ChristopherLuey/315-MechanicalDesign/315 Project/315 Final Report.docx

# ME 315

THEORY OF MACHINES - DESIGN OF ELEMENTS

Fall 2023

Design Project

Group Submission

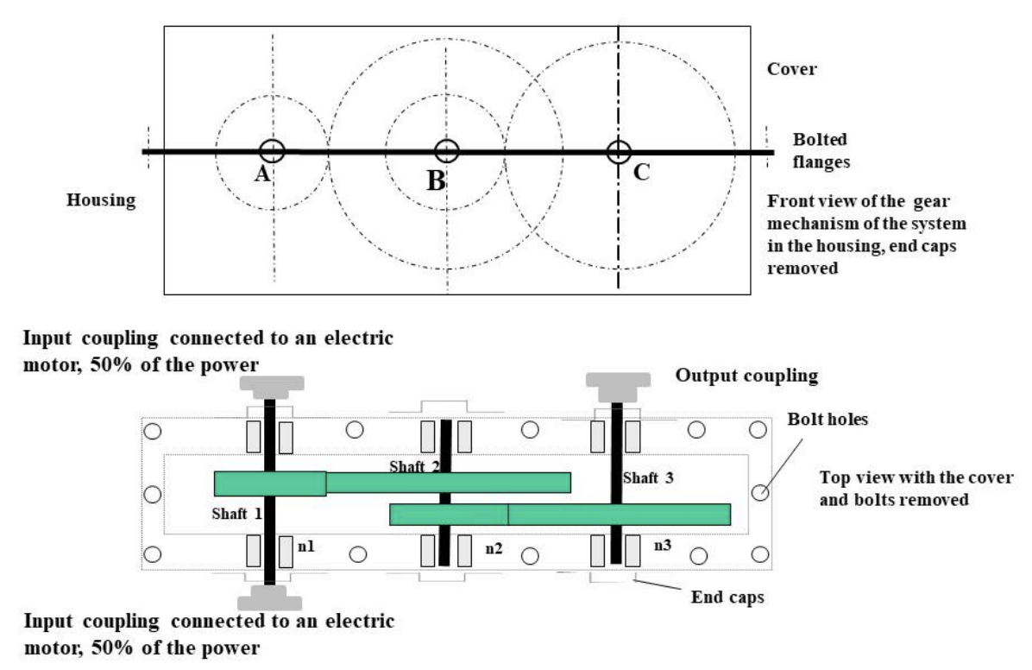
[picture p1: figure]

Group members

Chirag Bachani Shaft system 1

Winston Zhao Shaft system 2

Christopher Luey Shaft system 3

Grade

On-time step dues /5

Structural design, drawings /40

Design analysis /35

Report writing /20

Total __________

# Final Project

Christopher Luey, Winston Zhao, Chirag Bachani

Introduction 4

Gear Train 4

Gears 5

Shafts 6

Bearings 7

Assembly Drawings 8

Shaft 1 8

Shaft 2 9

Shaft 3 10

Shaft Drawings 11

Shaft 1 11

Shaft 2 12

Shaft 3 13

Gear Drawings 14

Gear 1 14

Gear 2 15

Gear 3 16

Gear 4 17

Shaft One Analysis 18

Gearing 18

Force Analysis 20

Maximum Shear, Bending 21

Shaft Stress Analysis 21

Minimum Shaft Diameter 21

Infinite Life at Critical Cross Section 22

Yielding 23

Gear Stress Analysis 23

Bending 23

Contact 24

Factors of Safety for Bending and Contact 25

Bearing Selection 26

Expected Lifetime of Bearing 26

Keyways and Tolerances 27

Shaft Two Analysis 30

Gearing 30

Free Body Diagram 32

Force Analysis 34

Shear and Bending 34

Shaft Fatigue Analysis 34

Gear Stress Analysis 37

Material 37

Allowable Contact Stress 37

Allowable Bending Stress 39

Design Bending Stress 39

Bearing Selection 41

Expected Lifetime of Bearing 41

Keyways and Tolerances 43

Shaft Three Analysis 44

Gearing 44

Geometry 45

Force Analysis 46

Maximum Shear, Bending 47

Shaft Stress Analysis 48

Minimum Shaft Diameter 48

Infinite Life at Critical Cross Section 48

Yielding 49

Gear Stress Analysis 50

Bending 50

Contact 51

Factors of Safety for Bending and Contact 52

Bearing Selection 53

Expected Lifetime of Bearing 53

Keyways and Tolerances 54

# Introduction

In our team's engineering project, we designed a robust two-stage gear transmission system depicted in the accompanying figure, aiming to efficiently transmit power from input shaft A to output shaft C with a speed reduction. The system, comprising input shaft A driven by two electric motors, center shaft B with corresponding gears, and output shaft C with a coupling set, was carefully arranged, considering the spatial relationship between A and C. Operating at 2600 rpm, the input motors delivered 70KW to shaft A, with the goal of achieving an output speed (n3) of around 400 ±3 rpm, assuming 100% overall efficiency. Our design incorporated fatigue stress concentration factors to address bending and torsional stresses, and determined geometry using a factor of safety of n=1.1. With a commitment to durability, the transmission system is expected to function continuously for at least 5 years, 7 days a week, 52 weeks a year, and 8 hours a day, with a reliability rate of 99%.

# Gear Train

Part | Gear 1 | Gear 2 | Gear 3 | Gear 4
N [teeth] | 19 | 47 | 27 | 71
RPM [rev/min] | 2600.000 | 1051.064 | 1051.064 | 399.700
Power [kW] | 70.0 | 70.0 | 70.0 | 70.0

Gear Train Result
Ratio | 6.5049
Output Speed (RPM) | 399.7003
% Error | -0.0749%

# Gears

Gear Properties
Material | AISI 1045 Steel
Module [mm] | 5.00
Pitch Angle [Deg] | 20.00
Addendum [mm] | 5.00
Dedendum [mm] | 6.25
Clearance [mm] | 1.25
Tooth Depth [mm] | 11.25

| Gear 1 | Gear 2 | Gear 3 | Gear 4
Material Grade | 2 | 1 | 2 | 1
Hardness [HB] | 500 | 400 | 500 | 400
Pitch Diameter [mm] | 95.0 | 235.0 | 135.0 | 355.0
Outer Circle [mm] | 105.0 | 245.0 | 145.0 | 365.0
Root Circle [mm] | 83.0 | 223.0 | 123.0 | 343.0
Face Width [mm] | 65.0 | 60.0 | 65.0 | 60.0
Centerline Distance [mm] | 165.0 | | 245.0
Bending Factor of Safety | 4.1069 | 3.0405 | 2.7465 | 2.0373
Contact Stress Factor of Safety | 1.4576 | 1.1201 | 1.4859 | 1.1462

# Shafts

| Shaft 1 | Shaft 2 | Shaft 3
Material | AISI 1045 Carbon Steel
RPM [rev/min] | 2600.0000 | 1051.0638 | 399.7003
Max Bending Magnitude [Nm] | 205.7115 | 451.2470 | 343.7668
Max Torque [Nm] | 257.096 | 635.975 | 1672.380
Minimum Shaft Diameter [mm] | 17.000 | No pure torque | 40.000
Critical Cross Section Location | Gear 1 Center | Gear 3 Center | Gear 4 Center
Shaft Diameter at Critical Cross Section [mm] | 45.000 | 60.000 | 55.000
Goodman Factor of Safety | 1.8467 | 1.8236 | 1.6866
Yielding Factor of Safety | 7.3976 | 7.3851 | 6.3999
Lifetime | Infinite (> 10^6 Cycles)

# Bearings

| Shaft 1 | | Shaft 2 | | Shaft 3
As shown in Assembly Drawing | Left | Right | Left | Right | Left | Right
Radial Load [N] | 1645.692 | 4114.230 | 8204.490 | 6835.208 | 6875.336 | 3151.196
Thrust Load [N] | 0 | | 0 | | 0
Equivalent Load Used in Calculation [N] | 4114.230 | | 8204.490 | | 6875.336
C [N] | 54081.734 | | 79744.149 | | 48414.597
Bearing (SKF) | 6309 | | 6312 | | 6311
Bore [mm] | 45 | | 65 | | 55
OD [mm] | 100 | | 140 | | 120
Width [mm] | 25 | | 33 | | 29
C, bearing [N] | 55300 | | 97500 | | 74100
C0, bearing [N] | 31500 | | 60000 | | 45000
Expected Life [Mil Cycles] | 2428.3404 | | 1678.2594 | | 1251.9091
Expected Life [Yrs] | 5.3455 | | 9.1288 | | 17.9265

# Assembly Drawings

## Shaft 1

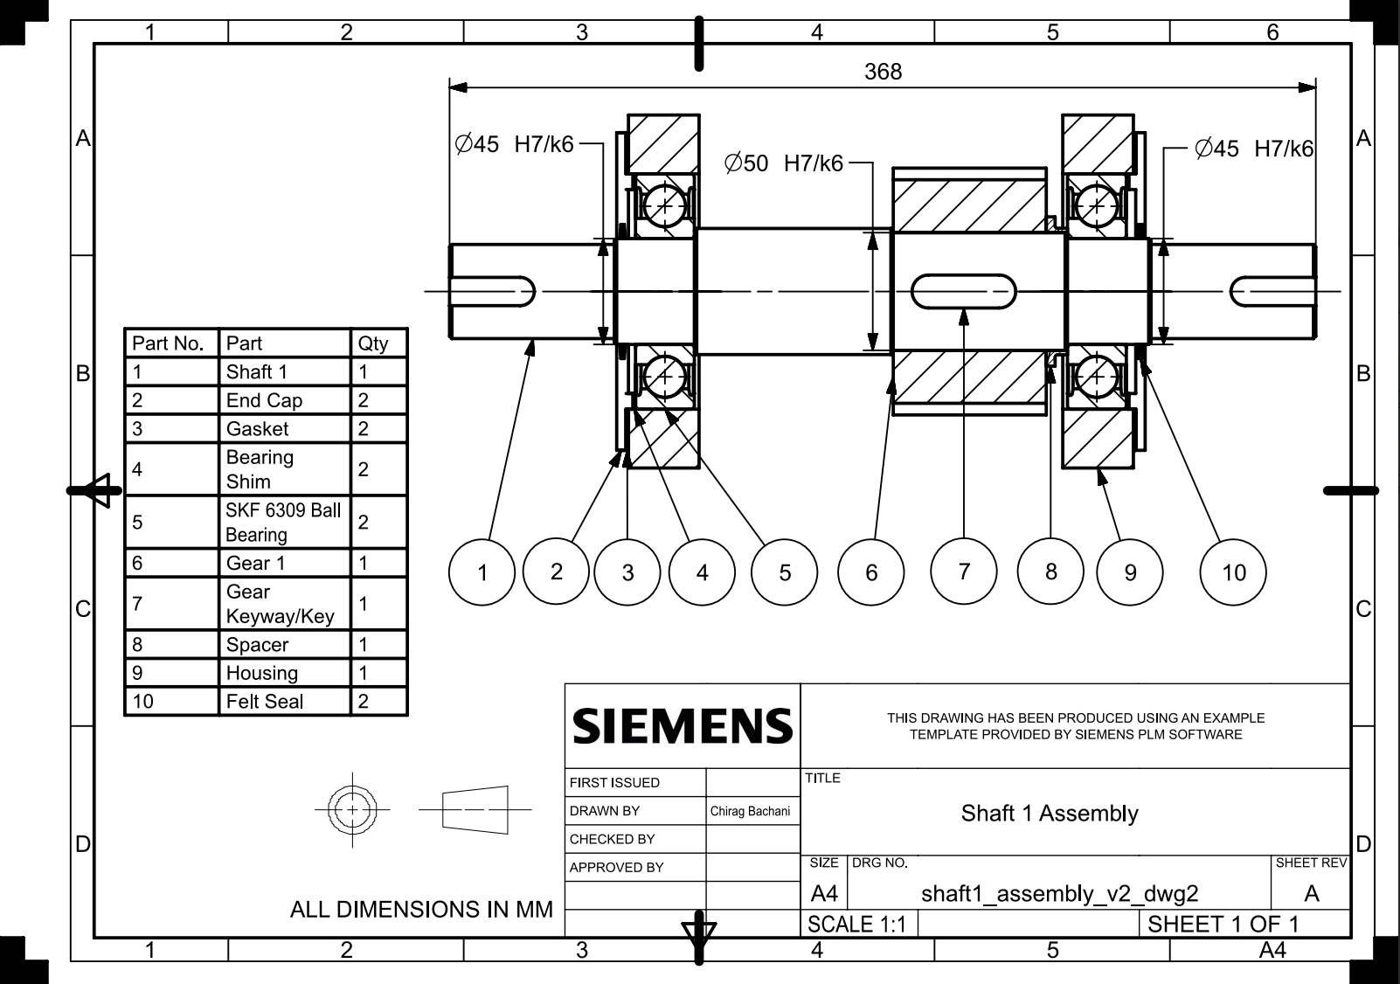
[picture p2: figure]

## Shaft 2

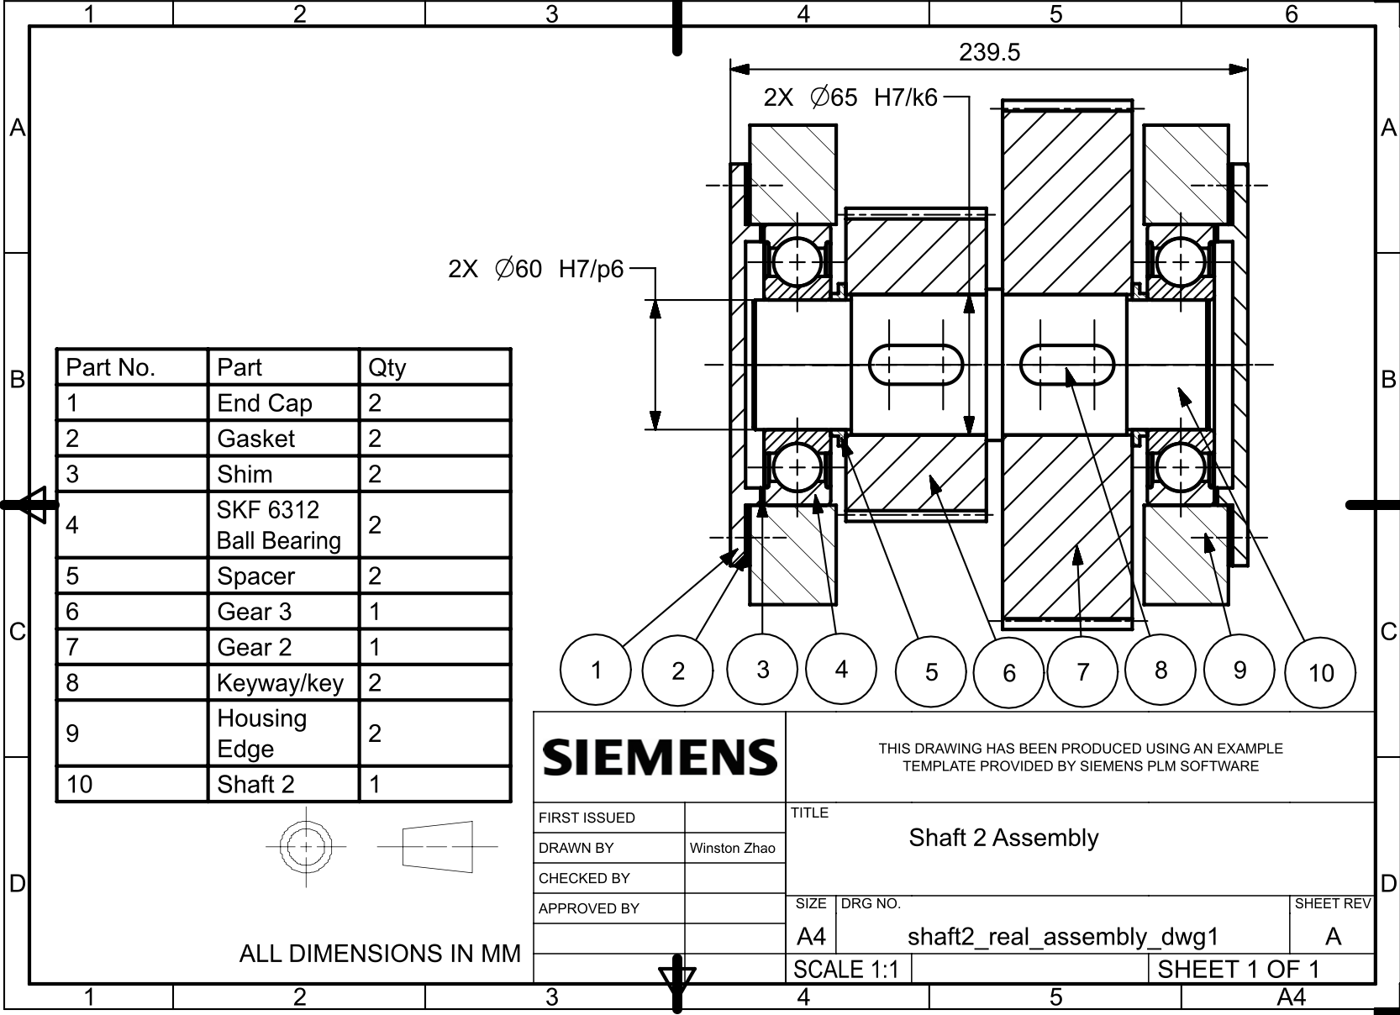
[picture p3: figure]

## Shaft 3

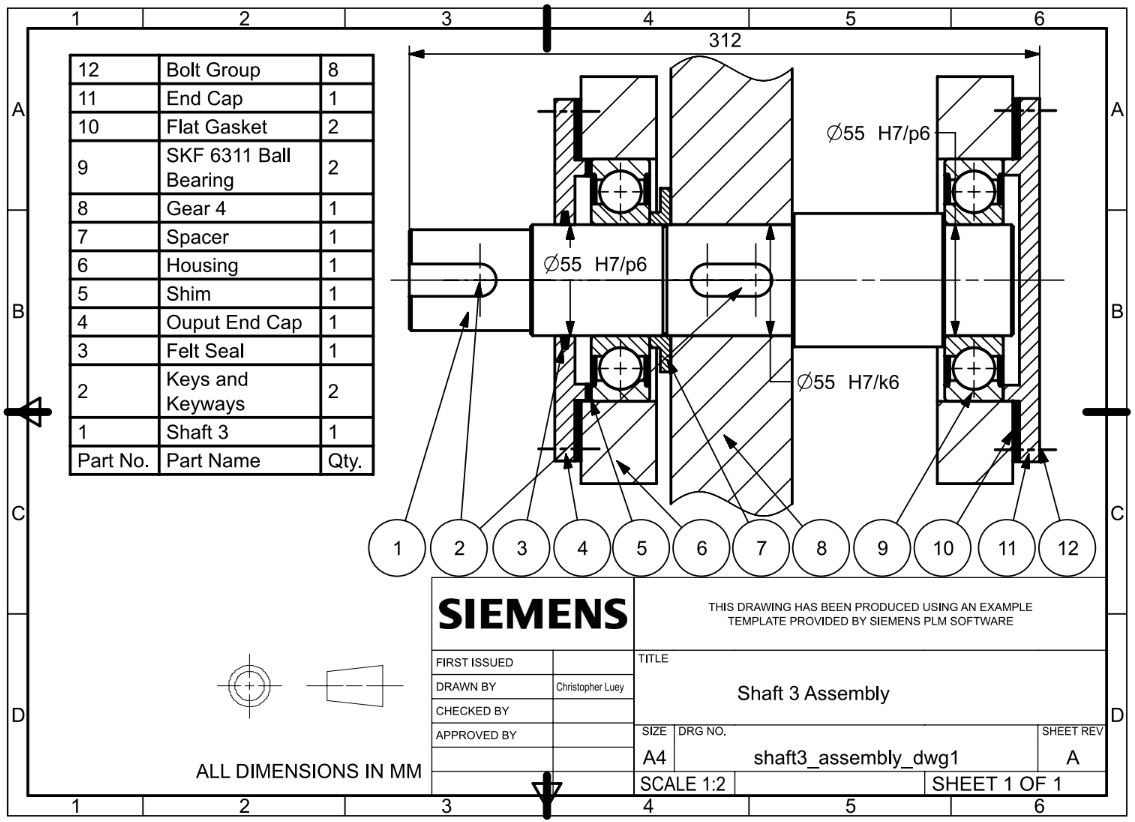
[picture p4: figure]

# Shaft Drawings

## Shaft 1

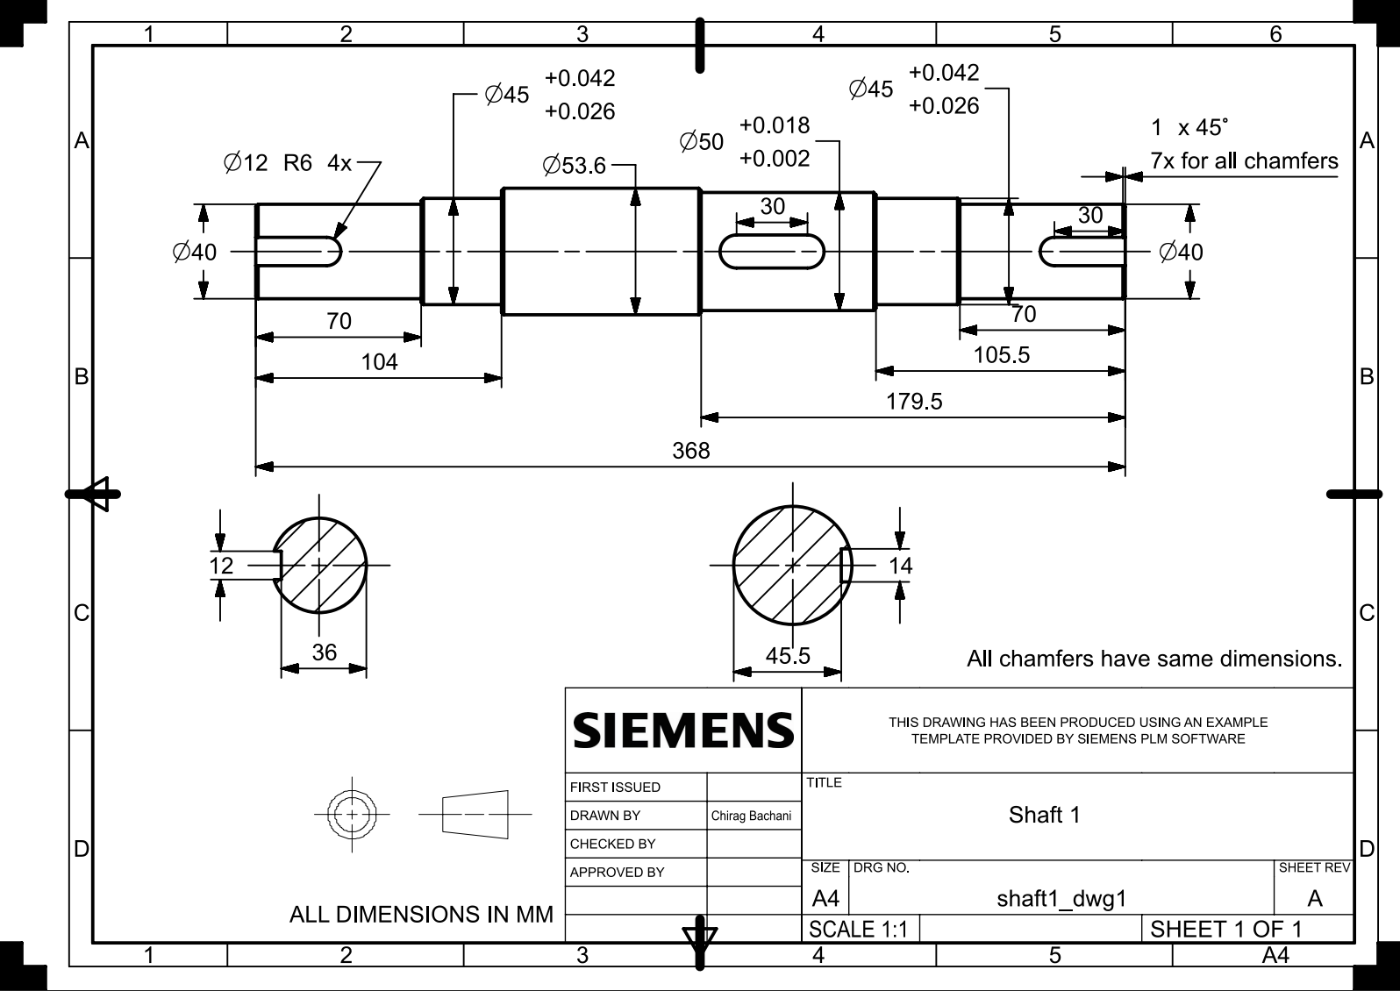
[picture p5: figure]

## Shaft 2

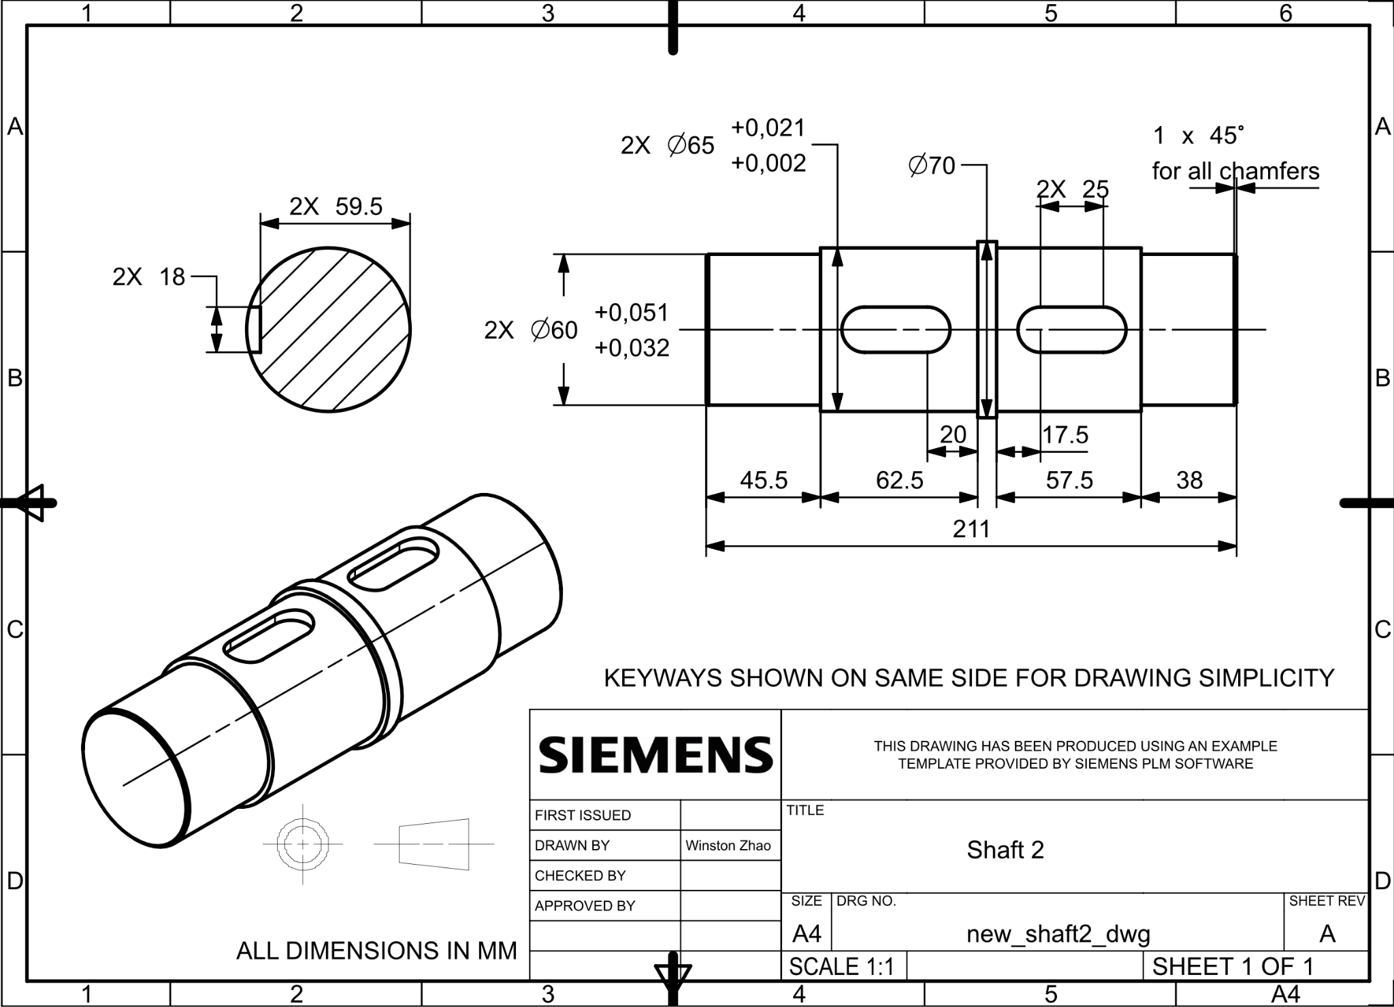
[picture p6: figure]

## Shaft 3

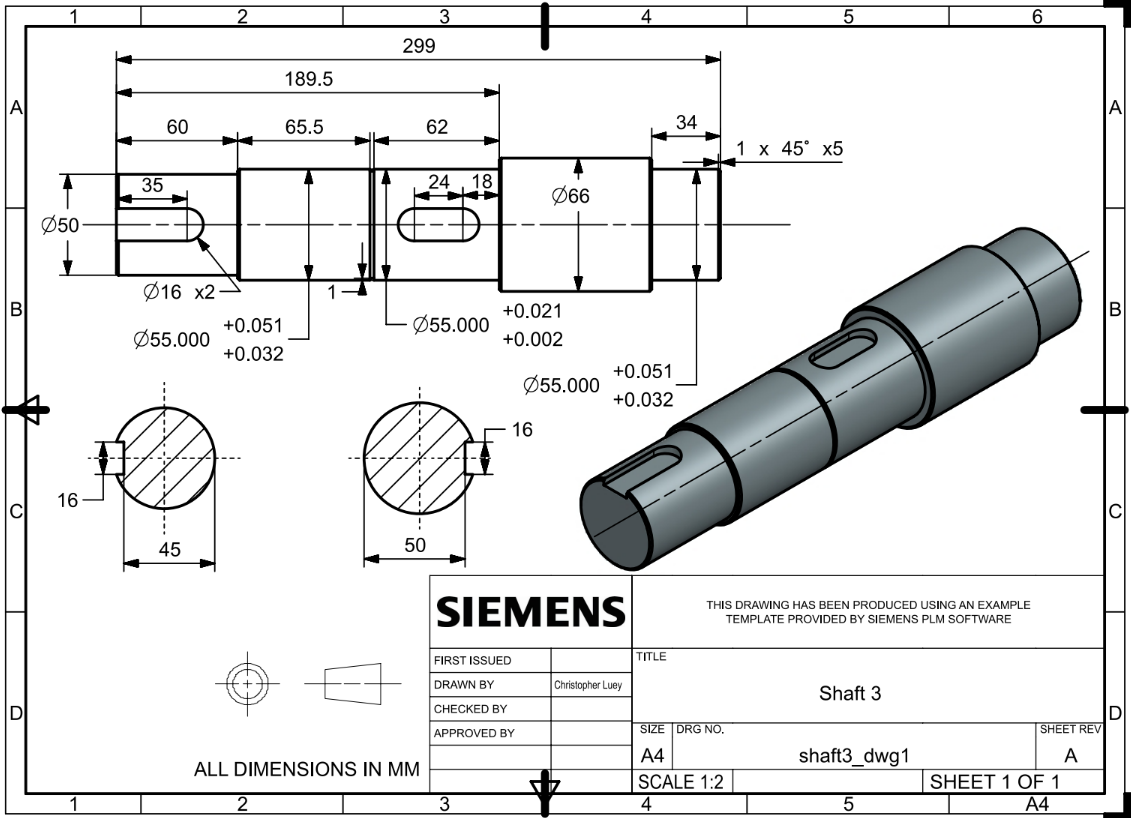
[picture p7: figure]

# Gear Drawings

## Gear 1

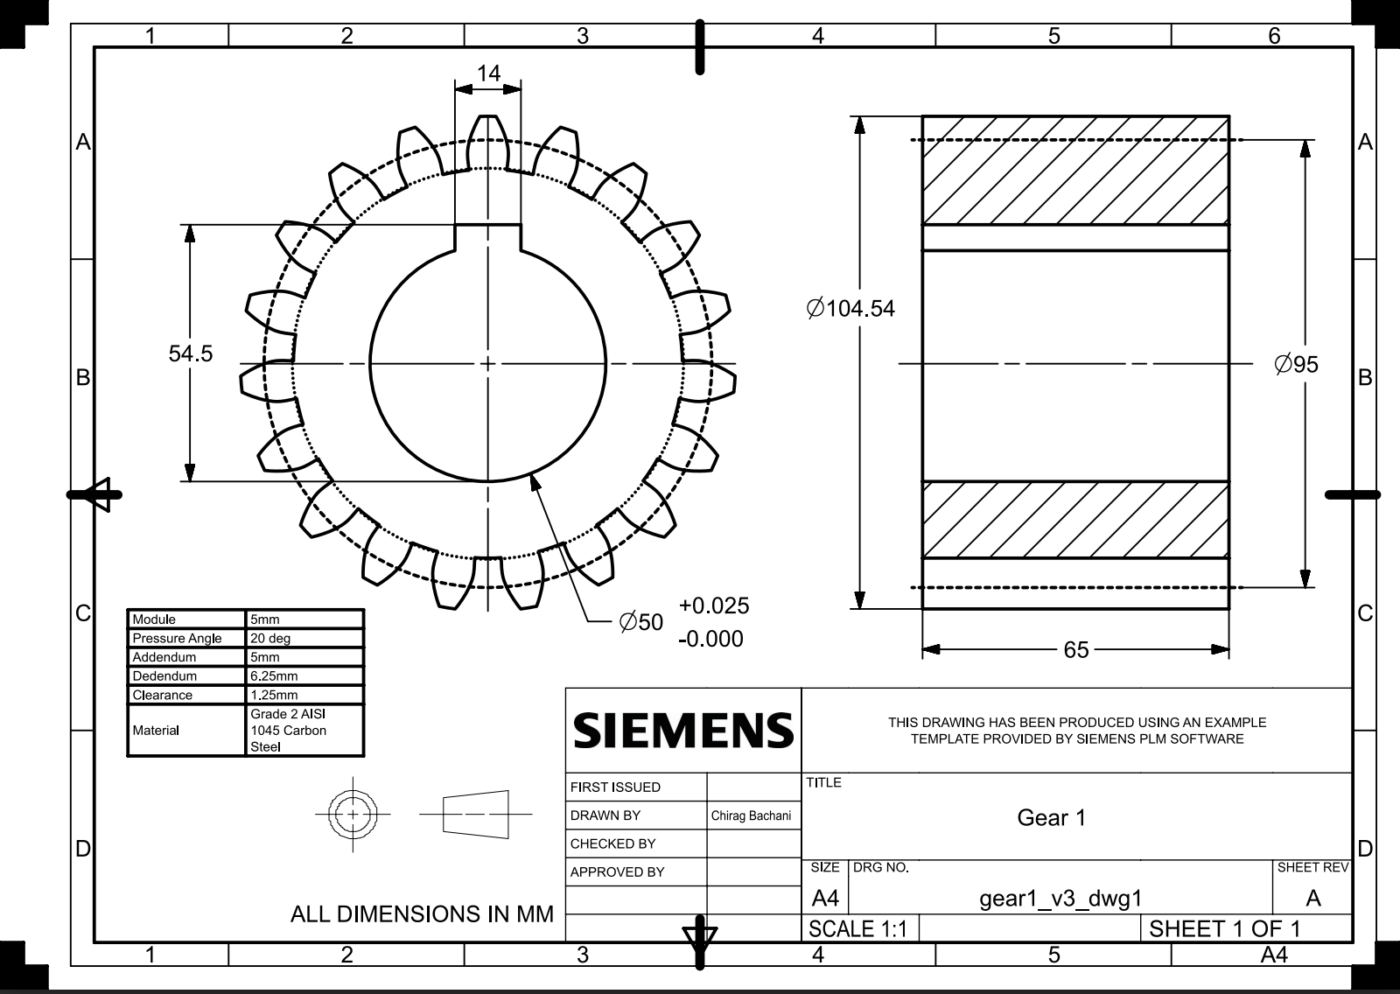
[picture p8: figure]

## Gear 2

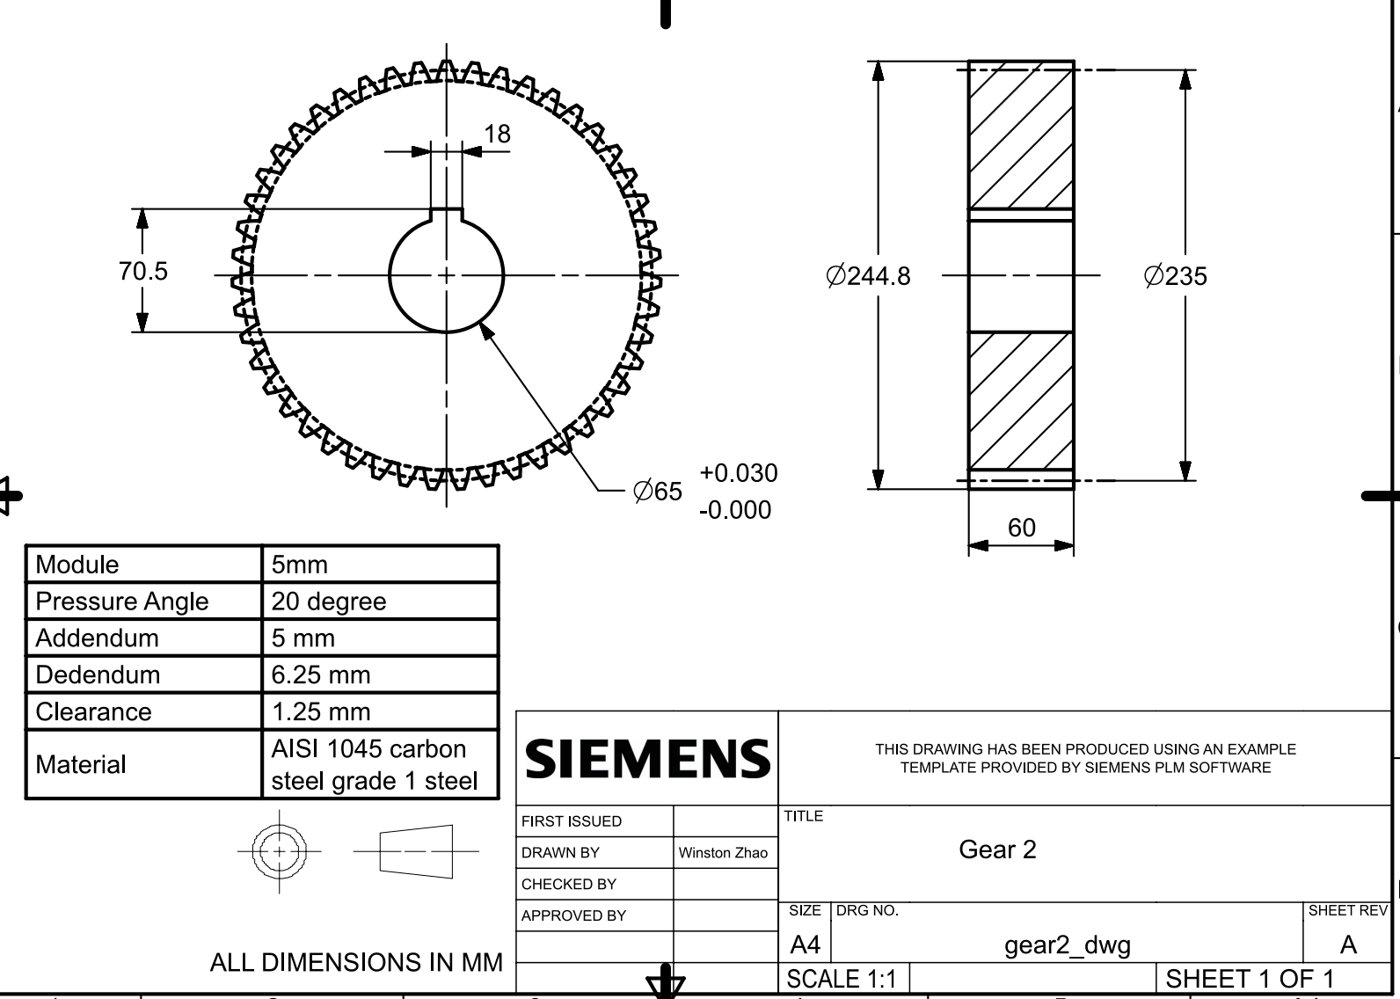
[picture p9: figure]

## Gear 3

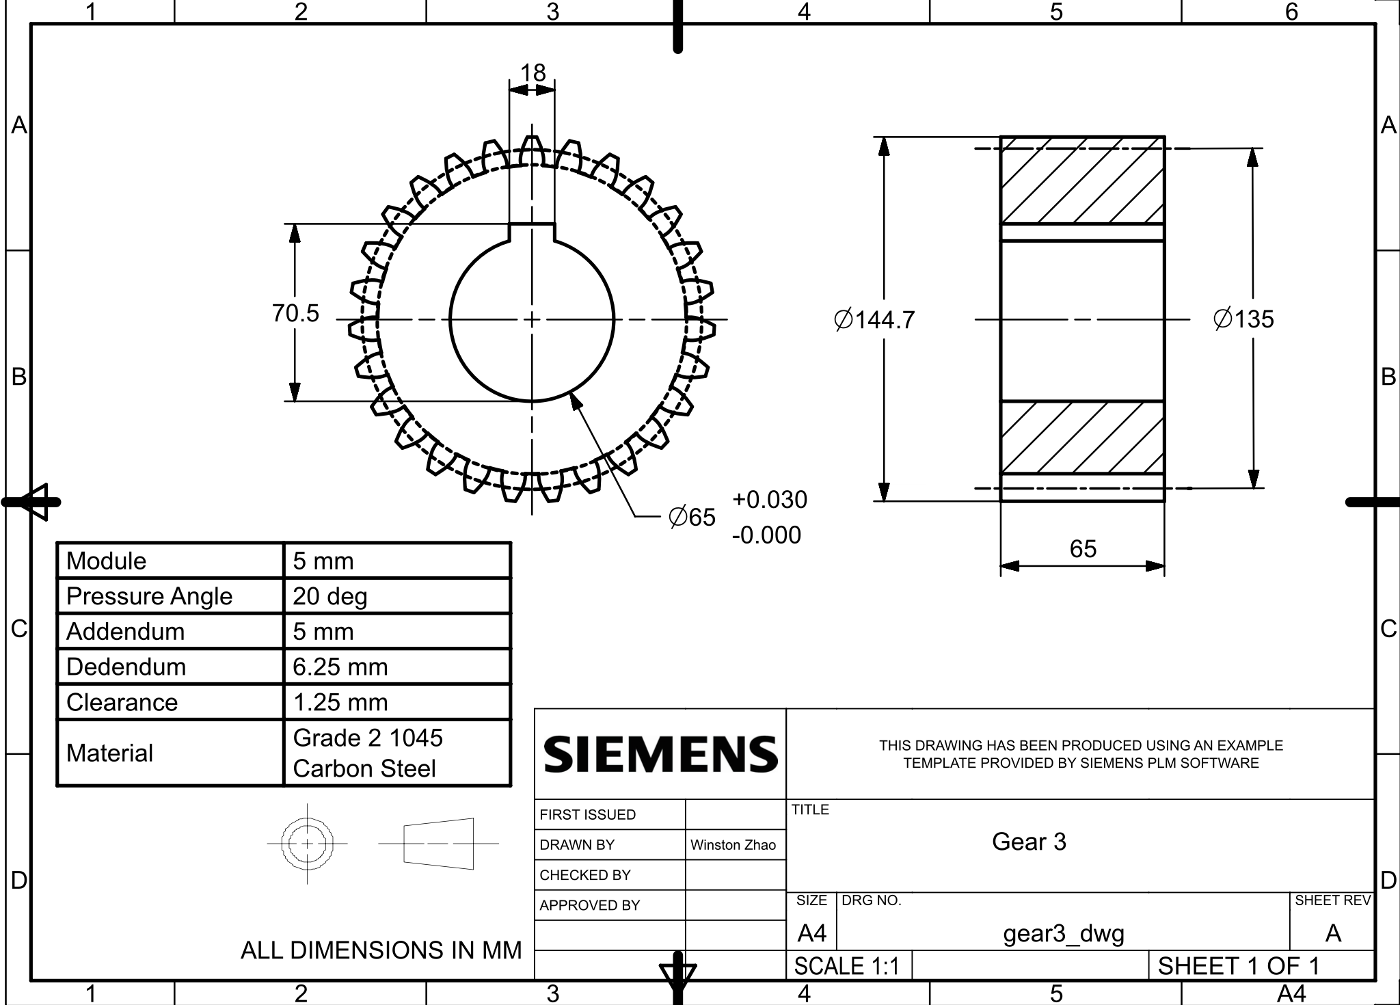
[picture p10: figure]

## Gear 4

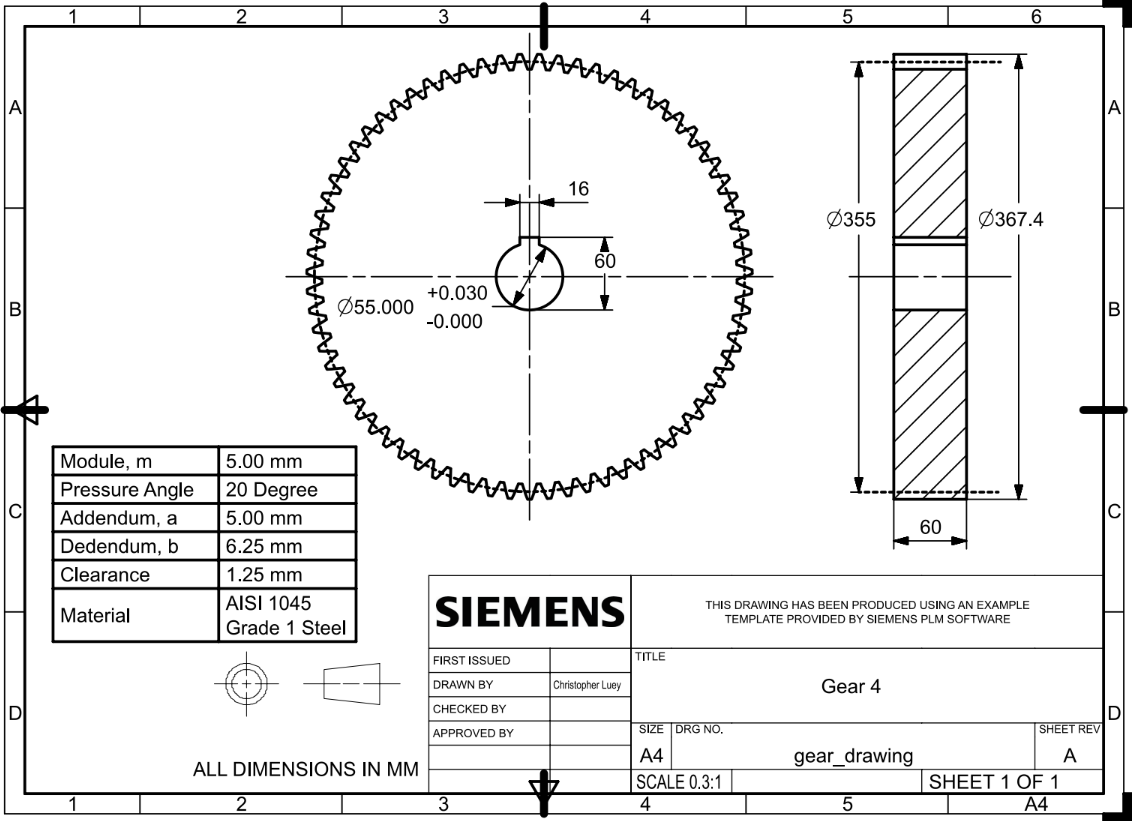
[picture p11: figure]

# Shaft One Analysis

## Gearing

Given: n1 = 2600 rpm, H = 70000 W, n3 (ideal) = 400, n1/n3 (ideal) = 6.5

Choose gear teeth (odd number, indivisible):

N1 = 19

N2 = 47

N3 = 27

N4 = 71

Choose standard module and pitch angle for off the shelf ordering:

m = a = 0.005 [m]

b = 1.25m = 0.00625 [m]

ϕ = 20 degree

Calculate transmission ratio:

n1/n3 = N4*N2/(N1*N3) = 6.5049

n3 = 2600/(n1/n3) = 399.7003 rpm

% error = |(n3-400)/400| = -0.0749%

Gear 1:

Geometry

N1 = 19

Pitch Diameter: d_p =N_1 m=0.0950 [m]

Pitch Radius: r_p =d_p /2=0.0480 [m]

Face Width: b_w =12m=0.0650 [m]

Forces

Note: Forces acting from Gear 1 to Gear 2 are the same as from Gear 2 to Gear 1

Torque: T=(60H)/(2πn_1)=257.096 Nm

Gear Forces:

W_(T12) =T/r_p =5412.557 N

W_12 =W_(T12) /cos(ϕ)=5759.923 N

W_(r12) =W_12 sin(ϕ)=1970.010 N

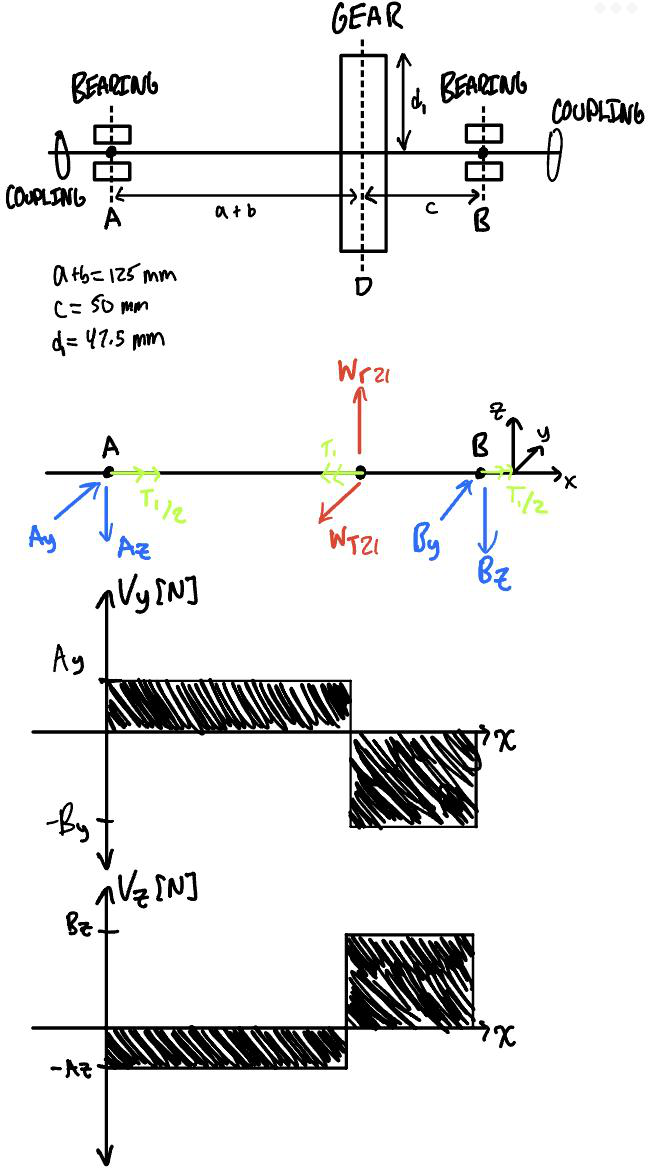
[picture p12: figure]
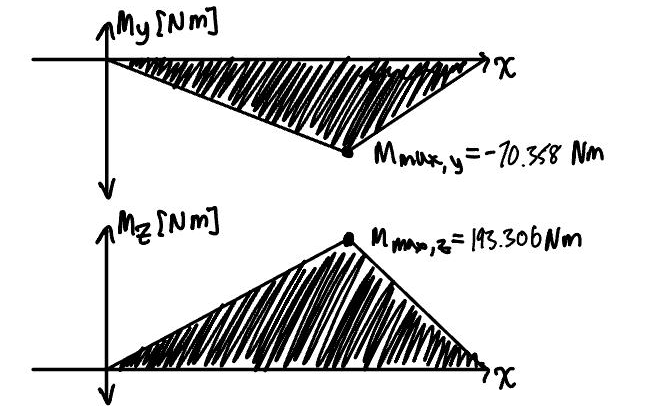
[picture p13: figure]

Note: Torque occurs in the same direction on both sides of the shaft, coming from the coupling.

## Force Analysis

From the gearing section the following are solved:

W_(T12) =5412.557 N

W_(r12) =1970.010 N

From geometry we know the following:

a=55 mm; b+c =120 mm

d/2=177.5 mm

Derived from static equilibrium, solve this system of equations:

0=A_y +B_y -W_(t12)

0=A_z +B_z -W_(r12)

0=W_(t12) (a)-B_y (a+b+c)

0=W_(r12) (a)-B_z (a+b+c)

System of equations yields the following reactions with force directions as drawn:

Ay = 1546.4448 N

Az = 562.8599 N

By = 3866.1120 N

Bz = 1407.1497 N

A=√(A_y ^2 +A_z ^2)=1645.6922 N

B=√(B_y ^2 +B_z ^2)=4114.2304 N

## Maximum Shear, Bending

Maximum bending occurs at cross section C:

M_y =A_y a=70.3575 Nm

M_z =A_z a=193.3056 Nm

M=√(M_y ^2 +M_z ^2)=205.7115 Nm

The shear magnitude at cross section C is:

Vy = Ay = 1546.4448 N

Vz = Az = 562.8599 N

V=√(V_y ^2 +V_z ^2)=1645.6922 N

## Shaft Stress Analysis

We first choose material:

Material | E (Pa) | UTS (MPa) | Poisson Ratio | Ys (MPa)
AISI 1045 Steel (https://www.azom.com/article.aspx?ArticleID=6114) | 200000.0000 | 394.7200 | 0.2900 | 294.7400

### Minimum Shaft Diameter

Our factor of safety is n=1.1

Calculate the torque magnitude at the coupling:

T=W_(t12) d/2=257.096 Nm

Calculate the minimum shaft diameter:

τ_(all) =0.557(Y_s )/n=156.9727 MPa

d_(min) =³√((16T/2)/(πτ_(all)))=16.0967 mm

Consider keyway effect, round 5% increase:

d_(min) '=Round[d_(min) (1.05)]=17 mm

### Infinite Life at Critical Cross Section

Choose a shaft diameter of d = 45 mm at cross section C.

Solve for max bending torsion, and shear stresses at cross-section C experienced by point on the surface:

σ_(bs) =(32M)/(πd^3)=22.9944 MPa

τ_T =(16T)/(πd^3)=14.3691 MPa

τ_V =(16V)/(3πd^2)=3.4492 MPa

Given these stresses, calculate the mean and amplitude stresses for cyclic loading:

σ_a =σ_(bs) =22.9944 MPa

σ_m =0 MPa

τ_m =(τ_T)/2=7.1845 MPa [The shaft turns on and off]

τ_a =(τ_T)/2+τ_V =10.6337 MPa

This is a conservative estimate, since we use the shear and bending stress maximum amplitudes in calculating stress states, although these maximums are out of phase. Furthermore, we do not ignore shear (which is 30% of the mean shear).

Calculate Von-Mises given Kf = 3.000 and Kfs = 2.800

σ_(vm-a) =√((K_f σ_a )^2 +3(K_(fs) τ_a )^2)=86.1289 MPa

σ_(vm-m) =√((σ_m )^2 +3(τ_a )^2)=12.4440 MPa

Calculate Infinite Criteria given chosen material:

k_f =1.58*S_(ut) ^(-0.085) =0.9220 [Grinding]

k_s =1.189*d^(-0.112) =0.7763 [Size Factor]

k_r =0.82 [99% Reliability]

k_t =k_m =1.000

S_e '=0.5(UTS)=282.500 MPa

n_s =[(σ_(vm-a))/(k_f k_s k_r k_t k_m S_e ')+(σ_(vm-m))/(S_(ut))]^(-1) =1.8467 >1.1 [Chosen shaft diameter at C is safe]

### Yielding

n_y =[(σ_(vm-a))/(S_y)+(σ_(vm-m))/(S_y)]^(-1) =7.3976> 1.1 [Chosen shaft diameter does not pass yield line]

## Gear Stress Analysis

Choose material for gear:

Gear Materia | hardness | E (MPa) | Poisson Ratio
AISI 1045 Carbon Steel | 400.0000 | 200000.0000 | 0.2850

### Bending

Calculate number of shaft cycles:

t=5 year*52 (week)/(year)*7 (day)/(week) * 8 (hr)/(day) * 60 (min)/(hr)=873600 min

Rotation speed n1= 2600 RPM.

N=t*n_1 =2271360000 Cycles

Calculate allowable bending stress:

Y_n =1.683(N)^(-0.0323) =0.8392

S_b =0.533(HB)+88.3=464.5000MPa

k_t =k_r =1.000

σ_(b, all) =(S_b Y_n)/(k_t k_r)=389.8179 MPa

Calculate actual bending stress:

Y_j =0.350 [From Class Plot]

k_a =1.000

k_s =1.000 [module = 5 mm]

k_m =1.100 [Gear]

k_i =1.000 [Non Idler]

k_b =1.000

Calculate Kv:

V=πnd/60=12.9329 [m/s]

Q_v =6 for commercial gears

B=((12-Q_v )^(2/3))/4=0.8255

A=50+56(1-B)=59.7730

K_v =((A+√(200V))/A)^B =1.6623

σ_(b, actual) =(W^t)/(mb_w Y_j)k_a k_s k_m k_v k_i k_b =94.9170 MPa

Comparing the allowable to the actual bending stress:

n_b =σ_(all) /σ_b =4.1069>1.1

The design is sufficient for bending stress since nb > n = 1.1

### Contact

Calculate allowable contact stress:

HB_(pinion) =500 (HB)

HB_(gear) =400 (HB)

Z_N =2.466N^(-0.056) = 0.7380

(HB_p)/(HB_g)=1.25

A' = (8.89*10^(-3) )((HB_p)/(HB_g))-8.29*10^(-3) since 1.2≤(HB_p)/(HB_g)=1.25≤1.7

(N_g)/(N_p)=2.6296

C_H =1.0+A'((N_g)/(N_p)-1.0)=1.0042

K_T =1

K_R =1

S_c =2.22*HB_g +200=1437 MPa

σ_(c, all) =(S_(c_) Z_N C_(Hg))/(K_T K_R)=1060.4686 MPa

Calculate actual contact stress:

K_a =1 [No shock]

K_s =1

K_E =√(2/((1-v_p^2)/(E_p)+(1-v_g^2)/(E_g)))=466563.1271 [√(Pa)]

K_(m, gear) =1.1

K_v =1.6623 [From bending calculation]

ϕ=20 deg; d_p =0.095 m; d_g =0.235 m

I=(πcos(ϕ)sin(ϕ))/(1+(d_p)/(d_g))=0.7190

σ_(c,actual) =K_E √((W^t)/(b_w d_p I)K_a K_s K_m K_v)=727.5603 MPa

### Factors of Safety for Bending and Contact

σ_(c,actual) =727.5603 MPa

σ_(c, all) =1060.4686 MPa

σ_(b, actual) =94.9170 MPa

σ_(b, all) =389.8179 MPa

n_c =(σ_(c, all))/(σ_(c,actual))=1.4576>1.1 [Safe for contact stress]

n_b =(σ_(b, all))/(σ_(b,actual))=4.1069>1.1 [Safe for bending stress]

## Bearing Selection

h=(5 year)(364 (day)/(year))(8(hr)/(day))=14560 hr [life hours]

n3 = 2600 RPM [rotation speed]

L_10 =60(h)(n_3 )(10^(-6) )=2271.3600 Million Revs

A_P =1.000 [No Shock]

m=3 [Ball Bearing]

P_r =Max(A,B)=4114.2304 N [A and B calculated in Force Analysis section]

X=1.000

P=P_r X=4114.2304 N [No Axial Force]

C=PL_10 ^(1/m) =54081.7335 N

Given the calculated C, I specify the following bearing from SKF:

Reference: https://www.skf.com/us/products/rolling-bearings/ball-bearings/deep-groove-ball-bearings/productid-6309

This bearing is safe because the bearing specification C is less than our calculated C. Recalculation is not necessary since there is no thrust force and radial factor X is constant, not a function of e or C0.

### Expected Lifetime of Bearing

L=(C/P)^m =2428.3404 mil rev [using C=55300 N from SKF]

Life=L(10^6 )(n_1 )^(-1) (60(min)/(hr))^(-1) (8(hr)/(day))^(-1) (7(day)/(week))^(-1) (52(week)/(yr))^(-1) =5.3455 yr

Bearing does not require maintenance for intended operation of 5 years.

## Keyways and Tolerances

Coupling Keyway (40 mm) and Gear Keyway (50 mm):

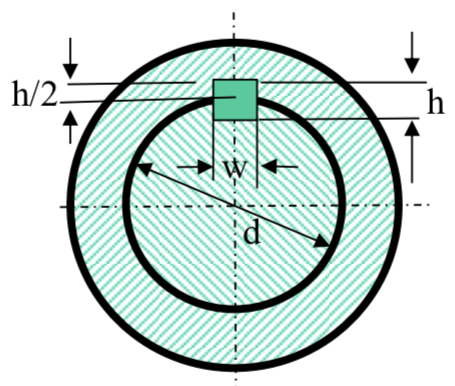
[picture p14: figure]

Shaft diameter d (mm) | Key width W x height H
38 < d <= 44 | 12 x 8
44 < d <= 50 | 14 x 9

Fits:

Bearing and Shaft: Interference fit (H7/p6), bearing should be tightly fit with shaft for fluid rotation.

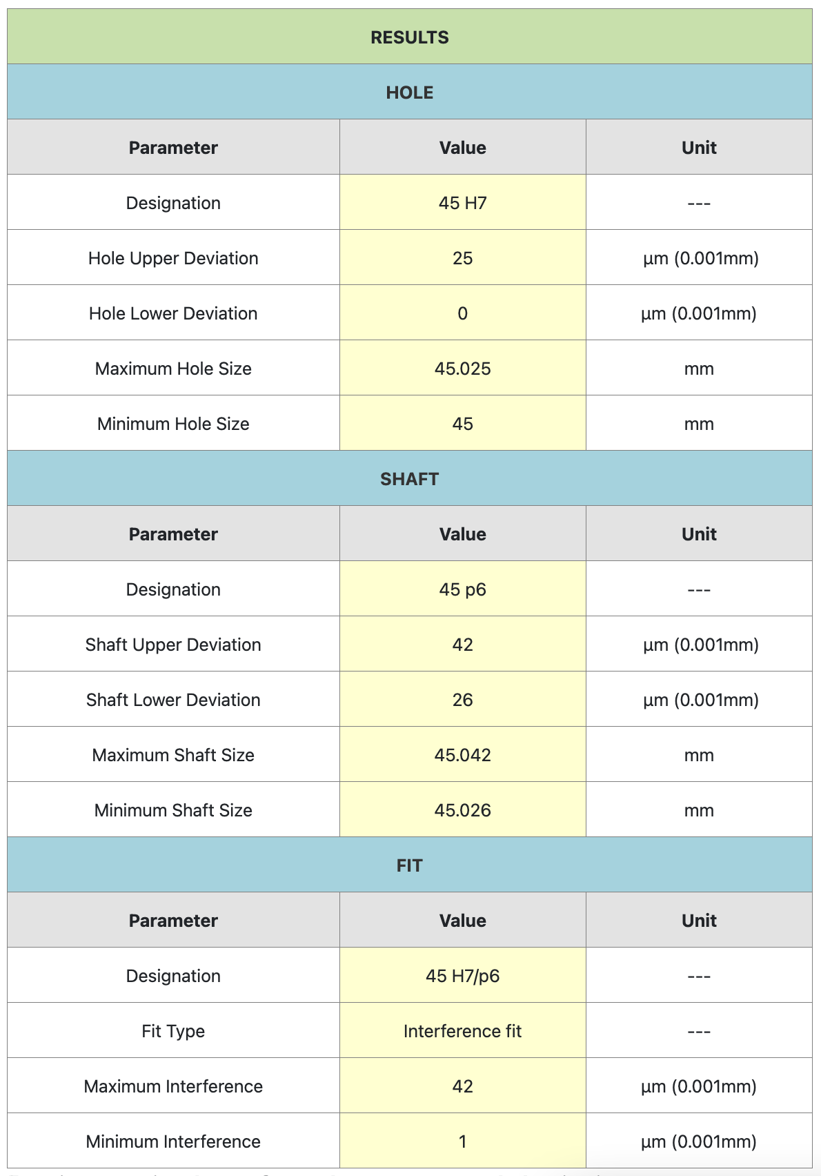
[picture p15: figure]

Gear and Shaft: Transition fit (H7/k6), shaft rotation will be transmitted from gear torque through interlocked key.

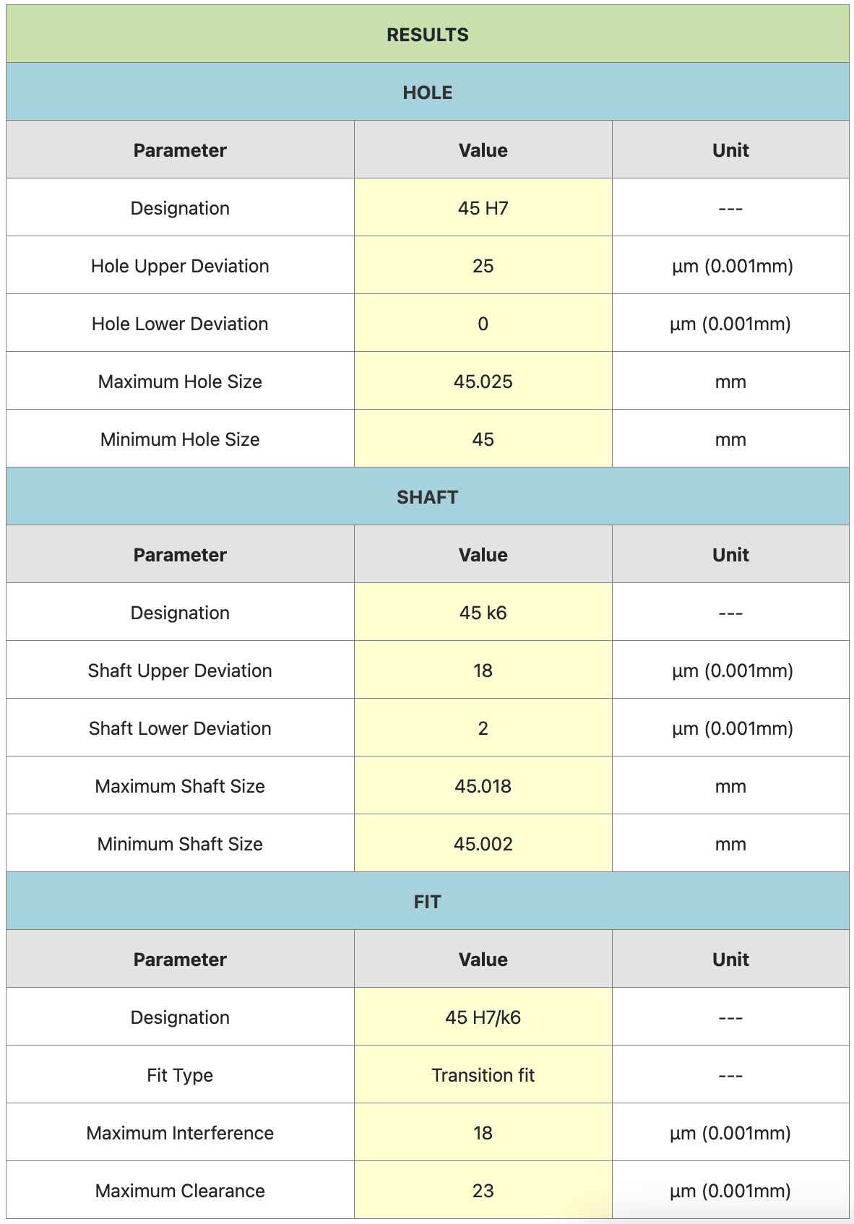
[picture p16: figure]

Source: https://amesweb.info/fits-tolerances/tolerance-calculator.aspx

# Shaft Two Analysis

## Gearing

Given: n1 = 2600 rpm, n3 = 400 rpm ideal, n1/n3 = 6.5 ideal

N1 = 19

N2 = 47

N3 = 27

N4 = 71

m = 0.005 m

Phi = 20 degree

Power H = 70000 W

n1/n3 = N4*N2/(N1*N3) = 6.5049

n3 = 2600/(n1/n3) = 399.7003 rpm

% error = (n3-400)/400 = -0.0749%

Gear 2:

Geometry

N2 = 47

Pitch Diameter: dp = N*m = 0.235 m

Pitch Radius: rp = dp/2 = 0.1175 m

Outer Diameter: do = dp + 2*m = 0.245 m

Root Diameter: dr = dp - 2*1.25*m = 0.223 m

Face Width: bw = 12*m = 0.06 m

Forces

Torque: T2 = 60*H/(2*pi*n2) = 635.975Nm

Wt23 = T2/rp = 5412.557 N

W23 = Wt23/cos(phi) = 1970.01 N

Wr23 = W23*sin(phi) = 5759.923 N

Gear 3:

Geometry

N3 = 27

Pitch Diameter: dp = N*m = 0.125 m

Pitch Radius: rp = dp/2 = 0.0675 m

Outer Diameter: do = dp + 2*m = 0.145 m

Root Diameter: dr = dp - 2*1.25*m = 0.123 m

Face Width: bw = 13*m = 0.065 m; Pinion has larger bw than gear

Forces

Torque: T3 = T2 = 60*H/(2*pi*n3) = 635.975 Nm

Wt34 = T3/rp = 9421.858 N

W34 = Wt34/cos(phi) = 10026.532 N

Wr34 = W34*sin(phi) = 3429.276 N

## Free Body Diagram

Rotation Speed: n2 = n1*N1/N2 = 1051.0638

Set shaft diameter: d2 = 0.06 m

a = 0.0550 m [bw3/2 + bearing thickness/2 + spacing]

b = 0.0700 m [bw3/2 +bw2/2 + spacing]

c = 0.0500 m [bw2/2 + bearing thickness/2 + spacing]

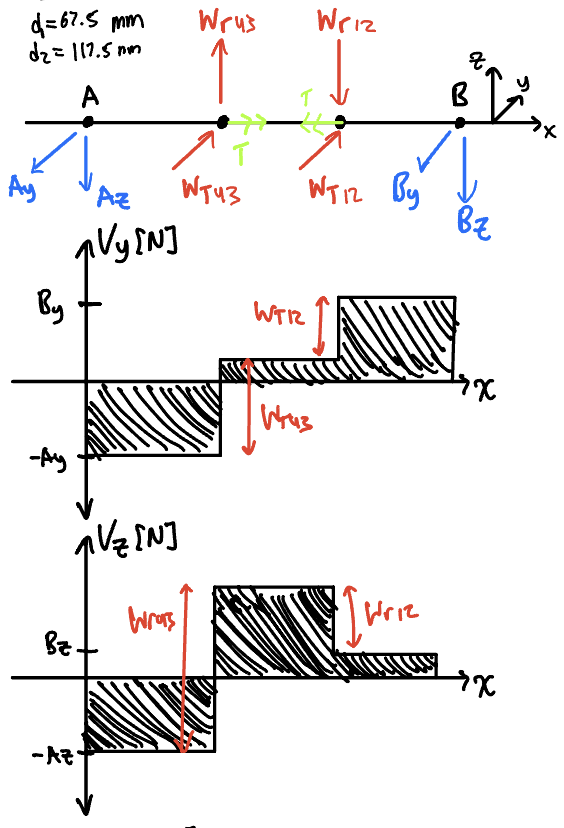
[picture p17: figure]
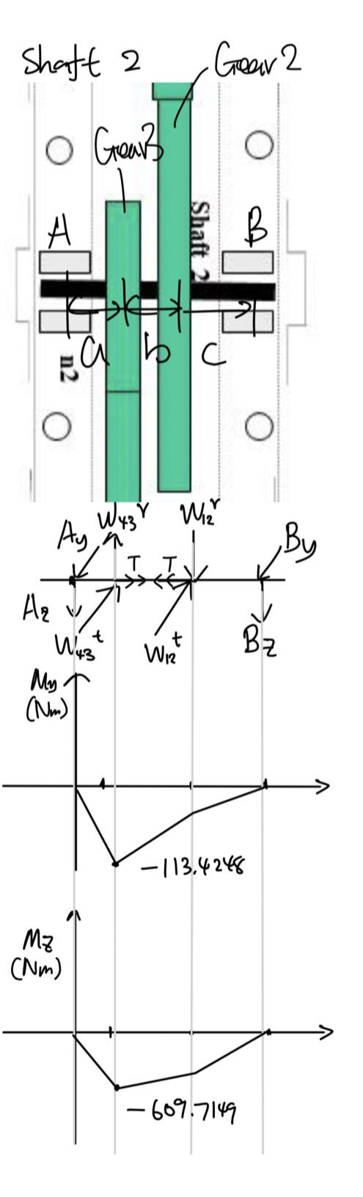
[picture p18: figure]

## Force Analysis

Shaft 2 Reaction Forces

B_y =(W_(t,43) *a+W_(t,12) *(a+b))/(a+b+c)=6827.2674 N

A_y =W_(t,43) +W_(t,12) -B_y = 8007.1475 N

B_z =(W_(r,43) *a+W_(r,12) *(a+b))/(a+b+c)= 1788.6436 N

A_z =W_(r,43) -W_(r,12) +B_z =329.3773 N

R_A =√(A_y^2 +A_y^2)=8204.4900 N

R_B =√(B_y^2 +B_y^2 =)6835.2081 N

## Shear and Bending

Maximum bending occurs at C:

Mz = Ay * a = 440.3931 Nm

My = Az * a = 98.3754 Nm

M=√(M_y^2 +M_z^2)=451.2470Nm

The shear at point C is:

Vy = Ay = 8007.1475 N

Vz = Az = 1788.6436 N

V = Sqrt(Vy^2 + Vz^2) = 6875.3362 N

### Shaft Fatigue Analysis

Solve for bending torsion, and shear stresses at Point 1 at cross-section C:

σ_(bs) =(32M)/(πd^3)=21.2795 MPa

τ_T =(16T)/(πd^3)=14.9954 MPa

τ_V =(16V)/(3πd^2)=3.8690 MPa

Given these stresses, calculate the mean and amplitude stresses for cyclic loading:

σ_a =σ_(bs) =21.2795 MPa

σ_m =0 MPa [ignore axial normal stress due to low magnitude]

τ_m =(τ_t)/2=7.4977 MPa [on/off]

τ_a =(τ_T)/2+τ_v =11.3667 MPa

Calculate Von-Mises given Kf = 3.000 and Kfs = 2.800.

Note: although max σ_(bs) and max τ_(ts) won’t coexist at the same point mechanically, we take both magnitudes into account for a conservative design on calculating the factor of safety for our shafts.

σ_(vm-a) =√((K_f σ_a )^2 +3(K_(fs) τ_a )^2)=91.2798 MPa

σ_(vm-m) =√((σ_m )^2 +3(τ_m )^2)=16.8598 MPa

Calculate Infinite Criteria given chosen shaft material:

Material | E | UTS | Poisson Ratio | Ys
AISI 1045 Steel (https://www.azom.com/article.aspx?ArticleID=6114) | 200000.0000 | 394.7200 | 0.2900 | 294.7400

k_f =1.58*S_(ut) ^(-0.085) =0.9220 [Grinding]

k_s =1.189*d^(-0.112) =0.7517 [Size Factor]

k_r =0.82 [99% Reliability]

k_t =k_m =1.000 [ignore temperature and miscellaneous factors]

S_e '=0.5(UTS)=282.500 MPa

Goodman

n_s =[(σ_(vm-a))/(k_f k_s k_r k_t k_m S_e ')+(σ_(vm-m))/(S_(ut))]^(-1) =1.8236 > 1.1 [The shaft design is safe]

Yield

n_y =(σ_(vm-max))/(Sy) =7.3851

## Gear Stress Analysis

### Material

Gear Material | | hardness | E (MPa) | Poisson Ratio | Type
Gear 3 | AISI 1045 Carbon Steel | 500.0000 | 200000.0000 | 0.2850 | pinion
Gear 2 | AISI 1045 Carbon Steel | 400.0000 | 200000.0000 | 0.2850 | gear

### Allowable Contact Stress

HB_(gear) =400 (HB)

HB_(pinion) =500 (HB)

Z_N =2.466N^(-0.056) = 0.7764

(HB_p)/(HB_g)=1.25

A' = (8.89*10^(-3) )((HB_p)/(HB_g))-8,29*10^(-3) since 1.2≤(HB_p)/(HB_g)=1.25≤1.7

C_H =1.0+A'((N_g)/(N_p)-1.0)=1.0042

K_T =1

K_R =1

Gear 2:

S_(c2) =2.22*HB_g +200=1088 MPa

σ_(all,2) =(S_(c_) Z_N C_(Hg))/(K_T K_R)=848.2032 MPa

Gear 3:

S_(c3) =2.4*HB_p +237=1437 MPa

σ_(all,3) =(S_(c_) Z_N)/(K_T K_R)=1115.6426 MPa

Design Contact Stress

Gear 2:

K_a =1 for no shock

K_s =1

K_E =√(2/((1-v_p^2)/(E_p)+(1-v_g^2)/(E_g)))=466563.1271 [√(Pa)]

K_(m, gear) =1.1

Calculate Kv:

Q_v =6 for commercial gears

B=((12-Q_v )^(2/3))/4=0.8255

A=50+56(1-B)=59.7730

V_2 =(π*n_2 *d_(p2))/60=12.9329 m/s

K_v =((A+√(200V))/A)^B =1.6623

Calculate Design Contact Stress

σ_(c,actual) =K_E (√((W^t)/(b_w d_p I)K_a K_s K_m K_v))=725.0297MPa

Gear 3:

K_a =1 for no shock

K_s =1

K_E =√(2/((1-v_p^2)/(E_p)+(1-v_g^2)/(E_g)))=466563.1271 [√(Pa)]

K_(m, pinion) =1.2

Calculate Kv:

Q_v =6 for commercial gears

B=((12-Q_v )^(2/3))/4=0.8255

A=50+56(1-B)=59.7730

V_3 =(π*n_2 *d_(p3))/60=7.4295 m/s

K_v =((A+√(200V))/A)^B =1.5081

Calculate Design Contact Stress

σ_(c,actual) =K_E (√((W^t)/(b_w d_p I)K_a K_s K_m K_v))=760.4055 MPa

### Allowable Bending Stress

Calculate number of shaft cycles:

hrs=5 year*52 weeks*7 days * 8 hrs * 60 minutes=873600 mins

N=hrs*shaft speed(rpm)=918209362 Cycles

Gear 2:

Calculate allowable bending stress

Y_n =1.683(N)^(-0.0323) =0.8915

S_b =0.533(HB_(gear) )+88.3=301.5000 MPa

k_t =k_r =1.000

σ_(all,b) =(S_b Y_n)/(k_t k_r)=260.5364 MPa

Gear 3:

Calculate allowable bending stress

Y_n =1.683(N)^(-0.0323) =0.8915

S_b =0.533(HB_(pinion) )+88.3=464.5000 MPa

k_t =k_r =1.000

σ_(all,b) =(S_b Y_n)/(k_t k_r)=401.3902 MPa

### Design Bending Stress

Gear 2:

Y_j =0.420

k_a =1.000

k_s =1.000 [module == 5mm]

k_m =1.100 [gear]

k_i =1.000 [not idler]

k_b =1.000

K_v =((A+√(200V))/A)^B =1.6623

σ_b =(W^t)/(mb_w Y_j)k_a k_s k_m k_v k_i k_b =78.5482 MPa

Gear 3:

Y_j =0.350

k_a =1.000

k_s =1.000 [module == 5mm]

k_m =1.200 [pinion]

k_i =1.000 [not idler]

k_b =1.000

K_v =((A+√(200V))/A)^B =1.5081

σ_b =(W^t)/(mb_w Y_j)k_a k_s k_m k_v k_i k_b =149.8943 MPa

Factors of Safety

n_(c,2) =(σ_(all,c2))/(σ_(c2))=1.1699

n_(c,3) =(σ_(all,c3))/(σ_(c3))=1.4672

n_(b,2) =(σ_(all,b2))/(σ_(b2))=3.3169

n_(b,3) =(σ_(all,b3))/(σ_(b3))=2.6778

The design is good

## Bearing Selection

h=(5 year)(364 (day)/(year))(8(hr)/(day))=14560 hr [life hours]

n2 = n1*N1/N2 = 1051.0638 rpm [rotation speed]

L_10 =60(h)(n_3 )(10^(-6) )=918.2094 million cycles

A_P =1.000 [no shock]

m=3 [Deep Groove Ball Bearing]

P_r =Max(A,B)=8204.4900 N [A and B calculated in Force Analysis section]

X=1.000

Initial Selection

P=P_r X=8204.4900 N [No Axial Force]

C=PL_10 ^(1/m) =79744.1494 N

Choose SKF 6312 with C = 97500 N , C_0 = 60000 N

No reselection necessary since no thrust load

e=0.22 because (P_a)/(C_o)=0

(P_a)/(P_r)=0 < e

- X=1
- Y=0

Pick SKF 6312 for Final Bearing Selection with following specifications

Bearing Spec | C (N) | C0 (N) | d (m) | D (m) | W (m)
SKF 6312 | 97500.0000 | 60000.0000 | 0.0650 | 0.1400 | 0.0330

Reference: https://www.skf.com/group/products/rolling-bearings/ball-bearings/deep-groove-ball-bearings/productid-6312

### Expected Lifetime of Bearing

L=(C/P)^m =1678.2594 mil rev [using C=97500 N from SKF]

Life=L(10^6 )(n_2 )^(-1) (60(min)/(hr))^(-1) (8(hr)/(day))^(-1) (7(day)/(week))^(-1) (52(week)/(yr))^(-1) =9.1288 yr

Bearing does not require maintenance for intended operation of 5 years.

## Keyways and Tolerances

Gear Keyway (65 mm):

Shaft diameter d (mm) | Key width W x height H
58 < d <= 65 | 18 x 11

Fits:

Bearing inner ring and Shaft:

Interference fit (H7/p6) for hole basis. Interference needed for inner ring to rotate with shaft

Gear and Shaft:

Transition fit (H7/k6) for hole basis. Locational transition since shaft rotation will be transmitted from gear torque through interlocked key.

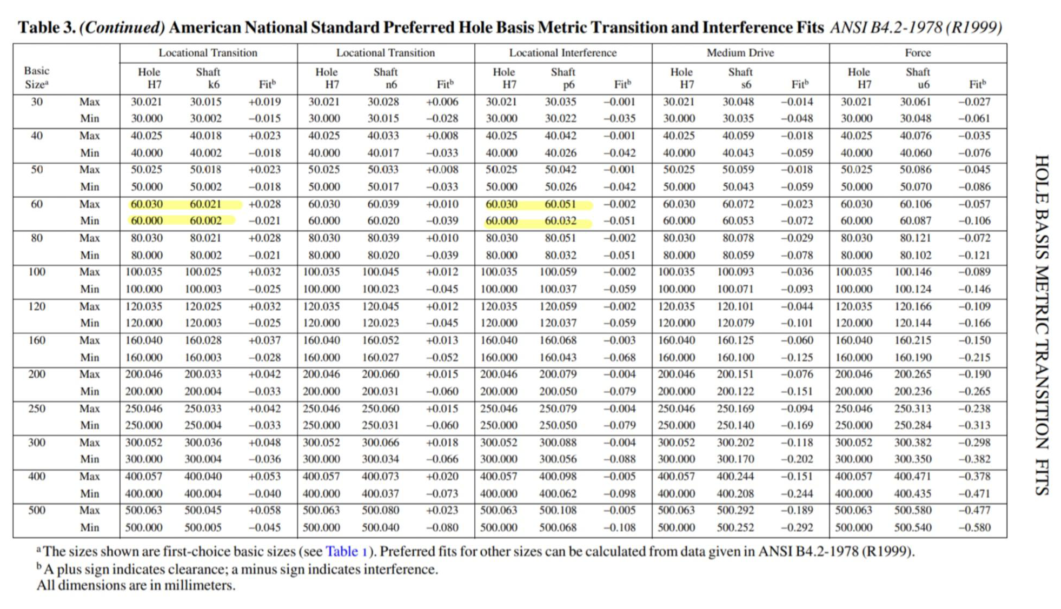
[picture p19: figure]

# Shaft Three Analysis

## Gearing

Given: n1 = 2600 rpm, H = 70000 W

Choose gear teeth (odd number, indivisible):

N1 = 19

N2 = 47

N3 = 27

N4 = 71

Choose standard module m=5mm and pitch angle phi = 20 deg for off the shelf ordering:

m = a = 0.005 [m]

b = 1.25m = 0.00625 [m]

ϕ = 20 degree

Calculate transmission ratio:

n_1 /n_3 =(N4)(N2)(N1)^(-1) (N3)^(-1) =6.5049

n3 = 2600/(n1/n3) = 399.7003 rpm

% error = |(n3-400)/400| = 0.0749%

Gear 4:

Geometry

N4 = 71 [Teeth]

Pitch Diameter: d_p =N_4 m=0.3550 [m]

Pitch Radius: r_p =d_p /2=0.1775 [m]

Face Width: b_w =12m=0.0600 [m]

Forces

Torque: T=(60H)/(2πn_3)=1672.380 Nm

Gear Forces: W_(T34) =T/r_p =9421.8581 N

W_34 =W_(T34) /cos(ϕ)=10026.532

W_(r34) =W_34 sin(ϕ)=3429.276 N

## Geometry

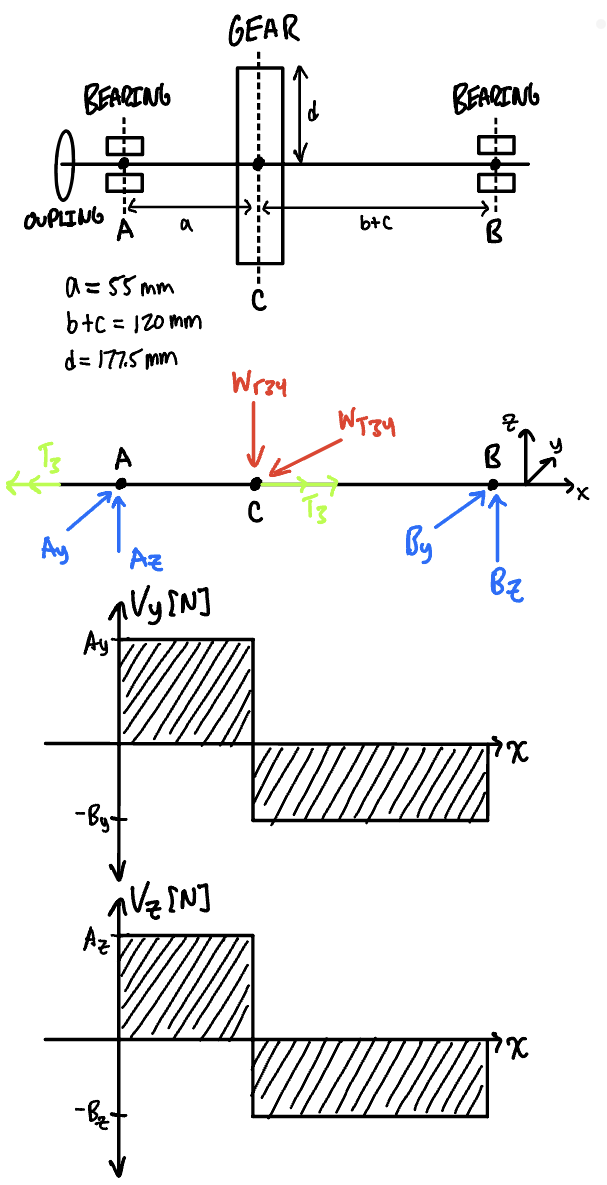
[picture p20: figure]
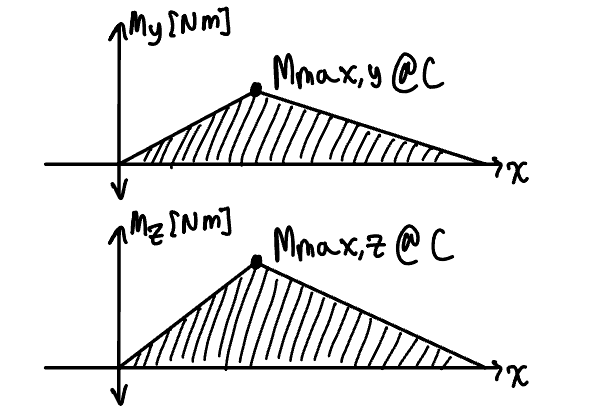
[picture p21: figure]

## Force Analysis

From the gearing section the following are solved:

W_(r34) =3429.2759 N

W_(t34) =9421.8581 N

From geometry we know the following:

a=55 mm; b+c =120 mm

d/2=177.5 mm

Derived from static equilibrium, solve this system of equations:

0=A_y +B_y -W_(t34)

0=A_z +B_z -W_(r34)

0=W_(t34) (a)-B_y (a+b+c)

0=W_(r34) (a)-B_z (a+b+c)

System of equations yields the following reactions with force directions as drawn:

Ay = 6460.7027 N

Az = 2351.5035 N

By = 2961.1554 N

Bz = 1077.7724 N

A=√(A_y ^2 +A_z ^2)=6875.3362 N

B=√(B_y ^2 +B_z ^2)=3151.1958 N

## Maximum Shear, Bending

Maximum bending occurs at cross section C:

M_(max,y) =A_y a=117.5752 Nm

M_(max,z) =A_z a=323.0351 Nm

M=√(M_y ^2 +M_z ^2)=343.7668 Nm

The shear magnitude at cross section C is:

Vy = Ay = 6460.7027 N

Vz = Az = 2351.5035 N

V=√(V_y ^2 +V_z ^2)=6875.3362 N

## Shaft Stress Analysis

We first choose material:

Material | E [Pa] | UTS [MPa] | Poisson Ratio | Ys [MPa]
AISI 1045 Medium Carbon Steel | 200000.0000 | 565.0000 | 0.2850 | 310.0000

### Minimum Shaft Diameter

Our factor of safety is n=1.1

Calculate the torque magnitude at the coupling:

T=W_(t34) d/2=1672.380 Nm

Calculate the minimum shaft diameter:

τ_(all) =0.557(Y_s )/n=156.9727 MPa

After unit conversion:

d_(min) =³√((16T)/(πτ_(all)))=37.858 mm

Consider keyway effect, round 5% increase [conservative]:

d_(min) '=Round[d_(min) (1.05)]≈40 mm

### Infinite Life at Critical Cross Section

Choose a shaft diameter of d = 55 mm at cross section C.

Solve for max bending torsion, and shear stresses at cross-section C experienced by point on the shaft surface:

σ_(bs) =(32M)/(πd^3)=21.0463 MPa

τ_T =(16T)/(πd^3)=19.4680 MPa

τ_V =(16V)/(3πd^2)=3.8585 MPa

Given these stresses, calculate the mean and amplitude stresses for cyclic loading:

σ_a =σ_(bs) =21.0463 MPa

σ_m =0 MPa

τ_m =(τ_T)/2=9.7340MPa [The shaft turns on and off]

τ_a =(τ_T)/2+τ_V =13.5925 MPa

This is a conservative estimate, since we use the shear and bending stress maximum amplitudes in calculating stress states, although these maximums are out of phase. Furthermore, we do not ignore shear (which is 30% of the mean shear).

Calculate Von-Mises given Kf = 3.000 and Kfs = 2.800 [conservative estimate]:

σ_(vm-a) =√((K_f σ_a )^2 +3(K_(fs) τ_a )^2)=91.2798 MPa

σ_(vm-m) =√((σ_m )^2 +3(τ_a )^2)=16.8598 MPa

Calculate Infinite Criteria given chosen material:

k_f =1.58*UTS^(-0.085) =0.9220 [Grinding]

k_s =1.189*d^(-0.112) =0.7590 [Size Factor]

k_r =0.82 [99% Reliability]

k_t =k_m =1.000

S_e '=0.5(UTS)=282.500 MPa

n_s =[(σ_(vm-a))/(k_f k_s k_r k_t k_m S_e ')+(σ_(vm-m))/(UTS)]^(-1) =1.6866 >1.1 [Chosen shaft diameter at C is safe]

### Yielding

n_y =[(σ_(vm-a))/(S_y)+(σ_(vm-m))/(S_y)]^(-1) =6.3999 > 1.1 [55mm shaft diameter does not pass yield line]

## Gear Stress Analysis

Choose material for gear:

Gear Material | Hardness [HB] | E (MPa) | Poisson Ratio | Material Grade
AISI 1045 Carbon Steel | 400.0000 | 200000.0000 | 0.2850 | 1

### Bending

Calculate number of shaft cycles:

t=5 year*52 (week)/(year)*7 (day)/(week) * 8 (hr)/(day) * 60 (min)/(hr)=873600 min

Rotation speed n3= 399.7003 RPM.

N=t*n_3 =349178207.9712 Cycles

Calculate allowable bending stress:

Y_n =1.683(N)^(-0.0323) =0.8915 [Stress cycle factor]

S_b =0.533(HB)+88.3=301.5000 MPa [Material strength for gear grade 1]

k_t =k_r =1.000 [Temperature not higher than 125 C, 99% reliability]

σ_(b, all) =(S_b Y_n)/(k_t k_r)=268.8011 MPa

Calculate actual bending stress:

Y_j =0.420 [Hamrock et al., 2005, N3=27, N4=71]

k_a =1.000 [No shock, Electric motor]

k_s =1.000 [Module = 5 mm]

k_m =1.17 [From Hamrock et al, 1999 table] [ b_w /d_p =0.4444, b_w =60 mm ]

k_i =1.000 [Non Idler]

k_b =1.000 [Rim thickness for solid disk]

Calculate Kv dynamic factor:

V=πn_3 d/60=7.4295 [m/s]

Q_v =6 [Commercial gear]

B=((12-Q_v )^(2/3))/4=0.8255

A=50+56(1-B)=59.7730

K_v =((A+√(200V))/A)^B =1.5081

σ_(b, actual) =(W^t)/(mb_w Y_j)k_a k_s k_m k_v k_i k_b =131.9382 MPa

Comparing the allowable to the actual bending stress:

n_b =σ_(all) /σ_b =2.0373>1.1

The design is sufficient for bending stress since nb > n = 1.1

### Contact

Calculate allowable contact stress:

HB_(pinion) =500 [HB]

HB_(gear) =400 [HB]

Z_N =2.466N^(-0.056) = 0.8196 [Cycle factor]

(HB_p)/(HB_g)=1.25 [Hardness ratio]

A' = (8.89*10^(-3) )((HB_p)/(HB_g))-8.29*10^(-3) [ 1.2≤(HB_p)/(HB_g)=1.25≤1.7 ]

(N_g)/(N_p)=2.6296

C_H =1.0+A'((N_g)/(N_p)-1.0)=1.0046 [Hardness Factor, for gear only]

K_T =1 [Temperature less than 125 C]

K_R =1 [99% reliability]

S_c =2.22*HB_g +200=1088 MPa [Material strength for contact]

σ_(c, all) =(S_(c_) Z_N C_(Hg))/(K_T K_R)=895.7861 MPa

Calculate actual contact stress:

K_a =1 [No shock, electric motor]

K_s =1 [m = 5 mm]

K_E =√(2/((1-v_p^2)/(E_p)+(1-v_g^2)/(E_g)))=466563.1271 [√(Pa)]

K_(m, gear) =1.17 [Same from bending]

K_v =1.5081 [From bending calculation]

ϕ=20 deg; d_p =0.135 m; d_g =0.355 m

I=(πcos(ϕ)sin(ϕ))/(1+(d_p)/(d_g))=0.7315 [Geometry factor]

σ_(c,actual) =K_E √((W^t)/(b_w d_p I)K_a K_s K_m K_v)=781.4993 MPa

### Factors of Safety for Bending and Contact

σ_(c,actual) =781.4993 MPa

σ_(c, all) =895.7861 MPa

σ_(b, actual) =131.9382 MPa

σ_(b, all) =268.8011 MPa

n_c =(σ_(c, all))/(σ_(c,actual))=1.1462>1.1 [Safe for contact stress]

n_b =(σ_(b, all))/(σ_(b,actual))=2.0373>1.1 [Safe for bending stress]

## Bearing Selection

h=(5 year)(364 (day)/(year))(8(hr)/(day))=14560 hr [lifetime hours]

n3 = 399.7003 RPM

L_10 =60(h)(n_3 )(10^(-6) )=349.1782 Million Revs

A_P =1.000 [No Shock, electric motor]

m=3 [Ball Bearing]

P_r =Max(A,B)=6875.3362 N [A and B calculated in Force Analysis section]

X=1.000

P=P_r X=6875.3362 N [No Axial Force]

C=PL_10 ^(1/m) =48414.5965 N

Given the calculated C, I specify the following bearing from SKF:

Bearing Spec | C (N) | C0 (N) | d (m) | D (m) | W (m)
6311 | 74100.0000 | 45000.0000 | 0.0550 | 0.1200 | 0.0290

Reference: https://www.skf.com/us/products/rolling-bearings/ball-bearings/deep-groove-ball-bearings/productid-6311

This bearing is safe because the bearing specification C is less than our calculated C. Recalculation is not necessary since there is no thrust force and radial factor X is constant, not a function of e or C0.

### Expected Lifetime of Bearing

L=(C/P)^m =1251.9091 mil rev [using C=74100 N from SKF]

Life=L(10^6 )(n_3 )^(-1) (60(min)/(hr))^(-1) (8(hr)/(day))^(-1) (7(day)/(week))^(-1) (52(week)/(yr))^(-1) =17.9265 yr

Bearing does not require maintenance for intended operation of 5 years.

## Keyways and Tolerances

Coupling Keyway (50 mm) and Gear Keyway (55 mm):

Shaft diameter d (mm) | Key width W x height H
50 < d <= 58 | 16 x 10

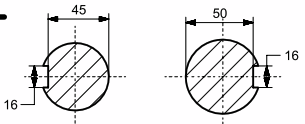
[picture p22: figure]

Fits:

Bearing and Shaft: Interference fit (H7/p6), bearing should be tightly fit with shaft for fluid rotation.

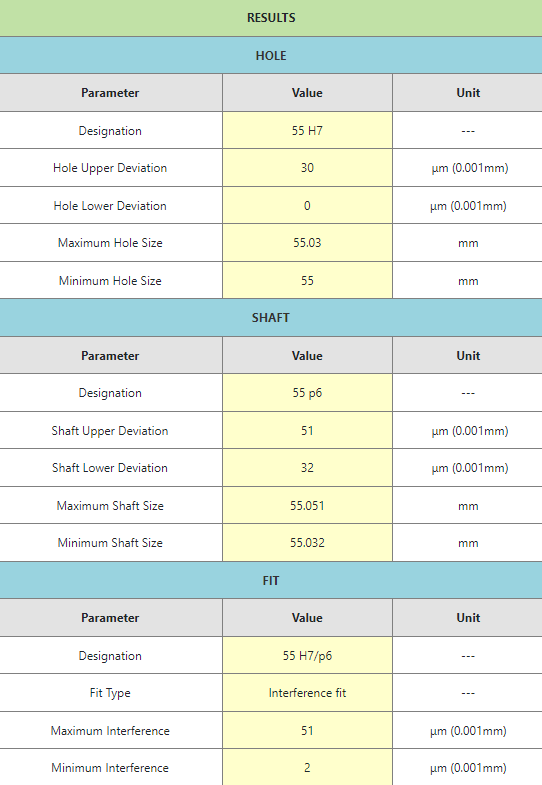
[picture p23: figure]

Gear and Shaft: Transition fit (H7/k6), shaft rotation will be transmitted from gear torque through interlocked key.

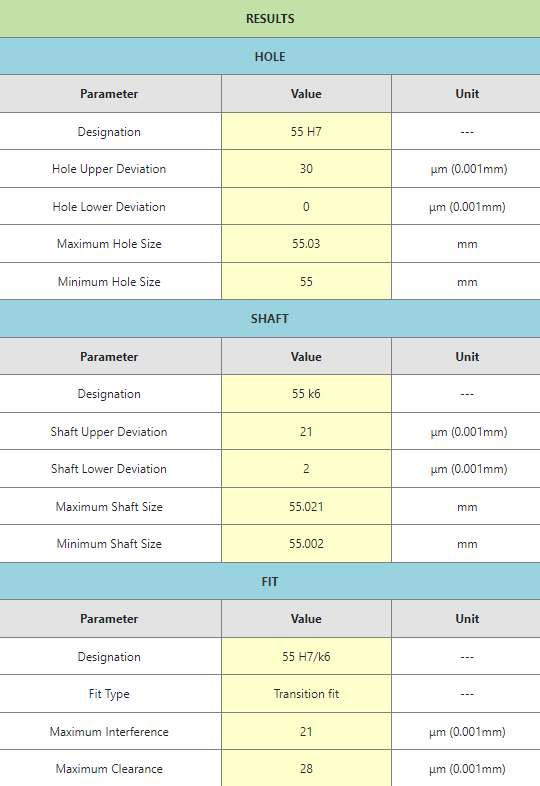
[picture p24: figure]

Source: https://amesweb.info/fits-tolerances/tolerance-calculator.aspx
