ChristopherLuey/315-MechanicalDesign/315 Project/Questions_Uncertainties.docx

CAD

Shaft 1

- Height of shoulder?
- Length of shoulder?
- Keyway for gear?
- Width of shaft section for keyway? Overhang?
- Chamfer for all of it?
- Number of teeth ok?

Compatibility?

Check diameters
