ChristopherLuey/315-MechanicalDesign/315 Project/315 Project - Copy of Copy of Playground.pdf

| Transmission Speed | Created By: Winston Zhao, Christopher Luey, Chirag Bachani
n1 | 2600.000 | rpm | given
n3 | 400.000 | rpm | given, ideal
n1/n3 | 6.500 | given
| Gear Property
m | 0.0050 | m
a | 0.0050 | m
b | 0.006250 | m
phi | 20.0000 | deg

Factor of Safety
1.1000
Gearing | N | Pitch Diameter (d0) Pitch Radius (r0) Outer Circle (do) Root Circle (dr) Face Width (bw) | Torque | Wt | Wr | W | Power | AddendumDedendum
N1 N2 N3 N4 | 19.0000 47.0000 27.0000 71.0000 | teeth 0.095 0.048 0.105 0.083 0.065 m 257.096 5412.557 1970.010 5759.923 N 70000.000 W teeth 0.235 0.118 0.245 0.223 0.060 m 635.975 5412.557 1970.010 5759.923 N 70000.000 W teeth 0.135 0.068 0.145 0.123 0.065 m 635.975 9421.858 3429.276 10026.532 N 70000.000 W teeth 0.355 0.178 0.365 0.343 0.060 m 1672.380 9421.858 3429.276 10026.532 N 70000.000 W
n1/n3 n3 % Error | 6.5049
| 399.7003 -0.07% | rpm
N1/N2 N3/N4 | 0.4043 0.3803 Left Right Shaft Diameter Ay Az By Bz My Mz M V_A V_B sigma,bs tau,T tau,S
Shaft 1 | 2600.0000 | rpm | 0.0450 | 1546.4448 | 562.8599 | 3866.1120 | 1407.1497 | N | -70.3575 | 193.3056 | 205.7115 | 1645.6922 | 4114.2304 | 22.9944 | 14.3691 | 3.4492 | MPa
Shaft 2 | 1051.0638 | rpm | 0.0600 | 8007.1475 | 1788.6436 | 6827.2674 | 329.3773 | N | -98.3754 | -440.3931 | 451.2470 8204.4900 | 6835.2081 | 21.2795 | 14.9954 | 3.8690 | MPa
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
Shaft 3 | 14560.0000 | 399.7003 | 349.1782 | 1.0000 | 3.0000 | 6875.3362 | 1.0000 | 6875.3362 48414.5965 | 6311 | 74100.0000 | 45000.0000 | 0.0550 | 0.1200 | 0.0290
