ChristopherLuey/315-MechanicalDesign/Ebook/eBook/Chapter3VariableLoading.pdf

Chapter 3 | Variable Loading and Fatigue Failure
3-1 | Variable loading

Strictly speaking, there is no static loading whose magnitude, direction, and location of application do not change at all with time. What we see in the real world are loads that more or less vary. The reason why we have to study static loading is due to its simplicity for the analysis. Whether or not a load is variable has to be decided by how stresses behave as a function of time.

Example 3-1. The diagram shown in Figure 3-1 is a piece of a long shaft that is loaded by a pair of constant tensile loads, F, and a pair of constant bending moment, M (in the x-y plane). The shaft rotates at a constant angular speed, ω. The balance of the torque is not shown here in this piece of the shaft, and the effect of torque is not included. It seems that we would have a constant loading case in terms of the loads. Here, are we talking about static or variable loading? Think about the problem carefully and write down the normal stress equation for point P marked by the red dot.

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
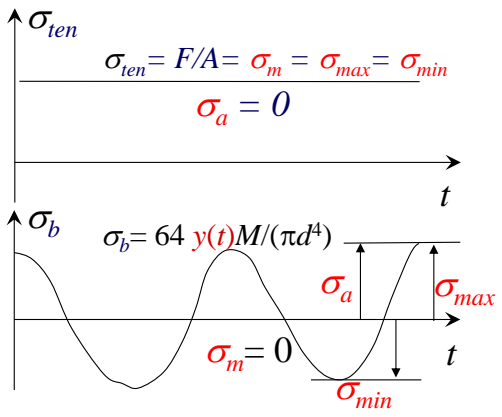
[picture p60: figure]
smax sa; smin; sten; sten= F/A= sm = smax= smin

Figure 3-1. A simple shaft loaded with a pair of constant tensile loads, F, and a pair of constant bending moments, M. Note the stress notations are different for describing different load-stress relations; sten is for the normal stress due to tension by F, sb for the normal stress due to bending by M.

Let’s take a look at point P at the shaft surface. There should be two components of the normal stresses, one (sten) due to the tensile force, F, and the other (sb) due to the bending moment M. For this case, the one due to tension should not change with time; however, the one due to bending does change with time. When point P is at the lowest position, the bending stress is tensile and in its maximum value. When point P is at the highest position, the bending stress is compressive and in its minimum value (but still maximum in magnitude). The bending stress is zero when point P passes through the neutral plane. Both stresses are plotted in Figure 3-1, and the maximum stress, smax, the minimum, smin, the stress variation amplitude, sa, and the midrange stress (or average stress, or the mean stress, the same for this case), sm, are shown for each stress. Clearly, the case shown in Figure 3-1 is a variable loading case.

The total stress at point P is plotted in Figure 3-2 as a function of time and expressed by Equation (3-1).

sp = 4F/(pd

2
) + 64y(t)M/(pd

4
) | (3-1)

Figure 3-2 also plots the maximum stress, smax, the minimum, smin, the stress amplitude, sa, and the midrange stress, sm, for this example, which is also a general case of stress variation. Note that here maximum stress smax and minimum stress smin are for the range of stress variations, different from those we used for analyzing principal stresses.

If the stress sequence repeats itself as a function of time, we say that the stress is cyclic. Cyclic stresses may have different behaviors: completely reversed if sm=0, released tension if smin=0, or released compression if smax=0.

smax sa
sm

smin

t

sm = (smax + smin)/2

sa = (smax - smin)/2

smax = sm + sa

= F/A

= 32M/(pd

3)

= F/A + 32M/(pd

3)

s= F/A + 64 y(t)M/(pd

4)

(3-2)

smin = sm

- sa = F/A - 32M/(pd
3)

Figure 3-2. A variable stress, and definitions of the maximum stress, smax, the minimum stress, smin, the stress amplitude, sa, and the midrange stress (or the average stress), sm.

Stress variation accelerates failure of the material of a component. The amplitude of the stress variation and the number of cycles of stress variation matter a great deal.

3-2 Rotating beam tests and S-N diagrams

For a mechanical component operated under a variable load, the mode of failure is likely fatigue, which is a damage accumulation phenomenon. Materials and parts may have many flaws at the micro scale, some of which may grow into large cracks and cause the materials to fail. The number of cycles of stress variation means the life of a part subjected to a certain load. Generally, the load that a part can support decreases with the increase in stress cycles. Predicting the life of an actual engineering part is a difficult issue because of complicated part geometry, stress concentration, and operating conditions, etc. Let’s first see the fatigue behavior of a material and take a look at its fatigue strength by “conducting” rotating-beam tests with a group of standard specimens shown in Figure 3-3. The specimen surfaces should be well polished.

A rotating beam fatigue tester, e.g. the R. R. Moore rotating-beam machine, is virtually used for the “experiments” here. The beam is subjected to pure bending without a transverse shear force. The fatigue strength of the material is measured by the stress at which the specimen fractures into two equal pieces. With the rotating beam tests, we can plot a diagram for the fatigue strength as a function of fatigue life, or the S-N diagram (the Wohler diagram) for a material. Here, N is the number of cycles of rotation (or stress variation) right before failure.

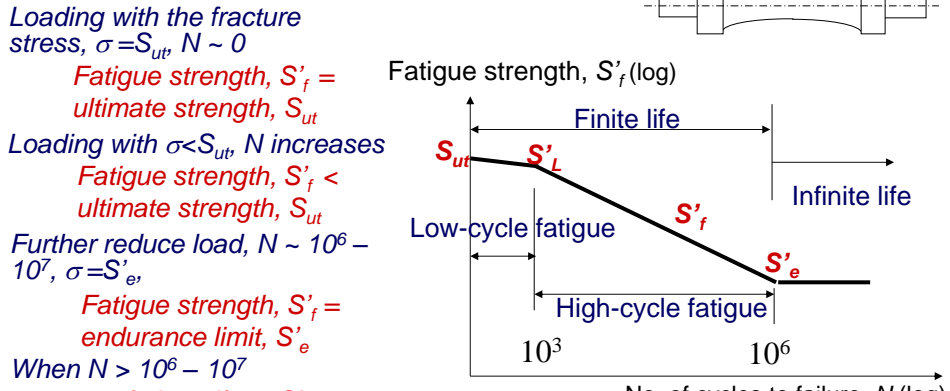
[picture p61: figure]
Fatigue strength, S’f (log); Finite life; Infinite life; High-cycle fatigue; Low-cycle fatigue; Loading with the fracture stress, s =Sut, N ~ 0; Loading with s<Sut, N increases; Further reduce load, N ~ 10⁶ – 10⁷ , s =S’e ,; When N > 10⁶ – 10⁷; Sut; Fatigue strength, S’f = ultimate strength, Sut; Fatigue strength, S’f < ultimate strength, Sut; Fatigue strength, S’f = endurance limit, S’e

No. of cycles to failure, N (log) No fatigue if s < S’e

M | Rotation | M
Figure 3-3. | Rotating-beam tests, an S-N (log-log) diagram, and a standard specimen.

Let’s “do” one S-N diagram for a ferrous alloy. When a static load is applied, the fatigue (fracture) strength has to be the ultimate limit, Sut, or simply, Su. The fatigue strength reduces as the number of cycles increases. There are two turning points observed. The first one defines the intersection between low-cycle fatigue and high-cycle fatigue, while the second defines a very important property of the material, the endurance limit. For a specimen whose working stress is lower than the endurance limit, its fatigue life may be infinite, i.e., no fatigue would occur.

Let’s summarize our observations in important regimes.

When N ~ 0 | The fatigue strength, S’f = ultimate strength, Sut=Su
When N increases | The fatigue strength, S’f < the ultimate strength, Sut=Su

When N ~ 10⁶

- 10⁷ | The fatigue strength, S’f = endurance limit, S’e

When N > 10⁶

- 10⁷
: | No fatigue, or the life is considered to be infinite.
Here, we use S’f | for the fatigue strength of a material, not for a mechanical component, and
likely for others, superscript “ ’ ” indicates the property of a material, not of a component. For the low-cycle fatigue (N < 103), we can simply reduce the level of the ultimate strength to obtain the low-cycle fatigue strength, S’L
for a material:
Bending: | S’L = 0.9 Sut | (3-3-1)
Axial loading: | S’L = 0.75Sut | (3-3-2)
Torsional loading: | S’L = 0.72Sut | (3-3-3)

For the high-cycle fatigue (10⁶

| ≥ N ≥10³ ), if we know S’L and S’e | (the endurance limit of the

material), we can find the fatigue strength, S’f
| | , on the log-scale straight line (note the units):

log Sf

’ = b log N + c | (3-4-1)

Slope,

( ( ) | ( ))
' | '
'

'
log log
3

1
log
3

1

L | e
e

L
S | S
S

S
b | = − | −
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
= − | (3-4-2)

Intercept,

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
= | '

2 '
log
| e

L
S

S
c
(3-4-3)

Thus, the fatigue strength can be found as

( ) ( )
c | b
S f | 10 N

'
=
in MPa | (3-2-4)

The unit for b is logMPa/logN and that for c is logMPa.

Endurance limit. The endurance limit, S’e
, may be identified for ferrous materials, as that clearly shown by the knee when N is about 10⁶

~10⁷
in Figure 3-3. This is the case for most ferrous materials. However, most non-ferrous materials, such as aluminum alloys, copper alloys, and polymer materials, do not have an apparent endurance limit. The knee does not appear in their S-N diagrams. These materials will fatigue regardless of the stress amplitude. Instead, the fatigue strength at 50(10)⁷
cycles is given in many handbooks as the so-called endurance limit.

The endurance limits of steels for different types of loading may be approximated as follows.

Bending: | S’e = 0.5 Sut | (3-5-1)
Axial loading: | S’e = 0.45Sut | (3-5-2)
Torsional loading: | S’e = 0.29Sut | (3-5-3)

The endurance limits for other materials may be found from reference books listed at the end of this chapter, or from materials handbooks (such as Metals Handbook). Note that these reductions are for pure loading modes. For a combined loading mode, we need to use either the distortion energy theory or the maximum shear stress theory to combine the stresses, and then use Eq. (3-5-
1) or (3-5-3). Think, why more reduction is given to torsional loading? Is there any relationship between Eqs (3-5-1) and (3-5-3)?

Example 3-2. A steel (Su = 1080MPa) is used for a shaft whose life should be 10,000 cycles. What is the maximum possible stress that this component can sustain?

Solution

This is a high-cycle fatigue problem, as marked in Figure 3-4. We need to use the power-law straight-line equation (3-4) to solve it.

Step 1: Find S’e and S’L

From Equations (3-5-1) and (3-3-1)

S’e = 0.5 Sut = 0.5 Su S’L = 0.9 Sut

Step 2: Solve the power-law straight-line equation

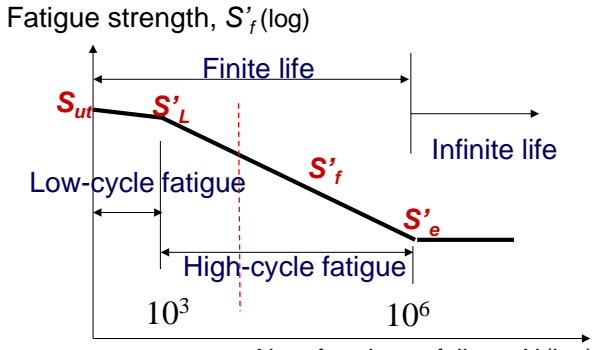
[picture p62: figure]
Fatigue strength, S’f (log); Finite life; Infinite life; High-cycle fatigue; Low-cycle fatigue; Sut

No. of cycles to failure, N (log) Figure 3-4 Cycle number and fatigue strength for the steel in Example 3-2.

The slope,
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
= − | ' '
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
=(1/3)log(0.9 Sut /0.5 Sut)= -0.0851 (logMPa/logN)

The intercept, c =

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
= | '

2 '
log
| e

L
S

S
c

= log([0.9*1080 ]²
/[0.5*1080])= 3.2439 (logMPa)

Thus, the fatigue strength is Sf

’ = (10)c
(N)

b

= (10)³.2439(10000)

-0.0851 = 800 MPa, and this is the maximum possible stress that the shaft can sustain.

3-3 Endurance limit of a component, modified endurance limit

The endurance limit of a mechanical component, Se, is related to, but different from the endurance limit of a material. A mechanical component is different from the rotating beam in many aspects. The following equation defines the endurance limit of a mechanical component, which is the modified endurance limit based on the endurance limit obtained from the rotating-beam test (or that listed in a handbook):

Se = k0kfkskrktkm S’e | (3-6)
Endurance limit from the rotating-beam tests, S’e Miscellaneous factor

Temperature factor
Reliability factor
Size factor
Surface finish effect
Stress-concentration
reduction factor
Endurance limit of a machine element

3-3-1 Stress-concentration reduction factor, k0. Stress concentration happens when a geometric discontinuity appears, Section 3.5 at the end of this chapter explains the analysis of stress concentration through notch sensitivity. The stress-concentration reduction factor is defined as

k0 = 1/Kf | (3-7-1)

Here, Kf is named the fatigue-stress-concentration factor for normal stresses. For a shear stress, the fatigue stress concentration factor is Kfs

Maximum stress in a notched element Stress in a notch-free element
= 1 + (Kc
-1) q | (3-7-2)

The stress concentration effect can be taken into account either by reducing the endurance limit by k0, or by increasing the work stress by Kf
. The latter may be more practical because different stress components (shear and normal, under different loads, corresponding to different notches) may have different fatigue stress concentration factors. See Section 3-5 at the end of this chapter for details.

3-3-2 Surface finish factor, kf
. Surface finish of a mechanical component is different from that of the rotating-beam specimens. A factor has to be determined to take into account the effect of surface finish.

The surface finish factor, kf
, is empirically fit into the following equation:

kf = e(Sut)

f
(3-8)

Coefficients e and f are defined in Table 3-1.

Table 3-1 | Coefficients e and f in Equation (3-8) (Shigley and Mischke 1989)
Manufacturing process | Factor e (MPa) | Factor e (Ksi) | Exponent f
Grinding | 1.58 | 1.34 | -0.085
Machining or cold drawing | 4.51 | 2.70 | -0.265
Hot rolling | 57.7 | 14.4 | -0.718
As forged | 272.0 | 39.9 | -0.995

Kf =

Notch sensitivity
Theoretical stress
concentration factor

3-3-3 Size factor, ks. The geometry of a mechanical component is definitely not the same as that of the rotating-beam specimens. A factor has to be defined to take into account the effect of size.

The size factor for a round bar is defined based on the type of loading. For bending and torsion, the following equations are useful:

ks = 0.869 (d)

-0.112 | 0.3” < d <10” | (d in inch) | (3-9-1)
ks = 1 | 0.3” > d, or d ≤ 8 mm | (3-9-2)
ks = 1.189 (d)
-0.112 | 8 mm < d ≤250 mm (d in mm) | (3-9-3)

For axial loading,

ks = 1 | (3-9-4)

3-3-4 Reliability factor, kr
. Because fatigue is closely related to pre-existing material defects, uncertainty is always a concern. Table 3-2 lists some of the commonly used reliability factors based on the requirement of probability of survival.

Table 3-2 Reliability factor, kr (Hamrock et al 1999)

Percentage probability of survival | Reliability factor, kr
90 | 0.90
95 | 0.87
99 | 0.82
99.9 | 0.75

3-3-5 Temperature factor, kt
. Temperature affects material properties and stresses, and therefore affects fatigue of a part. A temperature factor may be defined by the following ratio.
kt = Sut/Sut, ref | (3-10)

Here, Sut is the ultimate tensile strength at a desired temperature, Sut,ref is the ultimate tensile strength at a reference temperature, which is usually the room temperature.

3-3-6 Miscellaneous factor, km. Many other processes and conditions may also affect fatigue of a component. These influences can be taken into account by this miscellaneous factor.

3-4 Fatigue failure criteria

The specimen in the rotating beam tests is subjected to the bending stress amplitude only, or its normal stress is completely reversed. In reality, loading conditions of mechanical components are much more complicated than that of the rotating beam. Both normal and shear stresses may exist. Both stress midrange and amplitude may be not zero. There are quite a few theories and criteria that consider both non-zero midrange and amplitude of stresses. The Goodman line is one of the widely accepted criteria for designing parts against fatigue failure. Figure 3-5 shows the Goodman line for the design for an infinite fatigue life (because Se is used) together with the yield line. The Goodman line is so constructed that the midrange and the amplitude of a stress state, in terms of the von Mises stress or other type of stresses obtained from a failure theory, are used as the horizontal and vertical coordinates. The horizontal axis corresponds to static loading (sa =0), while the vertical axis is for completely reversed loading (sm =0). When a stress state has a large midrange component, checking yield is of the primary importance. The safe-design region is under both the Goodman line and the yield line.

The Goodman line is created using the fully modified endurance limit and the ultimate tensile strength of the material under consideration. Can we construct a Goodman line for the fatigue strength with respect to a finite life?

Goodman’s line for failure:
+ | = 1
| ut m

e

a
S | S
s | s
(3-11-1)

Goodman’s line for design:

ut | s

m

e

a
S | S | n
| | 1
+ | =
s | s
(3-11-2)

Yield line for failure:

+ = 1 y

m

y

a
S | S
s | s
(3-12-1)

Yield line for design:

y | s

m

y

a
S | S | n
| | 1
+ | =
s | s
(3-12-1)

sa

sm

Se

Sy

Sy | Sut

### (sm,sa)

Safe design region

Goodman line

Yield line

Figure 3-5. Goodman line for the design for infinite life, together with the yield line. The von Mises stress may be used. The green dot indicates the working stress state of a part inside the safe-design region.

In Figure 3-5, the failure lines are described by Equations (3-11-1) and (3-12-1). Equations 3-11-2) and (3-12-2) are for the safe design use because a factor of safety, ns, is involved. The design calculation process may be summarized as follows:

A. Draw a mechanical model from the designed structure, FBD
B. Conduct force analyses.
C. Conduct stress analyses for bending, torsion, tension, compression, and transverse shear; analyze the principal stresses, both amplitude and midrange.
D. Apply a design theory. For ductile materials (shafts are usually made of ductile materials), use the maximum shear stress theory or the distortion energy theory, to determine the amplitude and midrange of stresses.
E. Determine the endurance limit, or the fatigue strength, of the material used, and the modification factors.
F. Consider stress concentration factor Kf or Kfs for the stress amplitude (then, do not use k0).
H. Apply the Goodman line.
I. Check yield.
J. Modify the design and repeat A-H if necessary until ns is satisfactory.

Example 3-3 The mechanics analysis of the most critical point of a shaft results in the following stress components: sxm = 30 MPa (midrange), sxa = 70 MPa (amplitude), and τxym = 50MPa (midrange only, or static). The material is an AISI 1040 medium-carbon steel (yield strength: Sy = 350 MPa, ultimate strength, Sut = 520 MPa). The result of the correction factors is kfkskrktkm = 0.9. The fatigue stress-concentration factors for the normal and shear stresses are respectively Kf=1.5, Kfs=1.3. Let’s calculate the factors of safety by using the distortion-energy theory for the failure stress and the Goodman line for fatigue.

Solution

This problem is for the rotating shaft shown below, Figure 3-6. Steps A~C have been done.

Figure 3-6. Example 3-3, loading and the stresses in the Goodman diagram with both the Goodman line and the yield line.

Step D: | von Mises stress,
2 | 2
( | ) | 3( | )
vm | x | xy s = | s | + τ

How can we handle the midrange and amplitude of the von Mises stress? Assuming the shear stress and normal stress vary at the same frequency, Figure 3-7 shows the ranges of the variations of the normal stress (along the vertical axis) and

3τ
, as well as
2 | 2 ( ) | 3( ) s | s | τ VM = | +
, | which | is | like | a | vector | of

s
and

3τ
. Therefore,

s’a

234MPa

350MPa

(91.7,105)MPa

350MPa | 520MPa

Yield line

Goodman line

s’m

sxm = 30 MPa,

M sxa = 70 MPa

M

F
F P

ω

T T M

M

F
F P

ω

T T

τxym = 50MPa

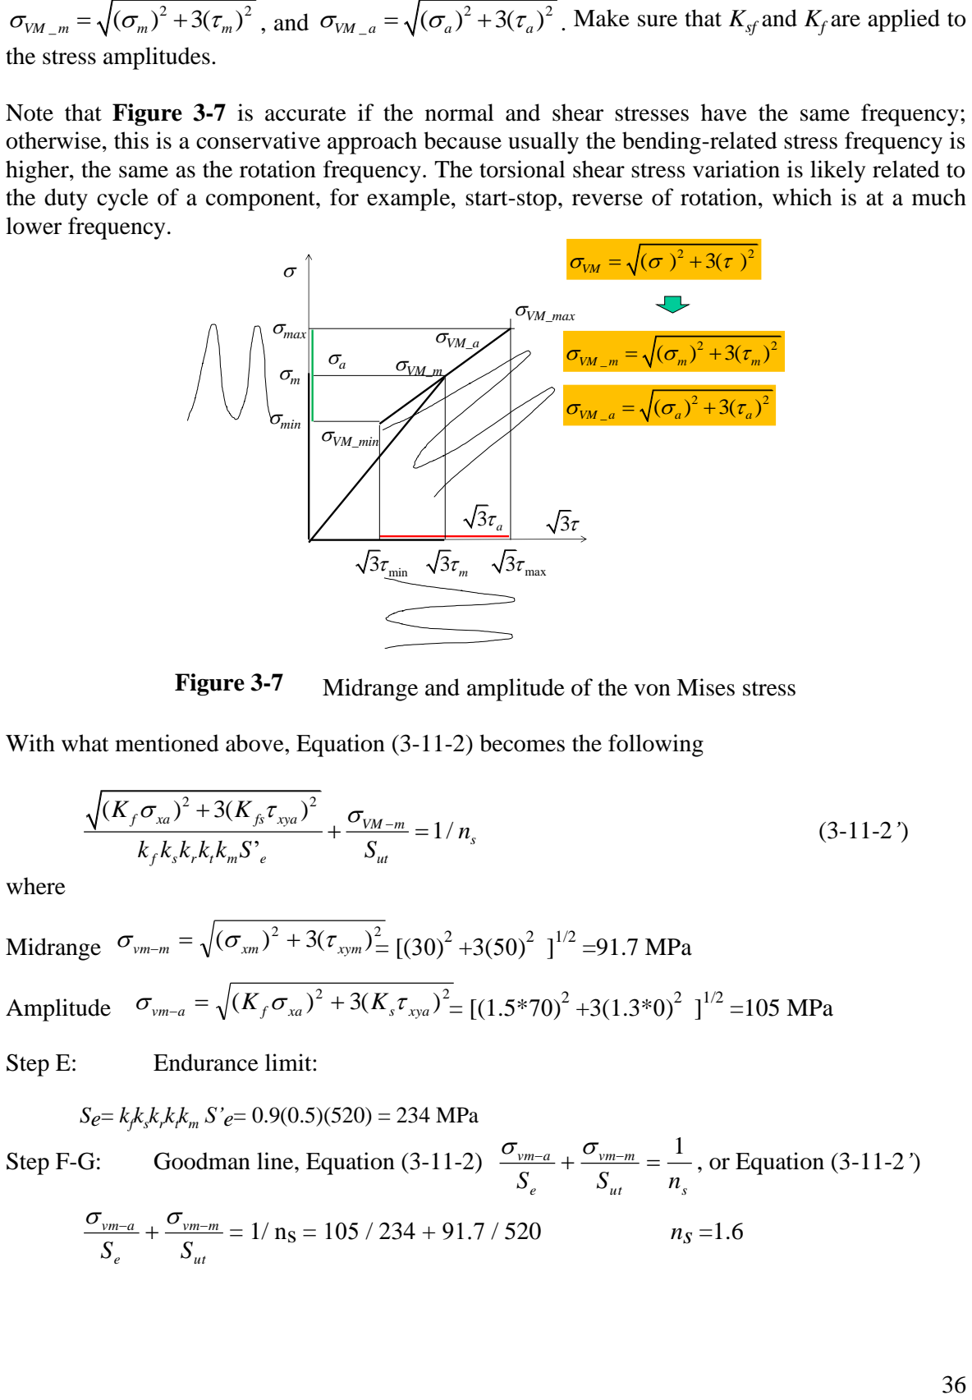
[picture p63: figure]
, and; the stress amplitudes.; lower frequency.; smax; smin; max 3τ min 3τ; sVM_min; sVM_max; sVM_m; sVM_a; fs xya; where; Midrange; 1/2 =91.7 MPa; Amplitude; 1/2 =105 MPa; Step E:; Endurance limit:; km S’e= 0.9(0.5)(520) = 234 MPa; , or Equation (3-11-2’); xym s; Ks xya s

( ) | 3( ) s | s | τ VM a | a | a = | + | . Make sure that Ksf and Kf are applied to

Note that Figure 3-7 is accurate if the normal and shear stresses have the same frequency; otherwise, this is a conservative approach because usually the bending-related stress frequency is higher, the same as the rotation frequency. The torsional shear stress variation is likely related to the duty cycle of a component, for example, start-stop, reverse of rotation, which is at a much

Figure 3-7 Midrange and amplitude of the von Mises stress

With what mentioned above, Equation (3-11-2) becomes the following

Step F-G: | Goodman line, Equation (3-11-2)
= 1/ ns = 105 / 234 + 91.7 / 520 | ns =1.6

Step H: Yield line

y | s

m

y

vm a
S | S | n
| | 1

0
+ | =
s − | s
. Note that the peak stress has no modification by the stress

concentration factors.

The peak von Mises stress:

vm | (
xa | xm ) | 3(
xya | xym ) | (70 30) | 3(50) | 132.3Mpa ² | 2 | 2 | 2 s = | s +s | + τ | +τ | = | + | + | =
y | s

vm

y

m

y

vm a
S | S | S | n
| | | 1

0
+ | = | =
s − | s | s
, ns = Sy/ svm = 350 /132.3 | ns =2.65

We only need to check the peak stress for static loading. Most shafts are made of ductile materials, and there is no need to consider stress concentration for static loading.

Step I is not needed for this case.

Other lines for design

There are other criteria. However, for this class, we will only focus on the Goodman line.

Gerber’s line for failure:
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
S | S
s | s
(3-13-1)

Gerber’s line for design:
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
n s s
(3-13-2)

Soderberg’s line for failure:

+ = 1

y

m

e

a
S | S
s | s
(3-14-1)

Soderberg’s line for design:

y | s

m

e

a
S | S | n
| | 1
+ | =
s | s
(3-14-2)

3-5. Determination of stress concentration factors

1 Theoretical stress-concentration factors for normal and shear stresses: Kc, Kcs. Capital K, not the lower case, is used for the stress concentration factor. The lower case of k is used for the factors that modify the endurance limit.

Kc = Maximum stress in notched specimen Stress in notch-free specimen (or nominal stress) = smax/so

Kcs = τmax/τo

A geometric discontinuity is called a “notch.” Figure 3-8 compares the normal stresses in plates with and without a notch, which is a hole there.

2 | 2
( | ) | 3( | )
vm | xa | xm | xya | xym s = | s + s | + τ | +τ

Notched | Notch free
Figure 3-8 | Notch effect.

2 Fatigue stress-concentration factor for normal and shear stresses Kf, Kfs. Kc and Kcs may over estimate the effect of stress concentration and should be reduced by considering the sensitivity of a material to stress concentration. Kf and Kfs are defined as:

Kf = 1 + q (Kc – 1)
Kfs = 1 + q(Kcs – 1)

3 Notch sensitivity q. Notch sensitivity q is experimentally determined to reflect the sensitivity of a material to the stress concentration.

If q = 0 then Kf = 1, the material is not sensitive to notches. If q = 1then Kf = Kc, the material is very sensitive to notches.

Figure 3-9 plot the values of theoretical stress concentration factor, Kc, at a shoulder due to different loading modes.

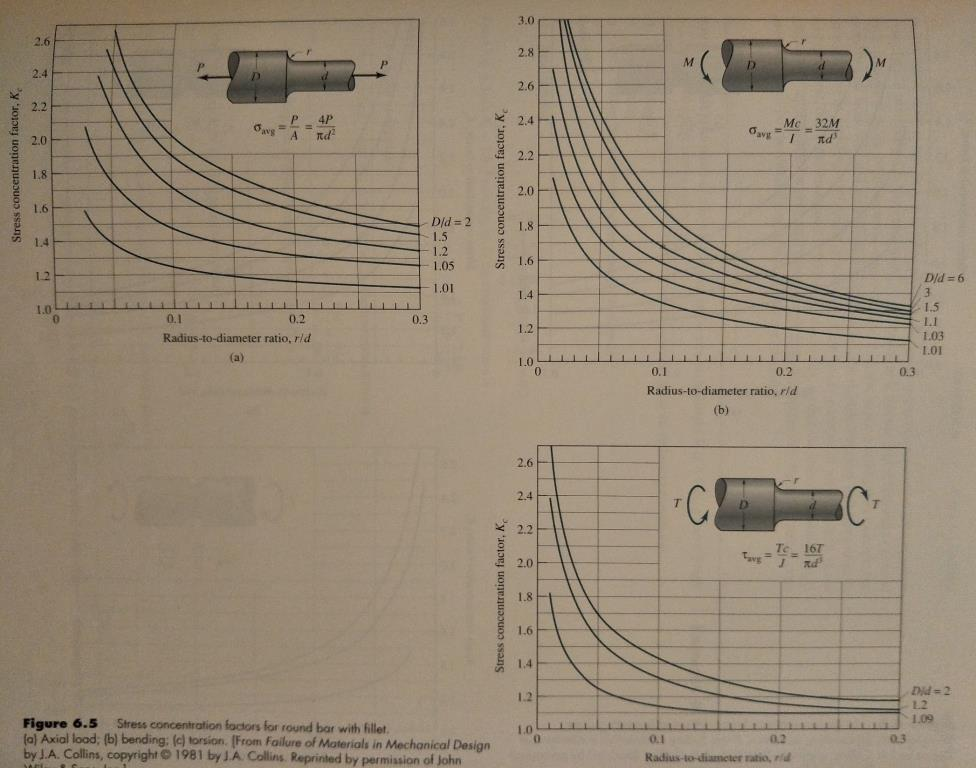
[picture p64: figure]

Figure 3-9 Theoretical stress concentration factor, Kc, for different loading modes. From Hamrock, et al., 2005, “Fundamentals of Machine Elements,” McGraw Hills.

s

so max

F

F

F F

Figure 3-10 plot the values of q for different materials and loading forms. For cast iron: q = 0.2, which means not very sensitive because too many defects are already in materials, and the effects of these defects are reflected by their strengths. Several curves cited from the references are pasted at the end of this chapter.

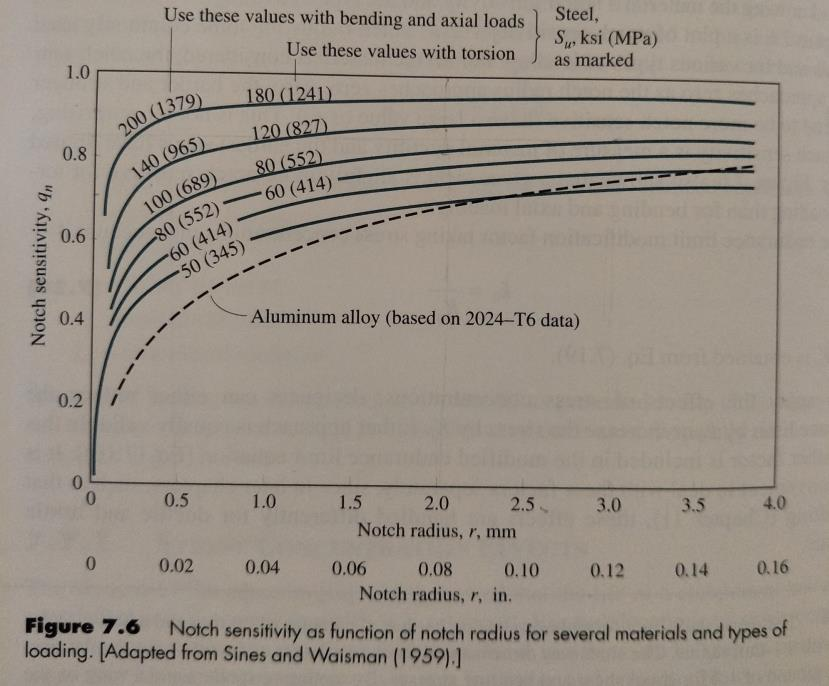
[picture p65: figure]

Figure 3-10. Data for notch sensitivity. From Hamrock, et al, 2005.

Applications. Brittle materials require the consideration of stress concentration if a notch exists. For ductile materials, stress concentration is only considered for the amplitude of a variable stress.

Example 3-4. Determine the fatigue stress-concentration factors, Kf and Kfs, at the shaft shoulders, shown in Figure 3-11, for (a) cast iron and (b) drawn steel, Sut = 700 MPa.

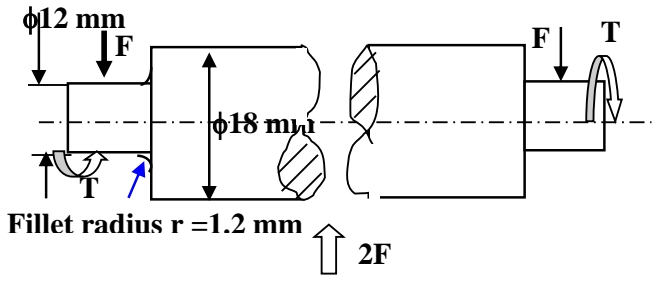
[picture p66: figure]
T Fillet radius r =1.2 mm

Figure 3-11. Example 3-4.

Solution:

(a) | Kf = 1 + q(Kc – 1) | - for normal stress (bending)
| Kfs = 1 + q(Kcs – 1) | - for shear stress (torsion)

Find Kc (for bending) and Kcs (for torsional shear) from Figure 3-9

Kc and Kcs are related to geometry and the types of loading

D/d = 18/12 = 1.5 r/d = 1.2/12 = 1/10 = 0.1
Figure 3-9 (b) Kc ≈ 1.67

Figure 3-9 (c)
Kcs ≈ 1.42 (Data are highly nonlinear, and the curve for D/d=1.5 should be very close to that for D/d = 2)
(b) Notch sensitivity q is related to materials and types of loading
(1) For the cast iron, q = 0.2
Therefore, | Kf = 1 + 0.2(1.68 – 1) = 1.14
and | Kfs = 1 + 0.2(1.42 – 1) = 1.08
(2) For the drawn steel whose Sut = 700 MPa,

For bending, in Figure 3-10, r = 1.2 mm, use the curve for Su = 689 MPa q ≈ 0.77
Kf = 1 + 0.77*(1.68 – 1) = 1.524

For torsion, in Figure 3-10, r = 1.2 mm, do interpolation between the curves for Su = 552 and 827 MPa
q ≈ 0.82
Kfs = 1 + 0.82(1.42 – 1) = 1.34

Chapter summary. This chapter introduces the concepts of variable loading and fatigue failure as a result of variable loading. Stress amplitude and midrange are defined. Fatigue strength vs. fatigue life, or the S-N curve, is introduced. The low-cycle fatigue life, high-cycle fatigue life, and infinite life are explained. Several fatigue related items are also defined, which are the fatigue strength and endurance limit of a material, the fatigue strength and endurance limit of an engineering component, between them are modification factors involved in the latter. Goodman’s line is defined and used as a portion of the safe design border guarding against fatigue failure, while the yield line is implemented for the other part of the safe design border against yield under a heavy static load peek. The application of the Goodman line for shaft design will be introduced in the next chapter.

References
Hamrock, B., Jacobson, B., and Schmid, S., 2005, “Fundamentals of Machine Elements,” McGraw Hills. Shigley, J. and Mischke, C., 1989, 2001, “Mechanical Engineering Design,” McGraw Hills.
Reley, W., Sturges, L., and Morris, D., 1999, “Mechanics of Materials,” Willey.

Media: VariableLoading, A-MPlot are on U-Tube. 315 students should watch these short movies before the class.
