ChristopherLuey/315-MechanicalDesign/Ebook/eBook/Chapter4Shafts.pdf

Chapter 4 | Shafts and Shaft Design
4-1 | Introduction to shafts

A shaft is a machine element that supports power-transmission elements, such as gears, couplings, and pulleys. It usually has several cylindrical segments of different circular cross sections. The shaft is a general term for this kind of parts. Shafts can be classified in detail based on their shapes and functions, Figure 4-1. In Mechanics of Materials we often see beams. A beam there may be a shaft here.

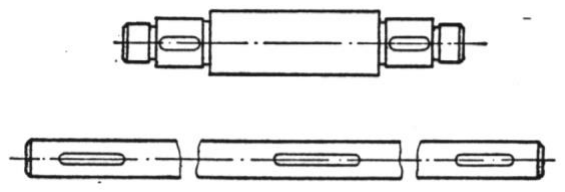
[picture p67: figure]

(a)

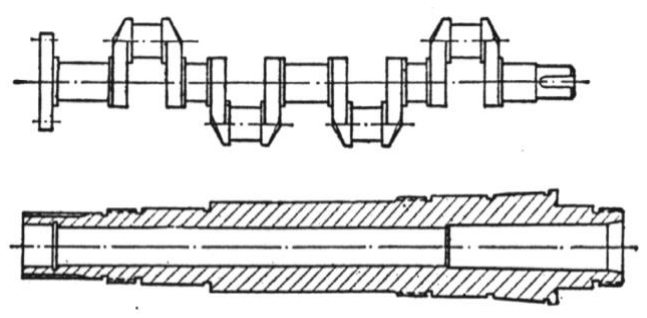
[picture p68: figure]

(b)

(c)

(d)

Figure 4-1. Classification of shafts based on geometry. (a) Straight and solid shafts, (b) a crank shaft, and (c) a hollow shaft. Note that the keys in (a) are shown in the same view for clarity and simplicity. Actually they should be in different circumferential positions, as shown in (d), which is our worm gear shaft in Chapter 1.

Figure 4-1 shows three types of shafts. Their differences are in their shapes, which also mean their functions. The shafts shown in Figure 4-1 (a) are solid straight shafts. These types of shafts are very commonly used. We see them nearly everywhere and in every machine. The one shown in (b) is a crankshaft, not a straight shaft. We have this type of shafts in our cars, in the internal combustion engines. Such a crankshaft is used to convert the reciprocating motion of pistons into a rotating motion to run wheels. The shaft in (c) is a hollow shaft. This kind of shafts is often seen in machine tools. Why do we want to make a shaft hollow? Can we explain, based on mechanics and applications, the advantages of making a shaft hollow if the same material and the same volume of the material are used?

Think about the bending and torsional shear stress distributions. Where do we see the maximum stresses? Where do we see zero stresses? How about transverse shear? Is the transverse shear stress important to a shaft? See Figure 4-2 for the plots of stress distributions, and try to answer these questions.

sbs = (32Mmax)/(pd

3)

tts = (16T)/(pd

3)

x

F
T

T

x

Figure 4-2. Bending and torsional shear stress distributions.

Based on functions we can tell a shaft from an axle. Figure 4-3 shows a shaft and an axle, both are used to support the rotating gears, and the characteristics of their bending and torsional stresses marked by the red dots at the shaft surfaces. The shafts look similar except one thing, one rotates but the other does not. The rotating one is a shaft while the non-rotating one is an axle. Can you see their differences in mechanics?

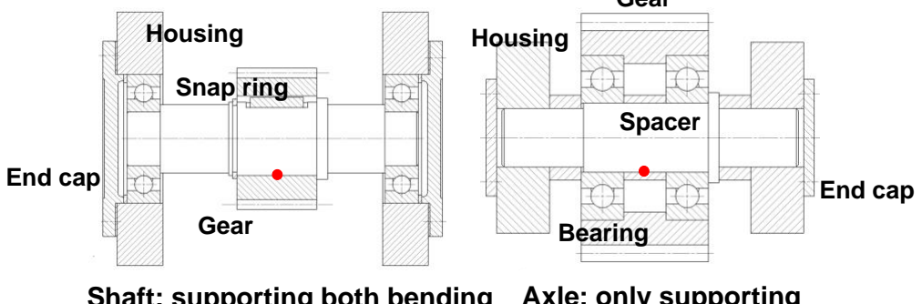
[picture p69: figure]
Housing; Gear; Bearing; Spacer; End cap End cap; Snap ring

x

t

tmax

smax

x

t

smax

t = 0

Axle: only supporting
bending moments

Shaft: supporting both bending moments and torques

F

R2 | R1

T/2

T

F

R2 | R1

Gear

Figure 4-3 Shaft and axle. Note that end-cap bolts are not shown here in the structure drawings.

Whether a shaft is rotating or not makes a great difference. Simply look at the red dot at the surface of the shaft, or the axle. In Figure 4-3, the shear stress due to torsion along the shaft is not a function of time if the torque is constant, but the normal stress due to bending is a function of time. The shaft, in general, is under a combined action of torque and bending moment, and the bending stress is cyclic due to rotation, while the axle is only under bending, and the bending stress is largely static.

The structural design makes one a shaft and the other an axle although they do the same thing. The rolling element bearings are the interface between the rotating parts, such as the gear, and the stationary parts, such as the housing. In Figure 4-3, the axle is fixed into the housing (or a frame), while the shaft is connected to the housing though bearings.

The objective of this chapter is to learn how to design shafts – design the structure of a shaft, and conduct analyses of the stresses, strength, and life. The structure of a shaft looks very simple. It seems that we only need to consider the lengths and diameters (shoulders) of shaft segments. Yes, but it is not very easy to do all properly.

4-2 Shaft design procedure

Let’s recall the shaft we saw before, which is now in Figure 4-4. Shaft design should be conducted hand-in-hand with the design and selection of the elements in the shaft system; otherwise we cannot decide the shape of the shaft.

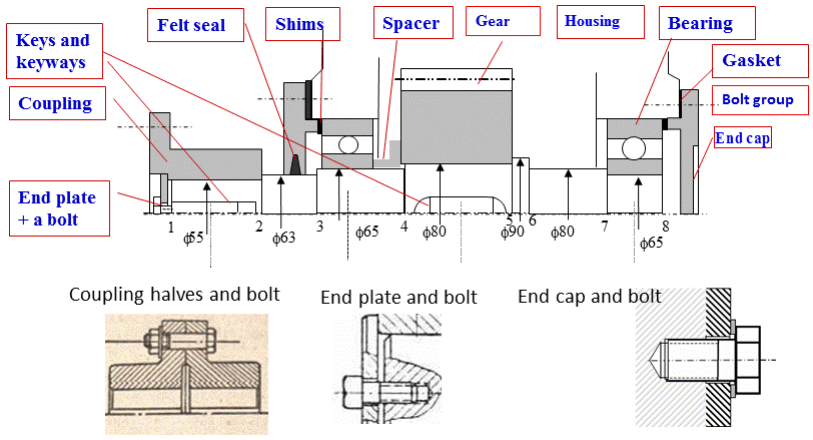
[picture p70: figure]

Figure 4-4 Shaft and the elements on the shaft. Dark areas mean cross-sectional cuts. The coupling, end-plate and end cap assemblies are enlarged separately for clarity. Note again, the two keyways are shown in the same view for clarity and simplicity.

The design analysis should be in the following major steps; and generally, iteration is needed.
1 Determine the minimum diameter of the shaft, which is the diameter of the thinnest shaft segment, usually at the ends of the shaft;
2 | Design the structure of the shaft system: the assembly, and then the shaft;
3 | Make the mechanics model for the shaft, and analyze the strength and stiffness of
the shaft;
4 Conduct design modifications.

We may be given several conditions or parameters, but these are far from sufficient for the entire shaft design. We have to make decisions on the shaft shape design and do some selections. The minimum diameter is where we start. Even though design is an open-ended problem, we have to start from somewhere and stop somewhere. These four steps are discussed in the following.

1. Minimum diameter, dmin, of a shaft.

1-A. We need to select a material that is suitable for making a shaft. Let’s try to use a ductile material because shafts are usually under cyclic stresses, and ductile materials have high fatigue strength and high endurance limit. Steels are commonly used for making industrial shafts, and we will focus our work on steel shafts.

1-B. Let’s determine a possible minimum diameter of the shaft first. Can we directly calculate the shaft diameter for each segment using Equation (3-11-2’)? No. Why not? Think about the stress-concentration factors and strength modification parameters; some of them are related to the shaft diameter. We have to know the diameter to get to this equation. However, at the beginning, we know nothing.

Let’s try to find a diameter only by considering the torsional shear stress due to the torque on the shaft. This may be at the coupling place where the shaft segment is only subjected to torsional loading, see the left end of Figure 4-4. Here, the allowable stress is the shear yield strength modified by a factor of safety (known from the design requirement or a selected value larger than 1.1). In Equation (4-1), the distortion energy theory is used for the shear yield strength, See Chapter 2.

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
16T | 0.577

3

= | ≤ t = | =
p

t
(4-1)

From Equation (4-1), we can find a possible minimum shaft diameter

3 min

16

all

T
d
pt

≥
(4-2)

1-C We have to consider other things. If there is a keyway, we should increase dmin by 3-5%. Use integers, or preferred numbers. Something like 12.71 mm is not a good choice; we can conveniently choose 14 mm, or even 15 mm. The minimum diameter to be used for the shaft is the larger one of the following two: 1) the value from Equation (4-2) after considering the keyway effect and rounding up to a preferred number, and 2) the value determined by a given structural requirement, for example, the match of the other half of the coupling. Note again, dmin may be the diameter of the shaft segment where only a torque applies, or wherever the thinnest.

### 2 Structure of a shaft system: shaft assembly

The only way to know the shape of a shaft is to have all elements on the shaft ready. However, that is impossible at the beginning of a design process. We must start from the minimum diameter and create the first draft of the assembly design. The word “draft” only means that the design has not been finalized yet. It does not mean a rough work. In the structural design we should design or select all elements on the shaft, and make sure that all elements have secured positions on the shaft, and that all forces are transmitted to the housing. Like grounding in an electrical circuit, we need to “ground” forces.

Figure 4-5 shows such a shaft assembly. Note, only the portion necessary for the shaft design is shown. From the basic knowledge of a shaft system and the minimum diameter, we have some idea about what to do: some transmission elements, a couple of bearings, etc. First, we locate these elements on the shaft. Then we decide the major dimensions: lengths and shoulders. With these dimensions we can do force and stress analyses for the strength (stiffness) of the shaft. We can then go ahead and complete the structural design if we are happy with the strength (all factors of safety are larger than 1, preferred at least 1.1). Two completed designs are shown in Figure 4-5.

Here, the bearings are tapered roller bearings that can support both normal (radial) and axial (thrust) loads. A coupling is used as the output element, which only transmits torque. The gear here is a helical gear that transmits forces of all three directions (of course a torque, which is from the tangential force on the gear teeth).

On the shaft we have an end plate with a bolt to mount the coupling and of course the coupling, two end caps, two tapered roller bearings, a spacer, two keys, and a helical gear. Five different shaft shoulders are designed as follows: shoulder No. 1 for positioning the coupling, shoulder No. 2 for quality difference and structural needs, shoulder No. 3 for strength and structural considerations, shoulder No. 4 for positioning the helical gear, and shoulder No. 5 for positioning the bearing. Check if the forces are transmitted to the housing. Also check if all elements are securely located on the shaft and can rotate with the shaft.

The alternative design, which is the lower one in Figure 4-5, looks similar, and only the location of the shoulder to place the gear is different. As a result, this design uses two spacers, a short one and a long one. Can you compare the two and see the advantages and disadvantages of each design? They are both usable, but which one is more reasonable in terms of machining, assembly, operation, and maintenance?

In the assembly drawing, we need to label all parts, as shown, is a neat and ordered sequence, also list them in the part table bottom up. No need to label shoulders, which are shown here for the purpose of understanding. No part dimensions are needed here, but the overall size and assembly dimensions should be given, such as that total length from the end cover to the end of the coupling, fits of between a shaft segment and a hole (a bearing or a gear). Dimensions are not included in Figure 4-5 for clarity of the structure design discussion, but we will practice these in our CAD work.

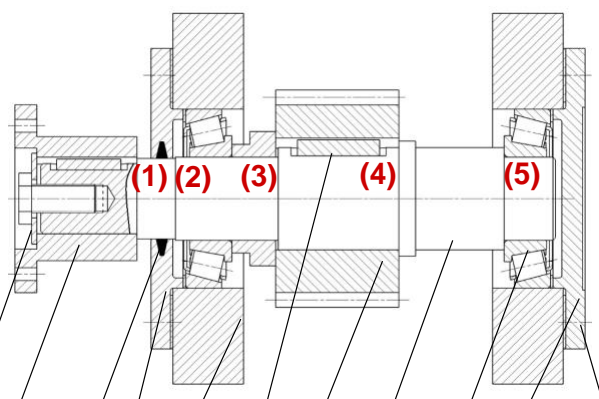
[picture p71: figure]

### Shaft shoulders

1 | 2 | 3 4 5 | 6 7 | 8 | 9 10 | 11

1 Plate + a bolt

3 Seal

4 End cap 1

2 Coupling

5 Housing

6 Key

7 Gear

8 Shaft

9 Rolling bearing (2)

10 End cap 2

11 Bolts (6)

(1) Coupling positioning
(2) Quality difference
(3) Strength and structural needs
(4) Gear positioning
(5) Bearing positioning

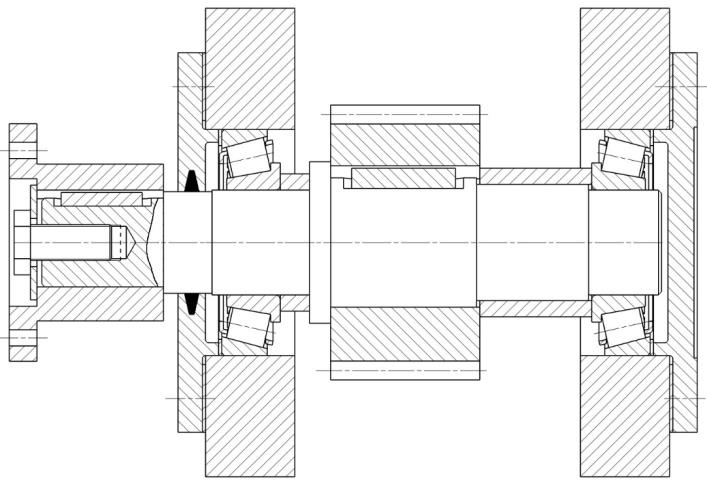
[picture p72: figure]

An alternative design

Figure 4-5 Shaft structural design.

3 Strength (stiffness) analyses: Factors of safety against fatigue and yield failure.

If the structure design is sketched, there is no problem for us to develop a mechanical model for force and stress analyses. Be sure the mechanics analysis is done right and forces are correctly located on the shaft. Here is a list of things for the strength analysis, a shortened list from that in Chapter 3.

A. Free-body diagram
B. Force analyses, bearing reactions
C. Stress analysis (bending, torsional, axial, shear, etc) to obtain the stress medium and amplitude.
D. Principal stresses (maybe not necessary)
E. Von Mises stress
F. The Goodman line, yield, and factors of safety.

### 4 Design modifications: Iteration

No one can guarantee that a design is made right in one trial. Some iteration is needed to make the design more reasonable, and sometimes, optimal. If the factors of safety are too small (≤1), the design is not acceptable. Improvement should be made by reducing critical stresses and/or increasing material strengths through re-selection. Think about the means to reduce stresses. If the factors of safety are too large (>>1), on the other hand, the design should be acceptable, but the structure is over designed. Improvement should be made for compact design with cost-effective considerations.

We also need to pay attention to stiffness and other structural requirements.

4-3 A design example

Figure 4-6 is a diagram of a gearbox (gear reducer) that has two pair of helical gears. Let’s design the output shaft of the gear reducer with a F. S. ns ≥ 1.3 for infinite life. The torque is T= 960 Nm. The radial and axial loads are Fr = 1840 N and Fa= 715 N. Fatigue stress-concentration factors are Kf = 3 (bending) and Ksf 2.8 (torsion) for the most critical point. AISI 1020 steel is used for the shaft, Sy = 295 MPa, and Sut = 395 MPa. Due to the assembly of a coupling, the diameter of the output end of the shaft cannot be smaller than 55 mm.

Solution and design

Step 1.Minimum shaft diameter based on the torque.

The possible minimum shaft diameter is at the coupling end. From Equations (4-1) and (4-2)

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
all | 131
1.3
16 | 0.577 | 0.577(295)

3

= | ≤ t = | = | = | =
p

t

mm

T
d

all

33.4
(131)(10 )
16 | 16(960)
3
6
3 min ≥ | = | =
pt | p

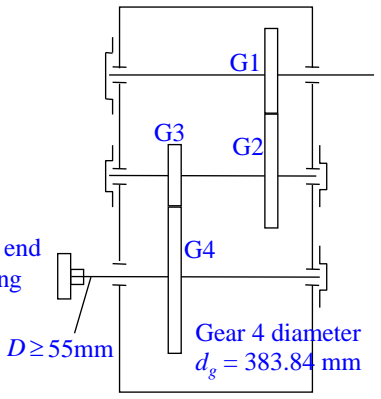
[picture p73: figure]
Gear 4 diameter dg = 383.84 mm

Output end
Coupling

Figure 4-6 A gearbox.

There is a keyway for the coupling connection in this segment of the shaft. Therefore, we should enlarge dmin by about 3~5 %.

However, the structural requirement for dmin is 55 mm. We have to choose the larger one of them as the minimum diameter, dmin, of the shaft. There fore dmin is 55 mm.

Step 2 Structure design

The gear has to be assembled on the shaft. This time we simply use ball bearings. We have already gotten some experience now. A draft of the design is shown in Figure 4-7. Here, the axial positions of the elements should be secured. Shoulders, lengths and diameters with fits should be determined.

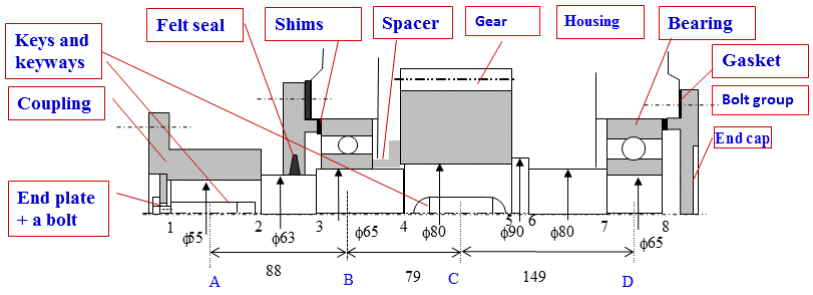
[picture p74: figure]

Figure 4-7 Shaft assembly for the example problem. A, B, C, and D mark the load-application locations, which are at the centers of the coupling, the bearings, and the gear, distances AB, BC, and CD are needed for the corresponding mechanics model, which is like a free-body diagram (FBD).

Step 3 Design analysis

In order to ensure that the designed shaft is sufficiently strong (and stiff), we need to conduct strength (and stiffness) analyses. We can construct a mechanical model for the shaft, or the FBD with the shaft dimensions. In this model, we need to have several critical dimensions: the distances between forces (for force positions), lengths of shaft segments and diameters (for the most critical cross section and its location).

Steps A and B of the analyses: free-body diagram and force analyses

Figure 4-8 plots the forces on the helical gear, from which we get the forces on the shaft, 3D. It also plots the bending moment diagrams in the x-y and x-z planes.

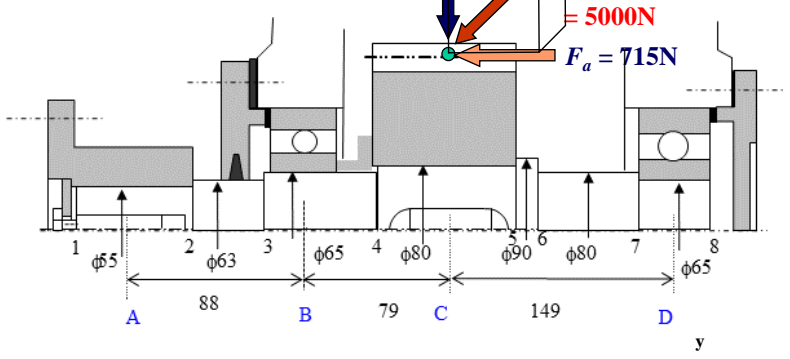
[picture p75: figure]

Bx =715N

By=1804N

T

Fa

Bz =3268N | Dz =1732N | Dy =36N x
T=960N Nm
| B D
| Fa = 715N | z
| Ft = 5000N

M Fr = 1840N zc =Fa
(dg
/2)

B

B

C

C D

C D

x-y plane

x-z plane

Mz

-My

Mzmax= By

(0.079) = 1804(0.079) =143 Nm

-Mymax= Bz

(0.079) = 3268(0.079) =258 Nm

Ft =T/(dg
/2)
Fr = 1840N

### Force at the middle of the width of each element

=960/(0.38384/2)

=715(0.38384/2) = 137.2N

Figure 4-8 Mechanical model (FBD) for the shaft of the example problem, as well as moment diagrams. Note that for this system, the forces are assigned at the middle of each loading element.

Step C of the analyses | Stress analyses
Stresses to be considered are the following
Plane | Force/moment | Stress
x-y | Fr | Bending stress, transverse shear stress
| Mzc | Bending stress
| Fa | Compression stress
x-z | Ft | Bending stress, transverse shear stress
y-z | T | Torsional shear stress

Here, Fr and Ft can be combined to one force, which is the normal force to gear teeth, to be studied in Chapter 5.

Let's look at the cross section at C, which is likely a critical cross section. If it is, then any surface point of this cross section is the most critical point because the shaft rotates although the loads are stationary.

Combined maximum bending moment at C is:

max | max
2 | 2 | 2 | 2 M | M | M
c | z | y
= | + | = | + − | = 143 | ( 258) | 295Nm

Bending stress on the surface is

3 | 3
32 | 32(295) | 5.87MPa
| (0.08)

c
b

M
d

s
p | p
= | = | =

0
=s ba

0
s ba
is the amplitude of the bending stress before considering stress concentration, shown in Figure 4-9.

s b

0
s ba

t

Figure 4-9 Cyclic bending stress.

The axial force, F
a

, results in a constant compression stress

2 | 2
4 | 4(715) | 0.14MPa
| (0.08)
=

a
axial

m

F
d

s
p p
s
= | = − | = −

The shear stress due to the torque is the following, which is constant if the torque does not vary.

3 | 3
16 | 16(960) | 9.55MPa
| (0.08)

T
d

t
p | p
= | = | =

= tm
The shear force in this cross section is
2 | 2 | 2 | 2 V | B | B c | z | y
= | + | = | + | = 3268 | (1804) | 3733N

The surface shear stress of the neutral plane is

2 | 2

0

4 | 16(3733) 16 | 1.0MPa
3 | 3 | 3 (0.08)

=

c
v

a

V | V
A | d

t
p p

t

= | = | = | = 0

a

t is the amplitude of the shear stress variation before considering stress concentration, similar to that shown in Figure 4-9 but with a 90⁰
phase difference. Try to plot its variation with rotation.

No stress-concentration factor is applied to the midrange stresses.

Steps D - F of the analyses. We can directly use Equation (3-11-2’)

The endurance limit is determined through the use of modification factors as follows.

Se = kfkskrktkmSe’ (Note: lower case of letter k)

Se’ = 0.5 Sut = 0.5 x 395 =197.5 MPa

kf: surface factor
Assuming ground surface:
kf = eSut

f = 1.58 x 395⁻⁰.085 = 0.95

ks: size factor
ks = 1.189d

-0.112 = 1.189 x 80⁻⁰.112 = 0.728

kr: reliability factor
For 99% survival, kr = 0.82

kt: temperature factor
kt = 1 | no special requirement

km: miscellaneous effect
km = 1 | no other special problems
Therefore, | Se = (0.95)(0.728)(0.82)(1)(1) x 197.5 = 112 MPa

The design against fatigue failure is done by means of the Goodman’s line together with the consideration of yield.

Goodman’s line, Equation (3-11-2’)

2 | 2 | 2 | 2 ( | ( | ) | 3( | )

’

) | 3( | )
1/ f | xa | fs xya | xm | xym
s
f s r t m | e | ut

k k k k k S

K | K
n
S
s | t + | s | t +
+ | =
2 | 2 | 2 | 2 ( | (0.14) | 3(9.55)

8

3*5.87) | 3(2.8*1.01
2)(1)(1)1 7. 9(0.95)(0.728)(0. | 5

1/
5

)
39 | s n
+ | +
+ | =
18.27 16.54 | 1
112 | 395 | s n
+ | =

Therefore, ns = 4.88 > 1.3, which is the safety factor for infinite life without fatigue. If ignoring 0.14MPa s axial =−
and

1.0MPa v

t =
, we gat ns = 5.02. Therefore, these two stress components can be ignored in the analysis, just simply allowing a slightly larger factor of safety.

We need to check if yield would happen at the peak stress. To do so, we should calculate the peak von Mises stress without considering stress concentration factors.

0 | 2 | 0 2 ( | ) | 3( | ) s | s | s | t t VM | ba | bm | m | a = | + | + | + 2 | 2 ≈ | + × 5.87 | 3 9.55

= 17.55 MPa
295 16.8
17.55

y
s
VM

S
n
s
= | = | =
>> 1.3,

It is safe, and the design is accepatble. However, the factors of safety are very large. The shaft is over designed; and for this case, it was due to choice of dmin much larger than needed by the strength consideration.

The result is plotted in Figure 4-10.

Figure 4-10 Strength lines and the working stress.

Step 4 Design modification

This is an example of an over-designed shaft due to a geometric constraint. Modifications should be conducted, such as choosing a less expensive material to lower the cost, or increasing the intensity of the loads to achieve higher power density.

Chapter summary
This is the first chapter for machine elements; it introduces the concept of shafts, shaft classification, and the shaft design process. Minimum diameter determination, structural design, design analyses, and design modifications are discussed.

References
Hamrock, B., Jacobson, B., and Schmid, S., 2005, “Fundamentals of Machine Elements,” McGraw Hills.
Shigley, J. and Mischke, C., 1989, “Mechanical Engineering Design,” McGraw Hills.
Pu, L., Chen, D., and Wu, L., 2013, Machine Design, China Higher Education Press.
Media: | 315 students should watch the short movies before the class.

s’a

112MPa

295MPa

(16.54, 17.61)MPa | 295MPa | 395MPa

Yield line

Goodman line

s’m
