ChristopherLuey/315-MechanicalDesign/Ebook/eBook/Chapter5-Transmission Gears New.pdf

Chapter 5 | Transmission Elements
5-1 | What are transmission elements

Transmission elements transmit force and motion from one shaft to another through contact and relative motion. Gears, belts, chains, and pulleys, etc., are all transmission elements. Gears are rigid elements for short-distance, high power density transmissions, while belts and chains are flexible elements for long-distance power transmissions. We have seen one of the simplest transmissions, a gear reducer, in Chapter 1. The pre-class short video showed another one; here it is again, but in the form of a mechanism diagram, in Figure 5-1, with a belt-pulley set that delivers power from an electric motor to the reducer. The arrows point to the transmission elements, which are four gears and a belt-pulley set. In this chapter, we will learn most of these elements. However, our focus will be on gears due to the time constraint.

Figure 5-1. Two-stage gear reducer with an input belt-pulley set connected to an electrical motor.

5-2 Concepts of flexible transmission elements

Two types of commonly seen flexible transmission elements are belts and chains. They are excellent for long-distance power transmission and permit flexible and convenient shaft position adjustment. They are also simple in structure and convenient for maintenance.

Belts and belt drives

There are several types of belt drives, classified based on the shapes of belts, such as the flat belt, V-belt, and timing belt. Figure 5-2 shows a typical flat-belt drive, which consists of a belt and two pulleys. One of the pulleys is the input pulley, or the driver, rotated by an input shaft, such as that of a motor. The other is the output pulley, or the driven, powered by the belt. Guess what the driving force is? Friction! Therefore, belt drives are also called traction drives.

Friction is related to the friction coefficient at the interface formed by the surfaces of the belt-pulley pair and to the stretching tension that produces the normal force between the surfaces of the pulley and the belt in contact. It is also related to the angle that the belt wraps over the pulley, or the wrap angle, because the wrap area corresponding to the wrap angle is the nominal contact area. When a belt drive works, its belt is stretched more at one side than at the other. That is why we usually see a slack side (or the loose side, with a lower tension). The other side is the tight side (with a higher tension). Where should we place the slack side in a belt drive design? Should it be at the upper side or the lower side? The upper side should be a good choice for the slack side because it can help increase the wrap angle, which is good for friction enhancement.

The velocity ratio, i12, is defined as the ratio of the angular speed of pulleys 1 and 2, as shown by Equation (5-1). Note that the pulley surface speeds and the belt speed are nominally the same although the belt creeps on the pulley surfaces.

1

2

2

1

2

1
12 | D

D
n

n
i = | = | =
ω

ω
(5-1)

The length of a belt is purely a geometry issue. Equation (5-2) takes care of the length calculation.

÷
ø

ö
ç
è
æ | +
= | + | − | + | + | + | −

−
c
D | D
L | c | D | D | D | D | D | D
2
( | )
( | )sin
180
( | )
2
(2 ) | ( | )
1 | 2 | 1
2 | 1 | 2 | 1

2
2 | 1
2 | π | π
(5-2)

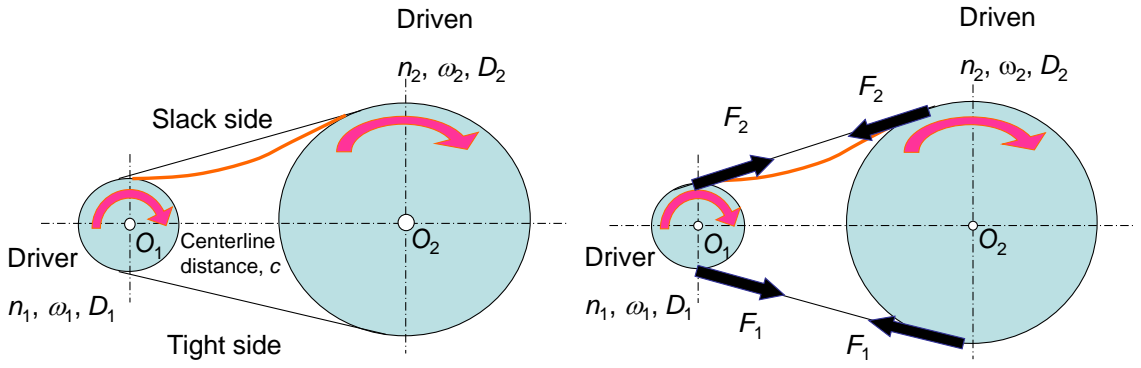
[picture p76: figure]
Tight side; Slack side; Driver; Centerline distance, c; Driven

Figure 5-2. A typical flat belt drive. | Figure 5-3. Tensions in a belt.

Figure 5-3 shows the tensions in a belt, F1 and F2, where F1 = F2 + friction. Clearly, we have F1 > F2. The torque transmitted, T, is

T = (F1 − F2

)D/ 2

(5-3)

The power transmitted, h, is

h = (F1 − F2

)u
(5-4)

Here, u is the speed of the belt, which is again normally the same as the speed of the pulley surfaces.

The relationship between the two tensions when they reach the maximum without belt slip, if the centrifugal force is neglected, can be expressed as follows using the static friction coefficient, µs, and the wrap angle, θ. The static friction is the largest friction that the belt-pulley interface can take without belt slip.

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
If the centrifugal force is considered as mv² , with m as the belt mass per unit length and u the belt speed, the above becomes,

µs

θ
e
F mu

F mu
=
−

−

2
2

2
1

For the belt segment getting into and leaving the contact region (the wrap angle), the tensions

can be related to initial tension

Fi
as

F1 = Fi + ΔF
and

F2 = Fi − ΔF
, leading to
2

F1 F2 Fi
+
= | .

The lower limit of F2 is zero, and then the limit for the tight side tension is,

F1 = 2Fi
. The only
way to increase the load capacity is to increase the initial tension.

Belt drives have many advantages. The very elastic belt element makes the transmission noise level low. We mentioned the long-distance power transmission and the flexibility in shaft position adjustment. The belt arrangement is also very flexible. Figure 5-4 shows two possible belt arrangements. In one arrangement the shafts rotate in the same direction (Figure 5-4, left), but in the other, they rotate oppositely (Figure 5-4, right).

Figure 5-4 Two belt arrangements, left, the pulley speeds are the same, right, the pulley speeds are opposite.

However, there are some disadvantages here too. 1) Elastic creep is inevitable due to the tension difference, which is intrinsic in belt drives. 2) An initial tension is needed, and the tension should be maintained. 3) The belt may slip over the pulley surfaces. 4) Creep and slip make the transmission ratio slightly vary. 5) The belt may completely slip over its pulleys when it is overloaded. Actually, the last point is not a bad thing. Belt slip is a natural over-load protection to the machine powered by the belt drive; it prevents failure in one stage of the machine to propagate to the next one.

The V-belt drive is an improved version of the flat-belt drive. It is also a traction drive; however, the belt has a V (trapezoidal) cross-section, and the V-belt drive uses a grooved pulley, or a sheave. This V shape makes the belt-pulley contact occur on inclined surfaces, or the wedged surfaces, as shown in Figure 5-5, which greatly increases the friction at the belt-pulley interface due to much higher normal forces there. The wedge increases traction; however, belt bending in a V-belt drive is more severe than that in a flat-belt drive due to the increased belt thickness. A larger sheave is preferred for a smaller belt-bending effect on strength.

Figure 5-5 Comparison of the normal force per unit length of the belt, ΔN, on a V-belt with that on a flat belt.

The V-belt drive also needs an initial tension, but it does not require frequent tension adjustment because its belt usually has fiberglass-reinforced neoprene cores that can well maintain the tension.

The timing belt is actually a toothed drive, as shown in Figure 5-6, left. It is also called the synchronous belt drive. It uses toothed wheels, or sprockets. No slippage occurs, and a constant velocity ratio is guaranteed. In addition, no initial tension is needed.

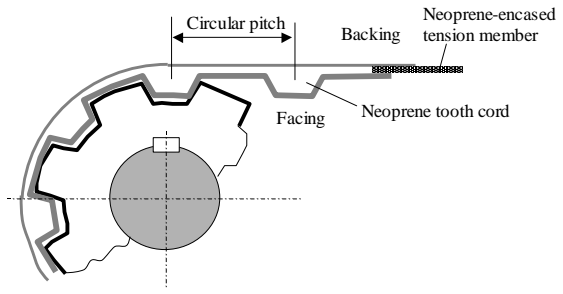
[picture p77: figure]
Circular pitch; Facing; Backing; Neoprene-encased tension member; Neoprene tooth cord

Figure 5-6 A timing belt drive (left) and a chain drive (right).

Chain drives

We see chain drives very often; they are on our bicycles! A chain drive uses toothed wheels, or sprockets, Figure 5-6, right. There is no slippage of the chain on the sprocket, and a constant velocity ratio is guaranteed. Likewise, no initial tension is needed. Because chains are usually constructed with metal pieces, a long service life is expected. However, the noise level in a chain drive may be higher than that in a belt drive. Why?

2β=36⁰

ΔN

ΔN/sinβ

ΔN

Flat belt

Pitch

5-3 Gears
Gears are named for a family of toothed elements, usually made of metallic materials of great strengths, but nylon, polymer gears are increasingly used in many applications. Transmission is accomplished through contact of one or more teeth of one gear directly with those of another. They are used for secured power transmissions with accurate transmission ratios. Based on the meshing types, gears can be classified into external gears, internal gears, and gear-rack systems, as shown in Figure 5-7. Gears can also be classified as spur gears, helical gears, worm gears, and bevel gears based on tooth shapes, as shown in Figure 5-8. These figures also show the corresponding mechanical symbols for each of the gear pairs and the feature of gear meshes.

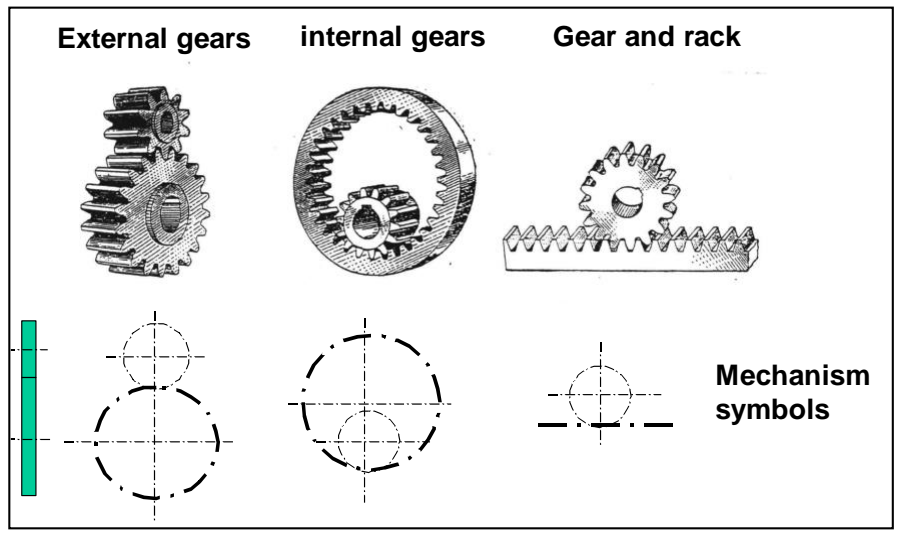
[picture p78: figure]
External gears; internal gears; Gear and rack; Mechanism symbols

Figure 5-7 | Classification of gears based on the mesh type.

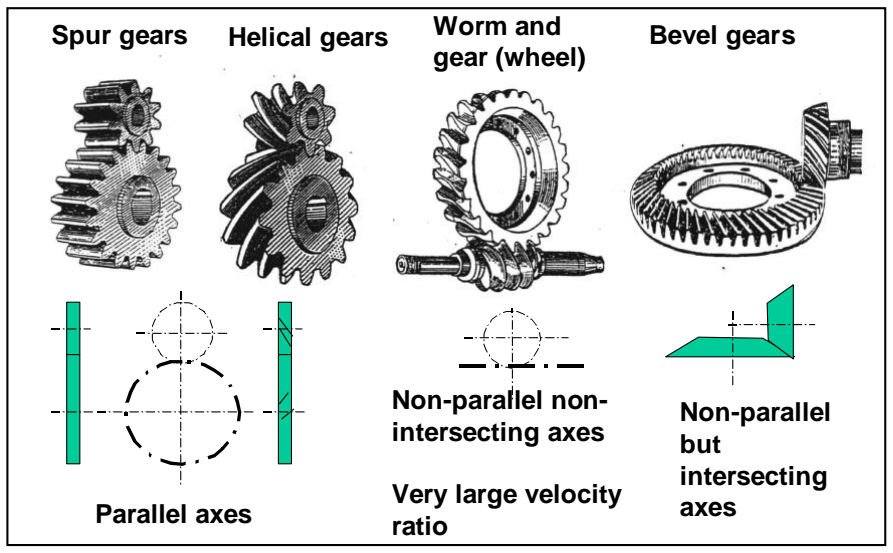
[picture p79: figure]
Spur gears; Helical gears; Worm and; gear (wheel); Bevel gears; Non-parallel but intersecting axes; Non-parallel non- intersecting axes; Very large velocity ratio Parallel axes

Figure 5-8 | Classification of gears based on tooth shape.

The axes of a spur-gear pair and a helical-gear pair are parallel, while those of a worm-gear pair and a bevel-gear pair are generally perpendicular. The axes of a worm-gear pair do not intersect, but those of a bevel-gear pair intersect.

Let’s first look at the overall geometry of gear teeth and that of a pair of gears. Figure 5-9 shows a couple of gear teeth and terminologies that define the teeth. We will come back to this later when we know why the teeth are created this way. One item that is very important to know now is the gear pitch circle, the red dash-dot line in the figure below. The gear ratio, or speed ratio, is defined based on the speeds of the pitch circles of two meshing gears.

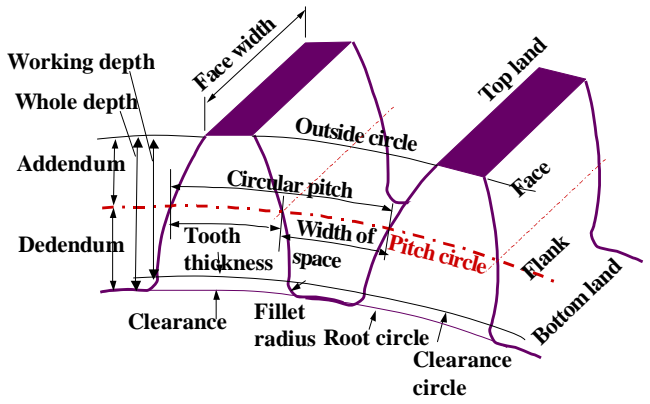
[picture p80: figure]
Face width; Addendum; Dedendum; Outside circle; Circular pitch; Pitch circle; Face; Flank Bottom land; Clearance; Clearance circle; Root circle; Fillet radius; Tooth thickness; Width of space; Whole depth; Working depth; Top land

Figure 5-9 Gear tooth geometry.

Figure 5-10 shows two gears in a meshing process. The driver is usually the smaller one, called the pinion. Subscript p means the pinion, and subscript g means the gear. Locations of the gear and the pinion are determined by the centerline distance, cd, which is the sum of the pitch radii of the two gears. The pitch-circle radius is defined by the number of teeth, N, times module m for a metric gear or by the number of teeth, N, divided by diametrical pitch P for a US custom gear, as

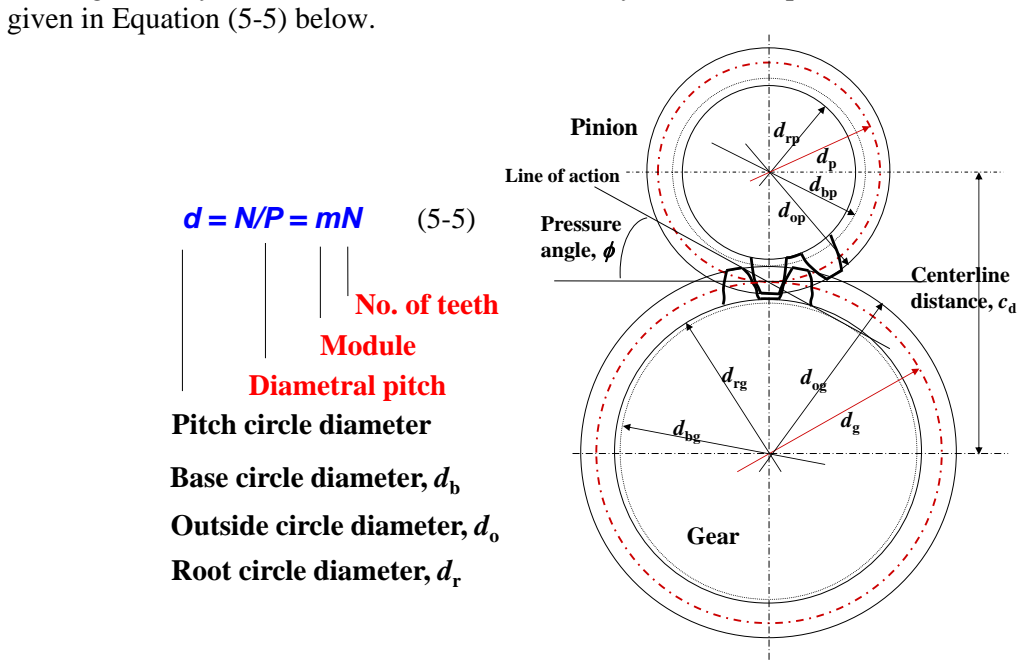
[picture p81: figure]
given in Equation (5-5) below.; No. of teeth Module; Diametral pitch; Pressure; angle, f; Centerline; distance, cd; dbp; drp; dop; dog drg; dbg; Pinion; Gear; Line of action; Pitch circle diameter; Base circle diameter, db; Outside circle diameter, do; Root circle diameter, dr

Figure 5-10 A pair of gears in meshing and diameters of circles.

5-4 Simple gear trains

Gear trains with fixed axes. A gear train contains multiple gears in a certain arrangement and is used to achieve a desired angular velocity change between the input and output shaft. We have already had some knowledge of gear trains, like the one shown below in Figure 5-11. This time we opened the cover and exposed the components inside.

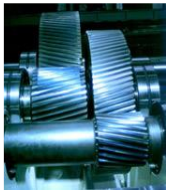
[picture p82: figure]

Figure 5-11 Gear train in a gear reducer (Courtesy of Chicago Gears).

Gears in a gear train may be a set of external gears, as shown in Figure 5-12 (a), or may be an external and an internal gear, namely an internal gear pair, as shown in Figure 5-12 (b). A gear train may have more than one gear pair, as shown by the three gears in Figure 5-12 (c) plotted with gear symbols and their center lines.

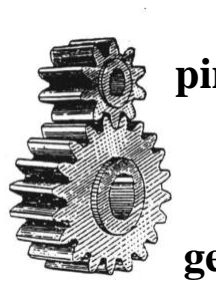
[picture p83: figure]

(a) (b)

(c)

Figure 5-12. External (a), internal (b), and multiple gear pairs (c) in gear trains.

### pinion

### gear

Gear 1

Gear 2

The gear ratio, or the train value, is the ratio of the rotation speeds of the gears in a set, which are actually determined by the diameters of the gears involved. By means of Equation (5-5), the train value becomes the ratio of the numbers of teeth.

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
pg | N

N
mN

mN
d

d
n

n
i = ± | = ± | = | = | =
ω

ω
(5-6)

We have to specify the direction of rotation of each gear. Two external gears rotate oppositely, therefore,

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
(5-7)

Here, we use 1 and 2 for two gears, sometimes, we also use “i” and “o” for input and output, or “p” and “g” for the pinion and gear. For an internal gear set, the two gears rotate in the same direction, and the gear ratio is given below.

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
= | = | =
ω

ω
(5-8)

In general, the ratio of the speed of an input (or driver) gear (subscript i) to that of an output (or driven) gear (subscript o) is given by Equation (5-9), assuming that all the gears have the same module (The same module? we will look into this issue later in this chapter).

(5-9)

Let’s determine the train values of each pair of the gears in the trains of the gear reducer in Figure 5-1, replotted in Figure 5-13, knowing that the numbers of teeth are, N1, N2, N3, and N4, and assuming that all gears have the same module. Note that all gears are mounted on their own shafts and rotate together with the shafts.

Equation (5-9) is used and the solution to this problem is shown below in Figure 5-13. We have two external gear sets, so that the direction of the rotation is changed twice. Here, n2 = n3, because these two gears are mounted on the same shaft.

em

o

i = (−1)
ω

ω

Product of No. teeth of driver gears
em: No. of external mesh

ωi or ni: speed of gear i, the driver, the input gear.

ωo or no : speed of gear o, the driven, or the output gear

Product of No. teeth of driven gears

1

2

2

1
12 | N

N
n

n
i = | = − | N1

N2

N3

N4

Gears 1 and 2

Gears 3 and 2 n2
= n3

Gears 3 and 4

3

4

4

3

34 | N N
n

n
i = = −

Gears 1 and 4

1 | 3
2 | 2 | 4
( 1)
N N

N N
−

Product of No. teeth of driven gears Product of No. teeth of driver gears

Bearings | Gears = | = | = | =

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
= (−1)

Figure 5-13. Solutions to the train value of each gear pair and the overall train value of the gear reducer mentioned at the beginning of this chapter.

Example 5-1. More practice. There are four gears in each gear train below, Figure 5-14, and N1 =50, N4 = 40, N2 = 35, and N3 = 25. Gear 1 is the input and gear 4 the output. Determine the output velocity of each gear trains if the input speed is n1 = 1000 rpm (clockwise).

(b) (c)

Bearings

N1 | N2 | N3 | N4

(a)

N1

N2

N3

N4

N4

N1 | N3 N2

Figure 5-14 Example 5-1.

(a) This is a simple train.
1 | 4 1 2 3 | 2 | 3 | 4 3
4 | 2 3 4 | 1 | 2 | 3 | 1

40 ( 1)
50
n | N n n n | N N N
n | n n n | N N N | N
= − | = − | = − | = − | , therefore
4

5
(1000) 1250
4
n | rpm = − | = −

Here, the direction of n4 is opposite to the rotation direction of gear 1. Note that gears 2 and 3 are idlers; they do not change the train value but alter the direction of the output speed.

(b) This is a compound train.
1 | 2 | 4 2
4 | 1 | 3

(35)40 ( 1)
50(25)
n | N N
n | N N
= − | =
, therefore,
4

50(25) (1000) 892.9
35(40)
n | rpm = | =

Here, the rotation direction of n4 is the same as that of gear 1.

(c) Can you try this one? Is there any major difference between b) and c)?

Planetary (Epicyclic) gear trains. Special train values can be obtained if one (or more) of the gear axes can rotate about others. That means a planetary gear train, which may include a sum gear, one or several planet gears, and a planet carriage (or the arm, a, the handle, h) functioning like a carrier, as shown in the figure below. Figure 5-15 shows a simple planetary gear system, which has a sun gear, a planetary gear on a carrier (arm), and a ring gear (an internal gear). The numbers of teeth (Ni) and rotation speeds (ni, or ωi) are all shown in the figure, with index i for the ring gear, planet gear, or the planet gear. If we could have “Jumped” onto the carrier of the system, we should virtually see a gear train of fixed axes. Then we can use the train value formula, Equation (5-9), mentioned before to solve this type of problem, by plugging in relative motions, such as ni- na
, in the analysis, as shown below. Once the speed ratio is written in terms of relative motions, an unknown speed can be solved.

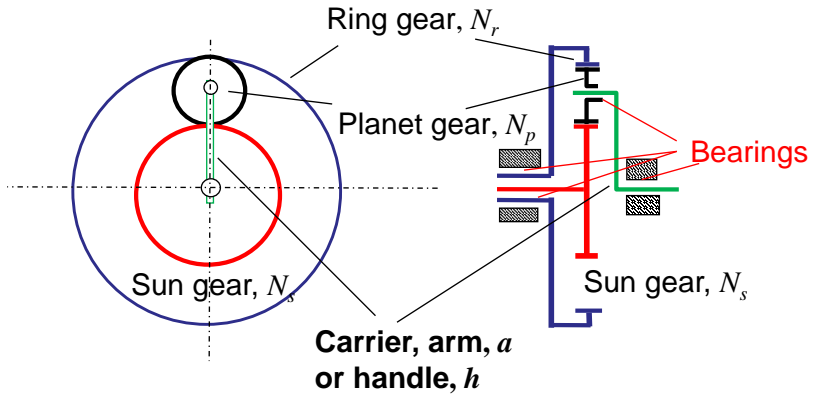
[picture p84: figure]
Ring gear, Nr; Planet gear, Np; Sun gear, Ns; Carrier, arm, a or handle, h; Bearings

Figure 5-15. Simple planetary gear system.

A slight modification of Equation (5-9) leads to Equation (5-10) below. Again, the only extra thing for us to do is to use the relative motions, ni - na, or ωi - ωa and no - na, or ωo - ωa to replace
ωi and ωo. | em
o | a
i | a
io i | = (−1) −

−
=
ω ω
ω ω | Product of No. teeth of driven gears

Product of No. teeth of driver gears
em: No. of external mesh

ωi-ωaor ni-na : relative speed of gear i, the driver, the input gear.

ωo-ωaor no-na: relative speed of gear o, the driven, or the output gear

(5-10)

r

s

p

s

r

em | p
s | a
p | a
p | a
r | a
s | a
r | a
N

N
N

N
N

N
n | n
n | n
n | n
n | n
n | n
n | n
= − | = −
−

−
−

−
=
−

−
( 1)

Example 5-2. In the reducer below, the input shaft, in, is aligned with the output shaft, b. The input gear speed is n2. Given, N2 = 24, N3 = 18, N6 =64. Find the ratio of the output speed to the input speed.

Figure 5-16 Planetary gear system of Example 5-2. Note here in this problem, N6, N3 and N5 are related through the geometry of the sets of N2 - N3 and N6 - N5, by m1 (N3+N2)/2 = m2(N6/2-N5/2), with m1 and m2 the module for the two sets, respectively. For m1 = m2 the result for N5 is 22.

Solution

From

| 5

6

2

1 3

6

2
( 1)
N

N
N

N
n | n
n | n

a

a = −
−

−
, and the fixed ring gear, we have

5

6

2

2 | 3
( 1)
0 | N N
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
Thus,

5

6

2

2 | 3
1 | ( 1)
N

N
N

N
n

n

a

− | = − | 3.18
22

64
24
18 1 | 1

5

6

2

2 | 3
= + | = + | =
N

N
N

N
n

n

a

0.314
3.18

1

2

= =
n

na

Gear train systems in the engineering world. Gear train systems are in every corner of the modern engineering world for high efficiency, high reliability, and high stiffness power transmissions. Typical examples are robot drives, vehicle transmissions, machine tool transmissions, and windmill power delivery (Figure below) systems. Gear transmission systems can also be found in toys, yard tools, dental tools, robots, etc. Again, they are indeed everywhere.

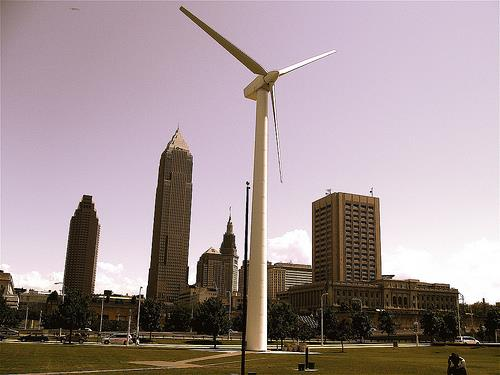
[picture p85: figure]

Figure 5-17. A windmill in Cleveland.

Sun gear Planet gears

Arm

3

2

5

6

a | b
in

5-5 Introduction to the theory of gearing

What is the shape of a gear tooth profile? Usually, it is not a piece of an arc even though it looks like an arc. In most cases, it is a segment of an involute curve. Why is that profile chosen? We need to answer this question from the basic meshing kinematics, or specifically, the theory of gearing.

Conjugate action. Let’s first learn something called the conjugate action, which is the meshing action with a constant angular velocity. Our gear meshing motion should be a conjugate action because the gears should run at constant angular velocities.

Assume that we have two gears, shown in Figure 5-18 below, each with an unknown profile. The two gears are rotating about their own instantaneous centers of rotation, o1 and o2, respectively, with ω1 and ω2. Let’s assume that gear 1 is the driver. The two profiles are in contact at point k at this moment. The velocity of gear 1 at k is v1, and its magnitude is v o k 1 =ω1 1

. The velocity of gear 2 at k is v2, and its magnitude is
v | o k 2 =ω2 | 2

(Equation (5-11)).
Let’s use nn for the common normal of the two profiles at the location when they are in contact. We can draw two line-segments that are each perpendicular to common normal nn, one from o1 and the other from o2. Now we have o1A and o2B.

The velocities projected onto line nn must be the same because the two teeth should not run into each other, nor should they separate.

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
ω1 Gear 1: o1 ω1 | Gear 2: o2 ω2
No separation, no interference ² | 2 | 2 v | k =ω o 1 | 1 1 v | k =ω o

Driver

Figure 5-18. Two gear profiles are in contact at k, and o1 and o2 are their rotation centers.

Again, the definition of contact means that no separation or interference of the surfaces is allowed. Therefore, projections of the velocities along the normal direction should be the same (Equation (5-12)), although some relative sliding along the tangential direction is permitted.

v1 cos (ÐAo1k) = v2 cos (Ð Bo2k) | (5-12)

Substituting Equation (5-11) into (5-12), we have

1 1 | 1 | 2 | 2 | 2 ω | ω o cos( Ao | ) | o cos( Bo | ) k | k | k | k Ð | = | Ð
, or

1 1 | 2 | 2 ω | ω o A | o B =
(5-13)

Here,

1 | 1 | 1 o cos( Ao | ) o A k | k Ð | =
and
2 | 2 | 2 o k | k cos( Bo | ) o B Ð | =
. Now we can take a look at the vertical triangles o1AP and o2BP. Naturally we can derive Equation (5-14) from (5-13).
1 1 | 2 | 2 ω | ω o P | o P =
(5-14)

The ratio of the angular velocities becomes

1 | 2
2 | 1

oP
oP

ω
ω

=
(5-15)

Conjugate profiles. In order to make the ratio, ω1/ω2, a constant, the necessary and sufficient conditions are that P is a fixed point of the centerline, o1o2. Profiles whose common normal at any contact passes through a fixed point of o1o2 (or intersect with o1o2 at a fixed point) should result in constant angular velocities of both. These profiles are the conjugate profiles.

Once P is a fixed point at centerline o1o2, we can define two fundamental sets of circles for gears, see Figure 5-19 below, namely the pitch circles by means of P and the base circles by means of A and B, respectively. Point P is a very important point for gears; it is the pitch point, based on which the following can be defined.

Shown in Figure 5-20 are the pitch-circle radii:
r1 = o1P

(5-16-1)
r2 = o2P

(5-16-2)

And the base-circle radii: rb1 = o1A = r1

cosf
(5-16-3)

rb2 = o2B = r2

cosf
(5-16-4)

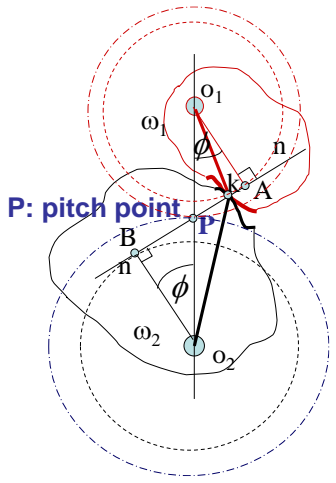
[picture p86: figure]
P: pitch point

Figure 5-19 Pitch point, P, pitch and base circles, and gear centers o1 and o2.

Law of gearing. The derivation above states the law of gearing, which is that the ratio of the angular velocities of the gears should be constant if P is a fixed point on the centerline, i.e.

vp1 = vp2 and vb1 = vb2
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
= | = | =
ω

ω
(5-17)

With the law of gearing and conjugate action in mind, we can picture the mesh of two conjugate profiles through the action of the circles we have defined: the pitch and base circles. Keep in mind that these circles are invisible after gears are made. However, these conceptual circles are the key to the understanding of gear contact and motion, and to gear tooth design as well. The two pitch circles are in “contact” and in a pure-rolling motion. Note that the pure-rolling motion means vp1 = vp2

. The two base circles are not in “contact”, but they are in a pure-rolling motion, too, vb1 = vb2

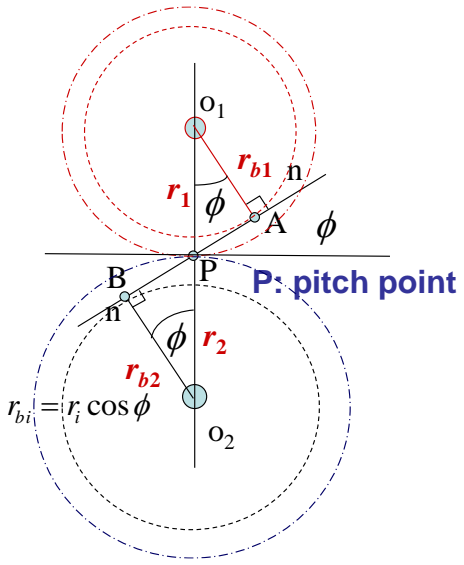
[picture p87: figure]
P: pitch point; rbi = ri; cosf

Figure 5-20 “Contact” and motion of pitch circles and base circles; gear triangles.

Figure 5-20 contains all basic quantities for gearing, which are all in two triangles, Po1A and Po2B, called the gear triangles. These quantities are:
Radii for the base and pitch circles
Key points, P, A, B, o1 and o2.
A very important angle: the pressure angle, f.
A very important line: nn, or AB, which is the common normal of contacting profiles, the base-circle tangent, the line of gear mesh, the line of action, and the line of profile generation. Its use as the common normal has been shown, its other functions will be demonstrated one by one later.

Involute profiles. Now we need to find the profile that satisfies the law of gearing. The involute is one of the curves that meet such a need. It belongs to a family of curves called the roulette curves. Let’s take a disk as the base circle, and a piece of rope as the line of generation, to create an involute curve. We wrap the rope on the surface of the disk, attach a pen at the end of the rope, and then gradually release the rope while keeping it tangent to the disk. The pen draws an involute curve, k0k, shown in Figure 5-21. Here, ki is the pen point, Bi the point of contact, or the point of tangency, between the rope and the base circle. The rope is tangent to the base circle but normal to the involute curve at all the time of the plotting.

0

ki

k0

### Bi B

Rope

Disk

Pen

Figure 5-21 Involute curve generation.

Now we have two such curves generated from two base circles, and let them be in contact at P, or any other point, k’, as shown in Figure 5-22 below. The generation line, BP, or Bk’, belongs to one gear, while the generation line AP, or Ak’, belongs to the other gear. However, they share P or k’ in common, and for P, meaning that AP and BP belong to the same line, or the line of the common normal, AB. Likewise the same is true for k’. On the other hand, these two lines are tangent to their own base circles. Therefore, AB is also the common tangent to both base circles. If the distance of the two base circles is kept fixed, AB as the common tangent is unique to these base circles. It intersects the centerline at a fixed point. Therefore, the common normal of the two involute curves intersects with the centerline at a fixed point. We can now conclude that involute curves are conjugate profiles, and that they satisfy the law of gearing.

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
Figure 5-22 Two involutes in contact. Line AB, the common normal of the involute curves, are also the common tangent of base circles.

Properties of the involute profile. The generation process brings about several very important properties of involute profiles.

(1) Segment Biki on the normal (or the base-circle tangent) equals the arc length Bik0 on the base circle. Biki is the unwrapped length of the rope (Figure 5-21).

0

arc( | ) B k | B k i i | i
=
(5-18)
(2) The normal to an involute is the tangent line to the base circle (Figure 5-21).
(3) Bi and Ai (the latter not shown) are the centers of curvature of the involutes (Figure 5-22). When two involutes are in contact at k’, Bk’ is the radius of curvature of one involute, and likewise, Ak’ is the radius of curvature of the other involute.
(4) No involute is inside the base circle (Figure 5-21).
(5) The lengths of common normal lines between two opposite involutes are equal, or A1B1 = A2B2
(Figure 5-23, left). Can you prove this from what we have learned?
(6) The shape of an involute profile depends on the radius of its base circle, rb

. When rb
approaches infinite, the involute approaches a straight line (Figure 5-23, right). Therefore, racks of straight-line profiles are also gears.

a1

A1

A2

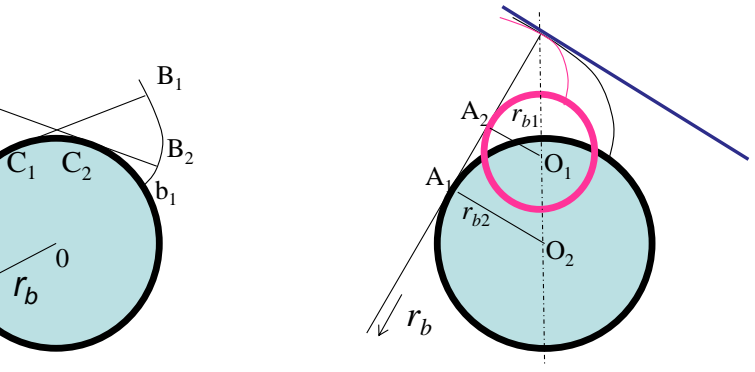
[picture p88: figure]

Equal lengths of lines normal to opposite involutes. Effect of base-circle radius.

Figure 5-23 | Normal lines and influence of base-circle radius on involute curvature.
5-6 | Gear geometry

Although the base circle and the pitch circle of a gear have provided a lot of important geometric information, we still need more parameters to define the shape of a gear and a gear tooth. Let’s first look at the circles. We need to define the outside and root circles. Now we are talking about four circles in total, as shown in Figure 5-24. The tooth geometry is defined in Figure 2-25.

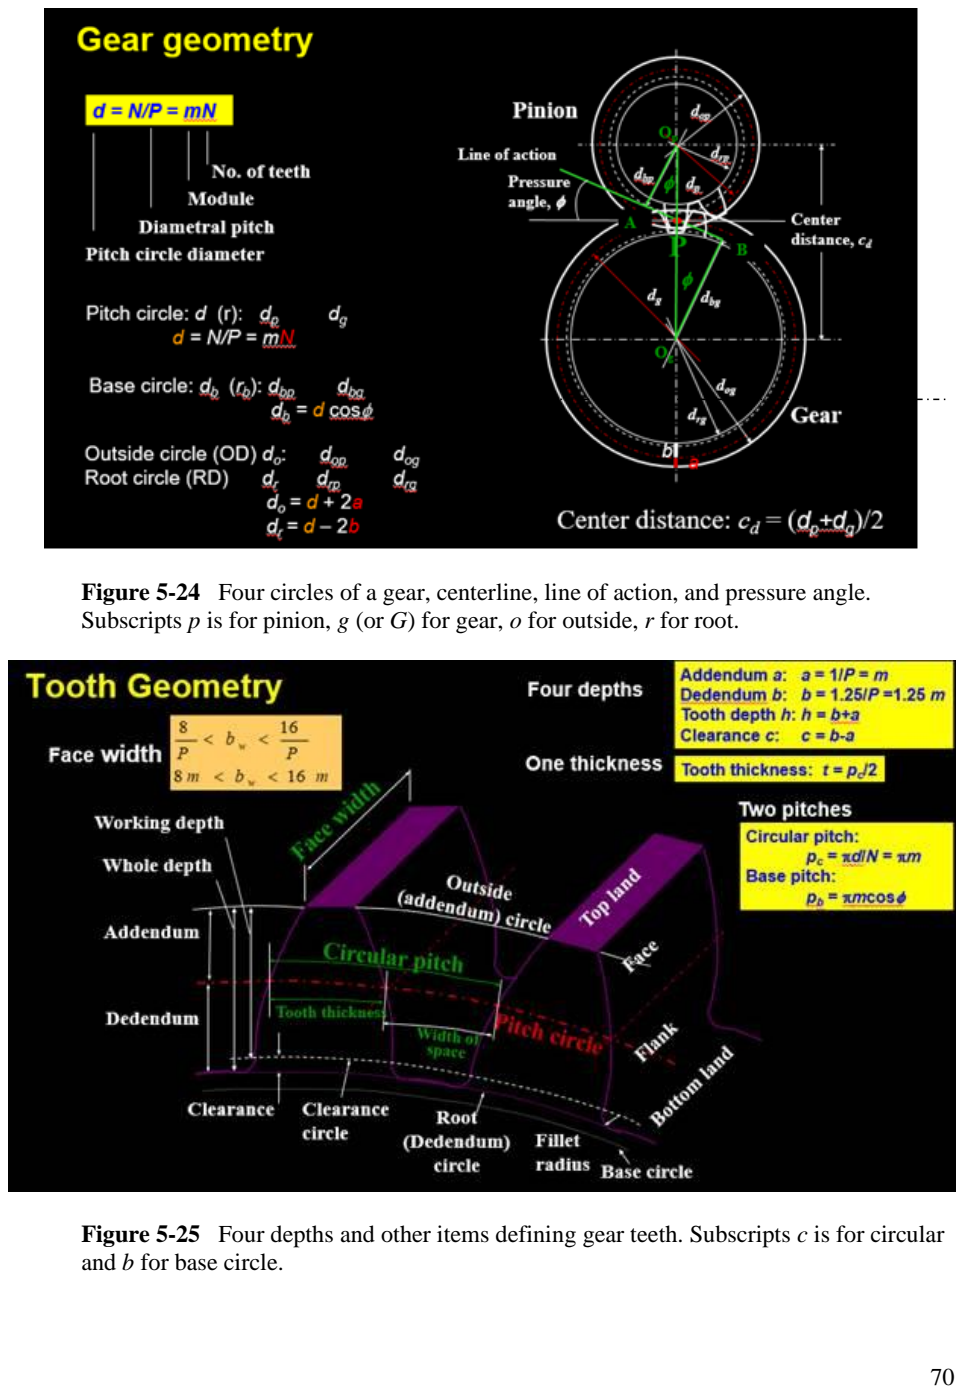
[picture p89: page 17]

Figure 5-24 Four circles of a gear, centerline, line of action, and pressure angle. Subscripts p is for pinion, g (or G) for gear, o for outside, r for root.

Figure 5-25 Four depths and other items defining gear teeth. Subscripts c is for circular and b for base circle.

Spur-gear tooth system. Tables 5-1 and 5-2 list the commonly used diametral pitches and modules. Table 5-3 lists the standard and commonly used values for a, b, and f. Generally, a=m, b=1.25m, and f = 20⁰
for regular ISO gears, which corresponds to a=1/P, b=1.25/P, and f = 20⁰
for regular US custom gears.
Table 5-1 | Commonly used diametral pitches
Coarse | 2 | 2 ¼ | 2 ½ 3 4 | 6 | 8 | 10 | 12 | 16
Fine | 20 | 24 | 32 | 40 | 48 | 64 | 80 | 96 | 120 | 150
Table 5-2 | Commonly used modules
Preferred | 1, 1.25, 1.5, 2, 2.5, 3, 4, 5, 6, 8, 10, 12, 16, 20, 25, 32, 40, 50
Next choice | 1.125, 1.375, 1.75, 2.25, 2.75, 3.5, 4.5, 5.5, 7, 9, 11, 14, 18, 22, 28, 36

Table 5-3 Standard and commonly used values for a, b, and f

Pressure angle f (degree) | Addendum, a | Dedendum, b
Full depth | 20 | 1/P or1m | 1.25/P or 1.25m 1.35/P or 1.35m
| 22.5 | 1/P or 1m | 1.25/P or 1.25m 1.35/P or 1.35m
| 25 | 1/P or 1m | 1.25/P or 1.25m 1.35/P or 1.35m
Stub | 20 | 0.8/P or 0.8m | 1 /P or 1 m

How should we choose the number of teeth? Usually, for hobbed spur gears, the minimum number of teeth should be 17. For a pair of gears, it is preferred that the tooth ratio, N2/N1 is an irrational number in order to avoid repeated tooth wear pattern. One of N2 and N1 may be a prime number, at least 17.

Example 5-3 Let’s work on a pair of metric gears with a module of 4 mm. The pinion has 17 teeth, and the gear has 40 teeth. The pressure angle is 20 degrees. Calculate: 1) Gear ratio of speed reduction, 2) pitch diameters of the pinion and the gear, 3) addendum and dedendum, 4) tooth depth and clearance, 5) centerline distance, and 6) circular and base pitches, and then do the 7) plot of the gear triangles.

Solution

1) The ratio of speed reduction | i = NG/Np = 40/17 = 2.353
2) The pitch diameters of the pinion and the gear | dp= m Np = 4 (17) = 68 mm
dG= m NG = 4 (40) = 160 mm
3) The addendum and dedendum | a = m = 4 mm
b = 1.25m = 1.25 (4) = 5 mm
4) The tooth depth and clearance | h = b + a = 5 + 4 = 9 mm
c = b – a = 5 – 4 = 1 mm
5) The centerline distance | cd = 0.5 (dp+ dG) = 0.5 (68 + 160) = 114 mm
6) The circular and base pitch | pc =πm = π(4) = 12.566mm
pb = pc cosϕ = 12.566 cos(20) = 11.808mm
7) Gear triangles are plotted in Figure 5-26. Circles are shown for clarity; actually, they are not needed.
o1

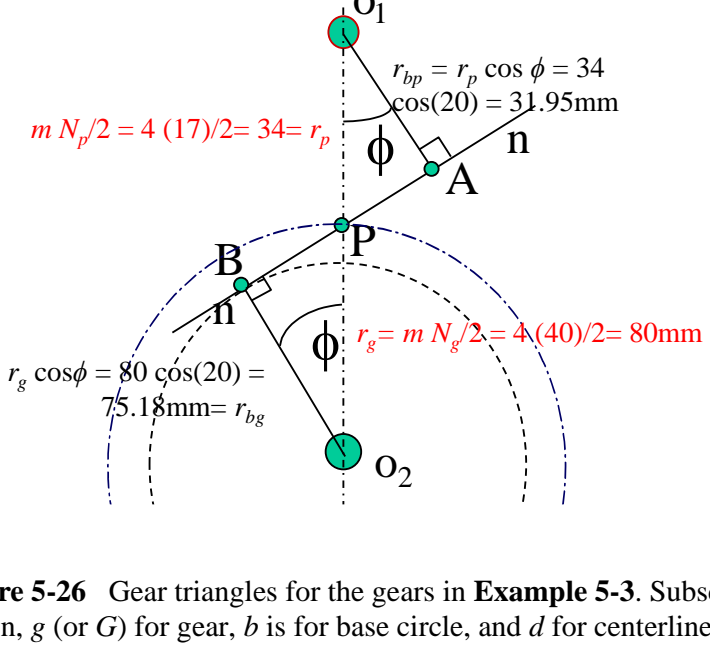
[picture p90: figure]
rbp = rp cos ϕ = 34 cos(20) = 31.95mm; rg cosϕ = 80 cos(20) = 75.18mm= rbg

Figure 5-26 Gear triangles for the gears in Example 5-3. Subscripts p is for pinion, g (or G) for gear, b is for base circle, and d for centerline distance.

5-7 Meshing process and conditions, contact ratio, and interference.
With the understanding of the properties of involute profiles, we are ready to look at the meshing process of a pair of gear teeth, drawn below in Figure 5-27, where the gear triangles are also shown. A and B are the points of tangency of the common tangent and the base circles. The rotation directions are given as well in the same figure. The meshing process is along line AB, why? It is the line of the common normal to the involutes and the common tangent to the base circle. When the gear surface profiles are in contact, they have one normal, but the normal to the involute tooth profiles is the tangent of the base circles.

Meshing process. A pair of teeth starts to mesh at C, where the outside circle of the gear contacts the flank of the mating pinion tooth, or where the outside circle of the gear intersects line AB. The mesh ends at D, where the outside circle of the pinion contacts the flank of a gear tooth, or where the outside circle of the pinion intersects line AB. CD is a segment of line AB, and in the meshing process, the contacting teeth move together from C to D and then separate at
D. Clearly, the length of CD should be shorter than that of AB.

Gear meshing conditions. One question immediately comes to our minds: what are the basic conditions that the meshing teeth should satisfy? From C to D, this pair of teeth should not run into each other, and they should not be separated from each other either. This means that their pitch in line AB should be the same. What is the name of that pitch? The base pitch! Remember the straight-line length along line AB (or the line of generation) equals the arc length on the base circle (Figures 5-28, 5-21); therefore,

pb1 = pb2

We know that
pb= pccosϕ= (πd/N) cosϕ = π/Pcosϕ = πm cosϕ

Note that module (or diametral pitch) and pressure angle are two independent parameters. Therefore, gear mesh conditions are

English:
Pp = Pg
= P | (5-19-1)
ϕp = ϕg = ϕ | (5-19-2)

Metric:
mp = mg = m | (5-20-1)
ϕp = ϕg = ϕ | (5-20-2)

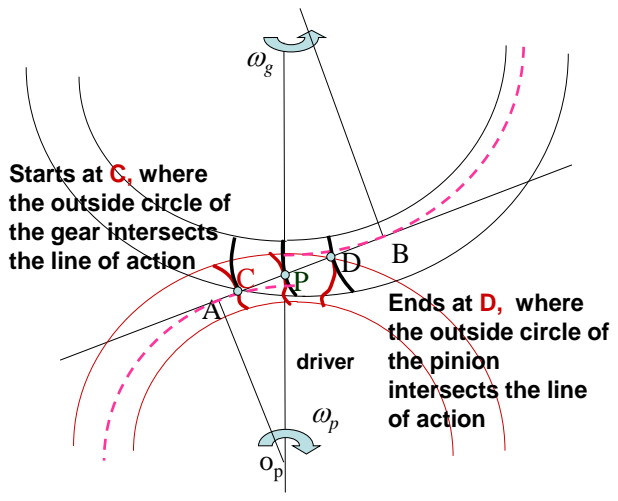
[picture p91: figure]
Starts at C, where the outside circle of the gear intersects the line of action; Ends at D, where the outside circle of the pinion intersects the line of action; driver

Figure 5-27 Meshing process of a pair of teeth. Subscripts p is for pinion, g for gear.

Contact ratio. Is there another pair of teeth in contact while the current pair of teeth is about to separate at D? In Figure 5-28, we should have a continuous gearing motion if another pair of teeth has already started the contact at C. Otherwise, the gear would stop for a while until the next pinion tooth finds its mating gear tooth. This argument means that within the length of CD, there should be at least one pair of teeth, or CD should at least have the length of the base pitch measured along line AB. How many pairs of teeth are in CD? That is simple a division: CD/pb

The contact ratio, Cr,is defined as

Cr = CD/pb
(5-21)

In many cases, we can use the following equation to calculate the contact ratio. Actually, contact ratio is a complicated issue. An accurate analysis should be referred to details in the theory of gearing, not included in this class. The meaning of the contact ratio will be further explained in Example 5-4.
[ | ]

c

d
op | bp | og | bg
c

r
p

c
r | r | r | r
p

C

f
f

tan
cos
1 | 2 | 2 | 2 | 2
= | − | + | − | − | (5-22)

op

C

D
P
rbp | rop

rog

rbg

k’

k

Figure 5-28 Base pitch and CD, subscripts 1 and 2, p and g are for the pinion and the gear. The straight-line length of Ck equals the arc length of Ck’, the base pitch.

Figure 5-29 illustrates three cases of mesh contact with Cr = 1, Cr > 1 and Cr < 1. For the case of Cr = 1, there is exactly one pair of teeth in contact in CD. For the case of Cr > 1, there may be more than one pair of teeth in contact in CD, depending on the tooth meshing location. When one pair separates at D, another pair has already come in from C. For the case of Cr < 1, there is no more than one pair of teeth in contact along CD. When the separation occurs at D, there is no other pair in CD. In practice, Cr should be larger than 1.1 because we need to consider the

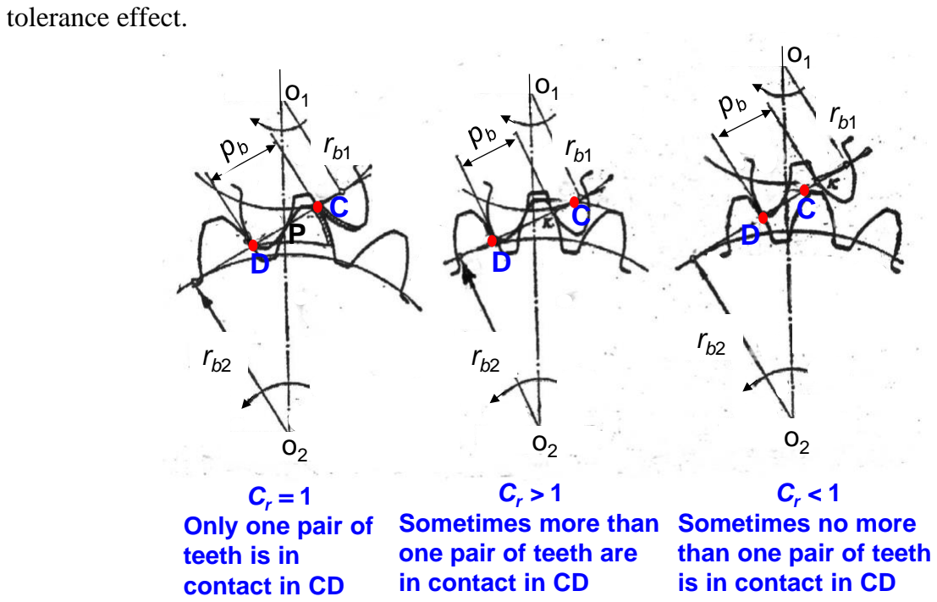
[picture p92: figure]
tolerance effect.; Cr = 1 Only one pair of teeth is in contact in CD; Cr > 1 Sometimes more than one pair of teeth are in contact in CD; Cr < 1 Sometimes no more than one pair of teeth is in contact in CD

Figure 5-29 Effect of the contact ratio on gear tooth contact. Cr is the contact ratio. Modified from Pu et al. (2013).

A larger contact ratio results in smoother transmission. However, the contact ratio for a pair of spur gears is always smaller than two. Helical gears may have larger contact ratios. That is why helical gears are commonly seen in power transmission equipment.

Interference. Segment CD defines the mesh range, but segment AB determines the mesh limits. CD cannot be outside of AB. What will happen if C or D is outside of AB? Tooth contact will not be in the involute portion of the tooth profile, and this is called the mesh interference. This is because no involute is inside the base circle! Gear meshing with a non-involute curve occurs if C or D is outside of AB, and if this does occur, the conjugate action cannot be maintained. If this such interference appears in manufacturing, it becomes undercutting, meaning that the roots of the teeth will be cut inward. As mentioned before, for hobbed gears, the minimum number of teeth to avoid this interference is 17 for spur gears with regular teeth and 20-degree pressure angle. We can prove this in a homework assignment.

Example 5-4 A pair of US custom gears has a diametral pitch of 3 teeth/in. The pinion has 18 teeth, and the gear has 21 teeth. The pressure angle is 25 degrees. Calculate:
Pitch and base diameters of the pinion and the gear
Addendum and dedendum
Tooth depth and clearance

Centerline distance
Base pitch
OD and RD of the pinion and the gear
Contact ratio
Draw the gear triangles and outside circles. Will interference occur or not?

Solution Note that we have used capital P for diamentral pitch (P, Italic) and for the label of the pitch point (P, not Italic), and lower-case p for pitches and the label of a pinion. Do not confuse them.

The pitch diameters of the pinion and the gear
| dp= Np/P = 18/3 = 6” dg= Ng/P = 21/3 = 7”

The base diameters of the pinion and the gear
| dbp= (Np/P)cos 25 = 18/3 cos25 = 5.437” dbg= (Ng/P)cos 25 = 21/3 cos25 = 6.344”

The addendum and dedendum
| a = 1/P = 1/3 =0.3333” b = 1.25/P = 1.25/3 = 0.4167”

The tooth depth and clearance
| h = b + a = 0.4167 + 0.3333 = 0.75” c = b - a = 0.4167 - 0.3333 = 0.083”

The center distance
| cd = 0.5 (dp+ dg) = 0.5 (6+7) = 6.5”
The circular and base pitches
| pc = π/P = π/3 = 1.047” pb = pc cosf = (π/P) cosf25) = π/3 cosf25) =0.949”

The outer diameters of the pinion and the gear
| dop =dp+2a = 6 +2(0.3333) = 6.667” dog =dg+2a = 7 +2(0.3333) = 7.667”

The root diameters of the pinion and the gear
| drp =dp-2b = 6 -2(0.4167) = 5.166” drg =dg-2b = 7 -2(0.4167) = 6.166”

The contact ratio

The meaning of Cr =1.41 is that 41% of the duration has double-tooth contacts, occurring when a pair travels after C and before D, and that 59% of the duration has single-tooth contact, in the middle, before and after the pitch point. So, at the pitch point, we have on pair to take the load.

[ | ]

1.41
1.047

6.5tan 25
2

6.344
2

7.667
2

5.437
2

6.667
1.047cos 25

1

tan
cos

1

2 | 2 | 2 | 2
2 | 2 | 2 | 2
− | =
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
= | − | + | − | −

c

d
op | bp | og | bg
c

r
p

c
r | r | r | r
p

C

f
f

The gear triangles are plotted in Figure 5-30, where CD and AB are measurable. AB>CD.

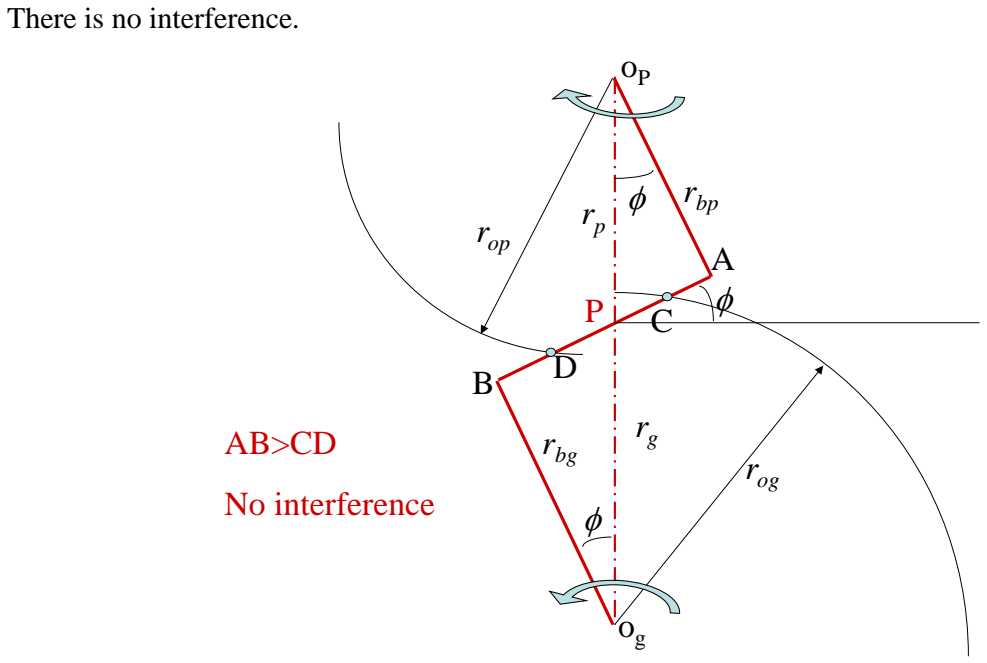
[picture p93: figure]
There is no interference.; rbg; rbp; rog; rop; No interference

Figure 5-30. Gear triangles for Example 5-4. Subscripts r p is for pinion, g for gear, o for outside, b for base.

5-8 Gear manufacturing and gear structures

Gear manufacturing. Conjugate motion is utilized for gear manufacturing. Two methods are commonly used, cutting by a shaper or by a hob. The gear shaper is a gear that is made of a tool steel and machined with cutting edges. In gear shaping, the gear blank and the cutter (gear shaper) are arranged in such a way that their pitch circles are in a pure rolling motion (Figure 5-31). The shaper should also have a feed motion (radial) and a cutting motion (moving upward and downward). The shaper may also be a rack cutter. However, there is a disadvantage of using a rack shaper: it has a finite length, and the machine operator has to move the cutter back and forth.

The tooth shape of a rack resembles that of a worm gear in the axial cross section. A worm gear is a continuous “rack.” A worm gear cutter is called a hob. Figure 5-31 also shows gear cutting by a hob.

Gear structures. Figures 5-32 and 5-33 show some commonly used structures of gears. When gears are small, the gear shaft (a gear is integrated with a shaft) and the solid-disk gear structures are good choices. If the gears are large, the structure shown in Figure 5-33 is preferred. The holes in the web are very important. They reduce weight, and they also facilitate processing and assembly.

Gear materials. Steel, cast iron, and malleable and nodular irons are the most common choices for gears. Bronzes are often used if there is a need for low friction and/or high corrosion resistance. Gray cast irons have the advantages of low cost, ease machining, and high wear resistance. However, they have low tensile strength. Steels have superior tensile strength and are cost-competitive in their low-alloy forms. Non-metallic materials, such as nylon and acetal, may also be used for gear materials. Gears bodies may be made of composite materials to reduce weight, which is then assembled with the gear tooth ring. The top material of gear teeth may be different from that of the body, and coating technologies are used to make this type of layered tooth surfaces.

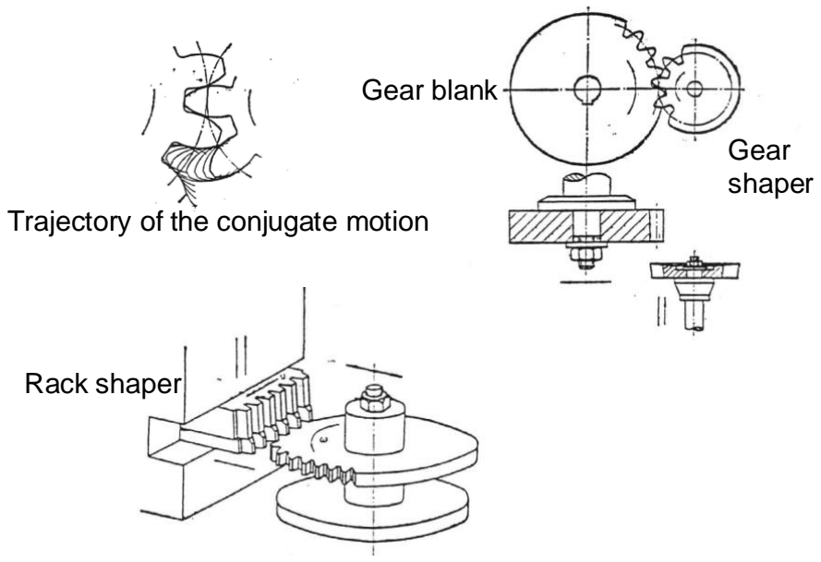
[picture p94: figure]
Gear blank; Gear shaper; Trajectory of the conjugate motion; Rack shaper

Gear cutting by gear shapers.

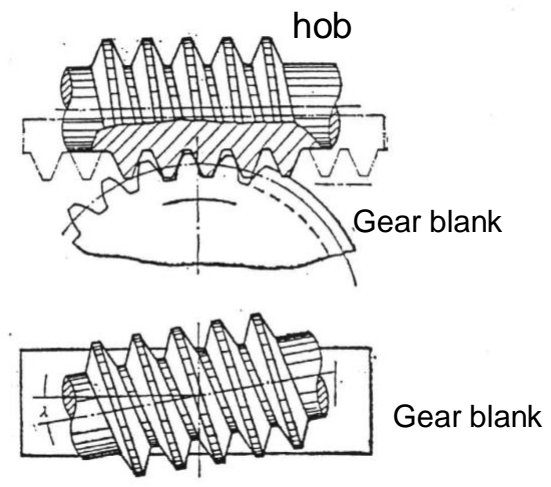
[picture p95: figure]
hob; Gear blank

Gear cutting by a hob.

Figure 5-31 Gear cutting illustration. Plots are from Pu et al.

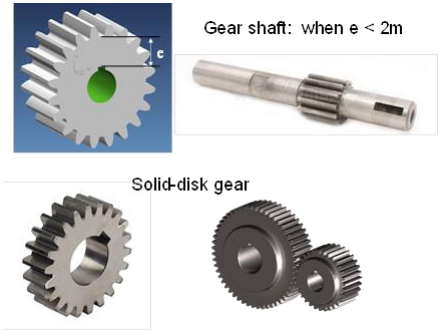
[picture p96: figure]

Figure 5-32 Structures of small gears (photos from internet).

Rim-web gear

Data from Pu et al.

do<500mm
Do=do-10mn
D3=1.6D4
D2=(0.25~0.35)(Do-D3)
D1=(Do+D3)/2
C= (0.2~0.3)B
n~0.5mn
r~5mm

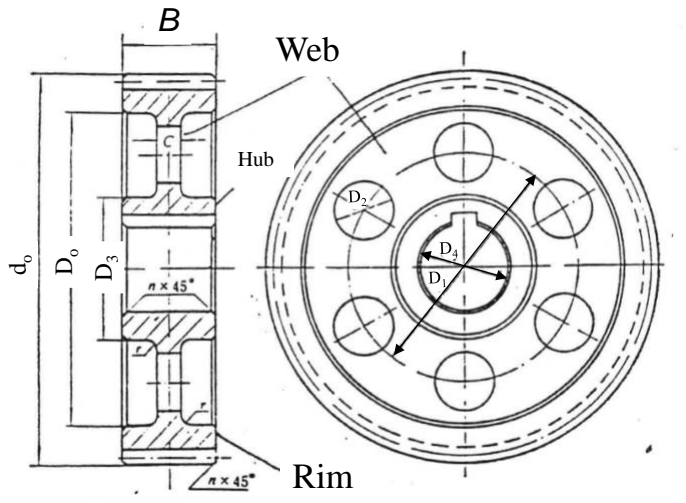
[picture p97: figure]
Rim; Web; Hub

Figure 5-33 Structure of medium-size and large gears with suggested dimensions.

5-9 Spur-gear force analysis

The force on a spur gear tooth is applied through the surface of its mating tooth. It is normal to the tooth surface. The force acts along line AB, now, the line of action, because it physically has to be perpendicular to the surface, and the line of action is the line of the common normal. The uniqueness of the line of action (normal of the contacting surfaces) ensures that the force is always along the same direction no matter where the contact occurs on the surface during the gear mesh. As a result of the force, the root of the gear tooth is subjected to a cyclic bending stress, while the tooth surface is under a cyclic contact stress, which we will talk about later. Figure 5-34 shows the force on a gear tooth and the stress contours, where the tooth looks like a cantilever beam of a non-uniform cross section.

W Normal load

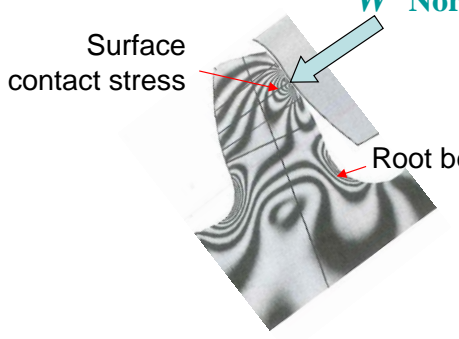
[picture p98: figure]
Surface contact stress

Root bending stress

Figure 5-34 Normal force on a tooth surface. Photo from Hamrock et al.

Example 5-4 told us that, at the pitch point, we have only one pair of tooth teeth to take the load. That is the place for our force analysis. The normal force, W, on a spur-gear tooth can be easily resolved into orthogonal components, which are the tangential and radial components. Remember, the tangential force times the radius of the pitch circle results in the transmitted torque. The normal force and its orthogonal components are given in Figure 5-35. Equation (5-23-1) is the vector form of the force relationship, while the other equations in equation set (5-23) are for the magnitudes of forces. Here, superscripts t and r are used for tangential and radial.

W Normal load

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
t | r W | W | W
= | +

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
cosf

t W
W =
sinf | tanf
r | t W =W | =W

Force relationship

Tangential force

Normal force

Radial force

(5-23-1)

(5-23-2)

(5-23-3)

(5-23-4)

Figure 5-35. Normal force on a spur-gear tooth surface and its orthogonal components. Superscripts t and r means the transverse plane and the radial plane.

Gear force analyses are necessary preparations for gear design. Moreover, they will provide the force information for shaft design and supporting bearing selection. We will see how gear forces are considered in shaft force analyses through example 5-5.

Example 5-5 A gearbox is shown below in Figure 5-36. Four gears are mounted on three shafts to form a compound gear train. A is the input end and G the output end. The shaft outlets at A and G are connected to couplings.

Known: The power transmitted, H (unit: W, or kW), n1, d1, d2, d3, and d4
Find: Torques and forces on the gears and the shafts.

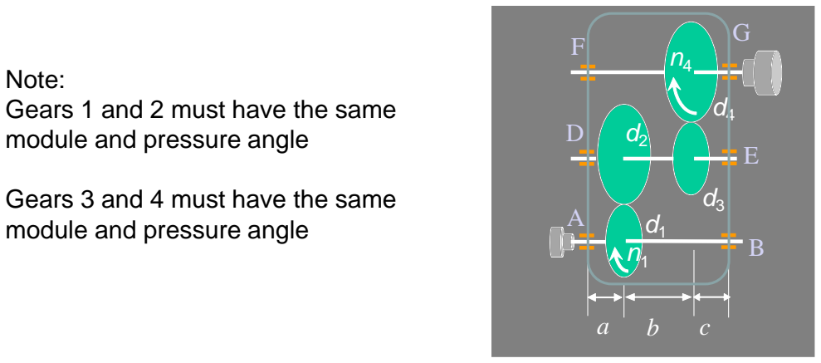
[picture p99: figure]
Note: Gears 1 and 2 must have the same module and pressure angle; Gears 3 and 4 must have the same; module and pressure angle

Figure 5-36 Gears and shafts in the gear box, O1 through O4 are the centers of the gears.

Solution
We need to analyze the shafts one by one. Let’s start from shaft AB. Why? We know the input power and n1, so that we can easily get the torque there. This shaft has a gear and a coupling. The coupling only transmits torque. Gear 1 on this shaft is the driver of the system. Its teeth push the teeth of the driven gear, which is gear 2 in this case. Therefore, the force on the teeth of gear 1 should produce a torque that is against the rotating direction of shaft AB. In other words, gear 1 “feels” the resistance from gear 2.

The forces on gear 1 and shaft AB are shown in Figure 5-37. The normal force on the gear tooth, which can be resolved to the tangential and radial components, must be “shifted” to the center of the shaft for the shaft force analysis. The radial force can be directly moved along its line of application, but torque should be added when moving the tangential force. This torque is balanced by the torque at the coupling. Bearing reactions should be calculated carefully based on the forces on the shaft. From the gear radial load, we can obtain the bearing reactions in the y direction, and from the gear tangential load, we can obtain the bearing reactions in the z direction. Thus, we obtained the free-body diagram, FBD, for shaft AB.

The force from gear 2 to gear 1 is marked as 21 in the subscript, its two components are marked as t and r in the superscripts. Reactions at bearings A and B are labeled by A and B with components in y and z. Spur gears do not bear axial force along the shaft direction.

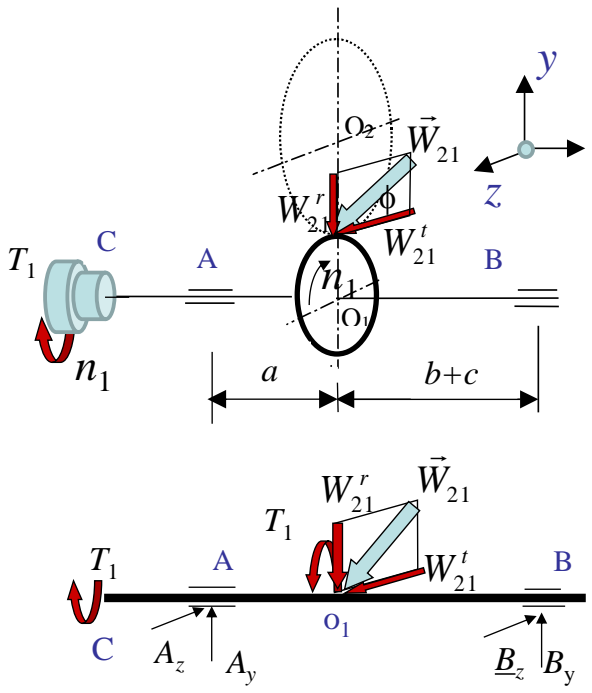
[picture p100: figure]

Figure 5-37 Force analysis for gear 1 and the FBD for shaft AB.

The gear torque, the normal force, and the force components are

The bearing reactions can be found accordingly. Note that HP=550ft lbf S = 745.7 Watt and

(HP,lbf.ftmin,US), | (Watt,ISO), | (Watt,ISO)
33000
t WV | t H | W V | T = | ω

Shaft DE (Figure 5-38) has two gears, and the mechanics is slightly more complicated than that for shaft AB. We will do the same thing, analyzing the force components on a gear tooth and then the force equilibrium of the shaft, or its free-body diagram, FBD. We need to pay attention

1 | 1
1 | 2

60
n
| H | H
T | ω | π
= | =
t | r W | W21 | W21 21
= | +
1 | 1 1
1 | 60
/ 2
21 | d n

H
d

T W
t
π
= | =

cosf

21

21

t W
W =
sin f | tanf
21 | 21 | 21
r | t W = W | = W

Torque

Force relation

Tangential force

Normal force

Radial force to the action and reaction. The force on gear 2 is opposite to that on gear 1. The torque on gear 2 is balanced by the torque on gear 3. Therefore, the direction of the normal force on gear 3 is determined.

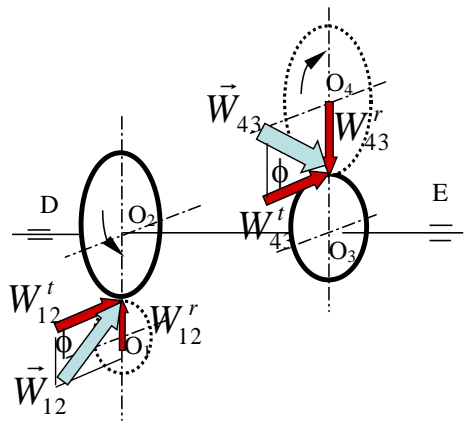
[picture p101: figure]

Figure 5-38 Force analysis for gears 2 and 3.

The normal force, or the components of the normal force, and the torque on gear 2 are

The normal force (or components of the normal force) and the torque on gear 3 are

With these forces analyzed, the bearing reactions can be easily calculated. Detailed force diagrams for the gears and the free-body diagram for shaft DE are shown in Figure 5-39.

( | / 2) T2 | W12 d2

t =

W12 W21

= −
t | t W12 | W21 = −
r | r W12 | W21 = −

Torque

Force relationship

Tangential force

Radial force

T2 = −T3

/ 2 3

43

3
d

T
W

t =

### Force relationship

### Tangential force

### Radial force

W34 | W43
= −

cosf

43
43

t W
Normal force | W =
43 | 43 sin f | 43 tanf
r | t W = W | = W

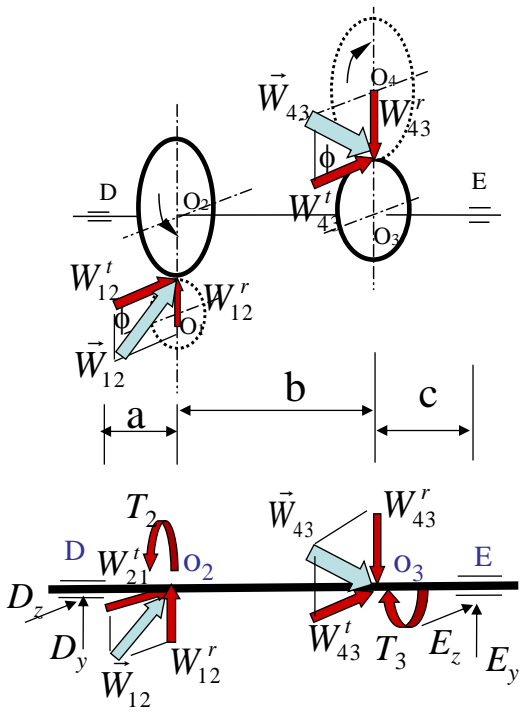
[picture p102: figure]

84 O2

Figure 5-39 Force analysis for gears 2 and 3 and for shaft DE.

Note that on a driver gear, the directions of the torque and speed are different, but on a driven gear, the directions of the torque and speed are the same. Can you do the force components for gear 4 and the force analysis for shaft FG, together with its FBD?

Example 5-6. In the spur-gear train in Figure 5-40, gear 0 is the input gear. The power is H = 100KW (assuming no power loss), and the rotation speed of shaft AB is n = 1500 rpm. Gear parameters are, m1 = 5, N1 = 20, m2 = 6, N2 = 80, and pressure angles are all 20 degree. Gear centers are marked by O0, O1, O2, and O3. If a = 50 mm, b = 40 mm, c = 40 mm, please

(1) Calculate the torque transmitted to shaft AB, the forces on gears 1 and 2, and the forces on shaft AB.
(2) Determine the magnitude and location of the maximum bending moment for the shaft.
Solution. | d1 = m1N1 = 5(20) =100 mm d2 = m2N2 = 6(80) = 480 mm

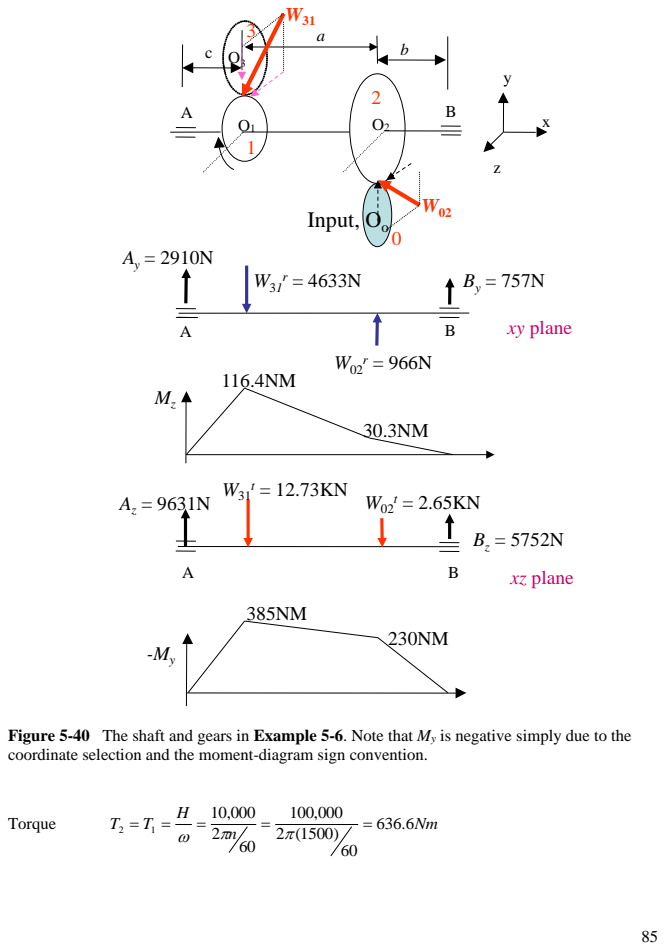
[picture p103: page 32]
Input, Oo; xy plane; xz plane; Torque

Figure 5-40 The shaft and gears in Example 5-6. Note that My is negative simply due to the
coordinate selection and the moment-diagram sign convention.

Gear forces
N
d

T
W

t
2653
2

0.48

636.6

2

2

2
02 = | = | =
W | W | N
r | t
02 = 02 tanf = 2653(tan 20) = 966 KN d
| T
W

t
12.73
2

0.1

636.6

2

1

1
31 = | = | =
W | W | N
r | t
31 = 31 tanf =12.73(tan 20) = 4633

Bearing reactions

Σ MA = 0
N
| | a b c
W c | W a c
B
r | r
y | 757 0.05 0.04 0.04
( ) | ( | ) | 4633(0.04) 966(0.05 0.04) 31 | 02
=
+ | +
− | +
=
+ +

− +
=
A | W | B | W | N

r
y

r
y

= 31 − − 02 = 4633 − 757 − 966 = 2910

Similarly
N
a b c

W c W a c
B
t | t
z | 5752 0.05 0.04 0.04
( ) | ( | ) | 12730(0.04) 2653(0.05 0.04) 31 | 02
=
+ | +
− | +
=
+ +

+ +
=
A | W | B | W | N

t
z

t
z

= 31 − + 02 =12730 −5752 − 2653 = 9631

Moments

The largest moments are at shaft cross section O1:

Mymax = Ay (c) = 2910(0.04) = 116.4 NM

Mzmax = Az (c) = 9631(0.04) = 384.5 NM

Resultant moment

MO | M y | M
z | 116.4 | 384.5 | 402.2Nm ² | 2 | 2 | 2

1

= | + | = | + | =
5-10 | Gear failure mechanisms

Cyclic loading on gear teeth may cause fatigue failures of the teeth, which are mainly fatigue fracture at tooth roots due to bending and surface pitting due to contact fatigue. Therefore, the design criteria for gears should be formulated against root fracture and surface pitting. Actually, various types of surface failure, such as pitting, severe wear, and scuffing, account for 70-90% of total damage to heavy-duty gears. However, the analyses for wear and scuffing are less developed due to the lack of in-depth mechanism understanding and insufficient data. The simulation and analysis of wear and scuffing are much more complicated, and therefore, criteria have been less developed. Figure 5-41 shows several photos of tooth surface failures.

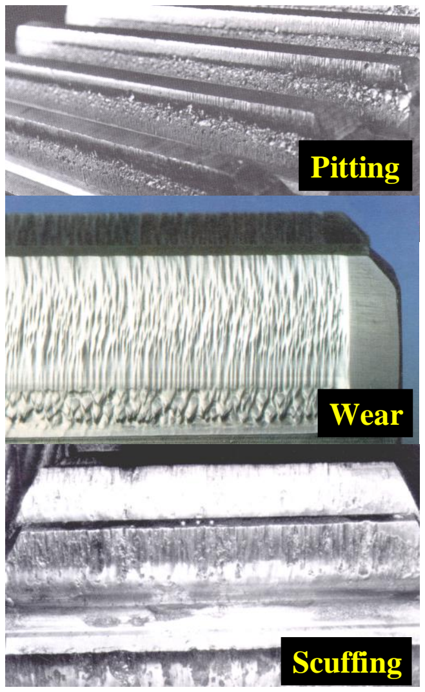
[picture p104: figure]
Pitting; Wear; Scuffing

Figure 5-41 Gear tooth surface failures.

5-11 Spur gear design analyses

Similar to the shaft design we have studied, the gear design is actually the analysis of gear strength, or the control of stresses to be well below their limits to failures. The failure mechanisms of gears are root fracture and surfaces pitting, severe wear, and scuffing, as mentioned before. However, mature theories for gear failures are the root bending stress/strength analyses and surface contact-stress/strength analyses, which lead to the design criteria against root fracture and some types of surface failure. Our approach will be similar to what we previously used: first creating a structure, then making a mechanics model, and then conducting stress analyses, finding the strength of the material used, and finally analyzing factors of safety.

### 1 Root bending stress

A gear tooth is a cantilever beam of a varying cross section, as shown in Figure 5-42, which may be simplified as an equivalent beam of height l, thickness t, and width bw. We consider the worst possible situation: a single pair of teeth is in contact and transmits the entire load at the top of the addendum. The bending force, F, is the normal-load component perpendicular to the centerline of the tooth, which is the tangential load, Wt
. Equation (5-24-1) starts from the bending normal stress of a rectangular beam and indicates that the root bending stress is related to tangential load Wt
, face width bw., tooth thickness t, and tooth depth l. However, we need to take into account the real tooth shape somehow. It is noticed that among the key geometric parameters, such as module, pressure angle, and face width, only face width bw is accurately involved here. Both thickness and tooth depth are related to the module of the gear. Therefore, the effects of the tooth depth and the thickness may be reflected by a shape factor multiplied by the module of the gear, as shown in Equation (5-24-2).

(5-24-1)

(5-24-2)

Figure 5-42 A tooth as a cantilever beam.

There are several ways to analyze the bending strength. A well-accepted approach is the AGMA approach. AGMA stands for the American Gear Manufacturing Association.

The AGMA approach may be simply expressed by Equation (5-25-1 and 2), i.e., the root beading stress, σb, should be smaller than the allowable stress for bending, σall,b. Thus, the factor of safety against root bending fatigue failure, nb, can be defined by Equation (5-25-2).

σ b ≤ σ all,b

(5-25-1)

nb σ all b σ b
/ =
| ,

(5-25-2)

F

t

bw

(W | l

t)

Wt

3 | 2
/12

( / 2)
b t

W l
b t

Fl t

w

t

w

σ b → | →
w | j

t

w

t

w

t

b
b mY

W
t

ml
b m

W
b t

W l
→ | → | →
?? ² | 2

σ

The AGMA approach also considers the effect of gear size, loading smoothness, load distribution, as well as different applications, and it introduces a series of factors to modify the stress equation. Equations (5-26) and (25-27) are the finalized root bending stress formulas for metric and US custom gears, respectively, using the relationship P=1/m to convert diametral pitch and module.

(5-26)

Dynamic factor
Load distribution factor
Size factor
Application factor
Geometry factor

Idler factor

Rim thickness factor

(5-27)

### 2 Surface contact stress

Contact stress is a new stress concept. It is referred to the stress state of the material right below the point of load application. Such a stress was avoided in the entire study of Mechanics of Materials. However, we cannot neglect its existence anymore when surface failure is a concern.

The contact of two cylinders of curved surfaces may be equivalent to that of two cylinders whose radii are the radii of curvature of the curved bodies at the point of contact. Such a simplification is proven to be valid because the region influenced by the contact is much smaller than the sizes of the bodies. The contact of two cylinders can be further modeled by the contact between an equivalent cylinder and a rigid, flat surface. The equivalence means that we add the curvature of both mathematically and material properties of both mechanically as if they were two springs in series. As a result, the equivalent cylinder takes care of the contact geometry and the elastic properties of the two tooth materials. Figure 5-43 shows the gear triangles, which represent the teeth, and the simplification of the contact to that of two different cylinders, and further to that of an equivalent cylinder and a rigid flat. The radius of this equivalent cylinder, R, which is from the result of curvature summation at the contact point, is given in Equation (5-28). The elastic properties of the materials are summed into an equivalent Young’s modulus, E’ (Equation (5-29).

a | s | m | v | i | b
w | j

t
b | K K K K K K
b mY

W
σ =
a | s | m | v | i | b
w j

t
b | K K K K K K
b Y

W P
σ =

Figure 5-43. Tooth contact and equivalent radius of curvature.

sin f

1 | 1 | 2
| 1
1 | 1

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
p | g
p | g | d | d
R | R

R
(5-28)

g

g

p

p
E | E
E | 2 | 2
1 | 1

2
'
| ν | −ν
+

−

= | (5-29)

A dimensionless load is defined as

E R

W b
E R

W b
W | w | w
'

/
'

/
'
= | =
(5-30)

Then the maximum contact stress is the following, which is also called the maximum Herzian contact pressure, pH, for the contact of cylinders.

1/ 2
'

1/ 2
'
2 | 2 | '

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
æ → =
b RE

W
E

W
p E

w

c | H
π | π

σ
(5-31)

Again, the AGMA approach is used for the surface strength analysis, i.e. the maximum contact stress should be smaller than the allowable contact stress. Likewise, the factor of safety against contact pitting failure, nc, can be defined by (5-33).

σ c ≤ σ all,c
(5-32)

nc σ all c σ c
/ =
| ,

(5-33)

Similar to the bending stress formula, the AGMA approach for surface strength also considers the effects of loading, size, load distribution, as well as different applications, and a series of factors are needed to modify the contact stress equation (Equations (5-34)). Here, Ka, Ks, Km, and Kv are the same as those in the bending stress formula. In addition, an elastic factor, Ke, is

Rg Rp
Rg

Rp

Eg υg

Ep υp f

f

R, E’

introduced for the equivalent modulus, calculated from Equation (5-35), and I is defined as the geometry factor, accounting the curvature effect and others, expressed by Equation (5-36).

1/ 2

1/ 2 | 1/ 2

'

1

2

/ cos
'
2 | '

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
a | s | m | v
w | p

t

e

a | s | m | v
w | p

p

t

a | s | m | v
w

c

K K K K
b d I

W
K

K K K K
b d R

W d
K K K K | E
b RE

W
E
π

f
π

σ

(5-34)

g

g

p

p

E

E | E
K | E | 2 | 2
1 | 1

2
'
| | ν | −ν
+

−

= | = | (5-35)

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
= | =

g

p

p | g

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
cos sin

sin

1 | 1 | 2
2 | cos | 2 cos | π | f | f

f

π | f | π | f
(5-36)

Note that here KE

is defined differently from that in the Shigley book, and so is I, in the way “2” and “π” are placed. We will learn how to use these equations and how to design gears with sufficient strength from an example later.

### 3. Gear allowable strength

Gear allowable stresses are determined by modifying gear material strengths, as shown below.

Allowable bending stress | (5-37)
Allowable contact stress | (5-38)

Here, Sb and Sc are for the bending and contact strengths of a gear material, KT is the temperature factor, KR the reliability factor, YN the stress cycle factor for bending, ZN the stress cycle factor for contact, and CH the hardness ratio factor. The example below will help explain the use of these factors.

,

bN
all b
T R

SY
KK

σ =

,

c | N | H
all c
| T | R

S Z C
KK

σ =

Example 5-7
Given: A gear train of a pinion and a gear and solution steps are given in Figure 5-44.
The train value: | 3.5:1
Np = 18, | Ng = (3.5) 18 = 63
Pressure angle; | 20°
Diametral pitch | P = 6
Power and speed of the pinion shaft:
H = 20 HP, nP = 2500 rpm
Driven by an electric motor, no shock.
Life: | 5 years, 1 shift per day, 99% reliability.
Find: | Major gear geometry and factors of safety

What should we do? We will solve this problem in the following steps
(1) Gear geometry
(2) Tangential force
(3) Materials and allowable stresses
(4) Factors for stresses
(5) Stresses
(6) Factors of safety

Figure 5-44 Things to solve for Example 5-7.

Solution

(1) Gear geometry

18 3"
6

63 10.5"
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
= | = | =
= | = | =
1 | 1 "
| 6

1.25 1.25 0.208"
6

a
P

b
P
= | =
= | = | =

Let’s choose the middle value from the following empirical formula for the face width. Why the tooth face cannot be very wide or very narrow? Think about shaft deflection and load distribution issues.

8 | 16

w

b
P | P
< | <
12 12 | 2"
6

w

b
P
≈ | = | =

The face width here is nominal. Actually, the pinion is made slightly wider (2-5 mm). Why? Think about assembly tolerance.

(2) Tangential force
(33000) | (33000) | 20(33000) | 336lb 2 (2500)(3 / 2) 2 | 2 | 12
t

p

H | H W
V | d n
π
| π
= | = | = | =

(5-39)

Pitch circle velocity, V = 1963feet/min.

(3) Materials and Allowable stresses
Materials. We choose steel gears with Young’s modulus E = 30 MPsi and Poisson’s ratio ν = 0.28, through hardened.

Figures 14. 24, 25 in Hamrock’s book (2005) are used here as Figure 5-45. We also need to select hardness values for each gear, which leads us to the strengths of the materials.

Piion – 300 HB, grade 2 SPb = 0.102HB+16.4 = 47 Ksi
SPc = 0.349HB + 34.3 = 139 Ksi Gear – 250 HB, grade 1 SGb = 0.0773HB+12.8 = 32.1 Ksi SGc = 0.322HB +29.1 = 109.6 Ksi

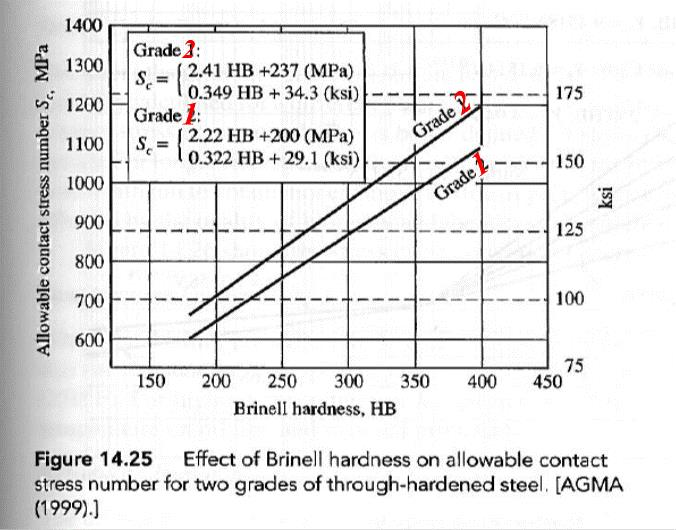
[picture p105: figure]

(Note here corrections are made in red in the figure and equations.)

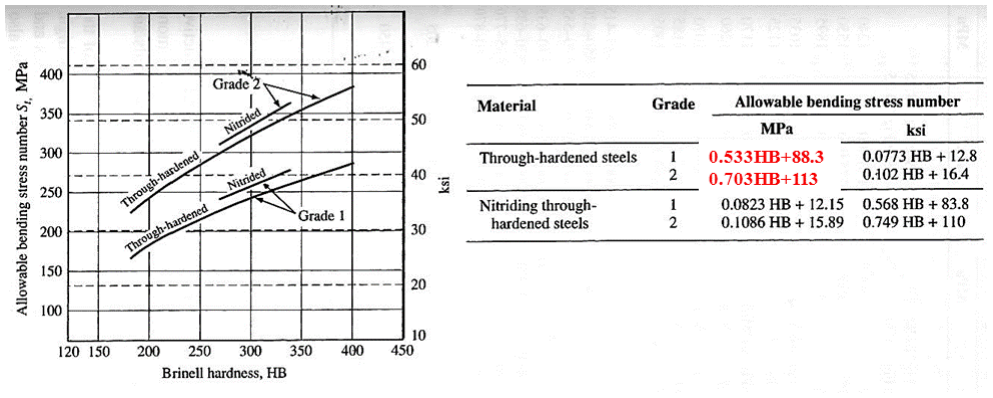
[picture p106: figure]

(Note corrections of the equations are made, in red.)
Figure 5-45 Allowable stresses. These are for 10 million cycles, 99% reliability (Hamrock et al. 2005).

Here the hardness values of the two gears are different. Why? The pinion teeth and tooth surfaces are subjected to more cycles, and therefore, should be made stronger and harder. A hardness difference of 50-100HB is suggested as the starting point. However, this suggestion is not quite precise. Wait to see how the hardness factor is determined.

Factors for strengths.

Temperature factor, KT

KT, the temperature factor, is 1 if the environmental temperature is not higher than 125⁰C.

Reliability factor, KR

KR, the reliability factor, is higher if the reliability requirement is higher. For the reliability of survival to be 99%, KR = 1, because this is one of the conditions at which the material tests were done; for the reliability of survival to be 99.9%, KR = 1.2. It becomes KR = 0.85 if the reliability of survival is reduced to 90%. See Table 5-4.

Table 5-4 | Reliability factor, KR
Percentage reliability of survival | Reliability factor, KR
50 | 0.70
90 | 0.85
99 | 1.00
99.9 | 1.25
99.99 | 1.50
(AGMA 2101-C95 (1999)

Stress cycle factors

Stress cycle factors are determined using the following figures. We need to get the cycle number first as follows.

Cycle number of the pinion = 5 (365x8)(60) (2500rpm) = 2190Million cycles
Cycle number of the gear = 5 (365x8)(60) (2500rpm/3.5) = 625.71Million cycles

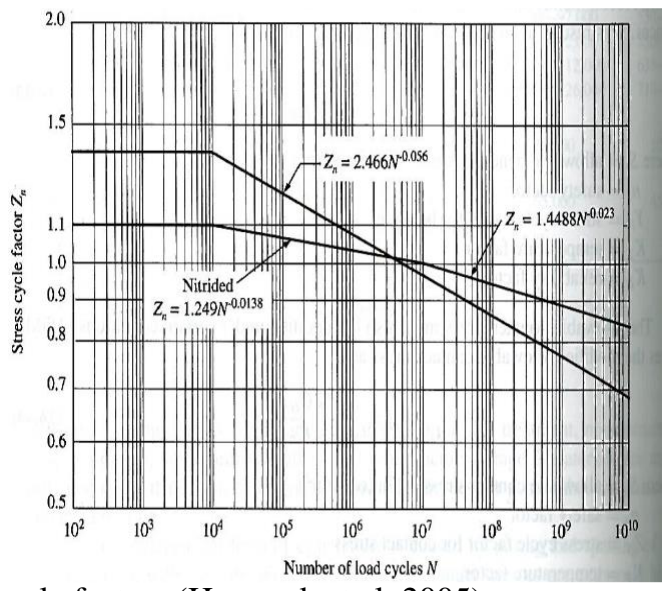
[picture p107: figure]
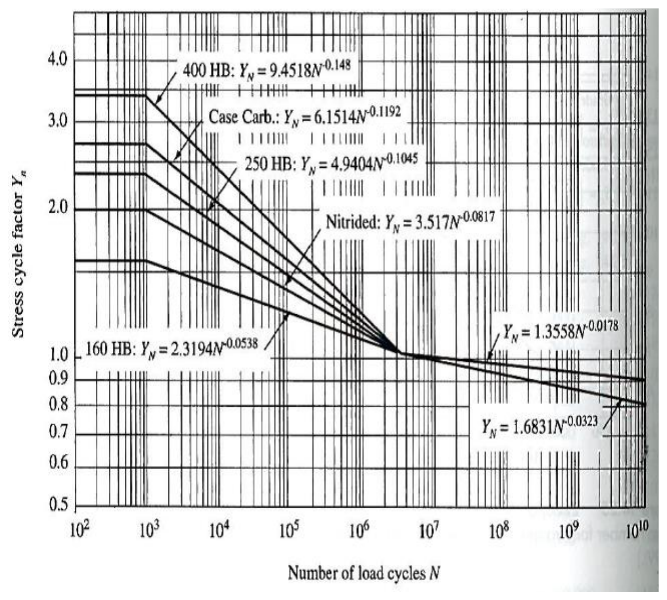
[picture p108: figure]

Figure 5-46 Stress cycle factors (Hamrock et al. 2005).

ZN = 2.466N⁻⁰.056
, therefore, ZNp = 0.739 ZNg = 0.793
YN = 1.6831N⁻⁰.0323
, therefore, YNp = 0.840 YNg = 0.875

Hardness factor, CH

Hardness factor, CH, considers the difference of the hardness of the mating surfaces; it only applies to the gear, so that CH becomes CHg. Here, the hardness is the Brinell hardness. Either the following equations or the figure below can be used to determine the hardness factor.

CHg = 1.0 + A’(Ng /Np – 1.0) | (5-40)
A’= | 0 | if | HBp/HBg <1.2
A’= | (8.89x10⁻³

)(HBp/HBg) - 8.29x10⁻³
if 1.2 ≤HBp/HBg ≤ 1.7
A’= | 0.00698 | if | HBp/HBg >1.7

The A’ values for Equation (5-40) tell us that if that the proper range of the hardness ratio is precisely 1.2 ≤HBp/HBg ≤ 1.7, below which the hardness different brings no gain in the gear strength, and the strengthening effect is bonded by that given by HBp/HBg = 1.7.

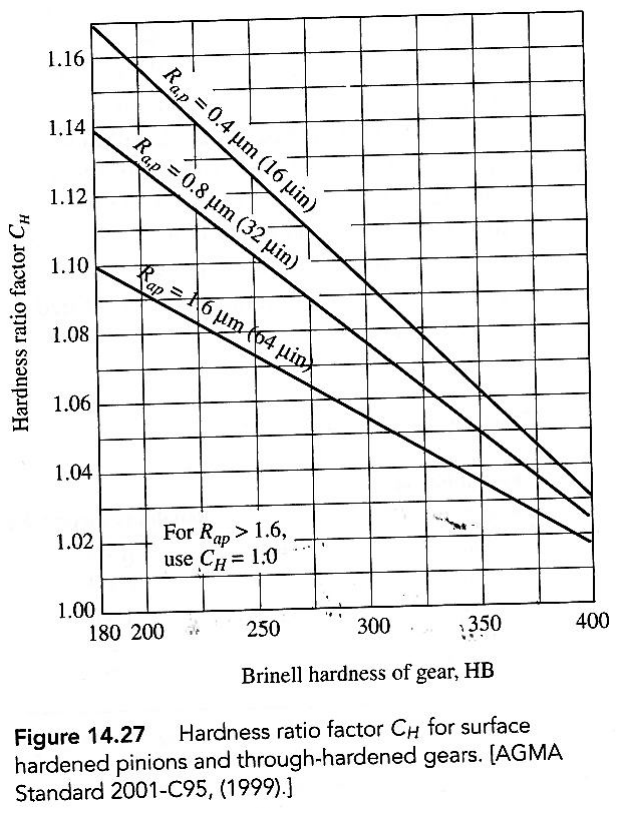
[picture p109: figure]

Figure 5-47 Hardness factor for surface hardened gears (Hamrock et al. 2005).

In our problem, HBP /HBG =300/250 = 1.2, therefore

CHG = 1.0 + A’(Ng /Np – 1.0) = 1.0 + 0.00238(3.5 – 1.0)= 1.006

The highest hardness the pinion can do is 1.7x250 = 425HB.

As a result of the factors, the allowable stresses are the following.

Allowable bending stress for the pinion

Allowable bending stress for the gear

Allowable contact stress for the pinion

Allowable contat stress for the gear

,

(47)(0.84) 39.84
(1)(1)

bN
all bp
T | R
SY | Ksi
KK
σ | = | = | =

,

(32.1)(0.875) 28.09
(1)(1)

bN
all bg
T | R
SY | Ksi
KK
σ | = | = | =

,

( | ) | (139)(0.739)(1) 102.72 (1)(1)
c | N | H
all cp
| T | R
S Z C | Ksi
KK
σ | = | = | =

,

(109.6)(0.793)(1.00621) 87.43 (1)(1)

c | N | Hg
all cg
| T | R

S Z C
Ksi
KK
σ | = | = | =

(4) Factors for stresses

Now we come to determine factors for bending and contact stresses

1/ 2
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
a | s | m | v
w | p

t
c | e | K K K K
b d I

W
σ K

Application factor: Ka.

The application factor considers the effects of system speed variation and shock. Table 5-5 lists some values of the application factor. For a system powered by an electric motor, the load and speed are usually smooth without obvious shock. Therefore, Ka = 1 may be the choice for our example. For a system powered by an internal combustion engine, a higher value of Ka is preferred.

Again, in the current problem, we have an electric motor as the power supplier without shock. Therefore, Ka = 1

Table 5-5 Application factor

Power source | Application factor, Ka
No shock | 1
Light shock | 1.2
Moderate shock | 1.3

Load distribution factor: Km.

The load distribution factor increases with the face width of a gear. It is difficult to make the contacting teeth of a gear set completely parallel due to manufacturing tolerance, assembly inaccuracy, and shaft deflection, etc., if the gears have large face widths.

This gear set is not a high precision gear set. However, it cannot be made too rough. It has the commercial quality. Use bw/dp in Fig. 14.23 in Hamrock’s book (1999), which is shown below, to determine Km, and use the same Km for both gears because their load distributions are the same.

a | s | m | v | i | b
w j

t
b | K K K K K K
b Y

W P
σ =

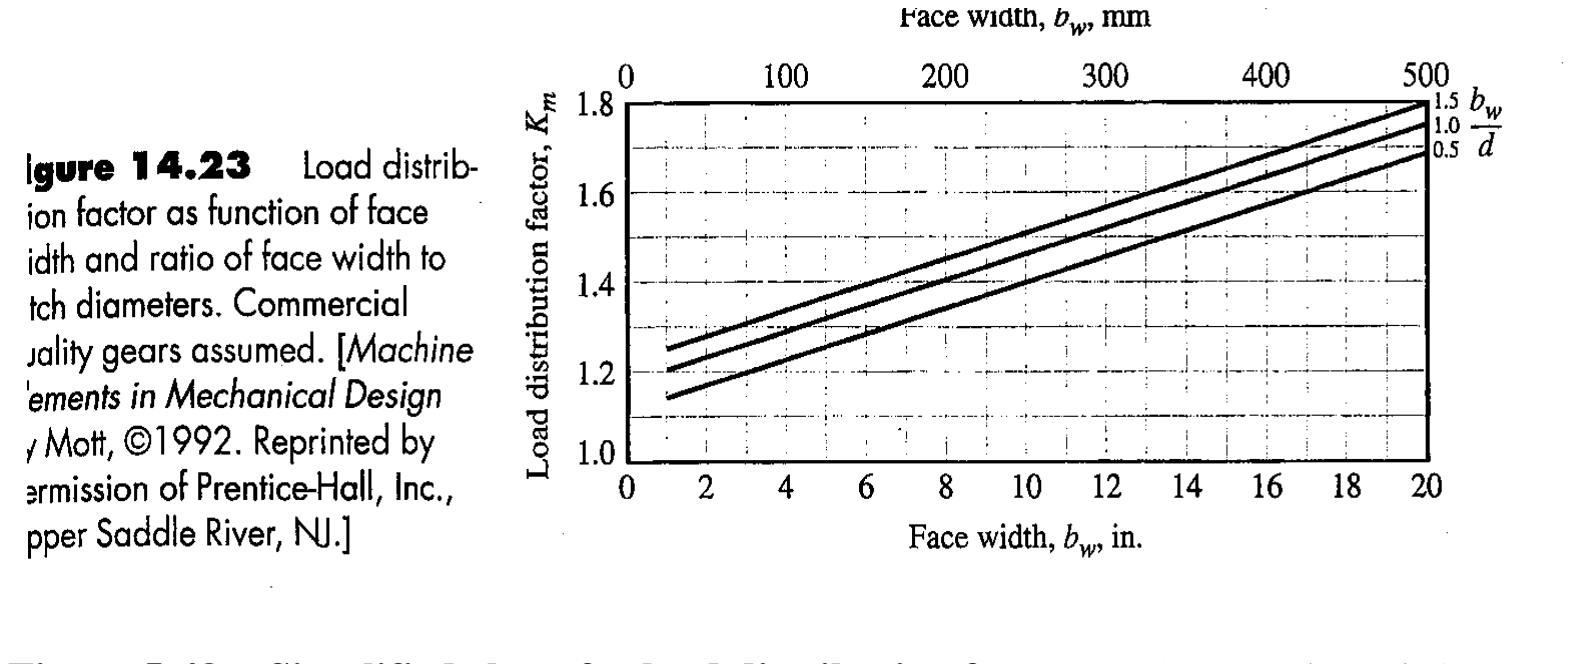
[picture p110: figure]

Figure 5-48. Simplified chart for load distribution factor Km. (Hamrock et al.,1999),

More accurate considerations of load distribution suggest a more complicated determination of the load distribution factor, where both transverse and face distribution factors, Cmt, Cmf, should be evaluated. For gears with bw/dP ≤ 2 with the face width less than 1m, mounted between bearings (equivalent to a simply supported beam), and subjected to contact across the full width of the narrower member when loaded, Km may be approached roughly with only the face load distribution factor, Cmf.

Km=f(Cmt,Cmf)~ Cmf= 1.0 + Cmc(CpfCpm+CmaCe)
(5-41)

Here, Cmc is the lead correction factor, for uncrowned teeth, Cmc = 1 Cpf is the pinion proportion factor.

If bw ≤ 1 in

If 1< bw ≤ 17 in (5-42)

If 17<bw ≤ 40 in

Cpf in the ISO unit should be

If bw ≤ 25 mm

If 25 < bw ≤ 432 mm (5-42’)

If 432<bw ≤ 1020 mm

0.0375 0.0125
10

w
pf | w
d

b
C | b
d
= | − | + | 4 | 2 0.1109 0.02907 | (2.28)(10 )

10

w
pf | w | w
d

b
C | b | b
d

−

= | − | + | − 0.025
10

w
pf
d

b
C
d

= − 0.0375 0.000492

10

w
pf | w
d

b
C | b
d
= | − | + | 7 | 2 0.1109 0.000815 | (3.53)(10 )

10

w
pf | w | w
d

b
C | b | b
d

−

= | − | + | − 0.025
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
For this problem, bw = 2”, and

Cpm is the pinion proportion modifier; it is affected by the gear mounting location (see the figure below), and

Cpm = 1.0 if S1/S < 0.175
Cpm = 1.1 if S1/S ≥ 0.175

We will make S1 small and use Cpm = 1.

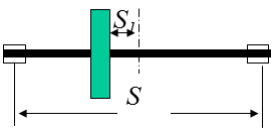
[picture p111: figure]

Figure 5-49 Gear mounting location, indicated by S1 and S.

Cma is the mesh alignment factor, and Cma = A +Bbw + C Bw

2
. Coefficients of this
equation is given in the table below.

Table 5-6 Factors A, B, and C for Cma bw in US custom units
Condition | A | B | C
Open gearing | 0.247 | 0.0167 | -0.765(10)⁻⁴
Commercial gears | 0.127 | 0.0158 | -1.093 (10)⁻⁴
Precision gears | 0.0675 | 0.0128 | -0.926(10)⁻⁴
Extra-precision gears | 0.00038 | 0.0102 | -0.822(10)⁻⁴

bw in mm
Condition | A | B | C
Open gearing | 0.247 | 6.57(10)⁻⁴ | -1.186(10)⁻⁷
Commercial gears | 0.127 | 6.22(10)⁻⁴ | -1.69 (10)⁻⁷
Precision gears | 0.0675 | 5.04(10)⁻⁴ | -1.44(10)⁻⁷
Extra-precision gears | 0.00036 | 4.02(10)⁻⁴ | -1.27(10)⁻⁷

For this example, we try a commercial unit, use

Cma = A +Bbw +Cbw

2

0.0375 0.0125
10
2
0.0375 0.0125(2)
10(3)
0.0542

w
pf | w
d

b
C | b
d
= | − | +
= | − | +

=

= 0.127 + 0.0158(2) -0.0001093(2)²= 0.1582 | (5-43)

Ce is the mesh alignment correction factor. It is 0.80 if gearing is adjusted at assembly and compatibility is improved by lapping; it is 1.0 for all other conditions.

Finally, we obtain, Km = Cmf =1.0 + Cmc(CpfCpm+CmaCe)
= 1.0 + (1)[(0.0542)(1) +(0.1582)(1)] = 1.212

If we use Figure 5-48 for bw/dp= 2/3 and bw =2”, Km =1.19~1.20. Not a bad choice.

Size factor: Ks.

The size factor accounts for the non-uniformity of material properties due to size. Ks = 1 if the gear modulus is no larger than 5 mm or diametral pitch no smaller than 5 (1/") for gears used in general-purpose machines.

Therefore, we use Ks = 1.

Generally, this factor can be found in the table below.

Table 5-6 Size factor

Diametral pitch (1/in) | Module (mm) | Size factor, Ks
≥ 5 | ≤ 5 | 1
4 | 6 | 1.05
3 | 8 | 1.15
3 | 12 | 1.25
1.25 | 20 | 1.40

Dynamic factor: Kv.

The dynamic factor is introduced to consider the impact loading that the gear set may experience. The value of the dynamic factor is related to the accuracy of the teeth, the properties of the material, and the speed of the gear. Kv can be calculated from the equations below.

ft in | min
200 | in m
s

B

v | B
A | V | V
A
K
A | V | V
| A
ìæ | ö +
ïç | ÷ ç | ÷ ïïè | ø

= í
ï æ | ö +
ï ç | ÷ ç | ÷ ïî è | ø

(5-44)

with
( | )
| 2 3 12 -
| 4
50 | 56(1- ) Qv
B
A | B

=

= +

(5-45)

An accuracy number (Qv) is needed in Equation (5-42). Its value may be chosen as follows.

Qv = 3 ~ 7 | commercial gears
Qv = 8 ~ 12 | precision gears

We can use Qv = 6 for a hig- quality commercial gear. Therefore,

( | ) | ( | )
2 | 2
3 | 3

0.826

12 - | | 12 - 6 | 0.826
| 4 | 4
50 | 56(1- ) | 50 | 56(1 - 0.826) | 59.7
59.7 | 1963 | 1.58
| | | 59.7

v

B

v

Q
B
A | B
A | V K
A
= | = | =
= | + | = | + | =
æ | ö | æ | ö + | +
= | = | = ç | ÷ | ç | ÷
è | ø | è | ø

Elastic factor: KE. The elastic factor is the coefficient for the elastic properties of the gear materials, which is defined by Equation (5-35) and used in the contact stress equation.

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
2 | 2 | 2

30 10

1 0.28 2

2
1 | 1

2
'

g

g

p

p

E

E | E
K | E
ν | ν

Geometric factors: Yj and I.

The geometric factors consider the effect of the involute curve on the stresses. The geometry factor for bending, Yj, is related to the tooth shape. Therefore, different gears should have different values of Yj (Hamrock et al., 1999, 2005, the figure below). For the current problem, the values for Yj are

Yjp = 0.32 and Yjg = 0.41

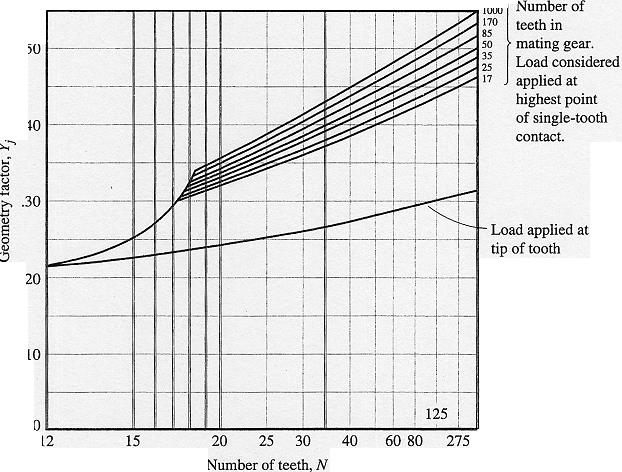
[picture p112: figure]

Figure 5-50 Geometric factor for bending stress (Hamrock et al., 2005). Note that the horizontal coordinate is about the gear under consideration, and the tooth number marked for each curve is for the mating gear.

However, there is only one value for the geometry factor for contact, I, because it is about the equivalent curvature and the contact geometry of two gear teeth. I can be calculated with Equation (5-36).

0.785

10.5

3
1

cos 20sin 20

1

cos sin
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
π | f | f π

g

p
d

d

I

(5) Stresses

The bending stress of the pinion is different from that of the gear.

For the pinion,

For the gear,

The italicized numbers mean that they may be different for the pinion and the gear.

a | s | m | v | i | b
w j

t
b | K K K K K K
b Y

W P
σ =
( | )
( | )

336(6) 1(1) 1.212 (1.58) 6032 psi 2

σ bp = | · | =
0.32 ( | )
( | )

336(6) 1(1) 1.212 (1.58) 4708 psi 2

σ bg = | · | =
0.412

The maximum surface contact stresses (pressures) for the gear and for the pinion are the same (action and reaction), which is

(6) Factors of safety

The factors of safety for bending for the pinion and the gear are

The factors of safety for contact for the pinion and the gear are

Although the contact stresses are the same, the factors of safety for surface-contact strengths are different, because the allowable stresses for the pinion and the gear are not the same.

The figure below shows the pinion of the gear set in this example.

1/ 2
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
a | s | m | v
w p

t
c | e | K K K K
b d I

W
σ K

( )

(1)(1)(1.212)(1.58) 66680 psi 0.785

1
2

336

c

= 705 | · | =
3

σ 5

,
,

,
,

39840 6.60
6032

28090 5.97
4685

all bp
bp
bp

all bg
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
= | = | =
= | = | =

,
,

,
,

102720 1.54
66680

87430 1.31
66680

all cp
cp
c

all cg
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
= | = | =
= | = | =

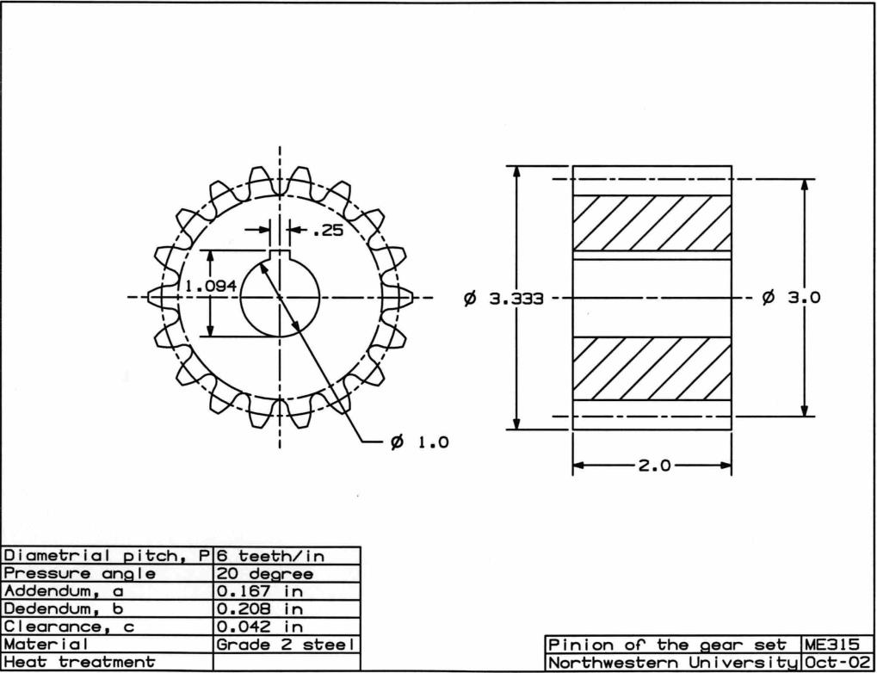
[picture p113: figure]
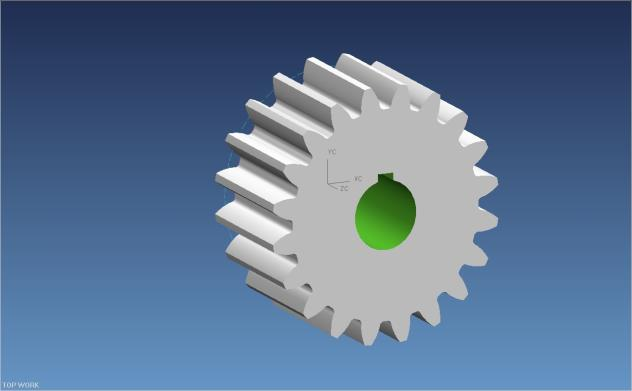
[picture p114: figure]

Figure 5-51 Pinion of the gear set of Example 5-7.

5-12 Helical gears

Spur gears have an intrinsic problem: the contact ratio is less than 2, which means that single-tooth pair meshing cannot be avoided. Helical gears are created to overcome this problem. Actually, helical gears have many advantages over spur gears. Because of the higher contact ratio, more pairs of teeth are in contact, making helical gear mesh smoother. For the same face with, the tooth of a helical gear is longer, and for the same gear parameters, the tooth of a helical gear is stronger because it is curved.

### 1 Helical gear geometry

Helical tooth surface generation. Instead of releasing a wire on a circle, let’s release a piece of paper that covers a cylinder (Figure 5-52). The trajectory of an inclined line on that paper will draw an involute surface along a helical direction. Obviously, the profile viewed from the front (the transverse plane) is a true involute profile.

Base circle | → Base cylinder
Generation line | → Generation surface
Straight tooth profile → Helical tooth profile

Figure 5-52 Comparison of tooth surface generation.

Figure 5-53 further compares a helical tooth with a spur-gear tooth from generation, meshing and pressure angles. Racks are illustrated for a more direct view. The helical angle is defined between the tooth tangent and the direction of the centerline. Accordingly, three planes should be defined: the transverse plane (or the front plane, or the plane of rotation), the normal plane (normal to the tooth profile), and the axial plane (parallel to the rotation axis). We will use subscripts n for the normal plane, t for the transverse plane, and x for the axial plane and their related parameters.

0

k

k0 B

Base cylinder

Generation surface
Helical tooth profile

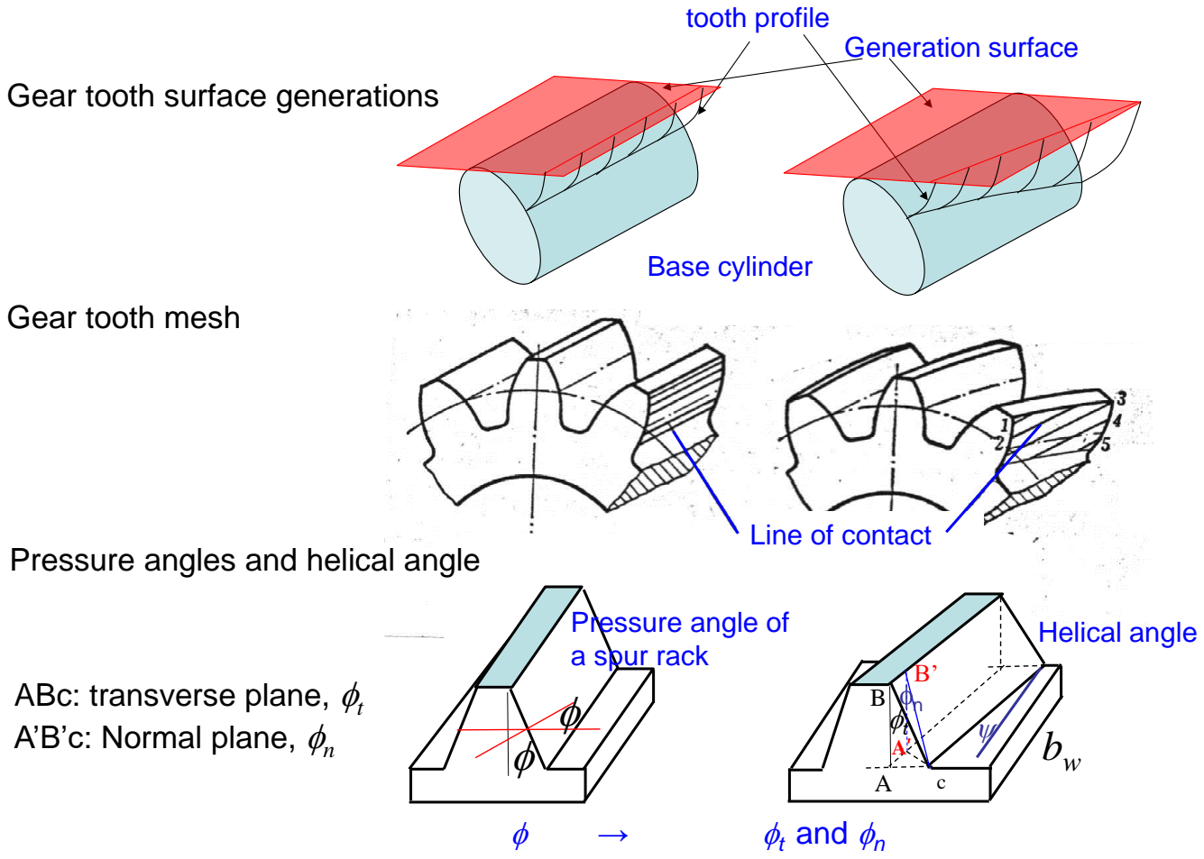
[picture p115: figure]
Generation surface; tooth profile; Base cylinder; Line of contact; ABc: transverse plane, ft; A’B’c: Normal plane, fn; Helical angle Pressure angle of a spur rack; ft and fn; Gear tooth surface generations; Gear tooth mesh; Pressure angles and helical angle

Figure 5-53 Comparison between spur and helical gear teeth. Subscripts n, t, and x are for the normal, transverse, and axial plane parameters. Middle plot modified from Pu et al.

New parameters. More parameters are needed to define a helical gear tooth. The helical angle, Ψ, is the one to know, and all other additional ones are due to this angle and are related to it.

Three pitches can be determined, Figure 5-54, the transverse pitch, pt = ac, to be defined later the normal pitch, pn = a’c, and the axial pitch, px = cd, as shown in the figure below. These pitches have the following geometric relationships.

a c

a’

| d

pt

pn

px

ψ bw

Adjacent profiles

Figure 5-54 Helical gear pitches demonstrated by helical rack profiles.

pn = pt cosΨ | (5-46-1)

px = pt
/ tanΨ | (5-46-2)

The pressure angles measured in the transverse and normal planes, fn, and ft, are also different. The relationship connecting Ψ, fn, and ft
is given below, which can be easily proven using the Figure 5-53 above.

cosΨ = tan fn

/tan ft
(5-47)

Module and diametral pitch. Although the tooth profile in the transverse plane is truly involute, with transverse module, mt, and the transverse diametral pitch, Pt
, the tooth standard is based on the normal plane to accommodate most machining needs. The normal module, mn, and the normal diametral pitch, Pn, are standardized.

Because
pn = pt cosΨ

and like what we have done for spur gears

pn = π/Pn = π mn | pt = π/Pt = π mt | (5-48)

We have
Pt = PncosΨ | (5-49-1)
mn = mtcosΨ | (5-49-2)

Addendum and dedendum are defined in the normal plane
a = 1/ Pn = mn | (5-50-1)
b = 1.25/ Pn= 1.25mn | (5-50-2)

Gear diameters are defined at the rotation (transverse) plane, which are:

d = dt = N/Pt = N/(Pn cosΨ) = N mt
(5-51-1)
dbt = d cosft
(5-51-2)
dot = dt + 2a = dt + 2mn | (5-51-3)
drt = dt – 2b = dt – 2.5mn | (5-51-4)

Conditions for helical gear meshing. Now we have one more independent parameter, the helical angle. The conditions for spur gears are modified and enriched as follows.

US custom:
Ppn = Pgn = Pn | fpn = fgn = fn | (5-52)

Metric:
Mpn = mgm = mn | fpn = fgn = fn | (5-53)

And | Ψp = -Ψg
for external gear pair | (5-54)
Ψp = Ψg
for internal gear pair | (5-55)

In general, for external gears, ψp +ψg = shaft angle. For our worm and gear set in Chapter 1, ψp +ψg = 90 degree.

Equivalent pitch circle and virtual number of teeth. These are for the need of gear manufacturing. The cutting force is along the tooth-surface normal direction. The normal cross section of a helical gear by “cutting” through the tooth at its pitch point along its normal direction across the gear cylinder gets an elliptical shape, as shown in Figure 5-55. An equivalent pitch circle, as if it were the cutter circle, is defined at the pitch point using the radius of curvature there, as shown in the figure below by the equivalent radius of curvature, re. For the ellipse with semi major and minor axes a and b, the equivalent radius of curvature at the pitch point, p, is

re = a

2
/b = (r/(cosΨ)

2
/r = r/(cosΨ)

2
(5-56)

Note that r is the radius of the pitch cylinder (or pitch circle) of the gear. Correspondingly, more teeth, N’, are needed to cover the equivalent pitch circle, and N’ is defined as the virtual number of teeth:

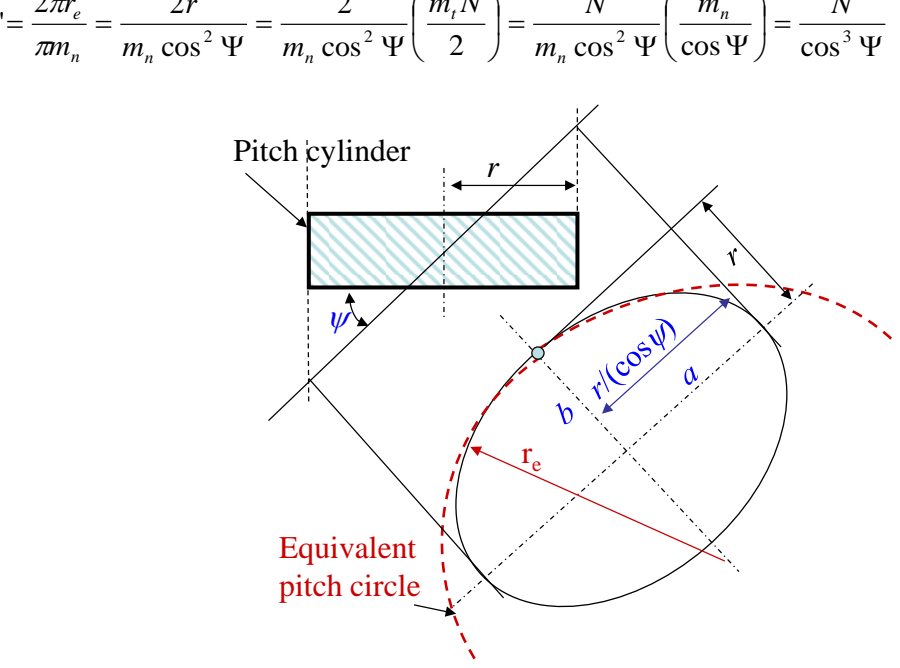
[picture p116: figure]
cos; Pitch cylinder; Equivalent pitch circle

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
2 | 2
'
m | N
m N | N
r

r
N

π
(5-57)

Figure 5-55 Equivalent pitch circle and the ellipse from the cut cylinder.

Contact ratio. Helical gear contact ratio comes from two parts, transverse and axial. The former is the same as that of a spur gear, Cr (defined in the transverse plane), and in the equation below, pc is pt. The axial contact ratio, Cra, which is the second term in the equation below, significantly enhances the overall contact ratio. It corresponds to the move of contact, across the face width axially, from one pair of teeth to the next, which is bw/px, and px = pn/sin ψ.
[ | ]

n

w

c

d
op | bp | og | bg
x | c

w
rh | r | ra | r
p

b
p

c
r | r | r | r
p | p

b
C | C | C | C
f | ψ
f
tan | sin
cos
1 | 2 | 2 | 2 | 2
ú ⁺
û

ù
ê
ë

é
= | + | = | + | = | − | + | − | − | (5-58)

Example 5-8. A helical gear of 18 teeth is given, its normal pressure angle is 20⁰
, its helical
angle is 12⁰
, and its transverse diametral pitch is 6 teeth/in. Determine: (1) the pitch diameter, (2) the normal diametral pitch, (3) the transverse, normal, and axial circular pitches, (4) the transverse pressure angle, (5) outside diameter, (6) radius of the equivalent pitch circle, and (7) contact ratio if the mating gear has 41 teeth.

Solution

(1) dt = N/Pt = 18/6 = 3”
(2) Pn = Pt

/cosΨ =6/cos120 = 6.134”
(3) pt = π/Pt = π/(6) =0.5235” pn = ptcosΨ = (0.5235)cos12⁰
= 0.5122”
px = pt

/tanΨ = (0.5235)/tan12⁰
=2.4633”
(4) ft = tan⁻¹

(tanfn/cosΨ) = tan⁻¹

(tan20⁰

/cos 12⁰

) = 20.41⁰
(5) dot = dt + 2a = 3 + 2/Pn = 3 + 2/6.134 = 3.326”
(6) re = r/(cosΨ)2 = (dt/2)/(cos12⁰

)2 = (3/2)/(cos12⁰
)

2
= 1.5677”

(7)

[ | ]

n

w

t

dt
opt | bpt | ogt | bgt
x | t

w
rh | rt | ra | rt
p

b
p
c | t
r | r | r | r
p | p | t

b
C | C | C | C
f | ψ
f
tan | sin
cos
1 | 2 | 2 | 2 | 2
ú ⁺
û

ù
ê
ë

é
= | + | = | + | = | − | + | − | −

Cr

dot1
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
dbt1
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
dot2
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
dbt2
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
+ | −

pt·cos(ft)

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
tan(ft)

pt

é
ê
ë

ù
ú
û
− | bw

sin(ψ)

pn

:= | + | ·

=2.389
While the contact ratio in the transverse plane (corresponding to that for a spur gear) is only

Cr1

dot1
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
dbt1
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
dot2
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
dbt2
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
+ | −

pt·cos(ft)

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
tan(ft)

pt

:= | −

= 1.577

What about all these if the normal diametral pitch = 6 teeth/in?

### 2 Helical gear design

Helical gear force. Like the spur gears, the force on a helical gear tooth is applied through the surface of its mating tooth. It is normal to the tooth surface. The following figure and equations show the force on a helical gear tooth and its resolution to three orthogonal components.

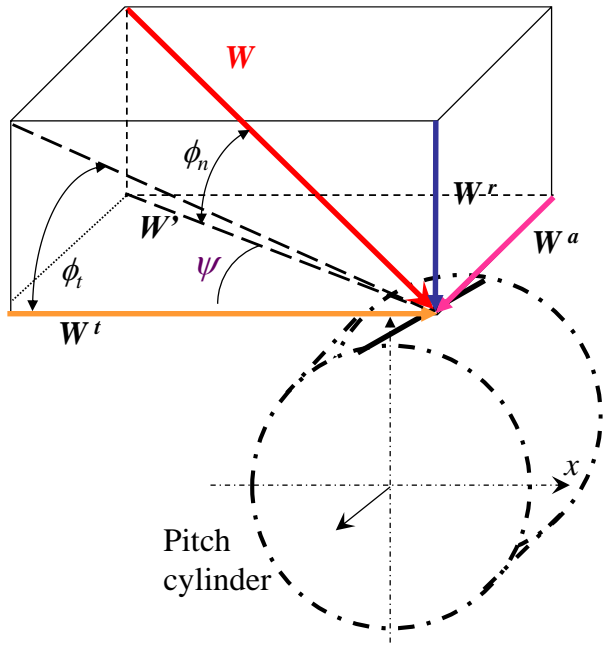
[picture p117: figure]
Pitch cylinder

Figure 5-56 Helical gear force and components, subscripts n, r, a, and t are for the normal, radial, axial, and transverse (tangential) directions.

Wr = W sin fn | | (5-59-1)
Wt = W cos fn cosψ | (5-59-2)
Wa = W cos fn sinψ | (5-59-3)
Torque: | T = Wt (d/2) | (5-60)

Bending stress. Again, the well-accepted AGMA approach is used, i.e., the root beading stress, σb, should be smaller than an allowable bending stress, σall,b.

σ b ≤ σ all,b
(5-61)

nb σ all b σ b
/ =
| ,

(5-62)

The bending stress is defined in the following formulae similar to those for spur gears (Juvinall and Marshek, 2000).

a | s | m | v | i | b
w | j

t
b | K K | K K K K
b mY

W
σ = | (0.93 | )
Metric | (5-63)
a | s | m | v | i | b
w j

t
b | K K | K K K K
b Y

W P
σ = | (0.93 | )
English | (5-64)

Here, m = mt

, the module in the transverse plane, and P= Pt , the diametral pitch in the transverse plane. The load distribution factor, Km, is the value for spur gears reduced by 0.93 (Juvinall and Marshek, 2000). The geometry factor, Yj, is different from that for spur gears. All other factors, Ka, Ks, and Kv, Ki, Kb,, are the same as those for spur gears.

Contact stress. Again, the AGMA approach is used for the surface strength analysis, i.e. the maximum contact stress should be smaller than an allowable contact stress.

σ c ≤ σ all,c

(5-65)

nc σ all c σ c
/ =
,

(5-66)

The contact stress is (Juvinall and Marshek, 2000).

1/ 2
(0.93 )
0.95

1 cos
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
a | s | m | v
w | pt | r

t
c | e | K K | K K
b d I | C

W
σ K

(5-67)

Contact ratio in the transverse plane, Cr, for Ψ = 8~30⁰
, may be roughly 1.64~1.38. This is only for an approximate calculation. For an accurate design, we need to use the accurate equation for the transverse contact ratio or AGMA charts. Note again KE
is defined differently from that in the Shigley book, and so is I, in the way “2” and “π” are placed.

g

g

p

p

E

E | E
K | E | 2 | 2
1 | 1

2
'
| | ν | −ν
+

−

= | = | (5-68)

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
t | t

d

d

I
1

π cosf sin f
(5-69)

Example 5-9

Given: A gear train of a pinion and a gear.
The train value: | 3.5:1
NP = 18, | Ng = (3.5) 18 = 63

Transverse module | mt = 4 mm
Helical angle | Ψ = 150
Power and speed on the pinion shaft:
H = 20 HP, | nP = 2500 rpm
Driven by an electric motor, no shock, 5 years, one shift, 99% reliability.

Solution

(1) Gear geometry

4(18) 72mm

4(63) 252mm

pt | t | p
Gt | t | G
d | m N
d | m N
= | = | =
= | = | =

0
cos | 4cos15 | 3.863mm
3.863mm
1.25 | 4.829mm
n | t

n

n

m m
am
b | m
= | Ψ = | =
= | =
= | =

Let’s choose the middle value from the following empirical formula for the face width.

m b m

P

b
P

w

w
8 | 16
8 | 16
< | <
< | <

bw

≈12mt

=12(4) = 48mm

The face width here is nominal. Again, the pinion is made slightly wider (2-5 mm).

(2) Tangential force
(33000) | (33000) | 20(33000) | 1582N 72 2 (2500) 2 | 2(60) 2(60)
t

pt

H | H W
V | d n
π π
= | = | = | =

Note, the pitch circle velocity is V= 9.425m/s.

(3) Materials and Allowable stresses
Steel gears | E = 210 MPa; ν = 0.28 | through hardened
Pinion – 300 HB | Grade 2 σall,Pb = 327MPa, σall,Pc = 945 MPa
Gear – 250 HB | Grade 1 σall,Gb = 223MPa, σall,Gc = 786 MPa

Similarly, a hardness difference of 50-100 HB should be maintained.

Cycle of the pinion = 5 (365x8)(60) (2500rpm) = 2190Million Cycle of the gear = 5 (365x8)(60) (2500rpm/3.5) = 625.71Million

YN = 1.6831N⁻⁰.0323, YNP = 0.840 YNG = 0.875 ZN = 2.466N⁻⁰.056, ZNP = 0.739 ZNG = 0.793

HBP /HBG = 1.2
CHG = 1.0 + A’(NG /NP – 1.0) = 1.0 + 0.00249(3.5 – 1.0)= 1.00621 Therefore,
(4) Factors for stresses

The factors for stress are included in the formulas for the bending and contact stress.
Application factor: Ka. Table 5-4 lists some values of the application factor. Again, for a system powered by an electric motor, the load and speed are usually smooth without obvious shock. Therefore, Ka = 1 should be the choice.

For this problem, an electric motor without shock is used as the power supplier. Therefore, Ka = 1

Size factor: Ks. We use Ks = 1.

Dynamic factor: Kv.

( | )
| 2 3 12 -
| 4
50 | 56(1- ) Qv
B
A | B

=

= +

,

(327)(0.84) 274.7
(1)(1)

bN
all bp
T | R
SY | MPa
KK
σ | = | = | =

,

(223)(0.875) 195.1
(1)(1)

bN
all bg
T | R
SY | MPa
KK
σ | = | = | =

,

(945)(0.739)(1) 698.4
(1)(1)
c | N | H
all cp
| T | R
S Z C | MPa
KK
σ | = | = | =

,

(786)(0.793)(1.00621) 627.2 (1)(1)

c | N | H
all cg
| T | R
S Z C | MPa
KK
σ | = | = | =
ft in | min
200 | in m
s

B

v | B
A | V | V
A
K
A | V | V
| A
ìæ | ö +
ïç | ÷ ç | ÷ ïïè | ø

= í
ï æ | ö +
ï ç | ÷ ç | ÷ ïî è | ø

Qv = 3 ~ 7 | commercial gears
Qv = 8 ~ 12 | precision gears

We also use Qv = 6 for a high-quality commercial gear. Therefore,

Elastic factor: KE. The elastic factor is the coefficient for the elastic properties of the gear materials.

Pa

E | E
K | E

g

p

p

p

E | 477352

210 10

1 0.28 2

2
1 1

2
'

9

2 | 2 | 2

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
= | =
ν | ν

Geometric factors: Yj and I. The geometric factors consider the effect of the involute curve on stresses. The geometry factor for bending, Yj, is related to the tooth shape. Therefore, different gears should have different values of Yj. For helical gears, each Yj comes from two portion, the value for mating with a 75-tooth gear and a correction factor (Juvinall and Marshek, 2000, Figure 5-57. For the current problem, the values for Yj are

Yjp = 0.5x0.995 = 0.498
Yjg = 0.6x0.93 = 0.558

However, there is only one value for the geometry factor for contact, I, because it is about the equivalent contact geometry of the two gears.

0.785

63

18 1

cos 20sin 20

1

cos sin
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
π | f | f | π

g

p

t | t

d

d

I

( | ) | ( | )
2 | 2
3 | 3

0.826

12 - | | 12 - 6 | 0.826
| 4 | 4
50 | 56(1- ) | 50 | 56(1 - 0.826) | 59.7
| | 59.7 | 200(9.425) | 1.72
| | | 59.7

v

B

v

Q
B
A | B
A | V K
A
= | = | =
= | + | = | + | =
æ | ö + | æ | ö +
= | = | = ç | ÷ | ç | ÷ ç | ÷ | ç | ÷ è | ø | è | ø

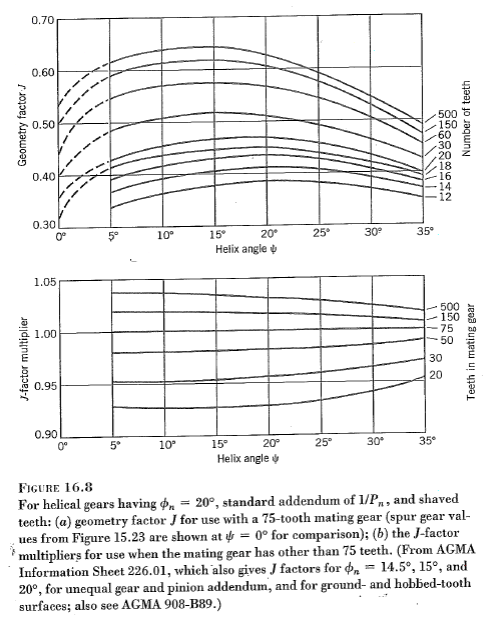
[picture p118: figure]

Figure 5-57. Geometry factor Yj for helical gears. Here J is Yj we used.

Load distribution factor: Km. Let’s use the simpler way. Use bw/dp in Fig. 14.23 in Hamrock’s book (1999) to determine Km and use the same Km for both gears because their load distributions are the same.

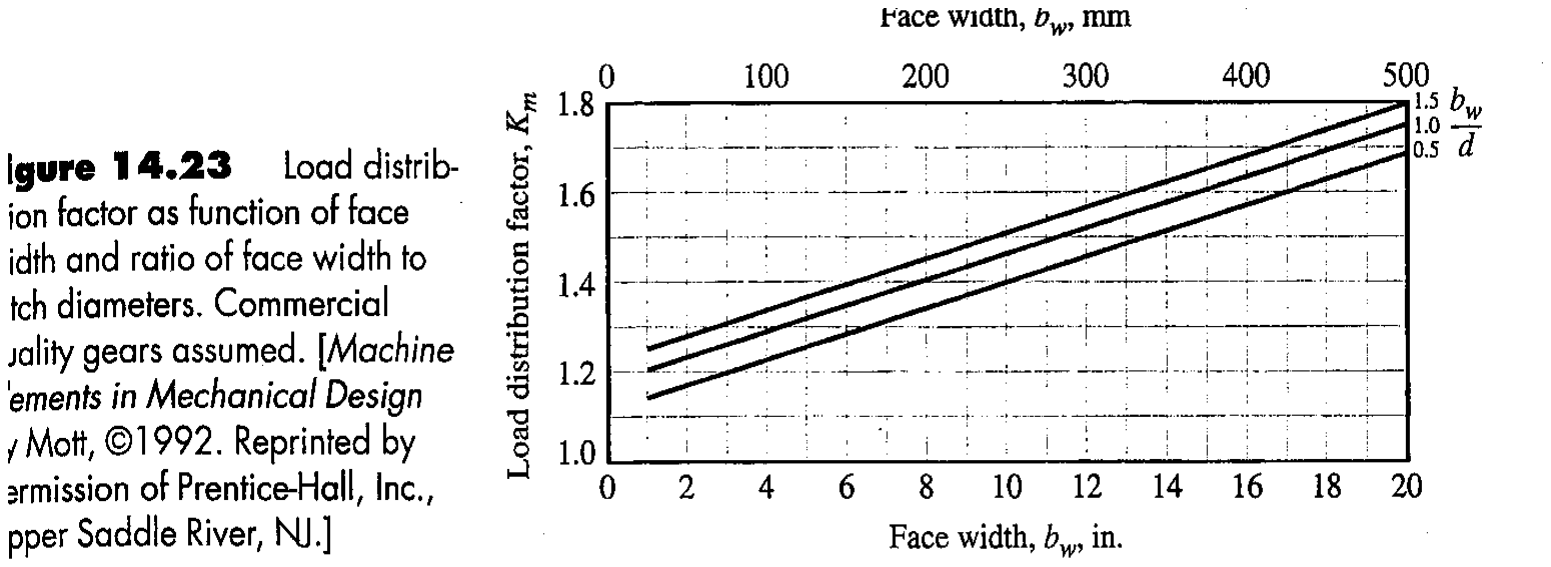
[picture p119: figure]

Copy of Figure 5-48 Simplified load distribution factor chart.

For simplicity, we select a proper value, Km = 1.19.

(5) Stresses

The bending stress of the pinion is different from that of the gear.

a | s | m | v | i | b
w | j

t
b | K K | K K K K
b mY

W
σ = | (0.93 | )
( | )

1(1)(0.93)(1.19)(1.72)(1)(1) 31.5 MPa 0.048(0.004)

1582
Pb = | · | =
0.498

σ

( )

1(1)(0.93)(1.19)(1.72)(1)(1) 28.1MPa 0.048(0.004)

1582
Gb = | · | =
0.558

σ

The italicized numbers mean that they may be different for the pinion and the gear.

The maximum surface contact stresses (pressures) for the gear and for the pinion are the same (action and reaction).

1/ 2
(0.93 )
0.95

1 cos
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
a | s | m | v
w | pt | r

t
c | e | K K | K K
b d I | C

W
σ | K
(1)(1)(0.93)(1.19)(1.72) | 406MPa
0.95(1.56)

cos15
0.785

1
0.048(0.072)

1582 477352

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
σ = | ·

Here, Cr ~ 1.56.

(6) Factors of safety

The factors of safety for bending for the pinion and the gear are

,

,
,

274.7 8.7
31.5

195.1 6.9
28.1

all bp

P

all bg
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
= | = | =
= | = | =

The factors of safety for contact for the pinion and the gear are

, ,
,

,
,

698.4 1.7
406

627.2 1.5
406

c all cp
cp
c

all cg
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
= | = | =
= | = | =

Although the contact stresses are the same, the factors of safety for surface contact strength are different because the allowable stresses for the pinion and the gear are not the same.

This gear set has nearly the same geometry as that of the set in Example 5-7. Clearly, helical gears have better strength.

5-13 Example of gear transmission
An automobile automatic transmission may be constructed with a hydraulic coupling system and double-row planetary gear systems, or compound epicyclic planetary gear sets, usually referred to as the Simpson planetary gear system. A torque converter, which is a fluid coupling system that hydraulically connects the engine to the transmission, is usually used with the gear system. A gear pump is mounted between the torque converter and the planetary gear system. Vehicles conforming to the US Government standards must have the modes ordered of P-R-N-D-L, which means parking, reverse, neutral, drive, and low (or 1) for winter drive, etc, although each company has its own drive modes in different detail.

Fluid torque
converter

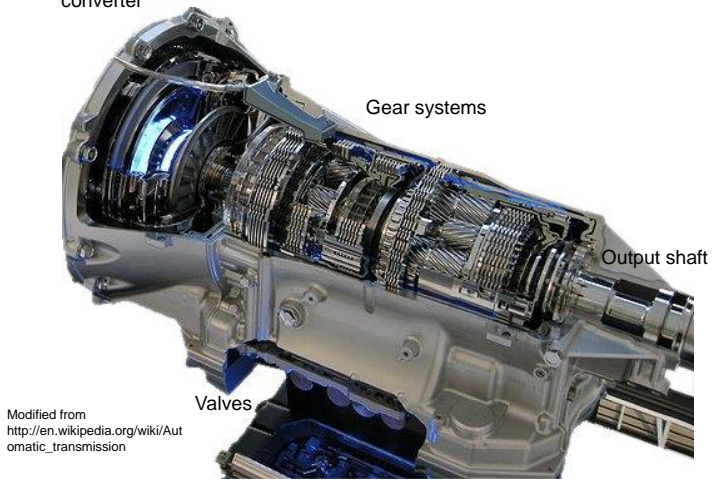
[picture p120: figure]
http://en.wikipedia.org/wiki/Aut omatic_transmission; Gear systems; Valves; Output shaft

Modified from

Figure 5-58 A typical automatic transmission with planetary gear systems.

The following figure shows the gear train set of a typical automatic transmission, the Simpson planetary gear system, which is a duel planetary gear system. Three couplings, one of them is a one-directional coupling, and one brake are involved in the control of 6 modes, namely P, R, N, D, 2, and L (1) the low-speed mode. D has three forward speeds, 2 has two that allow speed changes from 1~2, while L has only one speed. In this system, front carrier 4 is linked to back ring gear 8, leading to narmf = nrb.

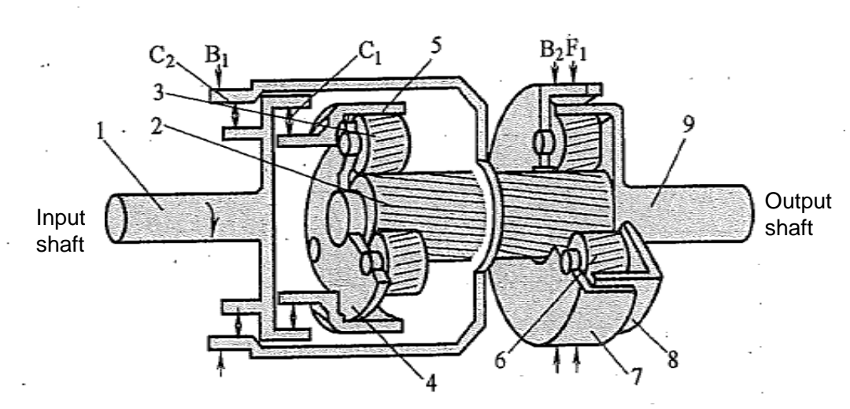
[picture p121: figure]
Input shaft; Output shaft

1- input shaft | 2 – sun | 3- front planetary gearset | 4- front carriage
5 – front ring gear | | 6 –back planetary gearset | 7- back carriage
8- Back ring gear 9- output shaft
C1: forward clutch | | C2: high back clutch | B1: brake
B2: low back clutch | | F1: one-direction clutch

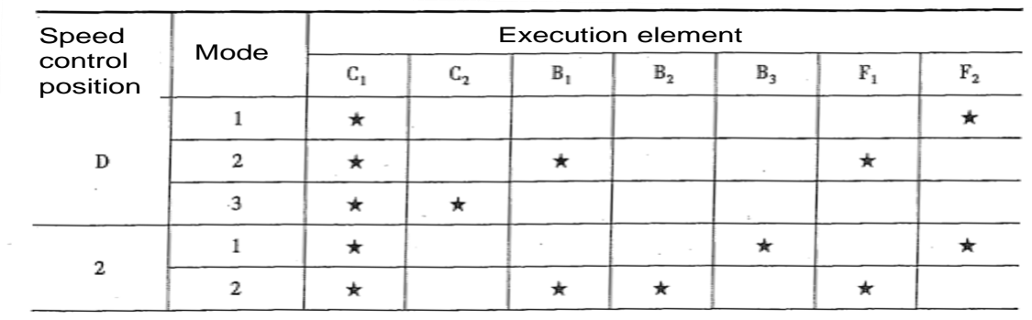
[picture p122: figure]
Execution element Mode; Speed control position

Figure 5-59. Simpson system, its drive modes and execution element (Modified from Yao [2009]). We may call the input side the front system and the output side the back system.

At the D1 mode, C1 is engaged to make the front ring gear the input device, F1 is fixed so that the back system becomes a fixed-axis system (arm b, or the carrier of the back system, 7, is fixed).

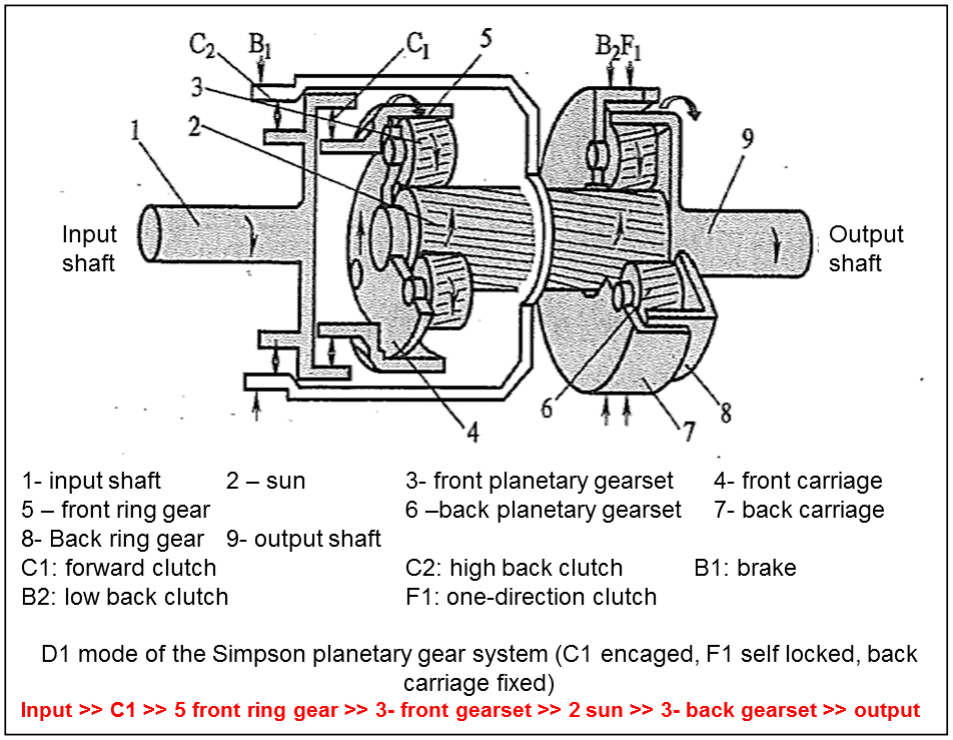
[picture p123: figure]

Figure 5-60. Simpson system again with motions shown for the D1 mode (Modified from Yao [2009]

The above system can be simplified and illustrated by the following diagram of two planetary systems coupled with the front carrier - back ring link and the common sums on the same shaft.

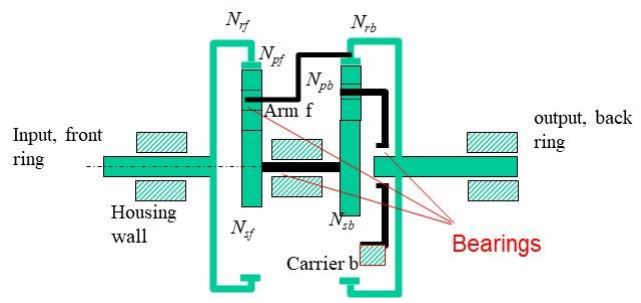
[picture p124: figure]

Fig. 5-61 D1 mode diagram of the two coupled planetary systems

Knowing the tooth numbers, Nsf, Npf, Nrf, Nsb, Npb, Nrb, and nsf = nsb, narmf = nrb, we can determine the ratio of the input and the output, nrf/nrb. Arranging the solution in terms of Nrf/Nsf and Nrb/Nsb

If C1 is engaged to make the front ring gear the input device, F1 is not fixed so that the back arm (back carrier) has speed nab. Knowing the tooth numbers, Nsf, Npf, Nrf, Nsb, Npb, Nrb, we can determine the output speed nrb in terms of the input speed, nrf, the back carriage speed, nab, and Nrf/Nsf and Nrb/Nsb, etc. Note that the front arm (or front carrier) is connected to the back ring (naf = nrb). This time, we have two inputs nrb and nrf, each in one planetary system.

Front | back

Result

The above is Forward 2 (D2), where C1 is engaged, so that the front ring gear inputs.

If B1 is engaged, the common suns are fixed, but F1 is freed, the back system is a free system (the back carriage is released). Now

Front | back

sf

rf

rf | rb
sf | rb
N

N
n | n
n | n | 1 = (−1)
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
rf | rb
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
= | + | +

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
+ | +
= | =

1

1

( | ) rf | rb

sf

rf
sf | rb | n | n
N

N
n − n = − | −

rb
sf

rf
rb
sb

rb
rf | rb
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
= | + | +

sf

rf

rf | rb
sf | rb
N

N
n | n
n | n | 1 = (−1)
−
− | sb
rb
rb | ab
sb | ab
N

N
n | n
n | n | 1
= (−1) −

−

( | ) | ( | ) rf | rb

sf

rf
rb | ab | ab | rb
sb
rb | n | n
N

N
n | n | n | n
N

N
− | − | + | − | = − | −

n
sf

= n
sb

, n
armf

= n
rb
( | ) rb | ab | ab

sb

rb
sb | sf | n | n | n
N

N
n = n = − | − | +

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
rf | n
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
æ − +
÷
ø

ö
ç
è

æ
= | + | +1 | 1

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
( | ) rf | rb

sf

rf
sf | rb | n | n
N

N
n − n = − | −

n
sf

= n
sb

=0, n
armf

= n
rb

sf

rf

rf | rb
sf | rb
N

N
n | n
n | n | 1 = (−1)
−
− | sb
rb
rb | ab
sb | ab
N

N
n | n
n | n | 1
= (−1) −

−

( | ) rf | rb

sf

rf
sf | rb | n | n
N

N
n − n = − | −
( | ) rb | ab

sb

rb
sb | ab | n | n
N

N
n − n = − | −

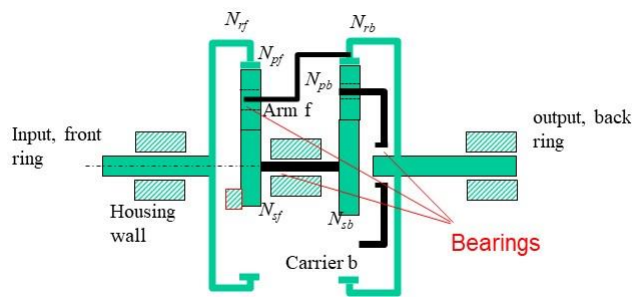
[picture p125: figure]

Chapter summary

This chapter introduces transmission elements; however, the focus is on gears and gearing mechanisms. Both spur and helical gears are studied, and gear-train analysis methods are formulated. Moreover, the concepts of conjugate action, conjugate profiles, and involute curves are introduced; gear geometries are explained, and gearing processes are discussed. This chapter also deals with the methods for gear force analyses and tooth bending and contact stress calculations. Gear design analyses are also explained and practiced.

References
Hamrock, B., Jacobson, B., and Schmid, S., 1999, 2005, Fundamentals of Machine Elements, McGraw Hills.
Shigley, J. and Mischke, C., 1989, 2001, Mechanical Engineering Design, McGraw Hills. Juvinall, R. and Marshek, K., 2000, Fundamentals of Machine Component Design, John Wiley and Sons, Inc.
Yao, J., 2009, Automatic Transmission, China Machine Press.
Pu, L., Chen, D., and Wu, L., 2013, Machine Design, China Higher Education Press.
Media: | Several U-Tube movies are on line. 315 students should watch the short U-
Tube movies before the classes.
( | ) | ( | ) rb | ab

sb

rb
rf | rb | ab
sf

rf
rb | n | n
N

N
n | n | n
N

N
n − | − | = | − | −

ab
sb

rb
rf | ab
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
rb | n
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
n + | + | = | + | +
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
