ChristopherLuey/315-MechanicalDesign/Ebook/eBook/Chapter8-Bolted.pdf

Chapter 8 | Threads and Bolted Connections
8-1 | Introduction to threads and fasteners

Wedge and thread. From elementary mechanics we know that a wedge can help save effort. If we wrap a wedge of angle α around a cylinder of radius r, we create a thread, as shown in Figure 8-1. For one turn of the thread, the lift is 2πr tanα, which defines the term, lead, or Ld.

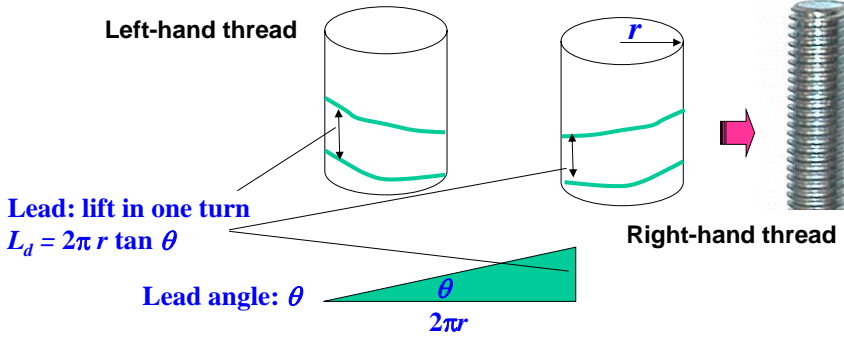
[picture p126: figure]
Lead: lift in one turn Ld = 2π r tan q; Lead angle:; Left-hand thread; Right-hand thread

Figure 8-1 From a wedge to a thread, definition of lead, Ld.

Thread geometry. A thread may be internal, as that of a nut, and external, as that of a bolt. Figure 8-2 shows the geometry of both internal and external threads. The nominal (or basic) diameter of a thread is the outside diameter of an external thread, or the inner diameter of an internal thread. It is called the major (or crest) diameter, which is the largest diameter of the thread. We can also define the other diameters, the root (or minor) diameter and the pitch (or mean) diameter, as shown in Figure 8-2 and Table 8-1. The term, pitch, is defined as the distance between two adjacent thread teeth. The typical thread angle is 2α = 60⁰
| . Think, if lead =
pitch?

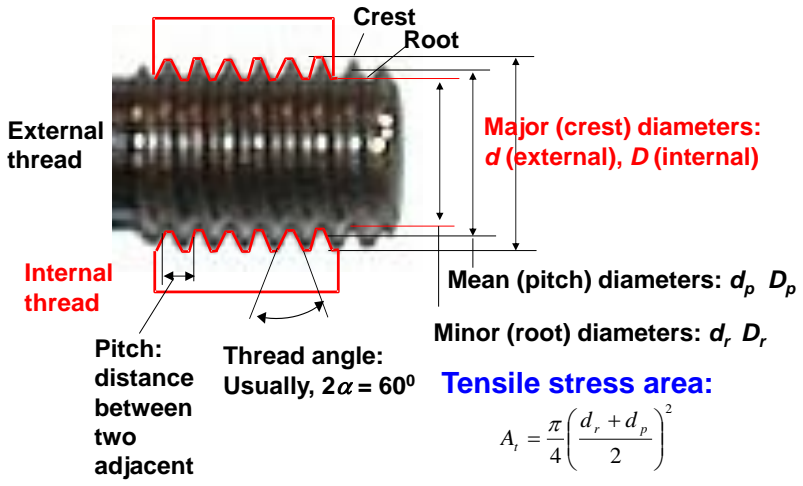
[picture p127: figure]
CrestRoot; Major (crest) diameters: d (external), D (internal); Mean (pitch) diameters: dp Dp; Usually, 2α = 60⁰; External thread; Internal thread; Pitch: distance between two adjacent; Tensile stress area:

Minor (root) diameters: dr Dr Thread angle:

profiles

Figure 8-2 Internal and external threads, diameters, and thread angle.

Table 8-1 lists the symbols used for internal and external threads, as well as the relationship between lead and pitch. The calculation of the tensile stress area, At, shown in Figure 8-2, is also included in this table. Tensile stress area At is the effective area that supports a tensile load; it is the area at which the bolt stress is calculated. At is not determined by the pitch diameter or the internal diameter, but a diameter in between.

Table 8-1 Diameters, pitch, lead, and tensile stress area

External thread Internal thread
Major (Nominal) diameter | d | D
(Crest diameter of a bolt)
Minor diameter | dr | Dr
(Root diameter of a bolt)
dr = d - 1.226869p (Metric) dr = d - 1.299038p (US)
Mean diameter | dp | Dp
dp = (dr+dp
)/2
Pitch, | p
Lead, | Ld | Ld = n p
Number of thread, | n

Tensile stress area

2

4 | 2
r | p
t

d d
A
π æ | ö +
= | ç | ÷ è | ø

Thread length determination is largely empirical from the general engineering practice. Table 8-2 lists several suggestions for the thread length choice based on the bolt (thread) diameter.

Table 8-2 Thread length, Lt

Metric bolts
2d +6 | L≤125
2d +12 | 125<L≤200
2d +25 | L>200
US bolts
2d +1/4” | L≤6”
2d +1/2” | L>6”

Thread classification. Threads may be classified based on thread geometry, thread direction, number of threads, thread series, and thread functions.

Based on thread function: A thread may be used for fastening, adjustment, or transmission of power and motion.

Based on thread geometry: There are three commonly used shapes, sharp V, square, and ACME (trapezoidal), shown in Figure 8-3. The thread angle for the ACME thread is 2α = 29⁰

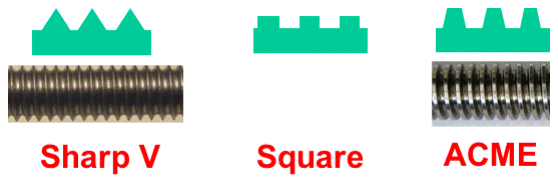
[picture p128: figure]

Figure 8-3 Thread geometry

Based on thread direction: There are two types of threads based on the thread direction, the right-hand thread and the left-hand thread, shown in Figure 8-1. A left-hand thread must be specified by LH.

Based on the number of threads. A thread may be a single-start, double-start, or multiple-start thread, as shown below. This answers the question asked before and explains why Ld = n p in Table 8-1.

p | p | p | Ld
Single start | Double start | Triple start

Ld Ld

Figure 8-4 Single, double, or triple start thread, and the lead-pitch relationship

Based on thread series: UN (Unified) threads are commonly found in the US market, including the UNC (course), UNF (fine), and UNR (root modified) series. UNR means that the root radius of the thread is modified to improve the thread fatigue strength.

Metric and English threads are expressed differently, as shown in Figure 8-5; however, both the nominal diameter and the pitch information should be given. This figure also indicates how an internal and an external thread should be dimensioned in a drawing.

US: | ¾ - 10 UNC | Threads per inch
| | Nominal diameter
Metric: | M12x1.75

Pitch (mm) Nominal diameter (mm)

M12x1.75 | M12x1.75
Figure 8-5 | Thread expressions.

8-2 Bolt in a tensile connection (joint)

Bolts are threaded cylindrical elements. Figure 8-6 shows several samples of bolts and nuts. A bolt may have a threaded and an unthreaded portion, depending on the length of the bolt. A washer face may be made as if a thin washer were integrated with a bolt hexagon head or a nut.

A tensile connection is a structure where several members are clamped by a bolt and a nut (or an element that functions like a nut) to support a load. The load can be tensile or other types, like shear, bending, etc. The members may be plates, flanges, walls, and washers. A bolt in a tensile connection is preloaded and then further stretched when a tensile work load is applied. The members are pre-compressed and then released more or less under this tensile load.

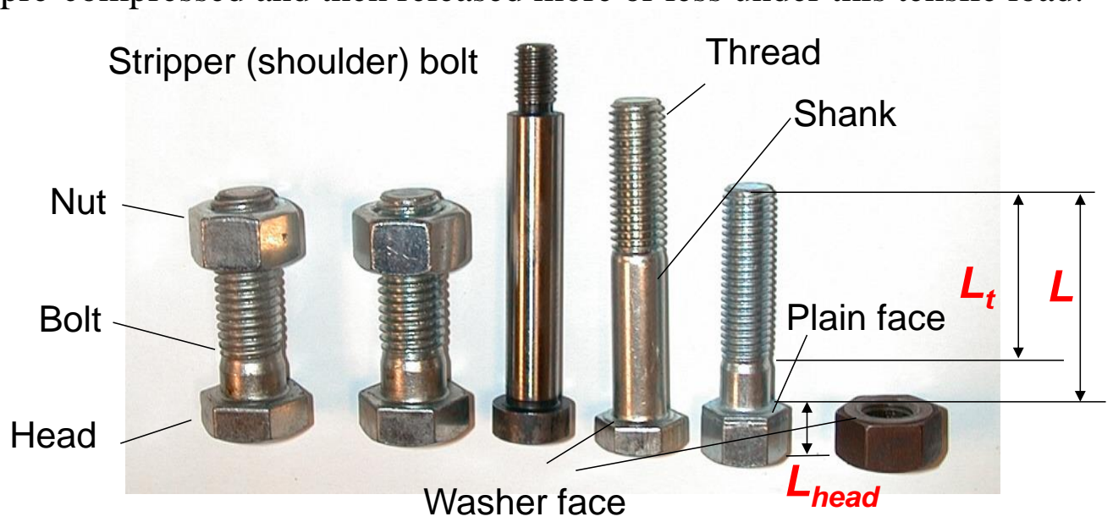
[picture p129: figure]
Head; Nut; Bolt; Stripper (shoulder) bolt; Thread; Shank; Lhead; Washer face; Plain face

Figure 8-6 Samples of bolts and nuts; lengths of a bolt and its thread, L and Lt, and thickness of the bolt head, Lhead, are also shown.

Our work in this section will be focused on bolted connections in tensile loading, and our major concerns are bolt strength (against plastic deformation and fatigue) and joint security (anti-loosening). The former means that a particular stress in a bolt cannot exceed the corresponding strength of the bolt in use while the latter guarantees no separation appears in the joint. We need to define several items before doing the analysis. The term, grip, is for the clamping length between the two washer faces of the bolt and the nut in a joint. Washers may still be used next to the washer face of a bolt or nut. Washers protect the surfaces of members that are usually more expensive than the bolts and washers; they increase the load application area and reduce edge stress concentrations due to tightening at the member surfaces around the nut and the bolt head. They help create flat areas for a bolt assembly if the members are cast pieces. Several lengths are defined as follows and plotted in Figure 8-7.

L | Bolt length: | L = lG + lnut + 2 ~ 5 mm
Lt | Thread length: Lt = 2d + 6 mm (or ¼”) for L ≤ 125 mm (6”)
ld | Length of the unthreaded portion of the bolt in the grip
lG | Length of the grip = summation of the member thicknesses
lt | Length of the threaded portion of the bolt in the grip: lt = lG - ld

In order to calculate the stress in a bolt, we need to analyze the force in the bolt. However, a bolted joint is complicated, statically indeterminate; we need to determine the bolt force from the

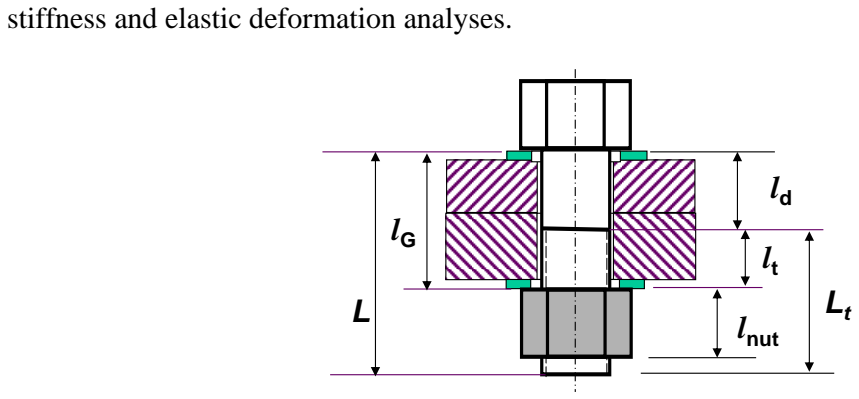
[picture p130: figure]
stiffness and elastic deformation analyses.; lnut

Figure 8-7 Bolted connection, the bolt, the nut, and the members, which are the two plates and two washers here. Several related dimensions are also shown.

Bolt stiffness, kb
. A bolt may have two portions: the threaded and unthreaded portions. These two different sections of the bolt should be modeled as springs of different stiffness values in series. Figure 8-8 shows such springs and the notations used.

kd Ad

kt At

b: bolt
d: unthreaded portion
t: threaded portion
e: equivalent
E: elastic modulus
d: Deformation
k: stiffness
A: area

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
Figure 8-8 Bolt stiffness. A bolt in a tensile connection and the equivalent springs.

As two springs in series, the total deformation of a bolt is the sum of the deformations of both portions.

db = dd + dt | (8-1)

The deformations of the unthreaded and threaded portions of the bolt are

de
d
d

Fl
EA

d =
(8-2)

te
t
t

Fl
EA

d =
(8-3)

Equation (8-1) yields the following stiffness expression

b | d | t
k | k | k
1 | 1 | 1
= | +
(8-4)

With

0.4

t | t
t
t | te | t | r
F | A E | A E k
d | l | l | d
= | = | =
+

(8-5)

0.4

d | d
d
d | de | d
F | A E | A E k
d | l | l | d
= | = | =
+

(8-6)

Member stiffness, km. Members can also be modeled as springs in series, as indicated by Equation (8-7). However, the stiffness analysis is more complicated because members are only stressed locally. The concept of frustum cones is utilized for the analysis, which assumes that only the region within the frustum cone is significantly stressed by the clamping force.

The first frustum starts at the washer face of a bolt or a nut, and lines of the cones turn at the middle of a grip. This indeed means that the washers do increase the pressurized area under the nut and the bolt head, and thus do reduce the pressure. One frustum is the cone of the same material. The frustum geometry is determined by the bolt diameter, d, the diameter of the smaller end of the frustum, D, and the thickness of the frustum, t. The diameter of the smaller end of the smallest frustum is D=dw, at the head and the nut, no matter there is a washer face or not. How many frusta are there in the members shown in Figure 8-9?

lG

dw

30⁰

D

d

t

Figure 8-9 Member frusta.

1
1 | 1 | 1
1 | 2
= | + | + + | +
m | m | m | mi k | k | k | k

(8-7)

Here, kmi is the stiffness of the i

th cone

0.577
(1.15 | )( | ) ln
(1.15 | )( | )

i
mi

Ed k
t D d D d
t D d D d

π
=
+ | − | +
+ | + | −

(8-8)

Note here:

(1) If one of the members is a soft gasket, then km ≈ kg, the stiffness of the gasket.
(2) The diameter of the washer face is dw = 1.5d.
(3) α is in the range of 25⁰~33⁰

. We can use 30⁰
. (cf. Shigley and Mischke, 1989)

Forces. Now we are ready to analyze forces in a bolted tension connection. The following loads are defined based on Figure 8-10.

Preload, or the clamping force: | Pi
Applied load supported by the bolt: | Pb
Applied load supported by the member: | Pm
Applied tensile load: | P = Pb + Pm
Resultant bolt load: | Fb = Pi + Pb

Let’s analyze the resultant load in a bolt, Fb. In a bolted joint, the magnitude of bolt further elongation due to the applied load taken by the bolt, Pb, equals that of the restoration of member compression due to the applied load taken by the member, Pm (Equation (8-9)).

Fb = Pi + Pb

Fm = -Pi + Pm

P = Pb + Pm

Figure 8-10 Forces in a bolted connection.

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
(8-9)
The applied load is
P = Pb + Pm | (8-10)

with

bm
b
m

kP P
k

=
(8-11)

Or

mb
m
b

kP P
k

=
(8-12)

From Equation (8-10), we get the applied load taken by the bolt

182 ( | ) | m
b | m | b b

k
P | P P | P | P
k
= | − | = −
(8-13)

which is

| | b
| b
m | b
| | k
P | P
k | k

=
+

(8-14)

and the applied load supported by the member
( | ) | m
m | b
m | b

k
P | P P | P
k | k
= | − | =
+

(8-15)

The resultant bolt load (force) is

( | ) | b
b | b | i | i
m | b

k
F | P | P | P P
k | k
= | + | = | +
+

(8-16)

The resultant member force is

( | ) | m
m | m | i | i
m | b

k
F | P | F | P P
k | k
= | − | = | −
+

(8-17)

Equation (8-17) defines a joint constant, C = kb/( km + kb) | (8-18)

Therefore, Equation (8-16) may be re-written as

( | ) | b
b | b | i | i | i
m | b

k
F | P | P | P P CP P
k | k
= | + | = | + | = | +
+

(8-19)

The stress in the bolt,
t

i

t | t

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
= | = | +
(8-20)

We need to determine the preload in Equation (8-21), which is actually a matter of selection

Pi = 0.75At Sp
for reused connection | (8-21)
Pi = 0.90At Sp
for permanent connection | (8-22)

Bolt strength. Bolt strength is expressed by the proof strength defined based on the concept of proof load, which is the maximum load that a bolt can withstand without a permanent set (plastic deformation). Corresponding to the proof load, we can define the proof strength as follows, as if we were taking away the plastic deformation allowed in the yield strength.

T

Proof load
Tensile strength area:A | 0.9 p | y S | S = | ≈
(8-23)

Other strengths, such as the yield strength, which is the minimum yield strength for bolts, and the tensile strength, which is the minimum ultimate strength for bolts, can also be found in design handbooks. Table 8-3 lists the properties of a number of metric bolts and screws. The numbers shown in the heads, the last column, are the average tensile strength of the bolts.

Table 8-3 | Mechanical properties of metric bolts and screws
Property Size | Min. | Min. | Min. | Material | Head
class | range proof strength tensile strength yield strength | Marking
MPa | MPa | MPa
4.6 | M5-M36 | 225 | 400 | 240 | Low or medium carbon
4.8 | M1.6-M16 | 310 | 420 | 340 | Low or medium carbon
5.8 | M5-M24 | 380 | 520 | 420 | Low or medium carbon
8.8 | M16-M36 | 600 | 830 | 660 | Medium carbon, Q&T
9.8 | M1.6-M16 | 650 | 900 | 720 | Medium carbon, Q&T
(Shigley and Mischke 1989)

Factors of safety

Anti-over-proof. The bolt strength analysis is to determine a load factor, n, which is the factor of safety for anti-over-proof failure (or anti-plastic deformation). In a bolted connection, the stress control is achieved through controlling the applied load by load factor n. When the load, P, becomes nP, the bolt stress reaches it maximum, Sp, the proof strength. Here, nP is the maximum load that can be applied without failure, and n is also called the anti-over-proof factor of safety. The load factor is the margin to the largest applied load that can lead to the bolt failure due to plastic deformation; it is only applied to the applied load, not the preload, Pi, because Pi is an assembly requirement and cannot be reduced.

b | | i
b | p
t | t | t
F | p CnP | S
A | A | A
σ = | = | + | =

Therefore,

p | t | i S A | P
n
CP

−
=
(8-24)

Anti separation. The resultant member load should remain compressive:

-Fm = Pi – Pm

or Fm = Pm - Pi = (1-C)P - Pi (8-25)

The external load to cause separation, Po , can be determined by

4.6

4.8

5.8

8.8

9.8

(1-C)Po

- Pi = 0 | (8-26)
or | Po = Pi
/(1-C) | (8-27)

We can now define the factor of safety, nsp, guarding against separation, as follows.

(1 )

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
(8-28)

Figure 8-11 summarizes the load-deformation relationships for a bolt and a set of members in preloading and work loading. Keep in mind that the application of tensile load P further increases the bolt deformation but releases the member compression.

Figure 8-11 Loading lines for a bolt and a set of members in a bolted tensile connection.

Example 8-1 Eight M10x1.5 bolts are used for the enclosure of a pressure vessel, and each supports an axial load of 15 KN. If the grip length is 24 mm and the bolt length is 35 mm, calculate:
a. | The stiffness of the bolt | b. The stiffness of the members
c. | Joint constant | d. Preload (reused)
e. Factors of safety

Problem understanding:
I. Eight bolts are used to support a tensile load. The bolt load: P = 15 KN, and the total load supported by these eight bolts is W = 8 x 15 KN.
II. Pressure in the pressure vessel should be, p = W/surface area
III. Each bolt-nut set forms a tension connection.
IV. The bolt is under a tensile loading condition.

Deformation, d

Bolt load, Fb | Member load, Fm
k | k | i
k Fb | Pb | Pi | P P m | b
b = | + | = | + + ( | )
Pi | P
m | b k | k

P
+ d =
Tension | Compression

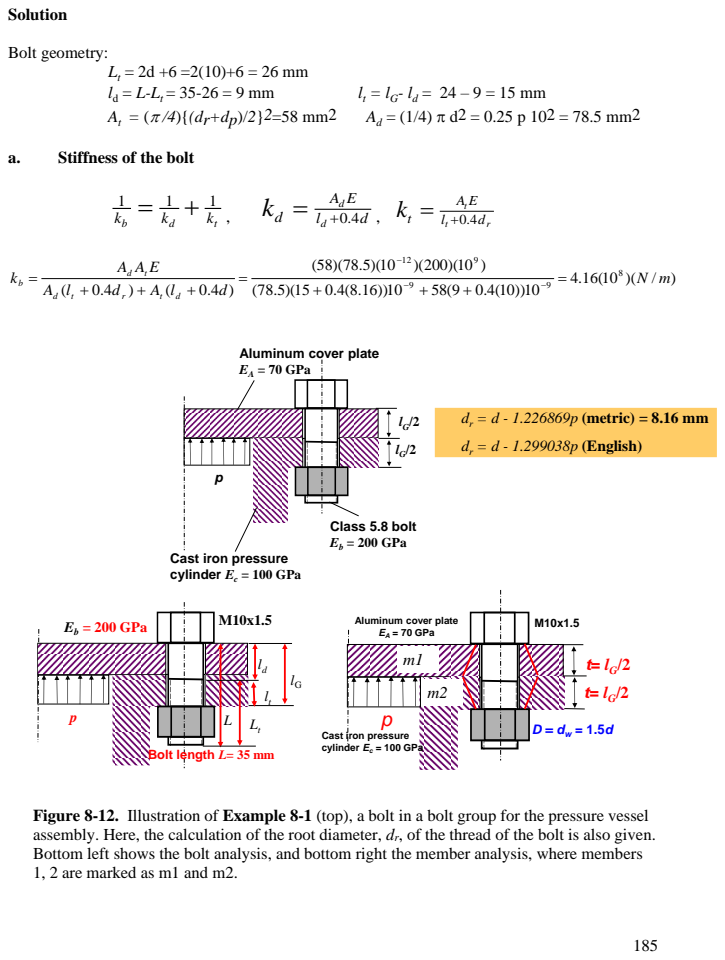
[picture p131: page 11]
Solution; Bolt geometry: Lt = 2d +6 =2(10)+6 = 26 mm; Class 5.8 bolt Eb = 200 GPa; Eb = 200 GPa; Aluminum cover plate; EA = 70 GPa; = d - 1.226869p (metric) = 8.16 mm; = d - 1.299038p (English)

a. Stiffness of the bolt

Aluminum cover plate
EA = 70 GPa

Cast iron pressure
cylinder Ec = 100 GPa

Bolt length L= 35 mm

Figure 8-12. Illustration of Example 8-1 (top), a bolt in a bolt group for the pressure vessel
assembly. Here, the calculation of the root diameter, dr, of the thread of the bolt is also given.
Bottom left shows the bolt analysis, and bottom right the member analysis, where members
1, 2 are marked as m1 and m2.

b. Stiffness of the members
1 | 2
1 | 1 | 1
m | m | m
k | k | k
= | +
9 | 3
6
1
0.577 | 0.577 (70)(10 )(10)(10 ) | 1442(10 ) /
(1.15 | )( | ) | (1.15(24 / 2) 1.5(10) 10)(1.5(10) 10) ln | ln
(1.15 | )( | ) | (1.15(24 / 2) 1.5(10) 10)(1.5(10) 10)

A
m
Ed k | N m
t D d D d
t D d D d
π | π

−
= | = | = æ | ö | æ | ö + | − | + | + | − | + ç | ÷ | ç | ÷ è | ø | è | ø ⁺ + | − | + | + | −

6
2 | 1
100 (1442) | 2060(10 ) | /
70

C
m | m
A

E
k | k | N m
E
= | = | =

2060(10 )

1
1442(10 )
1 | 1 | 1 | 1
6 | 6
1 | 2
= | + | = | +
m | m | m
k | k | k

, and therefore km = 848 (106) N/m

c. Joint constant

kb = 413 (106) N/m, and km = 848 (106) N/m

Therefore,
0.329
848 416

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
d. Bolt preload

The proof strength of the bolt is Sp = 380 MPa (class 5.8).

Preload for reused connections is Pi = 0.75 Sp AT = 0.75(380 x106) (58x10-6) = 16.5 KN.

e. Factors of safety

Anti separation
1.64
15000(1 0.328)

16500
(1 )

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
Anti over proof
1.12
0.329(15000)
380(10 )(58)(10 ) 16500 ⁶ | 6
=

−
=

−
=

−
CP

S A P
n
p | T | i
. Safe

Why is the anti over proof factor of safety so small?

8-3 Bolt under variable tensile loading

Most structures are under variable loading. Even for a so called static-loading case, the loading and unloading processes cause the force in a bolt to fluctuate from preload to its working force. Failure due to variable loading is fatigue. Therefore, we should extend our stress analysis to the stress and strength of the bolt under variable loading. The Goodman line will be used again here. Recall the analysis of variable loading, and details are reviewed in Figure 8-13. Note that the changing portion is the applied load, not the preload. The amplitude portion, Pa, and the midrange portion, P

| m' , of the applied load are

2

Pmax Pmin Pa
−
=

(8-29)

2

max min
'

P P
Pm

+
=

(8-30)

Fb = Pi + Pb

Fm = -Pi + Pm

P = Pb + Pm

t

P

Pa

Pm’

Pmin

Pmax

Figure 8-13. Variable loading, the applied tensile load is varying. Bottom right, an example of bolt fatigue fracture.

We know that in a bolted joint under tension, the bolt force is

b
b | i | i
m | b

k
F | P P | CP P
k | k
= | + | = | +
+

(8-31)

Therefore, the variation of the force in a bolt is characterized by

Fbmax

= CPmax + Pi
(8-32)

Fbmin = CPmin + Pi
(8-33)

The amplitude, Fba, and the midrange, Fbm, of the force in the bolt are

188 ( | ) ( | )

a

b | b | i | i
ba | CP P | P
C
F | F | CP | P | CP | P
F | =

−
=
+ | − | +
=

−
=
2 | 2 | 2
max | min | max | min | max | min
(8-34)
( | ) ( | )

'

max | min | max | min | max | min
2 | 2 | 2
i | i | m
b | b | i | i
bm | P CP P | P
P C
F | F | CP | P | CP | P
F | = | +

+
= | +
+ | + | +
=

+
=

(8-35)

We consider that a bolt will reach fatigue failure if the applied load reaches nftP, where nft is the factor of safety against fatigue failure, and the corresponding amplitude and the midrange of the tensile stress, σba and σbm, in a bolt are

a ft
ba
t

CP n
A

σ =

(8-36)

i | m | ft '
bm
t

P CP n
A

σ

+
=

(8-37)

Goodman’s line should be applicable for the factor of safety against fatigue failure. Here, fatigue-stress concentration factor, Kf, should be taken into account.

+ =1

ut

m

e

f | a
S | S
K σ | σ
(8-38)

Why not this one?

n
S S

K

ut

m

e

f | a
+ | =1/
σ | σ
(8-39)

Again, the safety factor does not apply to the preload. Therefore, the factor of safety against fatigue failure is obtained by extending the load factor concept. With the assistance of Equations (8-36) and (8-37), the Goodman line expressed by Equation (8-38) becomes

1

'
=

+
+

ut t

i | m | ft
e | t
f | a ft
S A

P CP n
S A

K CP n
(8-40)

The factor of safety against fatigue failure is

( | )
( | ) ' | '
(1 | )
f ut a | e m
e | ut t | i

ut t

m

e | t
f | a

ut t

i

ft | C K S P | S P
| S S A | P

S A

CP
S A

K CP

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
= | (8-41)

Remember how the endurance limit of a part should be obtained from the endurance limit of a material? The same concept applies here, but the ultimate strength is that for the bolt material. For bolts and screws, factors ks, km and kt may be ignored because the properties in Table 8-3 are given for bolts of particular sizes. Only the reliability factor (Table 3-2) should be included here in the following equation.

' | '
e | s r t m | e | rSe S = k k k k S ≈ k

(8-42)

For a bolt in a tensile connection, we use Se 45Sut 0.

'
=

, which is exactly for axial-loading cases. The fatigue stress concentration factor, Kf, in Equation (8-41) is given in Table 8-4.

Table 8-4 Fatigue stress concentration factor, Kf

Example 8-2 Eight M10x1.5 bolts are used and the axial load on each bolt changes from 0 to 15 KN. If the grip length is 24 mm and the bolt length is 35 mm, please calculate the factor of safety against fatigue failure for a 90% reliability.

This is a continuation of Example 8-1.

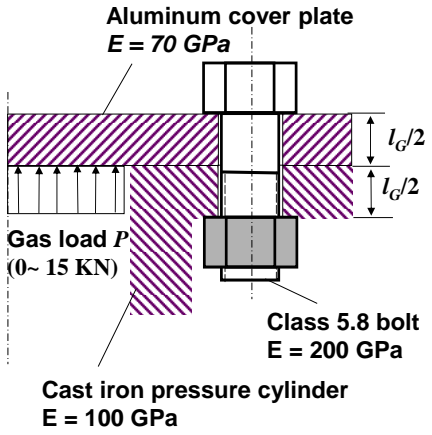
[picture p132: figure]
Aluminum cover plate E = 70 GPa; Cast iron pressure cylinder E = 100 GPa; Class 5.8 bolt E = 200 GPa; Gas load P (0~ 15 KN)

Figure 8-14 Bolted joint analyzed in Example 8-1.

Solution. The applied load changes from 0 to a maximum. Therefore, the stress cycle is a released-tension cycle.

Metric grade | Rolled threads | Cut threads
3.6-5.8 | 2.2 | 2.8
6.6-10.9 | 3.0 | 3.8

From Example 8-1, we have

0.329
848 413

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
C | , At = 58 mm2, and Pi = 0.75 Sp AT = 16.5 KN

Let’s get the tensile strength, fatigue stress-concentration factor, and the endurance limit for the bolts. From Table 8-3, we have Sut = 520MPa for the class 5.8 bolts.

The fatigue stress concentration factor, Kf

, for a metric rolled thread is Kf = 2.2 from Table 8-4.

Therefore, for axial loading,
Se | 0.45Sut | 0.45(520) 234MPa

'
= | = | =

kr
= 0.9

for 90% reliability

Se
k f

ks

kr

kt

kmSe

krSe | 0.9(234) 211MPa
' | '
= | ≈ | = | =

The amplitude and mean of the applied load

KN P | P
Pa | 7.5
2

15 0
2
max | min | =

−
=

−

= | KN P | P
Pm | 7.5
2

15 0
2
max | min
' | =

+
=

+
=
( | )
( | )
( | )
[ ( | ) | ]

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
0.329 2.2 520 (10 )7500 211(10 )7500
211(10 ) 520(10 )(58)(10 ) | 16500
6 | 6
6 | 6 | 6

'

t

f ut a | e m
e | ut t | i
ft | C K S P | S P
S S A | P
n
0.86

Here is a summary of the results for the design calculations for this bolted joint.

For static loading of 15KN, and the peak load of 15KN, the factors of safety are

Anti-separation
P(1 C)

P
n

i
sp
−

=

= 1.64

Anti-over-proof
CP

S A P
n

p T − i
=
= 1.12

Anti-fatigue failure

( | )
( | )

=
+

−
=
f ut a | e m'
e | ut t | i
ft | C K S P | S P
S S A | P
n
= 0.86

Insufficient! There are several ways to improve the design, such as using a stronger material, but this is not a simple issue; using larger bolts, but this also increase the required preload; or using more bolts, which means the reduction of the peak load. We need to reduce the peak load value to 11,720N, or Pa=Pm’ =5860N, in order to increase the anti-fatigue failure factor of safety to about 1.1.

8-4 Bolt groups

Although bolts are under tensile loading, the bolt groups can take any loading modes: tension, bending, shear, and torsion. We know tensile loading already, Figure 8-15 shows bolt shear under different external loads, F1 and F3. F2 is balanced by bolt tension in B, C and compression in A, D. We will discuss bolt shear in this section.

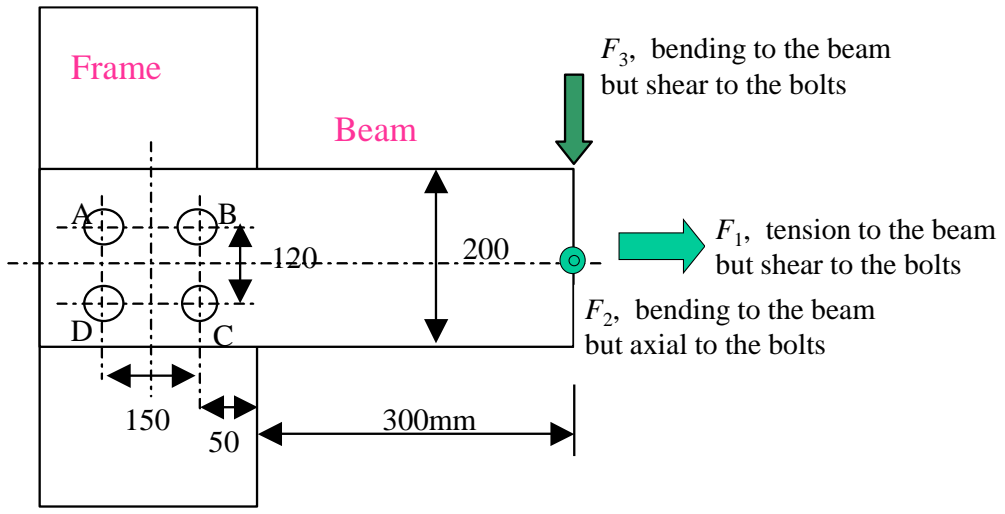
[picture p133: figure]
Beam; Frame; , bending to the beam but shear to the bolts; , tension to the beam but shear to the bolts; , bending to the beam but axial to the bolts

Figure 8-15 | A bolt group under combined loading modes.

The structure shown in Figure 8-16 illustrates the loading of a pair of shear forces. Here, the shear load applied to the plates is taken by the friction at the interface formed by the plates. The maximum shear load that the interfacial friction can sustain without slip is F = fPi, or the static friction coefficient, f, by the preload, Pi. The static friction coefficient is f = 0.5.

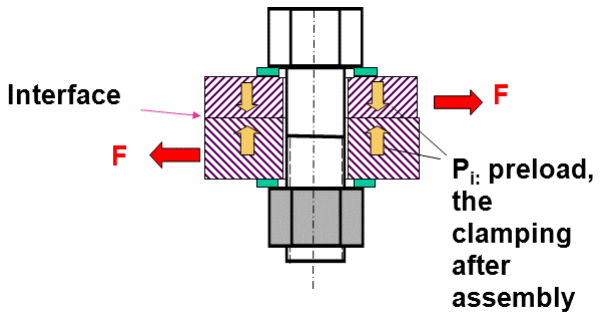
[picture p134: figure]

Figure 8-16 Tension connection for shear loading taken by interfacial friction.

What would happen if the shear load is F > fPi ?

An alternative design is to use the shank of a stripper bolt for the shear force. Figure 8-17 is the drawing for such a structure. Here, the shear load is taken by both the shank of the bolt and the interfacial friction.

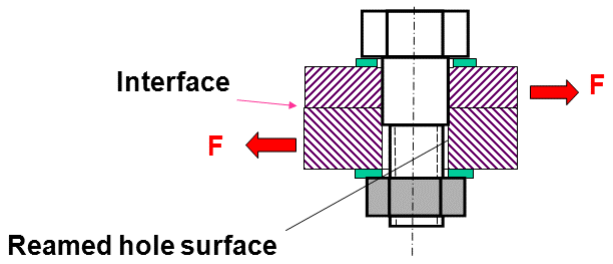
[picture p135: figure]

Figure 8-17. Tensile connection for shear loading taken by the shank of the stripper bolt fit to the reamed holes in the members, together with the interfacial friction.

Example 8-3 A cantilever structure is formed by a group of bolted tension connections, Figure 8-18, where the bolts there are under tension due to assembly and shear due to loading. Four bolts are used with a certain amount of preload. Which bolt is under the maximum shear load? How much? Are class 5.8 M10x1.5 bolts proper selections?

Solution

Both the force, F= 16KN, and the moment, which is the toque to the bolt group, T=16KNx(300+50+150/2)mm, are shear loads to the bolts. We need to determine which bolt is under the maximum shear load and how much this load is with reference to Figure 8-19.

Forces on each bolt due to F is FF = 4KN, the same force is applied to each of the bolts, in the same direction;

Forces on each bolt due to T is FT = 17.7 KN, the same magnitude, but different directions from bolt to bolt, obtained from

16KN(300+50+150/2)mm = 4 (FT) (OB)

FT = 16(10³

) (0.3+0.05+0.15/2)/{4[((0.12/2)²+0.15/2)² )

1/2]} = 17.7 KN

Combining FF and FT by means of the law of cosine, we get FB=FC = 20.7 KN, which is the shear force on bolt C, the largest. FB on bolt B should have the same magnitude.

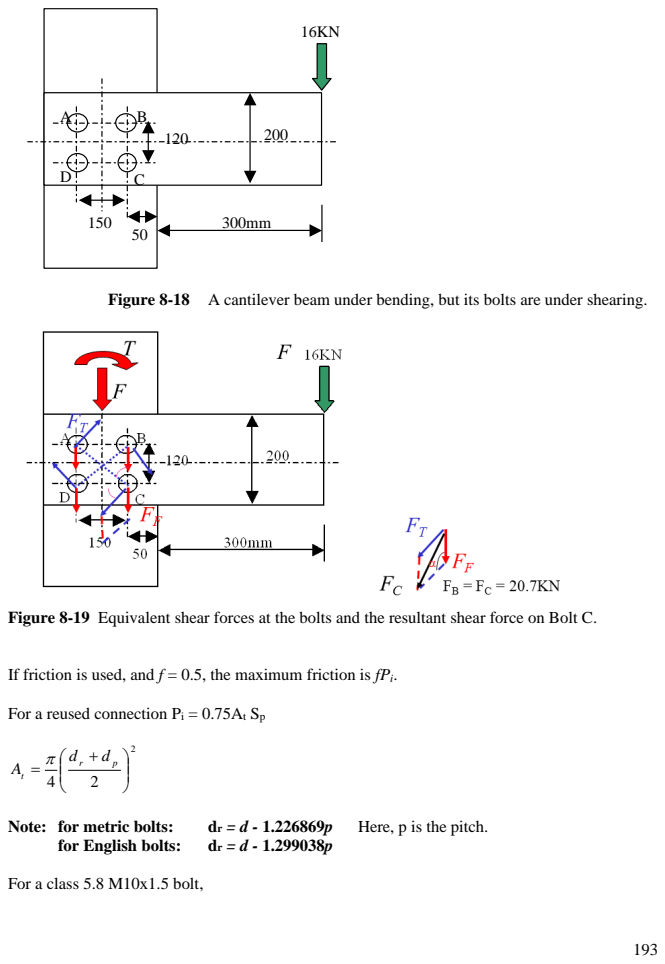
[picture p136: page 19]
Figure 8-18; A cantilever beam under bending, but its bolts are under shearing.; Note: for metric bolts:; Here, p is the pitch.; for English bolts:

Figure 8-19 Equivalent shear forces at the bolts and the resultant shear force on Bolt C.

If friction is used, and f = 0.5, the maximum friction is fPi.

For a reused connection Pi = 0.75At Sp

For a class 5.8 M10x1.5 bolt,

dr = 10-1.226869(1.5)=8.16mm,

mm

d d
d

r
p | 9.08
| 2

8.16 10
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
8.16 9.08
4 | 2 | 4

mm

d d
A
r | p
t | ÷ ≈
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
π | π

Sp = 380 MPa

Pi = 0.75(58)(380)=16.53KN

Thus, the maximum friction is only 0.5(16.53) =8.265KN. Not enough!

Therefore, we need the design given in Figure 8-17 with a stripper bolt for this loading, where the shear force is taken by the shank of the bolt and the interfacial friction.

8-5 Design of bolted connections

Recall the bolts we saw before, which is reprinted below in Figure 8-20. We seem to have a variety of bolts (and/or screws). We will see how they are used in structure designs.

Tensile connections are widely used in part assembly. Such a connection may take tensile loading, shear loading, and bending loading, etc, as we discussed in the previous section. We will talk about some of these here. More will be given in the class.

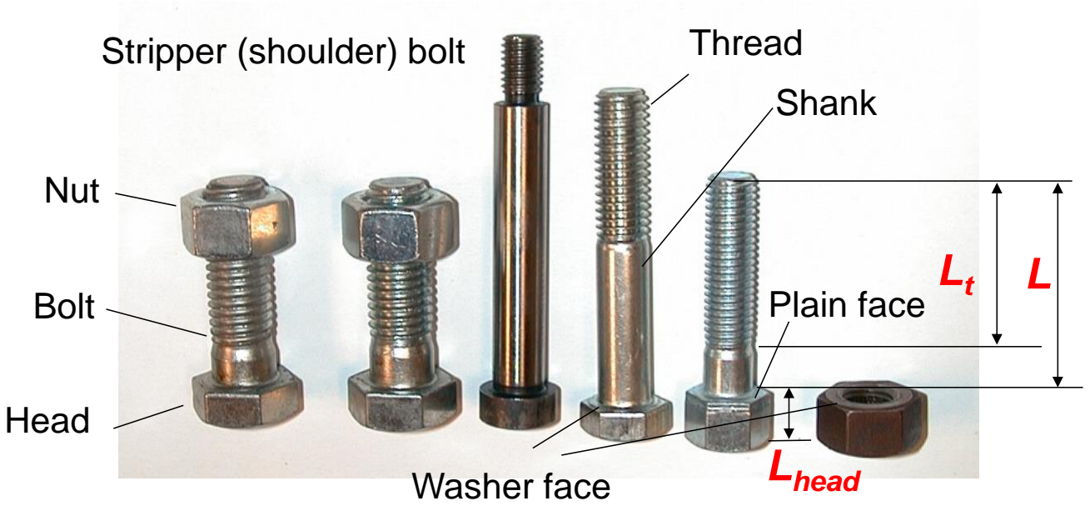
[picture p137: figure]
Head; Nut; Bolt; Stripper (shoulder) bolt; Thread; Shank; Lhead; Washer face; Plain face

Figure 8-20 Bolt samples again.

Connecting two plates. A bolt and a nut are used to connect two plates in the structure shown by the left drawing of Figure 8-21, where the plates are not very thick. The plates and washes are all members. No thread is made in either member. Remember that a clearance is needed between the bolt and the bores in members, which is exaggerated in Figure 8-21. Such a structure requires a wrench space on each side of the connection.

A thread can be made in one of the members if it is sufficiently thick, as shown in the right drawing of Figure 8-21. A cap screw (bolt only, no nut) can be used but one of the members acts as the “nut” needed. This structure requires a wrench space only on one side of the connection. Figure 8-22 shows the drawings for these bolted connections.

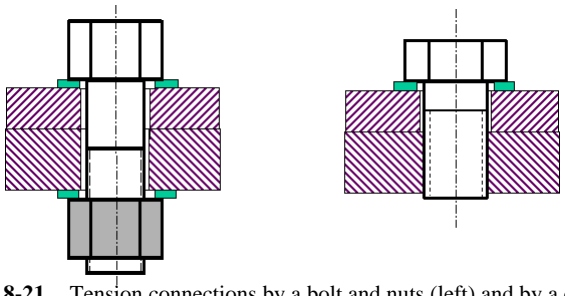
[picture p138: figure]

Figure 8-21 | Tension connections by a bolt and nuts (left) and by a cap screw (right).

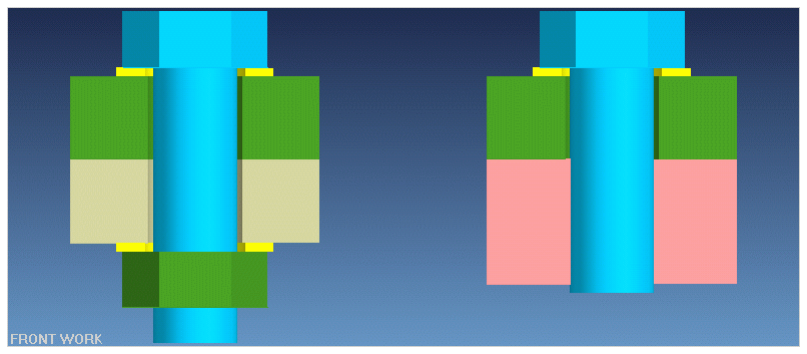
[picture p139: figure]
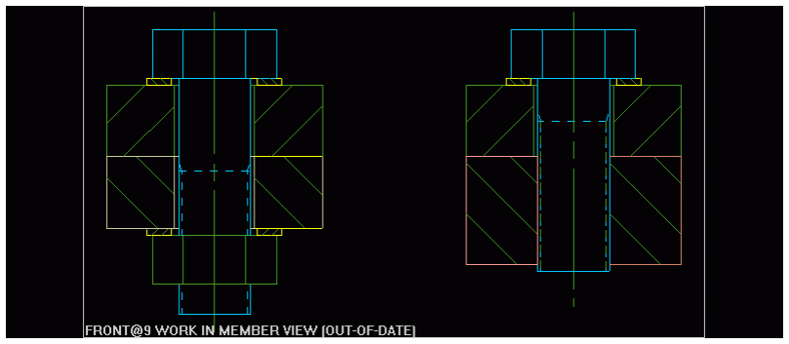
[picture p140: figure]

Figure 8-22 | Drawing of bolted connections.

Assembly space. Do not forget the wrench space for assembly and disassembly. Figure 8-23 shows several possible designs for the use of a pipe wrench (left) and a regular wrench (middle and right). Obviously, the pipe wrench requires less space.

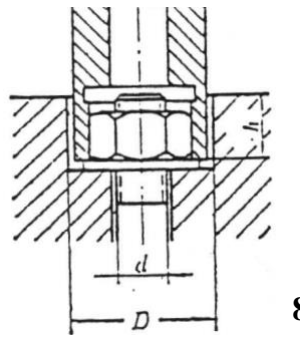
[picture p141: figure]
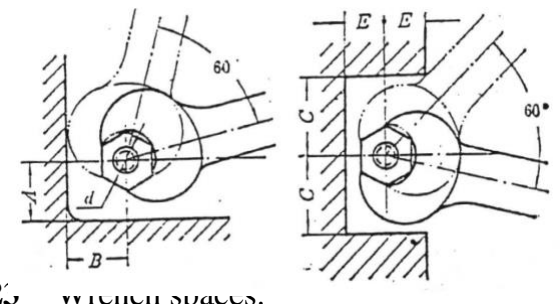
[picture p142: figure]

Figure 8-23 Wrench spaces.

Blind threaded hole in a thick member. If one of the members has a large thickness, we need to make a blind threaded hole in the member. Figure 8-24 shows the drilling, tapping, and assembly of the thick member in a bolted connection. The assembled structure is shown in Figure 8-25. Pay a close attention to the ends of the hole, the thread, and the screw; they should be correctly expressed in the drawing.

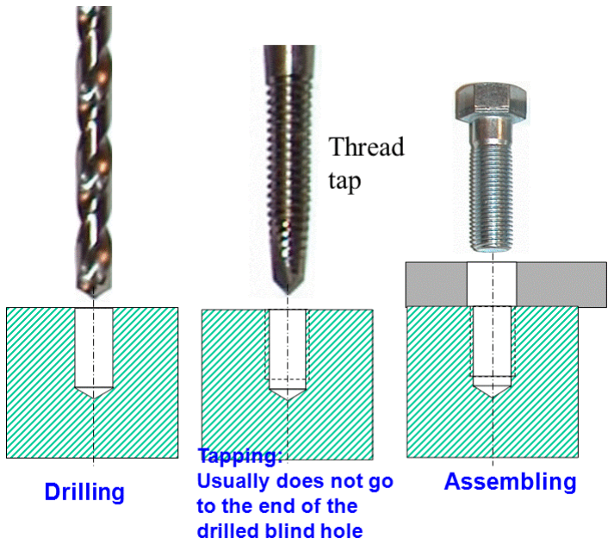
[picture p143: figure]

Figure 8-24 | Drilling, tapping, and assembly of a thick member.
Pipe-wrench space | Regular wrench space

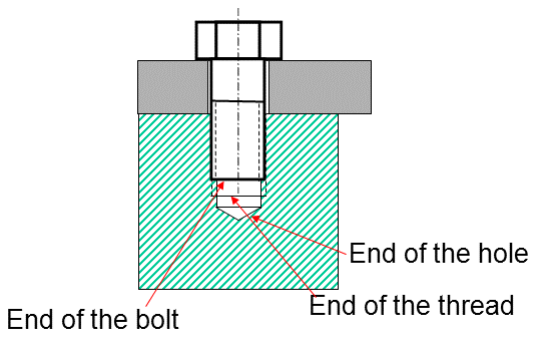
[picture p144: figure]

Figure 8-25. Parts shown in Figure 8-24 after assembly.

There is no thread in the top member! Why? Think about the manufacturing, assembly, and performance of the parts in the connection, and also think about the thread of the screw (bolt).

Comparing tension connections. Figure 8-26 shows three typical structures of a bolted tension connection. Let’s understand and compare them. In this figure, several bolts (different bolts are used in different designs) are utilized to connect the flanges of a pressure vessel. The flanges shown in Figure 8-26 (a) are through bolted, where the bolt holes in the members are free of thread. The structure shown in Figure 8-26 (b) and (c) are different. Stud bolts are used in the structure shown in Figure 8-26 (b). Figure 8-26 (d) is a simplified drawing of a stud bolt. Cap screws are used in the structure shown in Figure 8-26 (c). In each of these two structures, the holes in the top member of the pressure vessel are free of thread, and the threaded member is very thick. In the assembly of structure (b), the stud bolts are “planted” into the threaded member first, and then the top cover is placed. Removing the cover does not require removal of the bolts. The assembly of structure (c) is opposite; here, the screws are assembled last.

Spring washers are used in each of the structures for the anti-loosening purpose.

Note that both the bodies and the covers of these pressure vessels are cast pieces.

Can we compare these three structures?

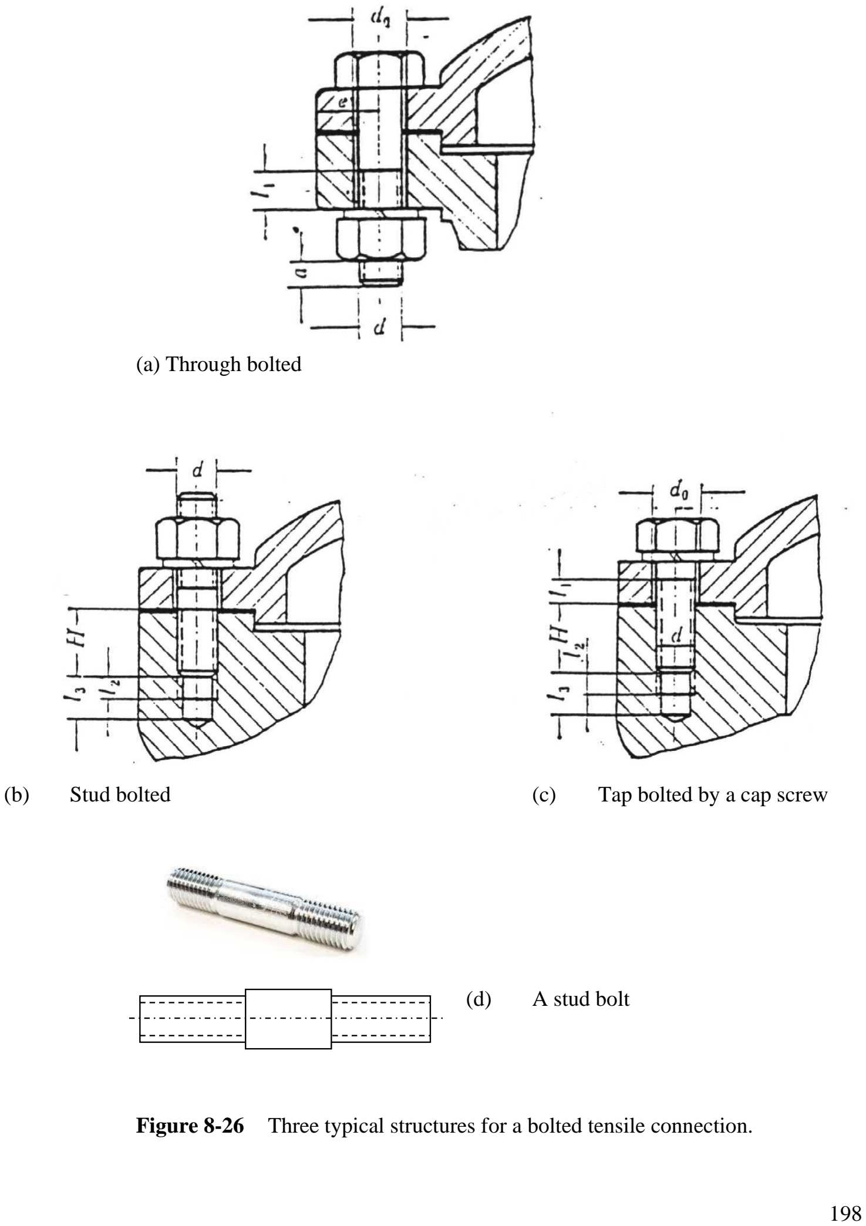
[picture p145: page 24]

(a) Through bolted
(b) | Stud bolted | (c) | Tap bolted by a cap screw
(d) A stud bolt

Figure 8-26 Three typical structures for a bolted tensile connection.

Preventing loosening

There are a number of designs for loosening prevention, which are 1) double nuts, 2) spring washer of many types, 3) spring cotter pin, 4) self-locking nut, 5) wiring, 6) thread damage, 7) superbolt, 8) wedge-lock washers, 9) lock bolt, and many other innovative structures. The first four are shown in Figure 8-27, which are for re-usable bolts. Items 5-6 are shown in Figure 8-28, which use permanent measures to lock mating threads. The last three will be shown in YouTube movies.

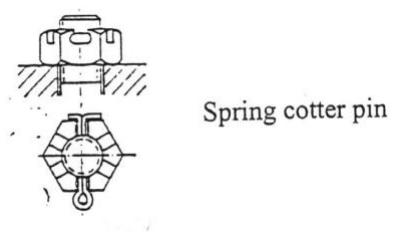
[picture p146: figure]
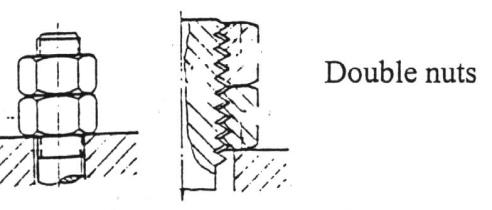
[picture p147: figure]

(a) (b)

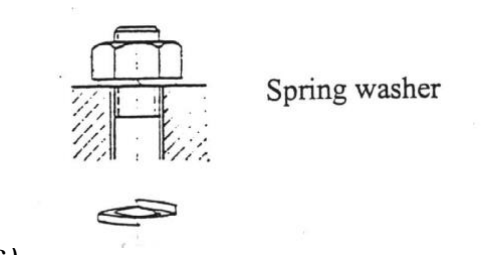
[picture p148: figure]
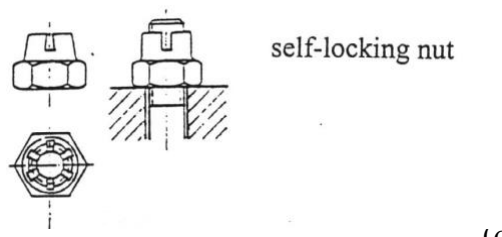
[picture p149: figure]

(c) (d)
Figure 8-27 | Preventing loosening by reusable parts.

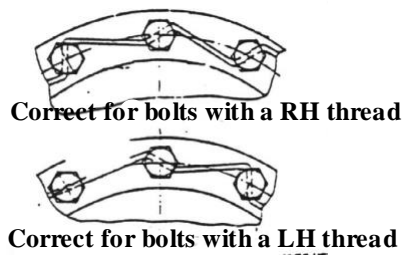
[picture p150: figure]
Correct for bolts with a RH thread; Correct for bolts with a LH thread
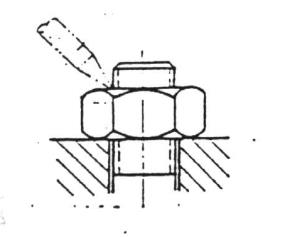
[picture p151: figure]
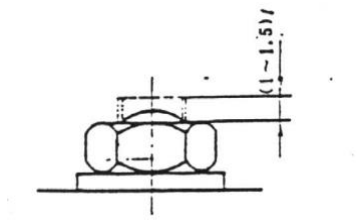
[picture p152: figure]

Figure 8-28 | Preventing loosening by permanent means.
(a) Wired
(b) | Riveted | (c) | Thread damaged

8-6. Bolt manufacturing

Bolt manufacturing has be highly specialized, and two very important processes are involved, cold heading and cold thread rolling. The shapes are formed through compression, and the process produces zero waste. More will be discussed in class.

Chapter summary
This chapter studies bolted connections and how a tensile connection is made and used to support tensile, shear, bending and torsional loading. The concepts of bolt and member stiffness, joint constant, preload, proof strength are introduced. Factors of safety against plastic deformation, joint separation, and bolt fatigue are derived. Issues related to bolted-joint design are explained.

References
Shigley, J. and Mischke, C., 1989, 2001, Mechanical Engineering Design, McGraw Hills. Pu, L., Chen, D., and Wu, L., 1982, 2013, Machine Design, China Higher Education Press.
Media: | Several U-Tube movies are on line. 315 students should watch the short U-
Tube movies before and after the classes.
