ChristopherLuey/315-MechanicalDesign/Ebook/eBook/Appendix/A4FitTolerance.pdf

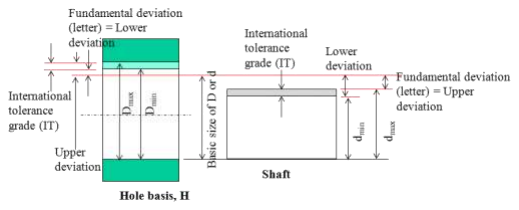
[picture p174: figure]

1

Appendix 4 Fit and Tolerance

A-4-1. Fits and types of fits
The diagram below shows the fit system for a basic hole, denoted by H. Three types of fits commonly used are the clearance fit, transition fit and interference fit.

For a clearance fit, the fundamental deviation of the hole is designated by H, and that of the shaft by c, c, f, g, or h. This type of the fits is usually applicable for the fit between the inner ring of a sliding bearing sleeve and a shaft.

For a transition fit, the fundamental deviation of the hole is designated by H, and that of the shaft by k or n. This type of the fits is usually applicable for the fit between the outer ring of a rolling bearing and a housing bore, and between a gear and a shaft.

For an interference fit, the fundamental deviation of the hole is designated by H, and that of the shaft by p, s, or u. This type of the fits is usually applicable for the fit between the inner ring of a rolling bearing and a shaft.

The hole-basis system is usually used for the fit of elements like the out ring of a rolling bearing to a housing. The lower letter, h, is use to indicate the basic shaft, which for this case, is the outer diameter of the outer ring.

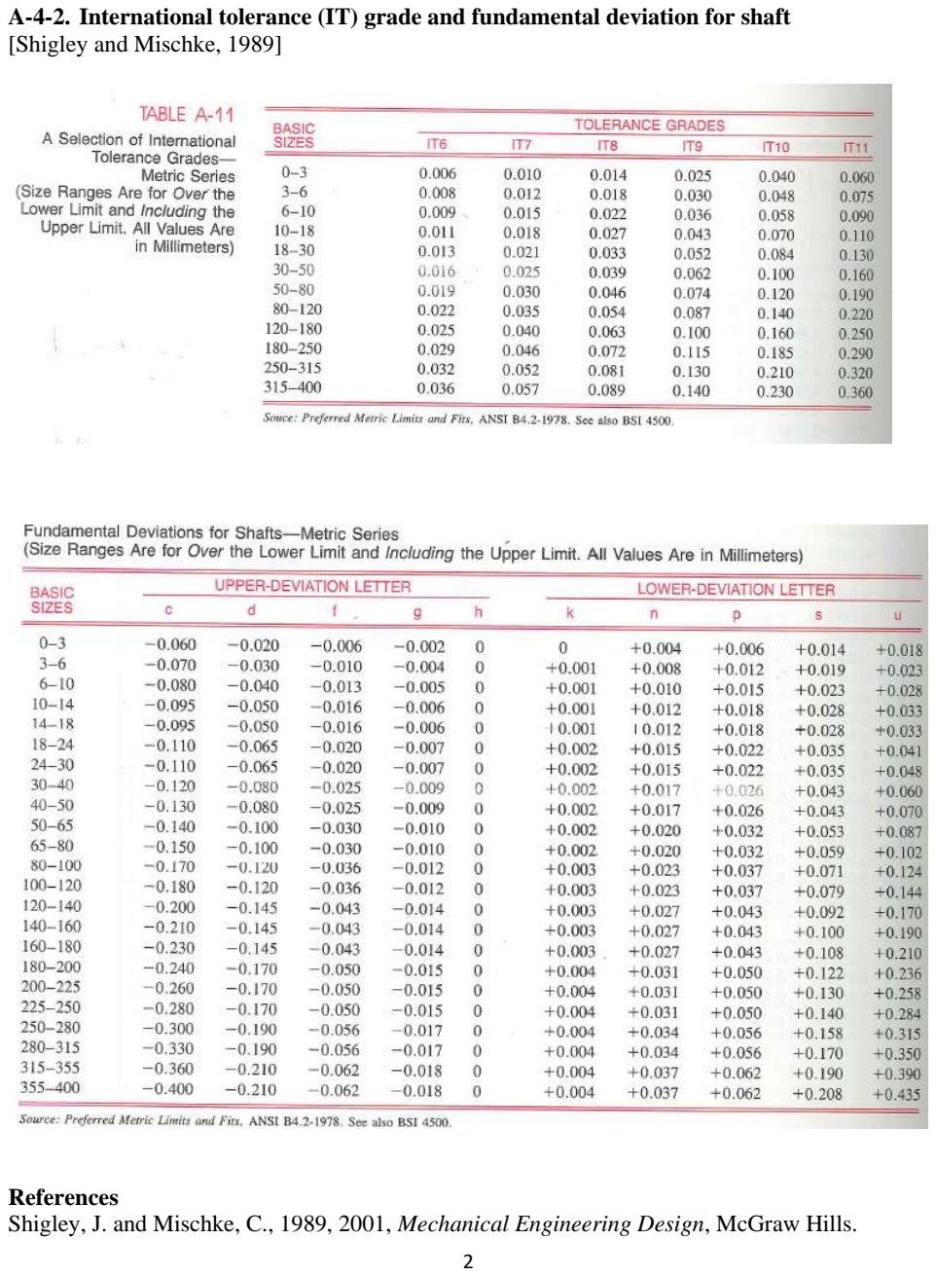
[picture p175: page 2]

2

A-4-2. International tolerance (IT) grade and fundamental deviation for shaft [Shigley and Mischke, 1989]

References
Shigley, J. and Mischke, C., 1989, 2001, Mechanical Engineering Design, McGraw Hills.
