ChristopherLuey/315-MechanicalDesign/Ebook/eBook/Appendix/A2MaterialProperties.pdf

1

Appendix 2 Properties of Several Materials

A-2-1. Physical properties of materials

Material | Young’s Modulus GPa MPsi | Poisson’s ratio
Aluminum and alloys | 71.0 10.3 | 0.334
Brass | 106.0 15.4 | 0.324
Carbon steel | 207.0 30.0 | 0.292
Grey cast iron | 100.0 14.5 | 0.211
Copper | 119.0 117.2 | 0.326
Nickel steel | 207.0 30.0 | 0.292
Stainless steel (18-8) | 190.0 27.6 | 0.305

A-2-2. Mechanical properties of quenched and tempered carbon steels

AISI No | Tensile Strength MPa KPsi | Yield strength MPa KPsi | Brinell hardness
1030 Normalized | 848 123 800 116 731 106 669 97 586 85 521 75 | 648 94 621 90 579 84 517 75 441 64 345 50 | 495 401 302 255 207 149
1040 Normalized | 779 113 758 110 643 92 590 86 | 593 86 552 80 434 63 374 54 | 262 241 192 170
1050 Normalized | 1120 163 1090 158 717 104 748 108 | 807 117 793 115 538 78 427 62 | 514 444 235 217

References
Shigley, J. and Mischke, C., 1989, 2001, Mechanical Engineering Design, McGraw Hills.
