ChristopherLuey/315-MechanicalDesign/315 Calculation.xlsx

Sheet: Sheet1
Parameter | Units | Pinion | Gear
Torque, T | NM | 381.970 | 974.024
Normal Module, mn | mm | 5.000
Pressure Angle, phi | degree | 20.000
Helix Angle, psi | degree | 17.000
RPM, n | rpm | 1300.000 | 509.804
Number of Teeth, N | no. | 20.000 | 51.000
Gear Ratio |  | 0.392
Pitch Diameter, d | mm | 104.569 | 266.651
Root Diameter, dr | mm | 92.069 | 254.151
Outer Diameter, do | mm | 114.569 | 276.651
Addendum, a | mm | 5.000
Dedendum, b | mm | 6.250
Transverse Module | mm | 5.228
Transverse Pressure Angle | degree | 20.837
Tangential Force, Wt | N | 7305.595
Raidal Force, Wr | N | 2780.514
Axial Force, Wa | N | 2233.544
Resultant Force, W | N | 8129.680

Sheet: Sheet2
 | Ap | 1.000
 | m | 3.000
 | Pa | 2.233 | kN | hours | 11000.000
 | Pr | 4.202 | kN | rotation speed | 1300.000 | rpm
 | pa/pr | 0.531 |  | L10 | 858.000 | MC
 | X | 1.000
 | Y | 0.000
 | P | 4.202 | kN
 | C | 39.929 | kN
Bearing 6404 | C0 | 23.600 | kN
 | C | 43.6 | kN
 | Pa/C0 | 0.095
 | lower point pa/c0 | 0.070
 | upper point pa/c0 | 0.130
 | lower point e | 0.270
 | upper point e | 0.310
 | slope | 0.667
 | e (interpolated) | 0.286
 | lower point y | 1.600
 | upper point y | 1.400
 | slope | -5.000
 | Y (interpolated) | 1.518

Sheet: Copy of Sheet2
 | Ap | 1.000
 | m | 3.000
 | Pa | 2.233 | kN | hours | 11000.000
 | Pr | 4.202 | kN | rotation speed | 1300.000 | rpm
 | pa/pr | 0.531 |  | L10 | 858.000 | MC
 | X | 0.560
 | Y | 1.518
 | P | 5.743 | kN
 | C | 54.569 | kN
Bearing 6407 | C0 | 31 | kN
 | C | 55.3 | kN
 | Pa/C0 | 0.072
 | lower point pa/c0 | 0.070
 | upper point pa/c0 | 0.130
 | lower point e | 0.270
 | upper point e | 0.310
 | slope | 0.667
 | e (interpolated) | 0.271
 | lower point y | 1.600
 | upper point y | 1.400
 | slope | -5.000
 | Y (interpolated) | 1.593

Sheet: Copy of Copy of Sheet2
 | Ap | 1.000
 | m | 3.000
 | Pa | 2.233 | kN | hours | 11000.000
 | Pr | 4.202 | kN | rotation speed | 1300.000 | rpm
 | pa/pr | 0.531 |  | L10 | 858.000 | MC
 | X | 0.560
 | Y | 1.593
 | P | 5.911 | kN
 | C | 56.166 | kN
Bearing 6408 | C0 | 36.5 | kN
 | C | 63.7 | kN
 | Pa/C0 | 0.061
 | lower point pa/c0 | 0.040
 | upper point pa/c0 | 0.070
 | lower point e | 0.240
 | upper point e | 0.270
 | slope | 1.000
 | e (interpolated) | 0.261
 | lower point y | 1.800
 | upper point y | 1.600
 | slope | -6.667
 | Y (interpolated) | 1.659

Sheet: Copy of Copy of Copy of Sheet2
Ap | 1.000
m | 3.000
Pa | 2.233 | kN | hours | 11000.000
Pr | 4.202 | kN | rotation speed | 1300.000 | rpm
pa/pr | 0.531 |  | L10 | 858.000 | MC
X | 0.560
Y | 1.659
P | 6.057 | kN
C | 57.558 | kN

Sheet: Copy of Copy of Copy of Sheet2
 | hours | 11000 |  |  | hours | 11000
 | rotation speed | 1300 | rpm |  | rotation speed | 1300 | rpm
 | L10 | 858 | MC |  | L10 | 858 | MC
 | Fra | 4.202 | N |  | Fra | 4.202 | kN
 | Frb | 3.887 | N |  | Frb | 3.887 | kN
 | Wae | -2.233 | N |  | Wae | -2.233 | kN
Bearing 30208 | m | 1900-01-02 |  | Bearing 30208 | m | 1900-01-02
c: 60.1 kN | lambda | 0.500 |  | c: 60.1 kN | lambda | 0.500
 | X | 0.560 |  |  | X | 0.560
 | Ya | 1.600 |  |  | Ya | 1.600
 | Yb | 1.600 |  |  | Yb | 1.600
 | Pa | 4.202 | N |  | Pa | 7.869 | kN
 | Pb | 7.851 | N |  | Pb | 3.887 | kN
 | Ca | 31.879 | N |  | Ca | 59.702 | kN
 | Cb | 59.559 | N |  | Cb | 29.489 | kN
