ChristopherLuey/315-MechanicalDesign/CAD 2/CAD2.SLDPRT

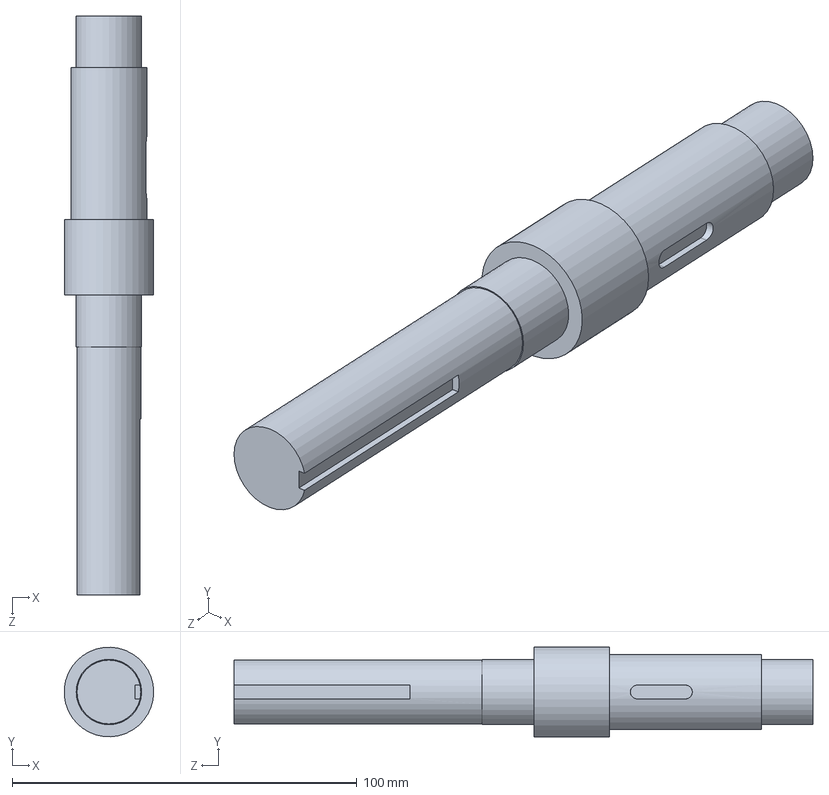
[picture p176: CAD file, 2024-10-16]
CAD 2/CAD2.SLDPRT
26.0 x 26.0 x 168.0 mm
