ChristopherLuey/315-MechanicalDesign/(list of files, cad)

Other CAD files:
CAD 2/Revision/CAD2.SLDPRT
315 Project/CAD/CAD Shaft 1/Shaft 1 updated dec 6/bearing_shim_s1.prt
315 Project/CAD/CAD Shaft 1/Shaft 1 updated dec 6/felt_seal.prt
315 Project/CAD/CAD Shaft 1/Shaft 1 updated dec 6/gasket_s1.prt
315 Project/CAD/CAD Shaft 1/Shaft 1 updated dec 6/gear1_v3.prt
315 Project/CAD/CAD Shaft 1/Shaft 1 updated dec 6/gear1_v3_dwg1.prt
315 Project/CAD/CAD Shaft 1/Shaft 1 updated dec 6/housing_s1.prt
315 Project/CAD/CAD Shaft 1/Shaft 1 updated dec 6/right_endcap_shaft1.prt
315 Project/CAD/CAD Shaft 1/Shaft 1 updated dec 6/shaft1.prt
315 Project/CAD/CAD Shaft 1/Shaft 1 updated dec 6/shaft1_assembly_v2.prt
315 Project/CAD/CAD Shaft 1/Shaft 1 updated dec 6/shaft1_assembly_v2_dwg1.prt
315 Project/CAD/CAD Shaft 1/Shaft 1 updated dec 6/shaft1_dwg1.prt
315 Project/CAD/CAD Shaft 1/Shaft 1 updated dec 6/skf_bearing_6309_2.x_t
315 Project/CAD/CAD Shaft 1/Shaft 1 updated dec 6/skf_bearing_6309_2_x_t.prt
315 Project/CAD/CAD Shaft 1/Shaft 1 updated dec 6/spacer_shaft1.prt
315 Project/CAD/CAD Shaft 1/ignore/New Version/shaft1.prt
315 Project/CAD/CAD Shaft 1/ignore/Old version/shaft.prt
315 Project/CAD/CAD Shaft 1/ignore/Old version/shaft1_assembly.prt
315 Project/CAD/CAD Shaft 1/ignore/Old version/shaft_dwg1.prt
315 Project/CAD/CAD Shaft 1/ignore/Shaft 1 Final Full Assembly (all parts)/Endcaps/left_endcap_shaft1.prt
315 Project/CAD/CAD Shaft 1/ignore/Shaft 1 Final Full Assembly (all parts)/Endcaps/right_endcap_shaft1.prt
315 Project/CAD/CAD Shaft 1/ignore/Shaft 1 Final Full Assembly (all parts)/Gear (correct)/gear1_v3.prt
315 Project/CAD/CAD Shaft 1/ignore/Shaft 1 Final Full Assembly (all parts)/Gear (correct)/gear1_v3_dwg1.prt
315 Project/CAD/CAD Shaft 1/ignore/Shaft 1 Final Full Assembly (all parts)/Spacer/spacer_shaft1.prt
315 Project/CAD/CAD Shaft 1/ignore/Shaft 1 Final Full Assembly (all parts)/assembly/assembly_shaft_1.prt
315 Project/CAD/CAD Shaft 1/ignore/Shaft 1 Final Full Assembly (all parts)/assembly/assembly_shaft_1_dwg1.prt
315 Project/CAD/CAD Shaft 1/ignore/Shaft 1 Final Full Assembly (all parts)/shaft/shaft1.prt
315 Project/CAD/CAD Shaft 1/ignore/Shaft 1 Final Full Assembly (all parts)/shaft/shaft1_dwg1.prt
315 Project/CAD/CAD Shaft 1/ignore/Shaft 1 updated dec 6/felt_seal.prt
315 Project/CAD/CAD Shaft 1/ignore/Shaft 1 updated dec 6/gear1_v3.prt
315 Project/CAD/CAD Shaft 1/ignore/Shaft 1 updated dec 6/gear1_v3_dwg1.prt
315 Project/CAD/CAD Shaft 1/ignore/Shaft 1 updated dec 6/right_endcap_shaft1.prt
315 Project/CAD/CAD Shaft 1/ignore/Shaft 1 updated dec 6/shaft1.prt
315 Project/CAD/CAD Shaft 1/ignore/Shaft 1 updated dec 6/shaft1_assembly_v2.prt
315 Project/CAD/CAD Shaft 1/ignore/Shaft 1 updated dec 6/shaft1_assembly_v2_dwg1.prt
315 Project/CAD/CAD Shaft 1/ignore/Shaft 1 updated dec 6/skf_bearing_6309_2.x_t
315 Project/CAD/CAD Shaft 1/ignore/Shaft 1 updated dec 6/skf_bearing_6309_2_x_t.prt
315 Project/CAD/CAD Shaft 1/ignore/Shaft 1 updated dec 6/spacer_shaft1.prt
315 Project/CAD/CAD Shaft 1/ignore/Shaft 1 updated/felt_seal(1).prt
315 Project/CAD/CAD Shaft 1/ignore/Shaft 1 updated/felt_seal.prt
315 Project/CAD/CAD Shaft 1/ignore/Shaft 1 updated/gear1_v3(1).prt
315 Project/CAD/CAD Shaft 1/ignore/Shaft 1 updated/gear1_v3.prt
315 Project/CAD/CAD Shaft 1/ignore/Shaft 1 updated/right_endcap_shaft1(1).prt
315 Project/CAD/CAD Shaft 1/ignore/Shaft 1 updated/right_endcap_shaft1.prt
315 Project/CAD/CAD Shaft 1/ignore/Shaft 1 updated/shaft1(1).prt
315 Project/CAD/CAD Shaft 1/ignore/Shaft 1 updated/shaft1.prt
315 Project/CAD/CAD Shaft 1/ignore/Shaft 1 updated/shaft1_assembly_v2(1).prt
315 Project/CAD/CAD Shaft 1/ignore/Shaft 1 updated/shaft1_assembly_v2.prt
315 Project/CAD/CAD Shaft 1/ignore/Shaft 1 updated/shaft1_assembly_v2_dwg1(1).prt
315 Project/CAD/CAD Shaft 1/ignore/Shaft 1 updated/shaft1_assembly_v2_dwg1.prt
315 Project/CAD/CAD Shaft 1/ignore/Shaft 1 updated/skf_bearing_6309_2(1).x_t
315 Project/CAD/CAD Shaft 1/ignore/Shaft 1 updated/skf_bearing_6309_2.x_t
315 Project/CAD/CAD Shaft 1/ignore/Shaft 1 updated/skf_bearing_6309_2_x_t(1).prt
315 Project/CAD/CAD Shaft 1/ignore/Shaft 1 updated/skf_bearing_6309_2_x_t.prt
315 Project/CAD/CAD Shaft 1/ignore/Shaft 1 updated/spacer_shaft1(1).prt
315 Project/CAD/CAD Shaft 1/ignore/Shaft 1 updated/spacer_shaft1.prt
315 Project/CAD/CAD Shaft 1/ignore/WRONG bearing 6209/skf_bearing_6209_2.x_t
315 Project/CAD/CAD Shaft 1/ignore/WRONG gear (bad keyway-shaft hole)/gear1_redo.prt
315 Project/CAD/CAD Shaft 1/ignore/WRONG gear (bad keyway-shaft hole)/gear1_redo_dwg1 (1).prt
315 Project/CAD/CAD Shaft 1/ignore/WRONG gear (bad keyway-shaft hole)/gear1_redo_dwg1.prt
315 Project/CAD/CAD Shaft 3/end_plate_left.prt
315 Project/CAD/CAD Shaft 3/end_plate_right.prt
315 Project/CAD/CAD Shaft 3/gear.prt
315 Project/CAD/CAD Shaft 3/gear_drawing.prt
315 Project/CAD/CAD Shaft 3/shaft3.prt
315 Project/CAD/CAD Shaft 3/shaft3_assembly.prt
315 Project/CAD/CAD Shaft 3/shaft3_assembly_dwg1.prt
315 Project/CAD/CAD Shaft 3/shaft3_dwg1.prt
315 Project/CAD/CAD Shaft 3/skf_bearing_6311_2.x_t
315 Project/CAD/CAD Shaft 3/skf_bearing_6311_2_stp.prt
315 Project/CAD/CAD Shaft 3/spacer.prt
CAD 1/ring.prt
CAD 1/ring_dwg1.prt
CAD 1/shaft.prt
CAD 2/CAD2.SLDDRW
CAD 2/Revision/CAD2.SLDDRW
CAD 3/CAD3.prt
CAD 3/CAD3_dwg1.prt
CAD 3/CAD3_ring.prt
CAD 4/gear.prt
CAD 4/gear_dwg1.prt
CAD 5/ball.prt
CAD 5/bearing.prt
CAD 5/bearing_assem.prt
CAD 5/bearing_assem_dwg1.prt
CAD 5/bearing_inner.prt
