ChristopherLuey/315-MechanicalDesign/CAD 1/cal0232_nthw_ring_dwg1.pdf

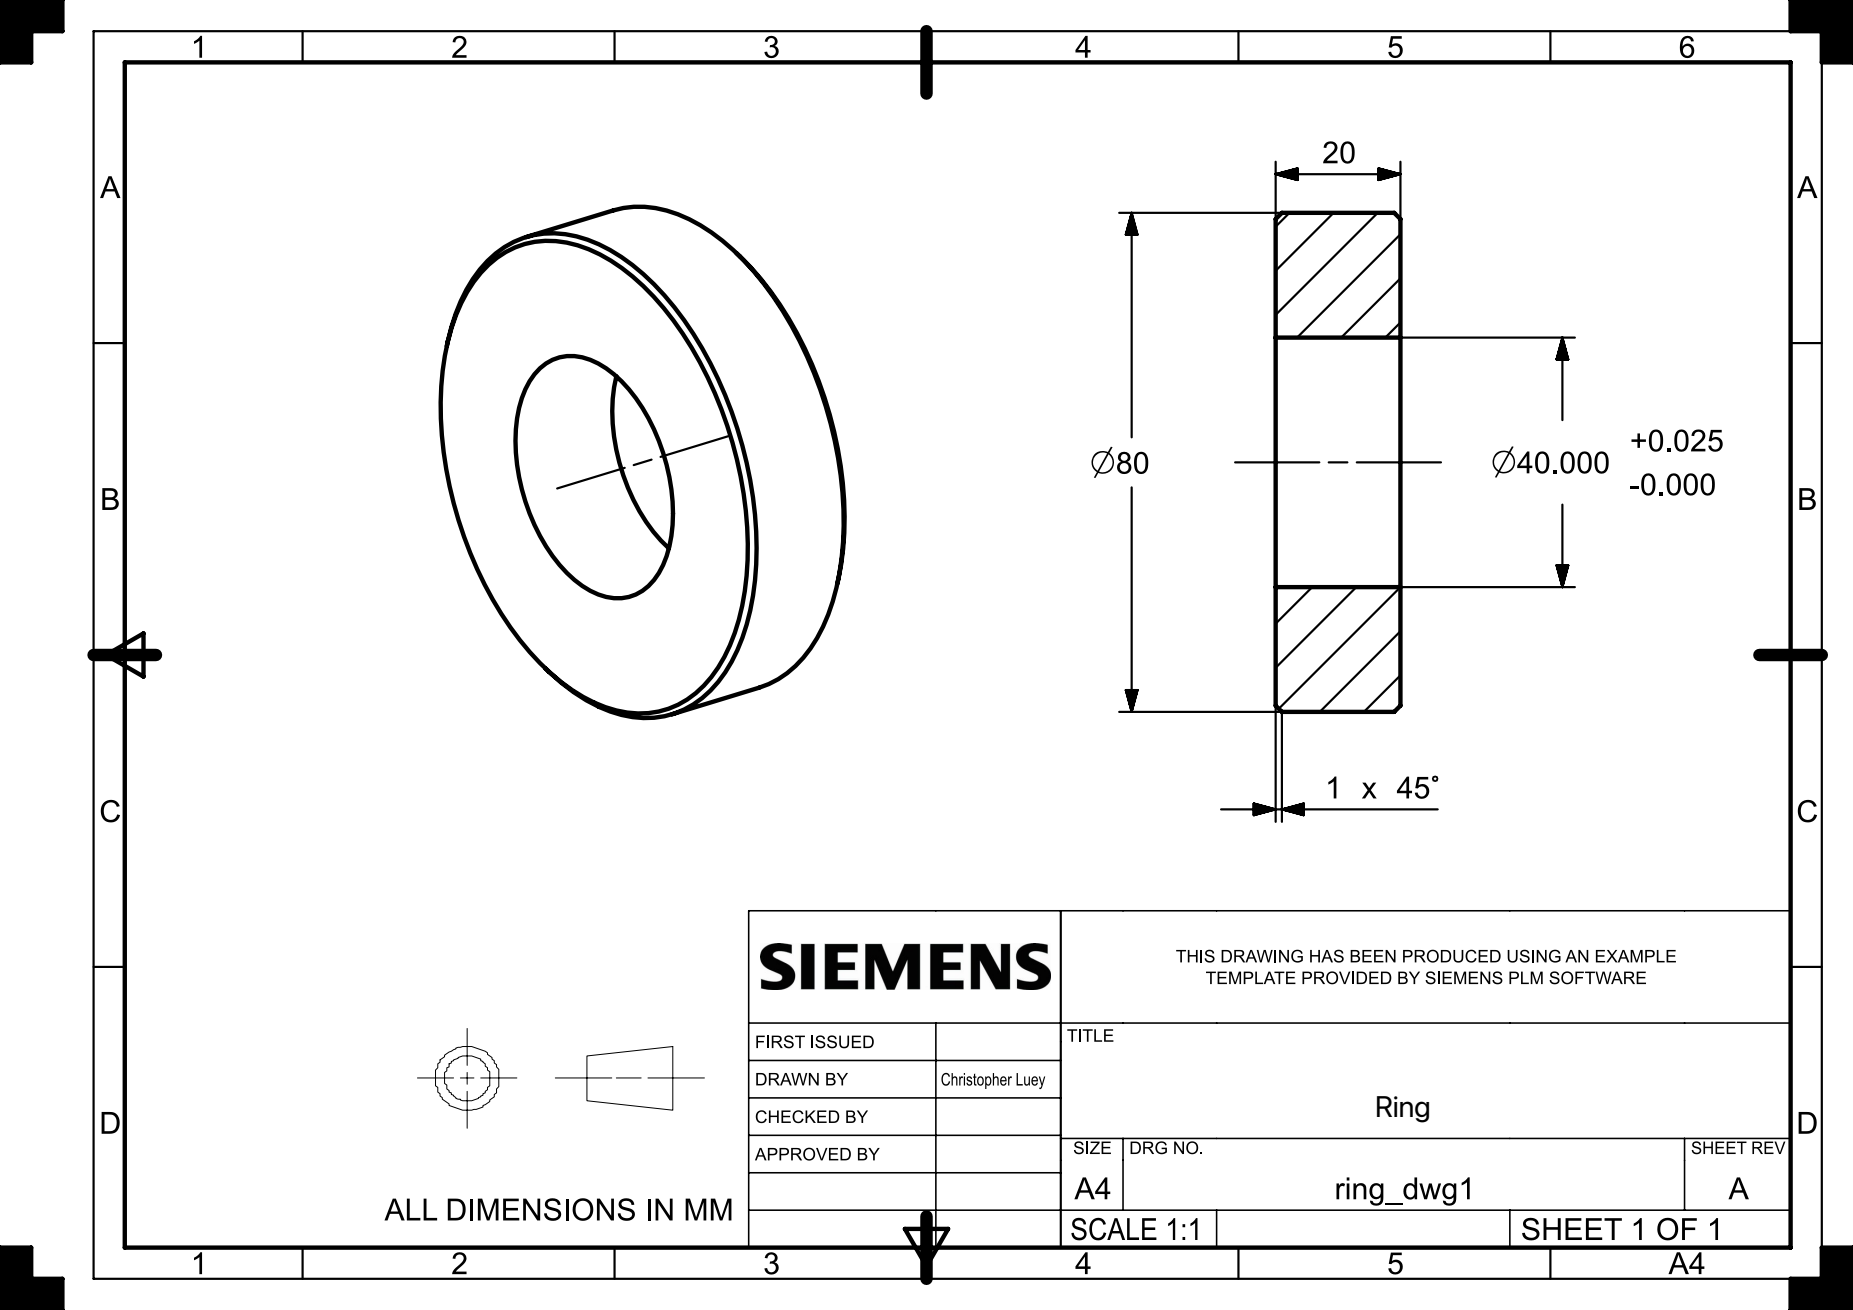
[picture p202: page 1]
