ChristopherLuey/315-MechanicalDesign/CAD 1/cal0232_nthw_shaft.pdf

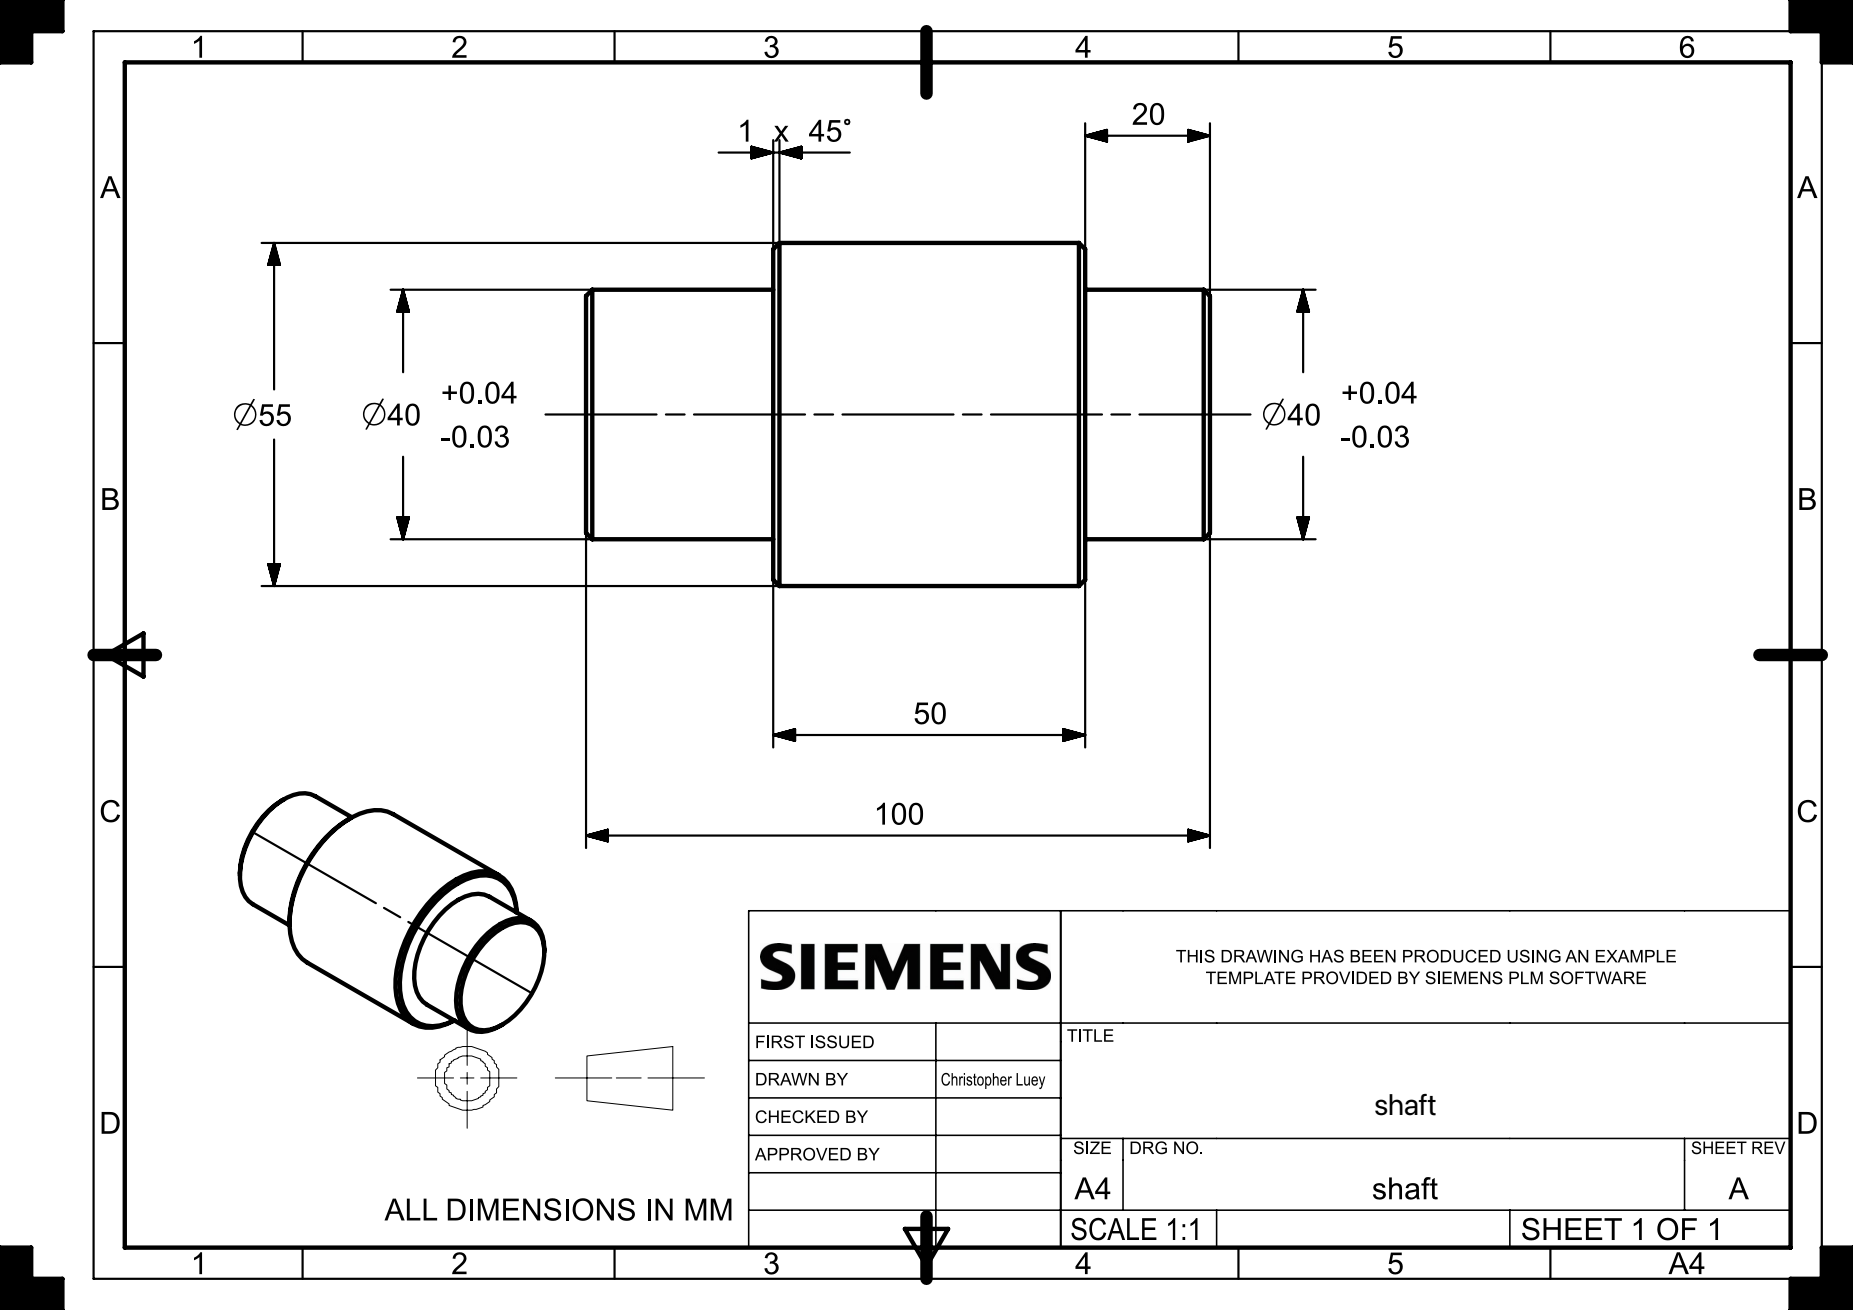
[picture p203: page 1]
