ChristopherLuey/315-MechanicalDesign/CAD 4/cal0232_gear_dwg1.pdf

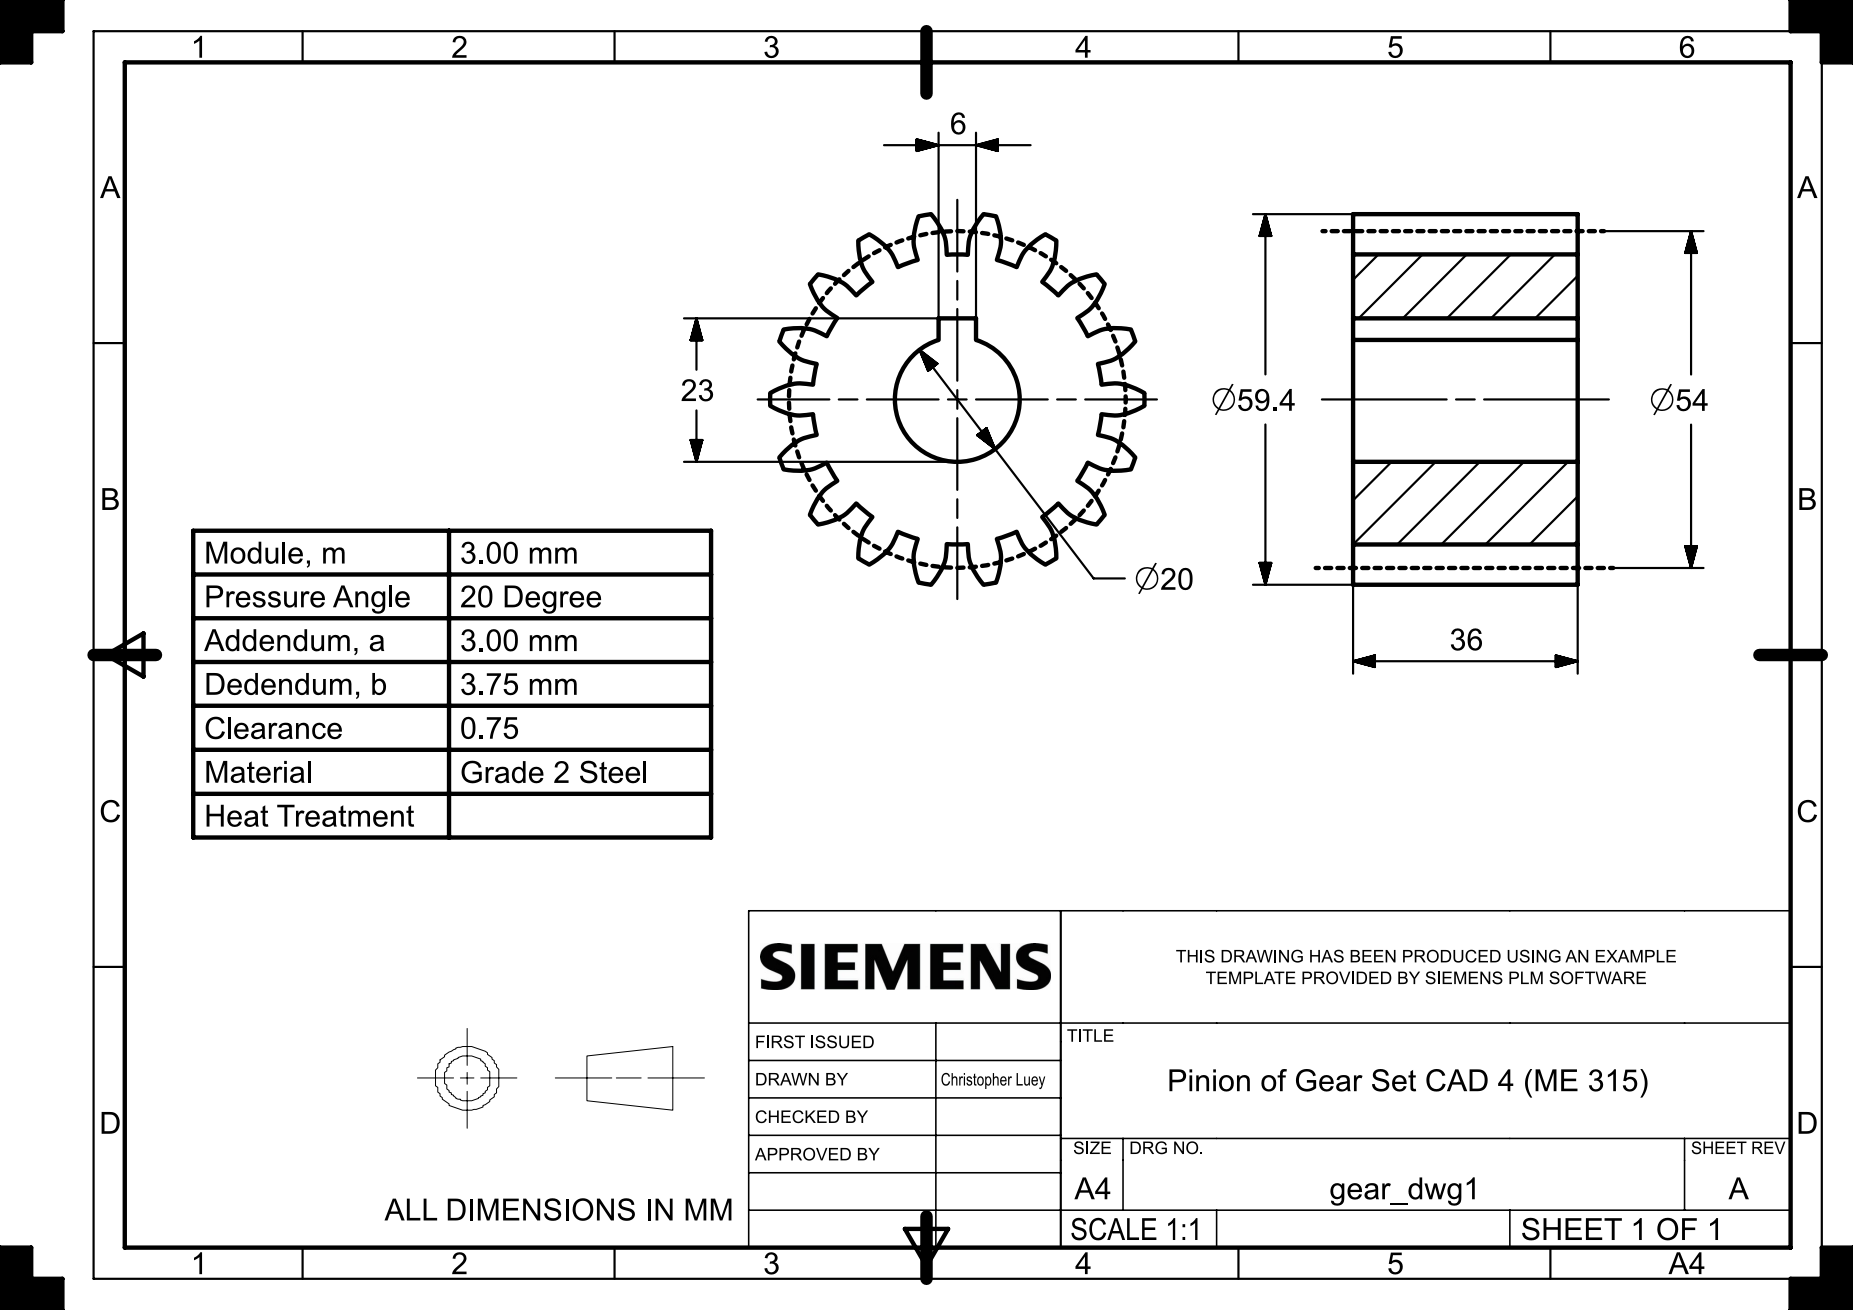
[picture p204: page 1]
