ChristopherLuey/315-MechanicalDesign/315 Project/CAD/CAD Shaft 3/cal0232_gear_drawing.pdf

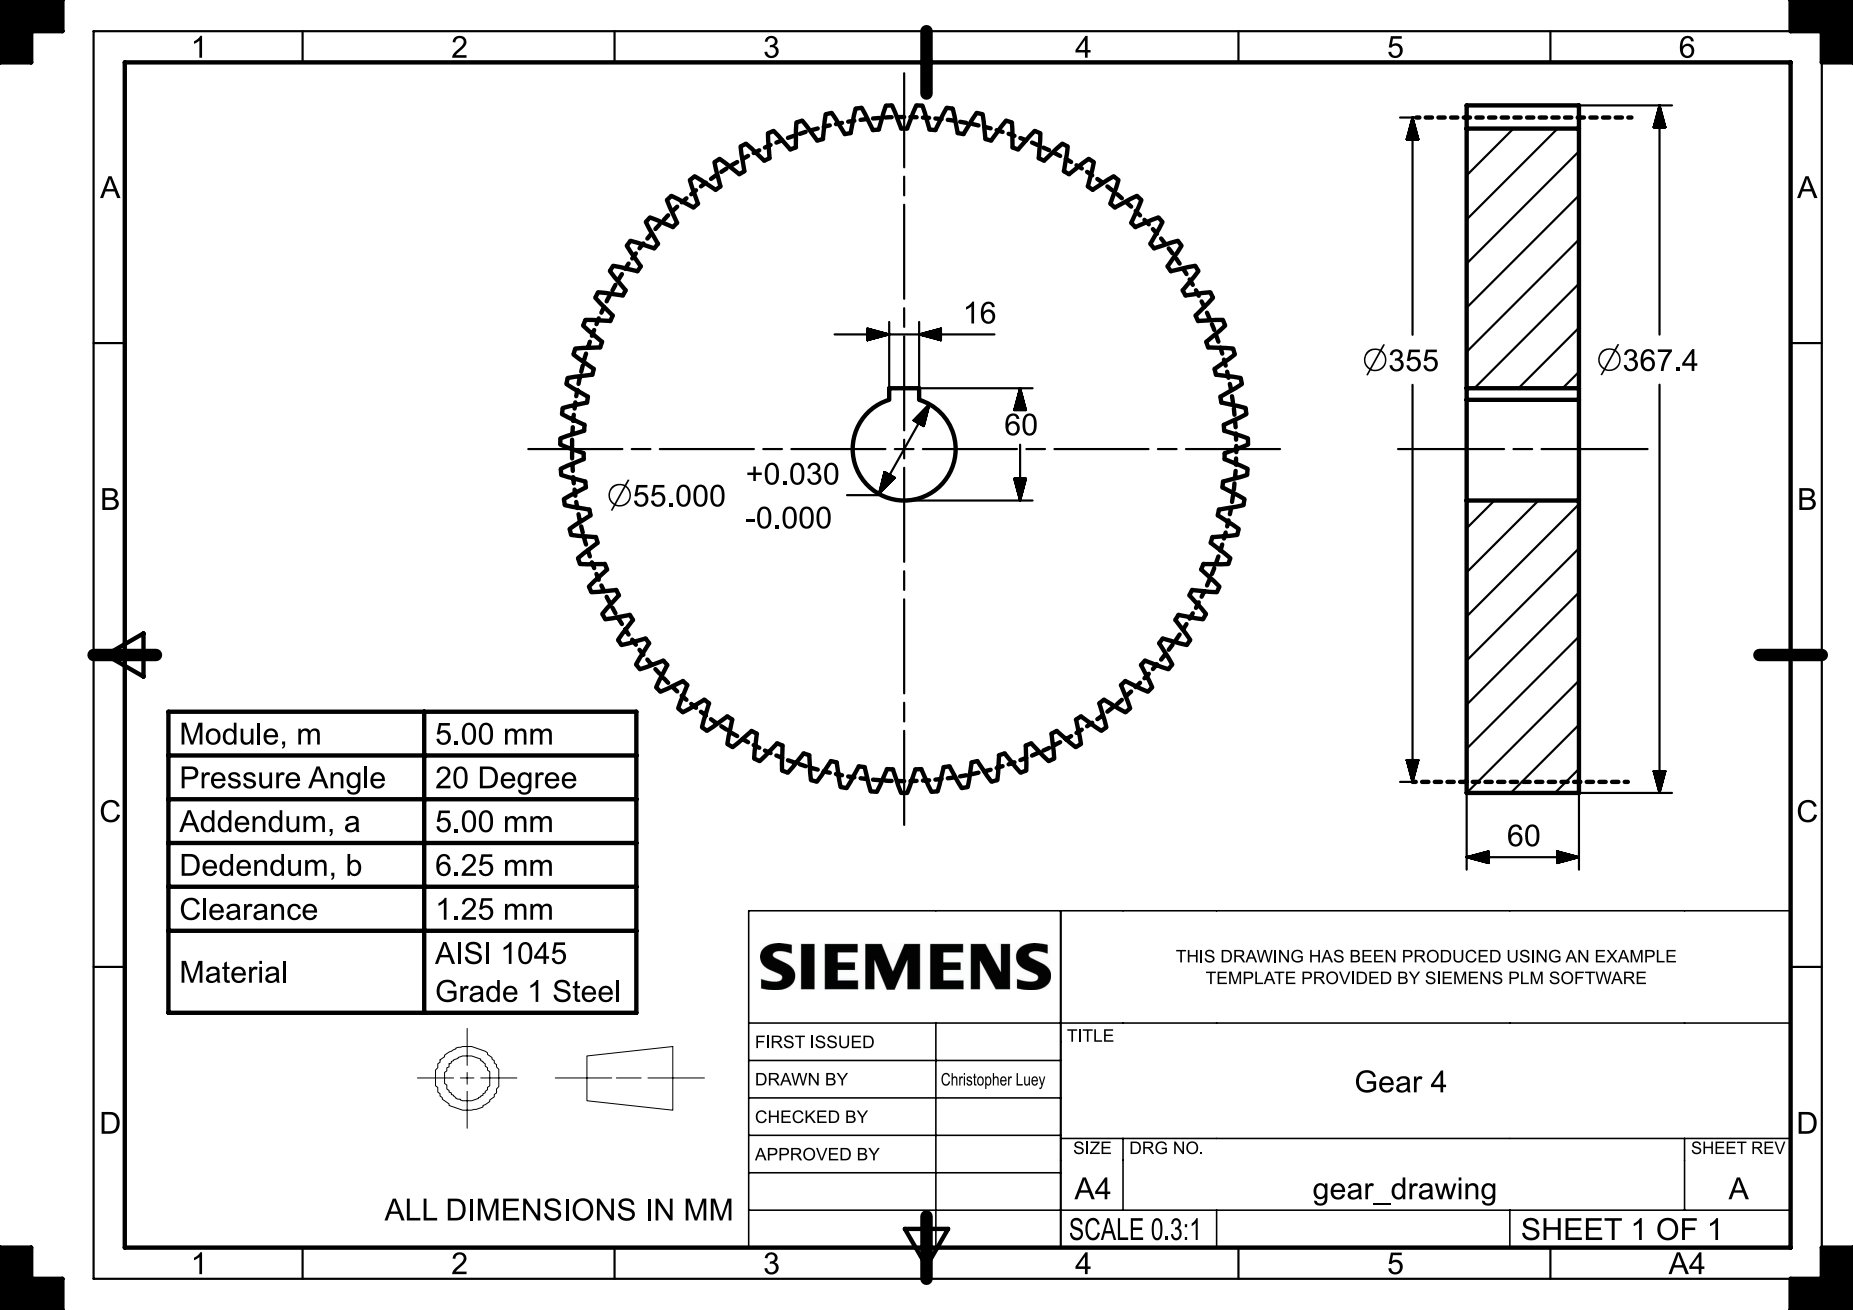
[picture p205: page 1]
