ChristopherLuey/315-MechanicalDesign/315 Project/CAD/CAD Shaft 3/cal0232_shaft3_dwg1.pdf

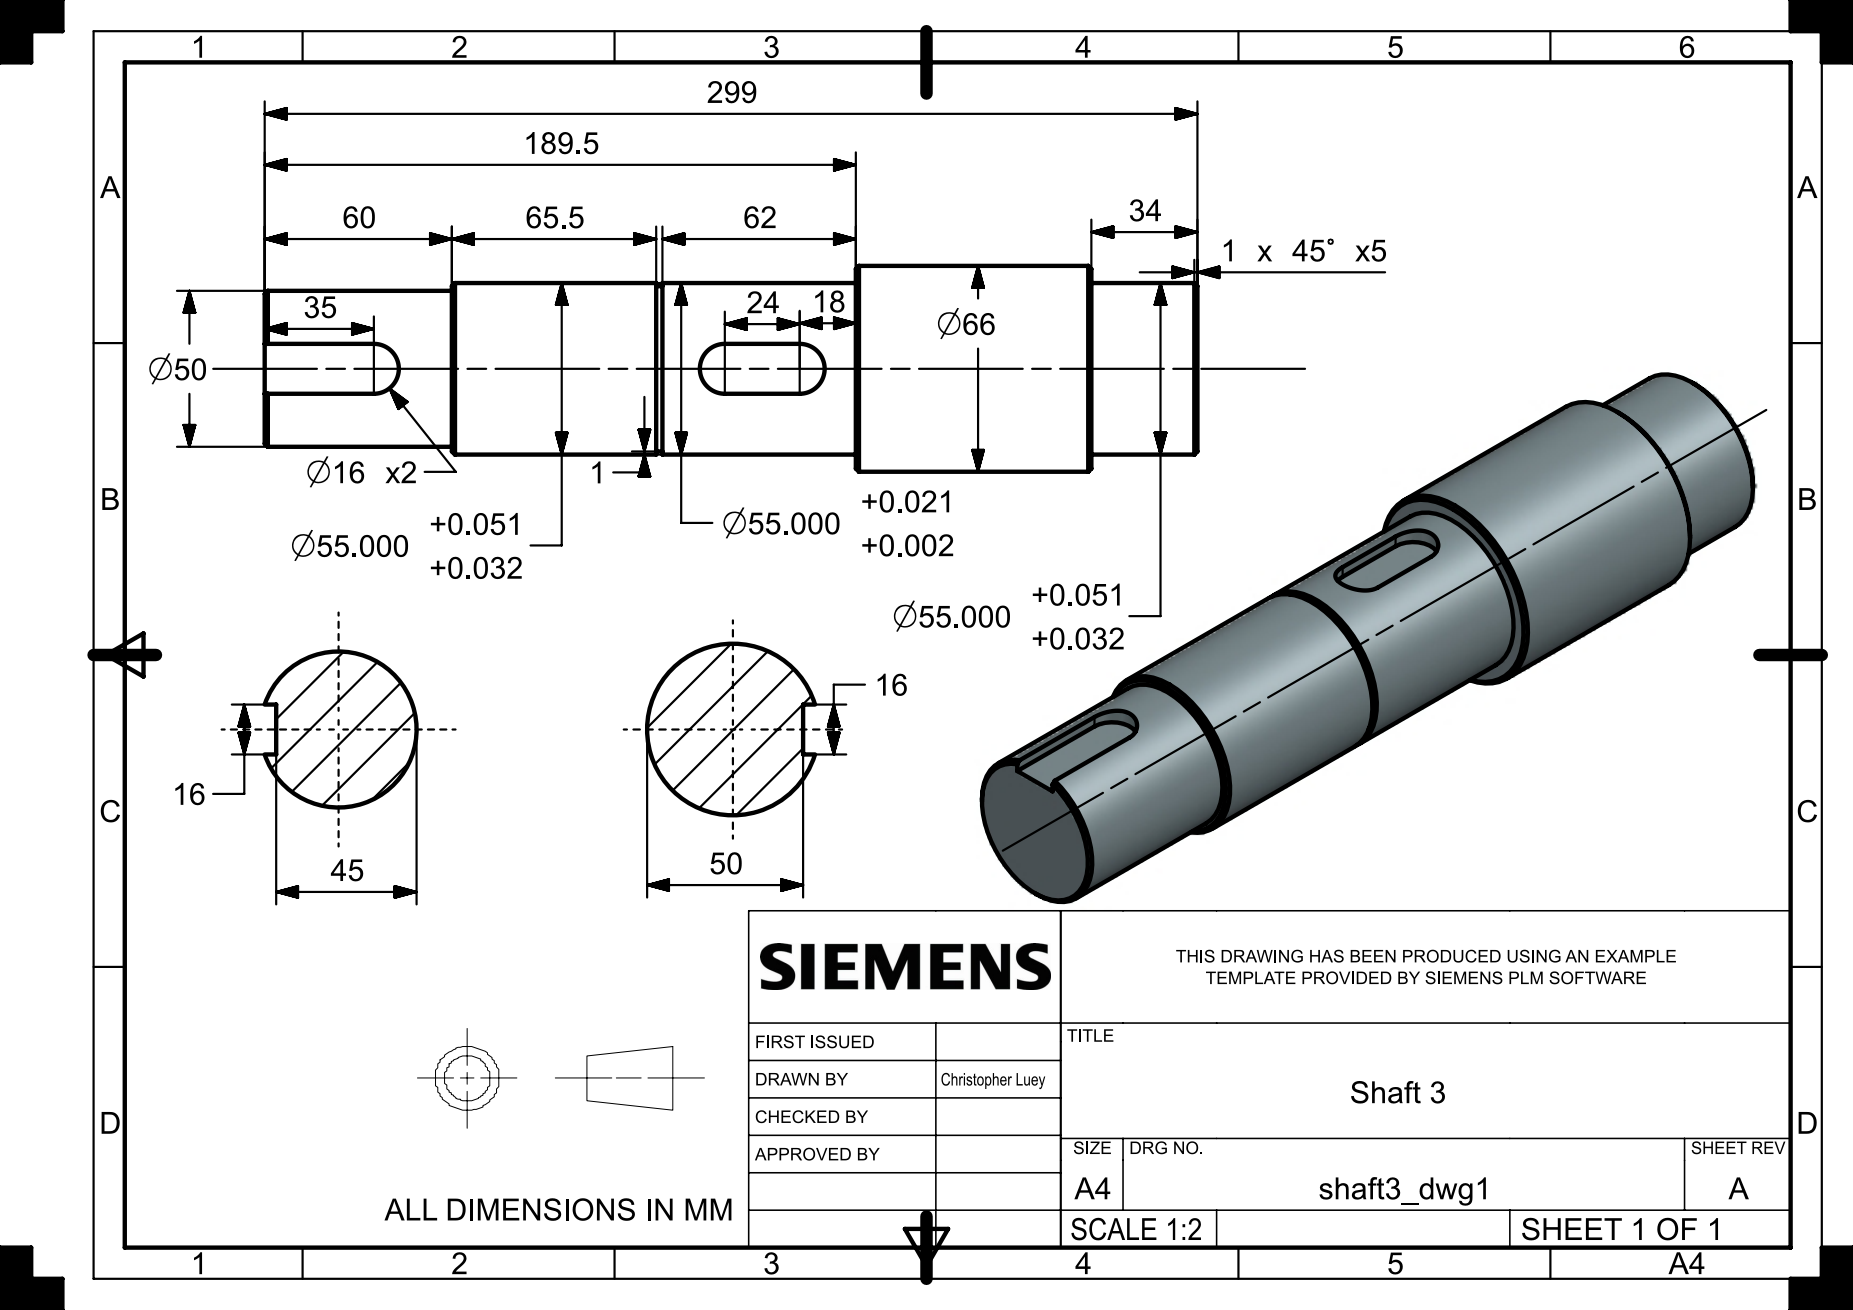
[picture p206: page 1]
