ChristopherLuey/315-MechanicalDesign/315 Project/CAD/CAD Shaft 1/PDF Drawings/cbl2512_gear1_v3_dwg1.pdf

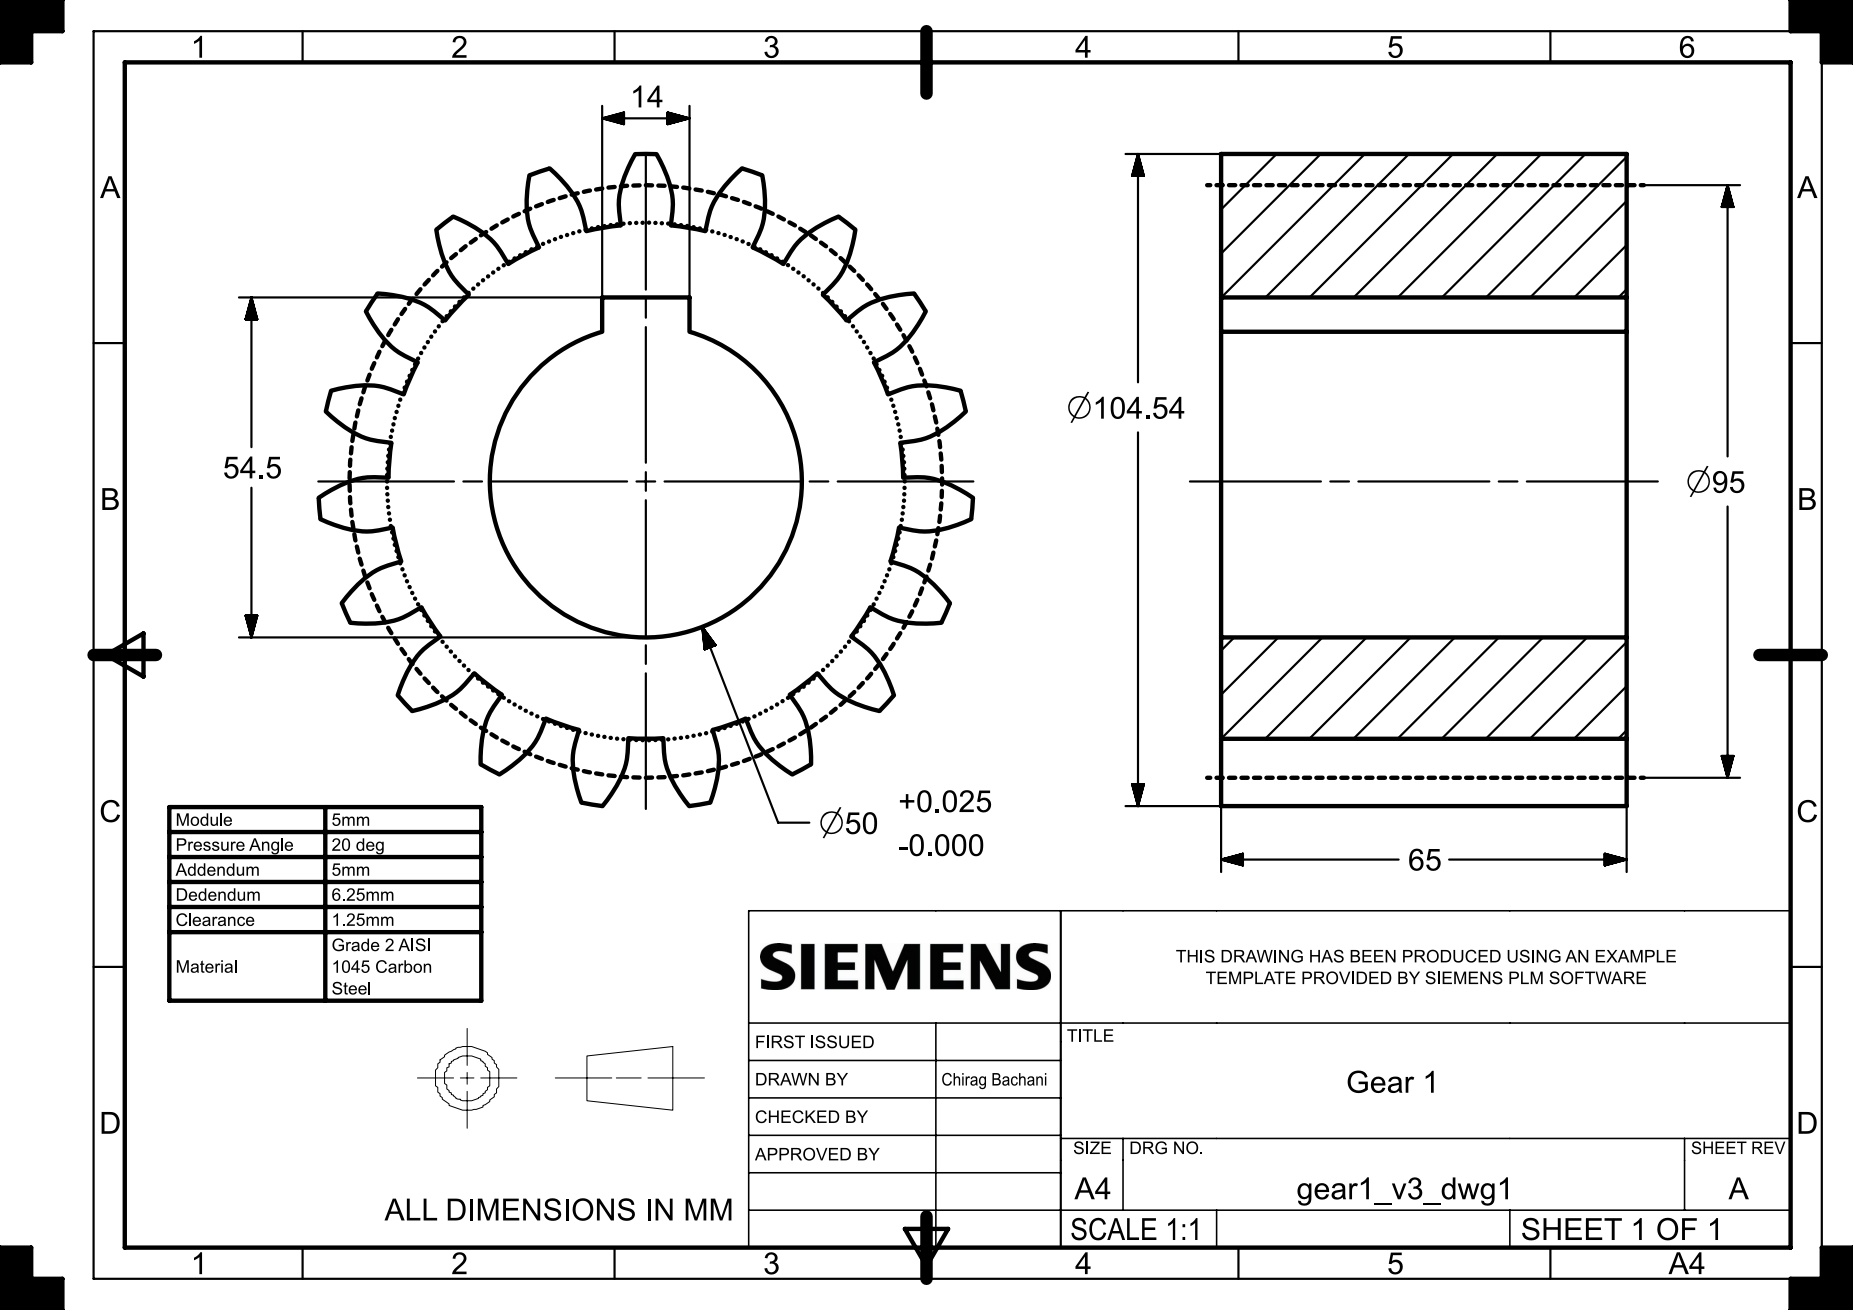
[picture p207: page 1]
