ChristopherLuey/315-MechanicalDesign/315 Project/CAD/CAD Shaft 1/PDF Drawings/cbl2512_shaft1_dwg1.pdf

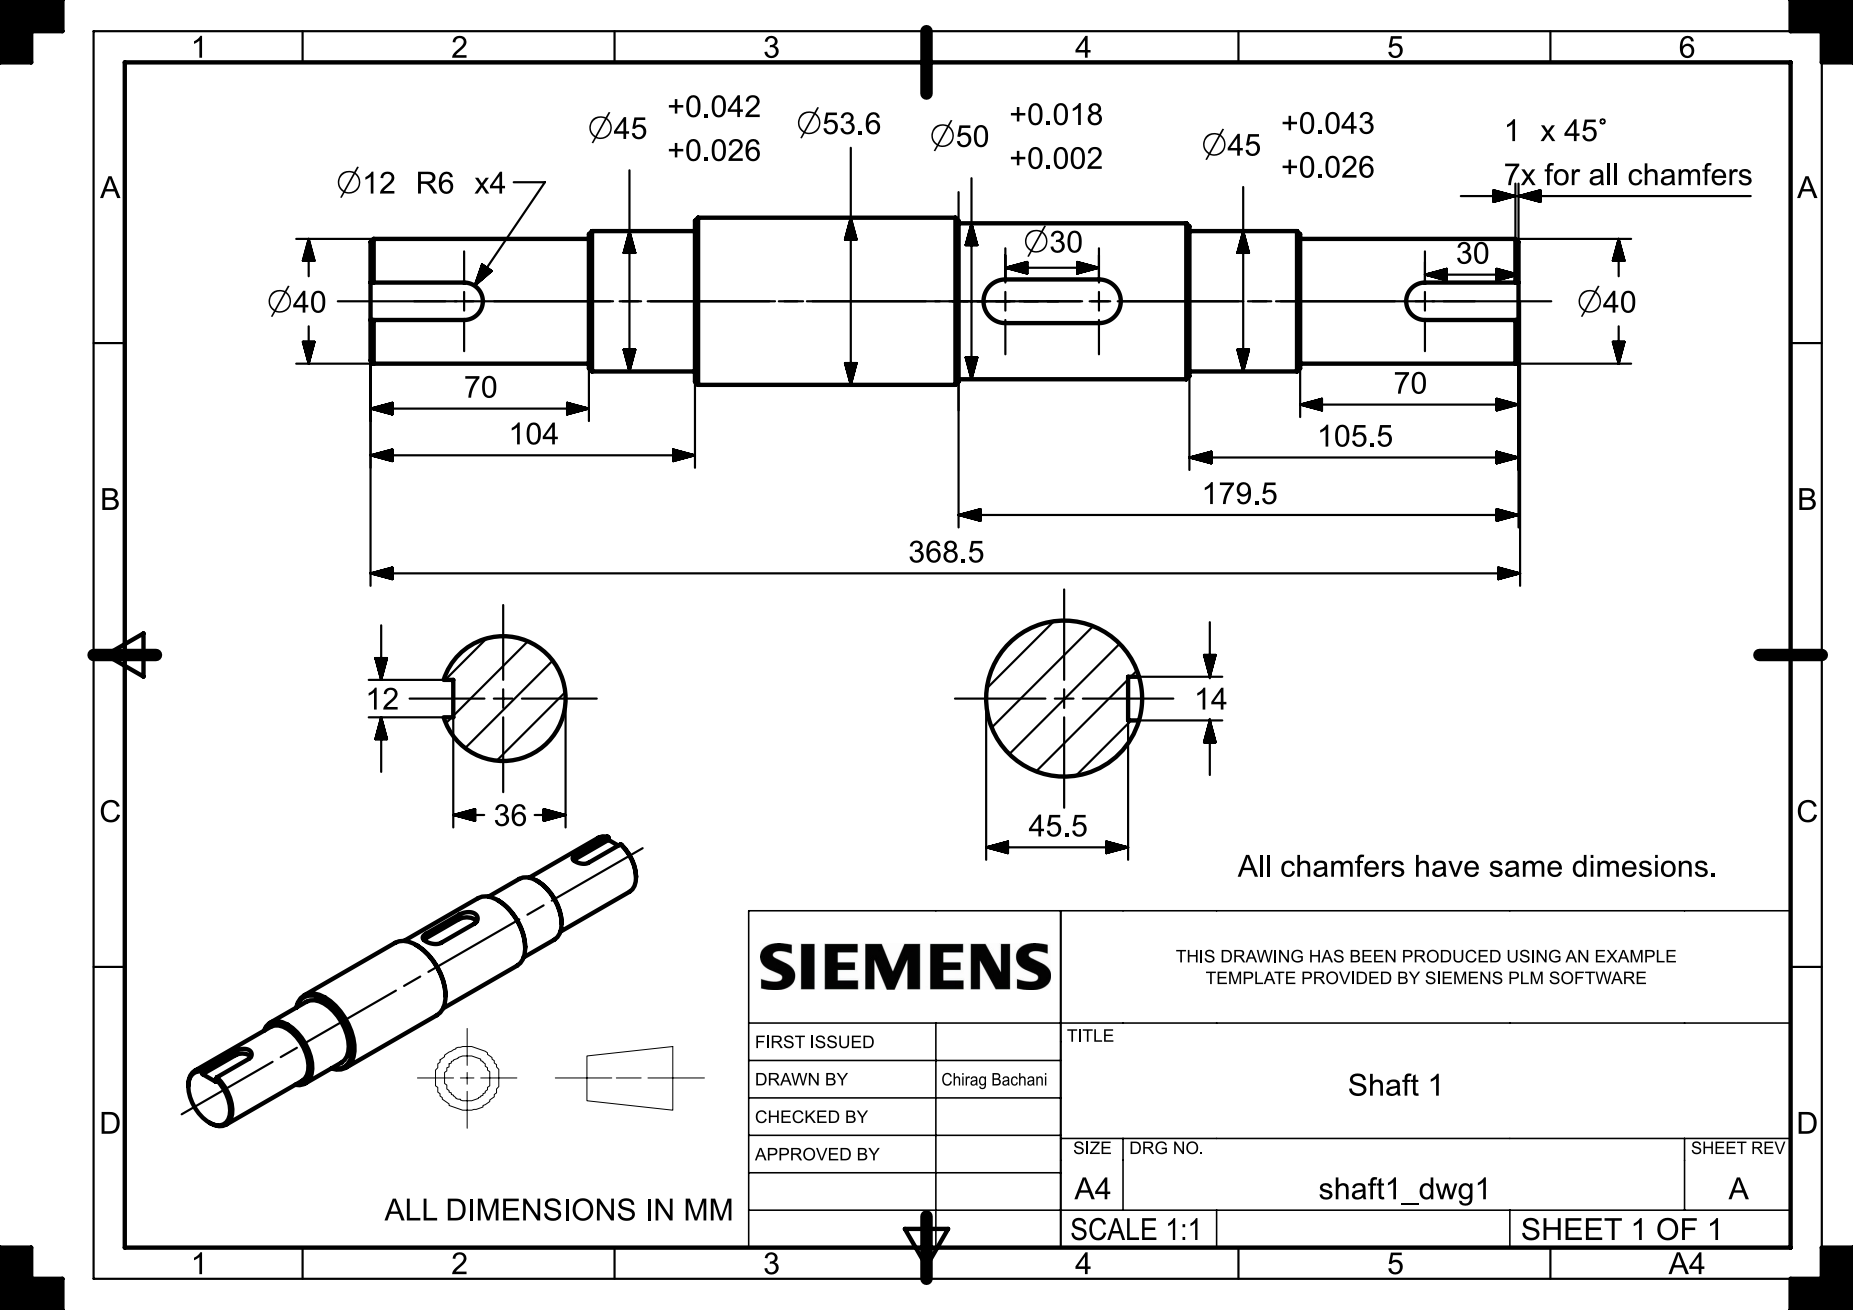
[picture p208: page 1]
