ChristopherLuey/315-MechanicalDesign/315 Project/CAD/CAD Shaft 1/ignore/Drawing PDFs/cbl2512_shaft1_dwg1.pdf

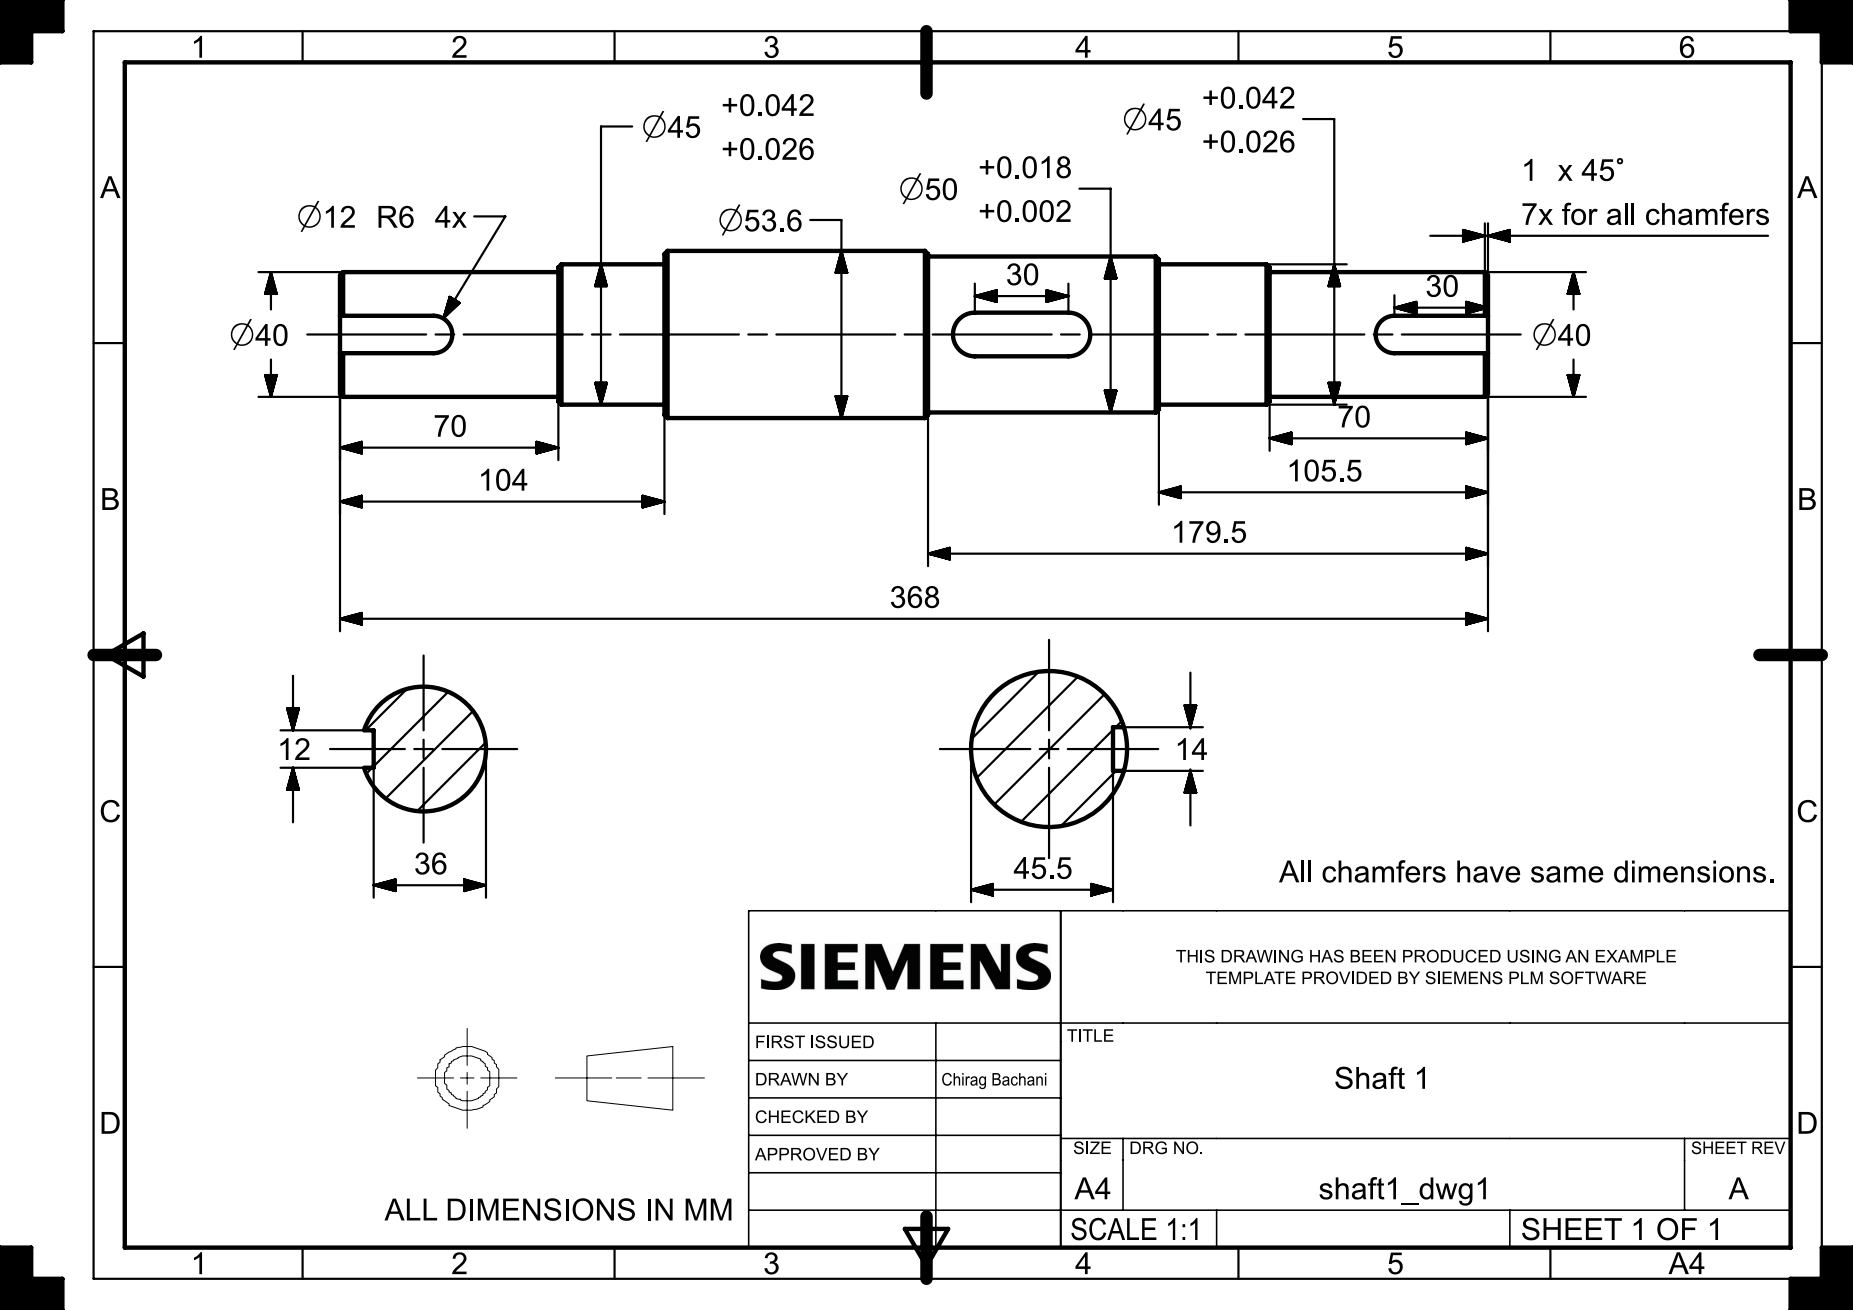
[picture p209: page 1]
