ChristopherLuey/315-MechanicalDesign/CAD25.pdf

26.00

8.00

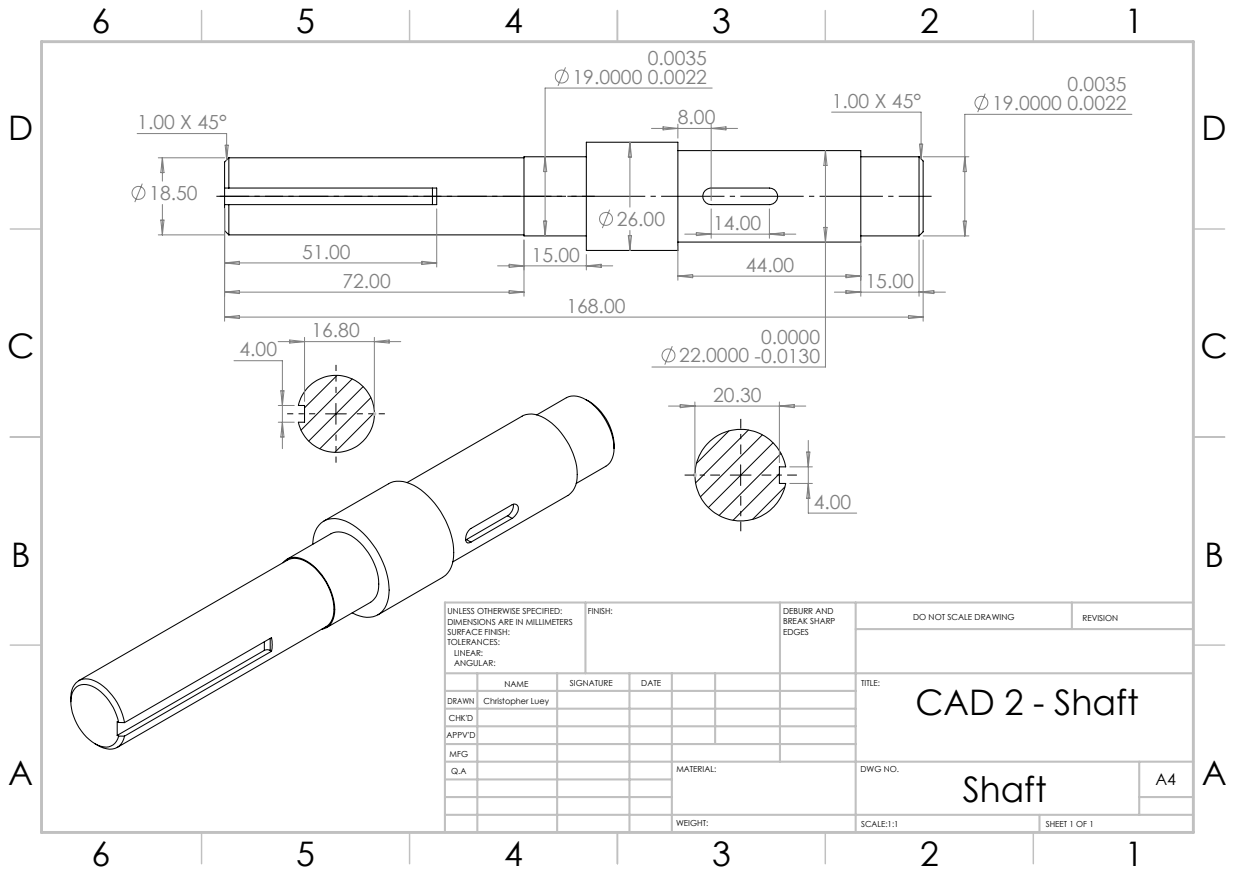
[picture p177: page 1]
FINISH:; DEBURR AND; BREAK SHARP EDGES; DO NOT SCALE DRAWING; REVISION; SCALE:1:1; SHEET 1 OF 1; WEIGHT:

UNLESS OTHERWISE SPECIFIED:
DIMENSIONS ARE IN MILLIMETERS
SURFACE FINISH:
TOLERANCES:
LINEAR:
ANGULAR:

NAME | SIGNATURE | DATE | | | | TITLE: CAD 2 - Shaft

DRAWN | Christopher Luey
CHK'D
APPV'D
MFG
Q.A | | | | MATERIAL: | DWG NO. Shaft | A4

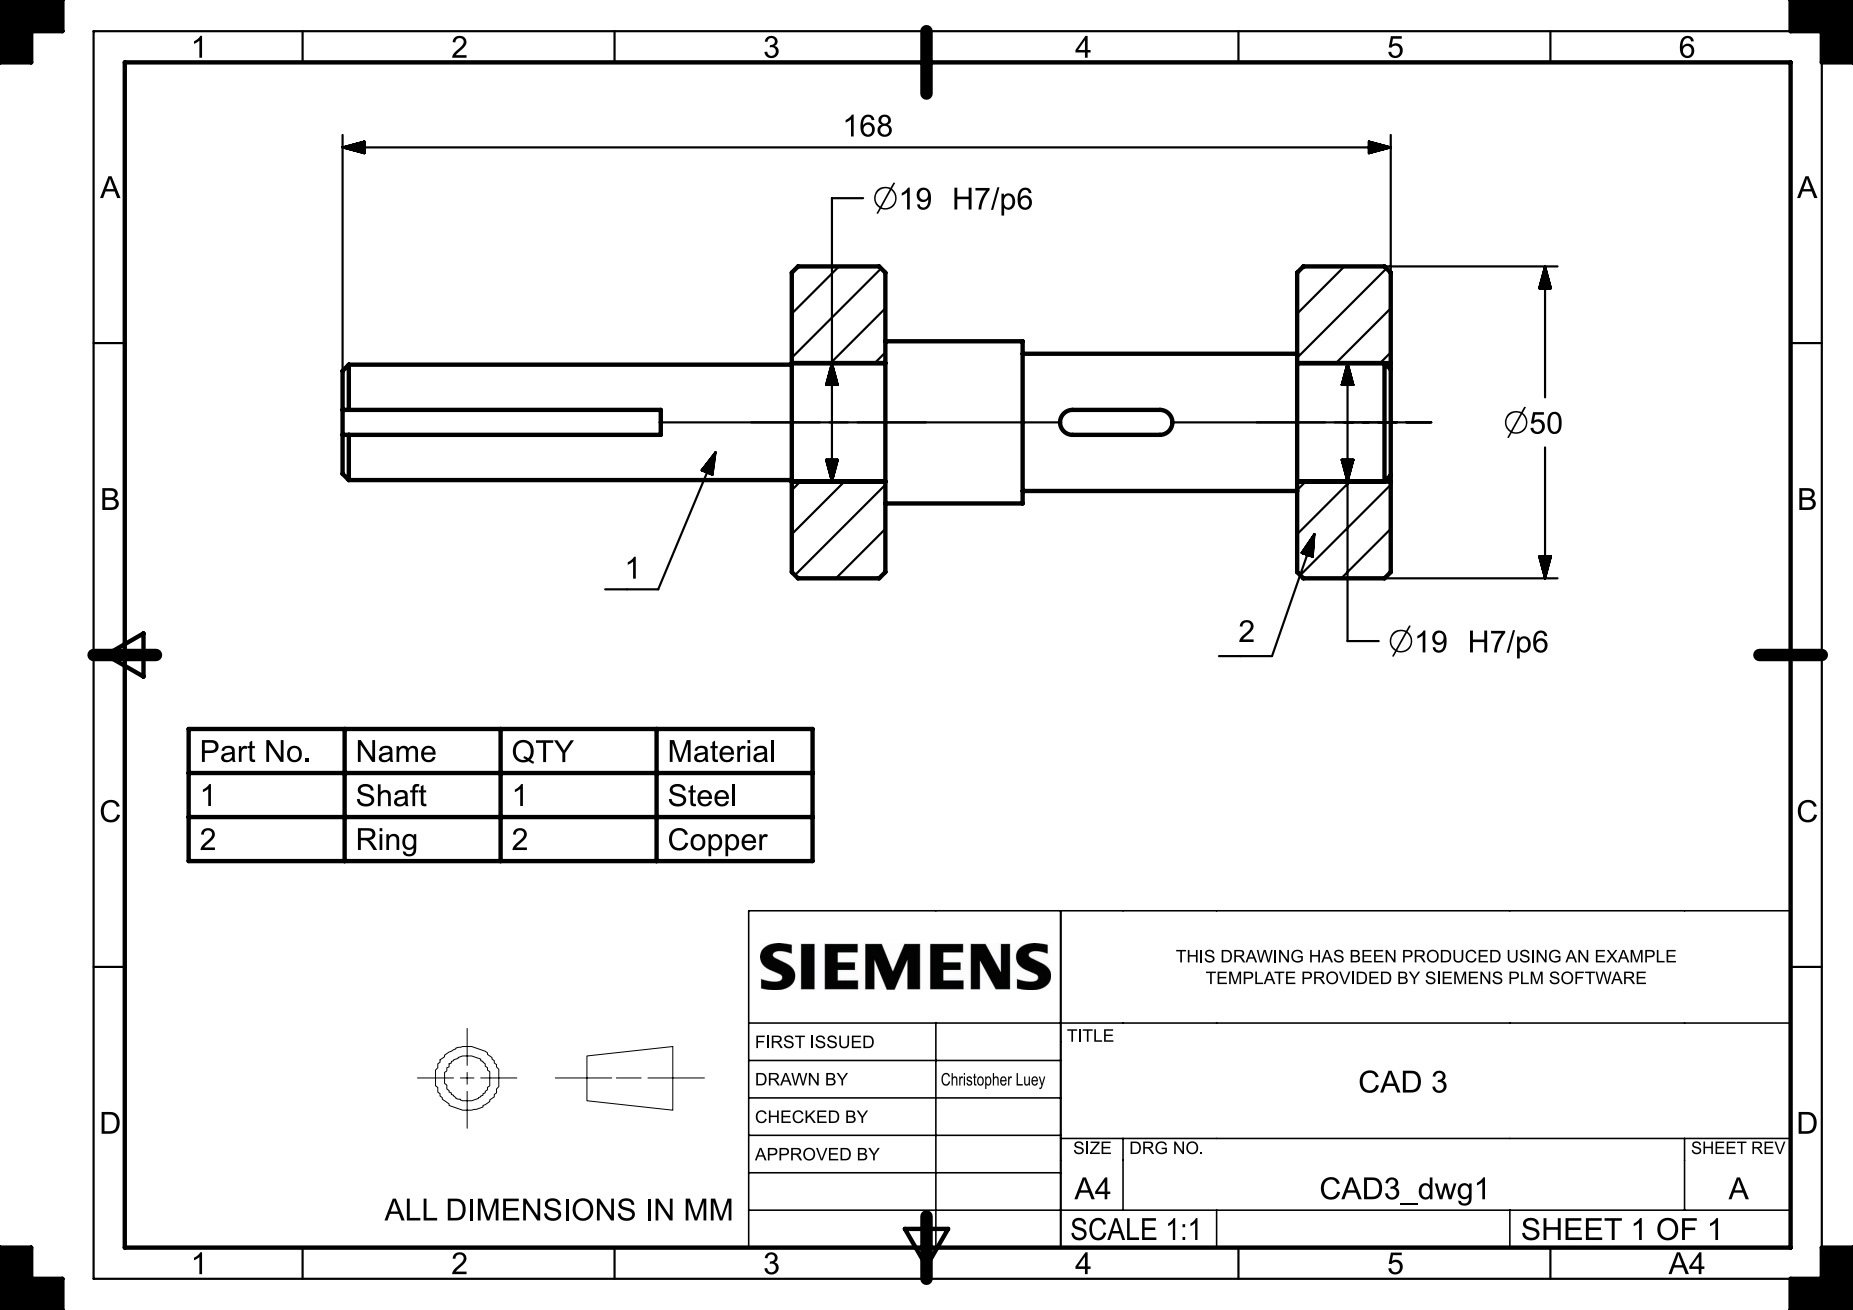
[picture p178: page 2]

- | 1 | 2 | 3

6

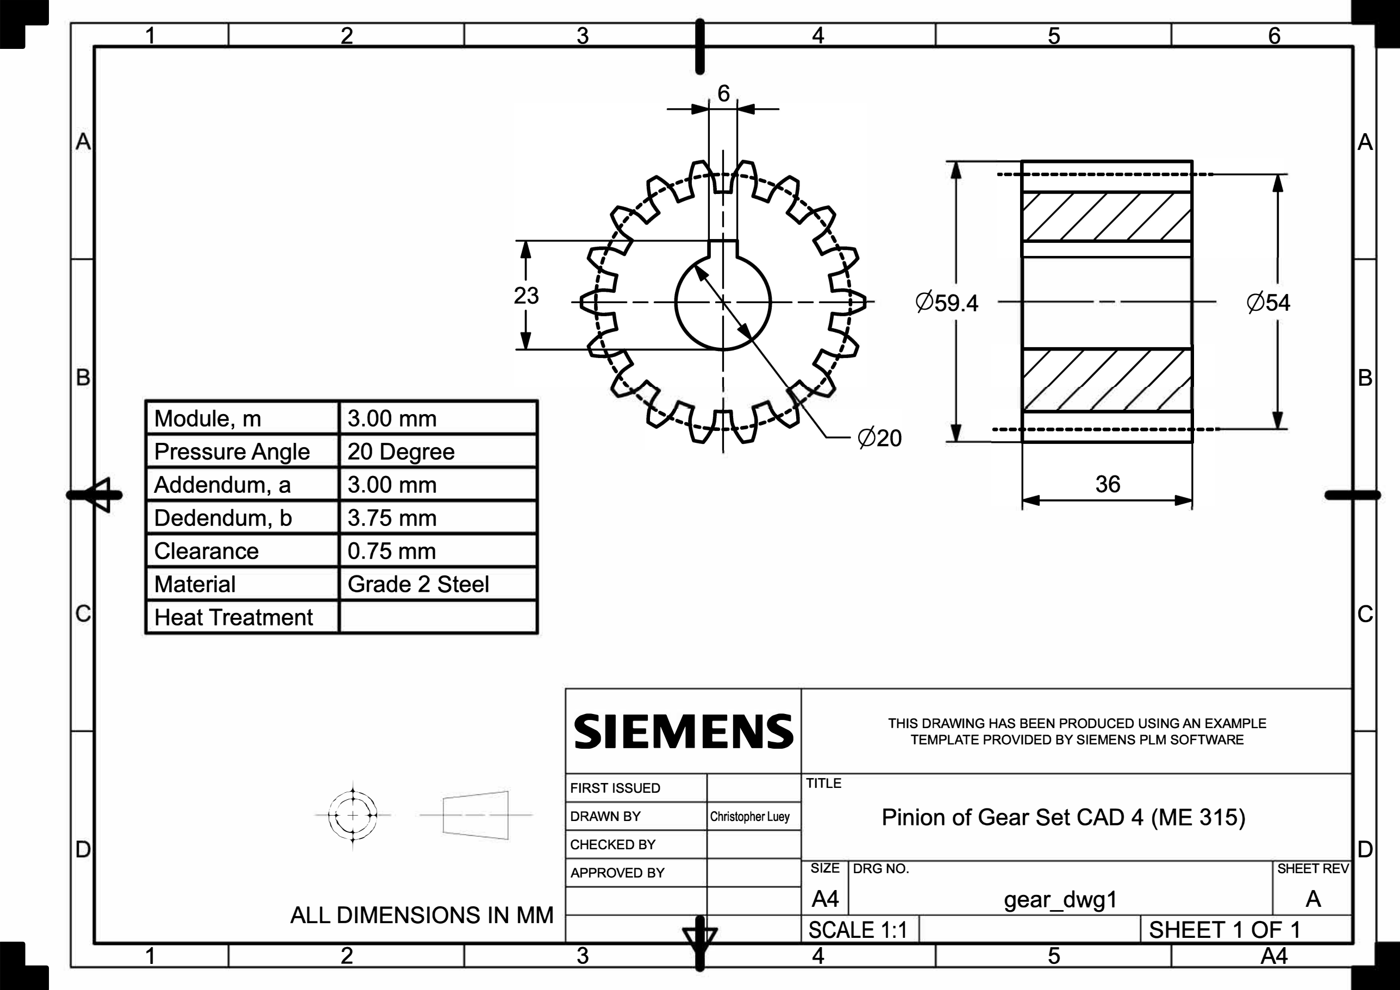
[picture p179: page 3]

# Module, m Pressure Angle Addendum, a Dedendum, b Clearance Material

3.00 mm

# 20 Degree

3.00 mm
3.75 mm
0.75 mm

# Grade 2 Steel Heat Treatment

# SIEMENS

| | | FIRST ISSUED
DRAWN BY | Christopher Luey
| | | CHECKED BY APPROVED BY
| | ALL DIMENSIONS IN MM
- | 1 | 2 | 3

4

TITLE

SIZE
A4
5 | 6
059.4 | 054

THIS DRAWING HAS BEEN PRODUCED USING AN EXAMPLE TEMPLATE PROVIDED BY SIEMENS PLM SOFTWARE

# Pinion of Gear Set CAD 4 (ME 315)

DRG NO.

# gear_dwg1

SHEET REV
A
SCALE 1:1 | | SHEET 1 OF 1
4 | 5 | A4

A

B

C

D

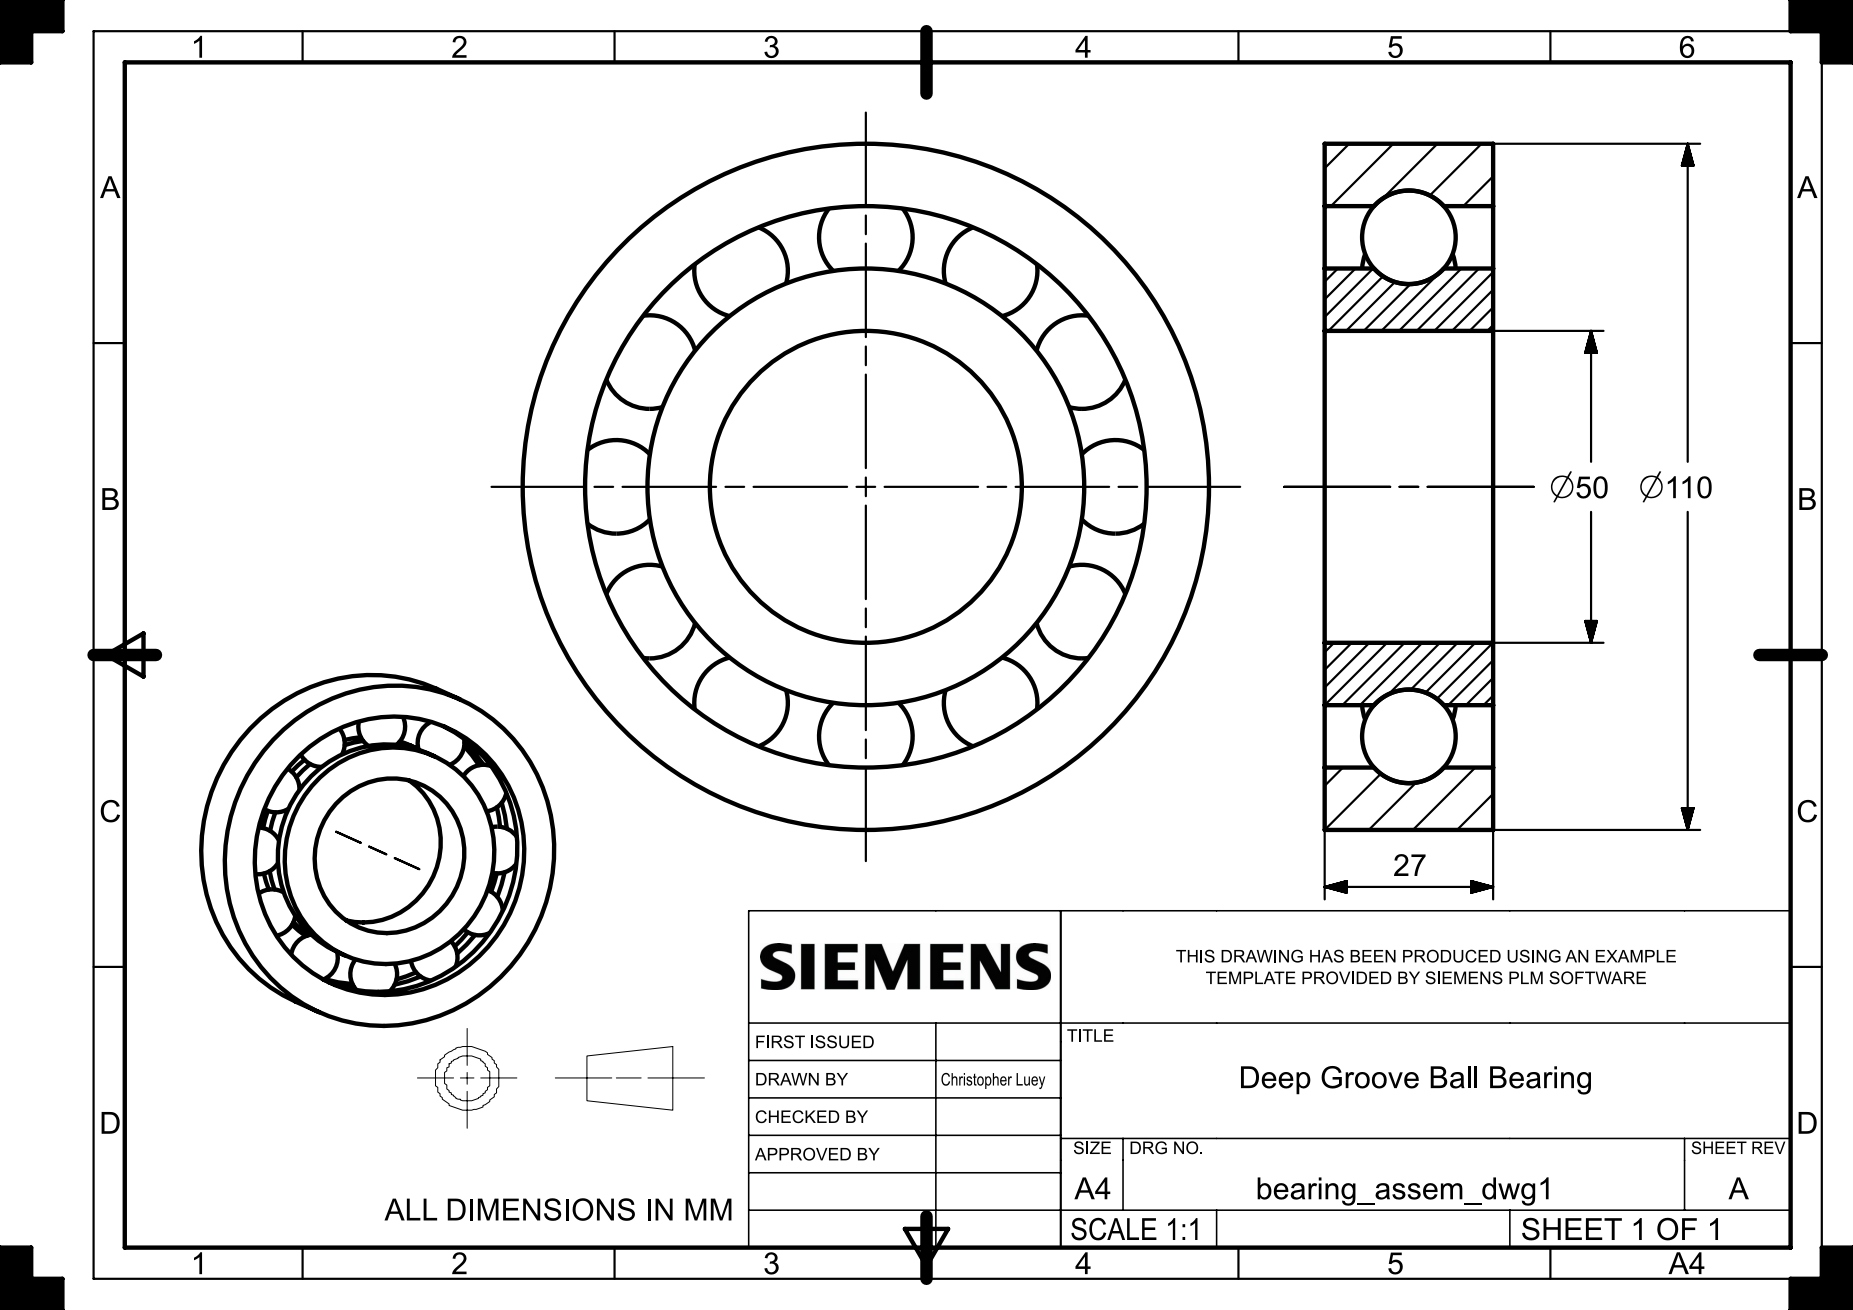
[picture p180: page 4]
