ChristopherLuey/315-MechanicalDesign/315 Project/Submission.pdf

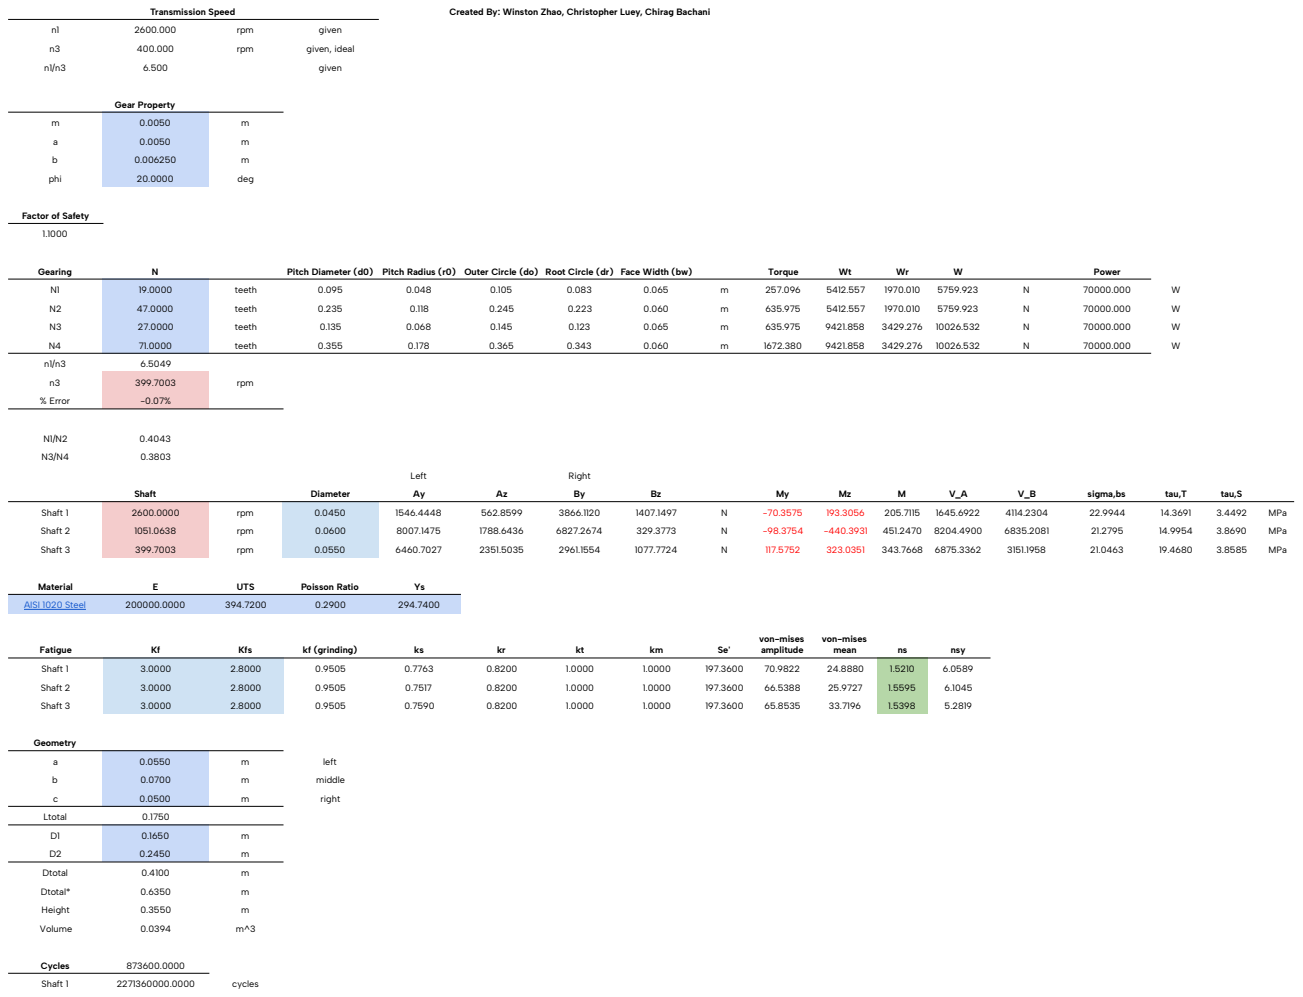
[picture p181: page 1]
Transmission Speed; Created By: Winston Zhao, Christopher Luey, Chirag Bachani; rpm; given; given, ideal; Gear Property; phi; deg; Gearing; Pitch Diameter (d0) Pitch Radius (r0) Outer Circle (do) Root Circle (dr) Face Width (bw); Torque; Power; AddendumDedendum; teeth; % Error; Left; Right; Shaft; Diameter; sigma,bs; tau,T; tau,S; Shaft 1; MPa; Shaft 2; Shaft 3; Material; UTS; Poisson Ratio; AISI 1020 Steel; Fatigue; Kfs; kf (grinding); von-mises amplitude; von-mises; mean; nsy; Geometry; MMMM

Factor of Safety

a b c | 0.0550 0.0700 0.0500 | m left m middle m right

Ltotal | 0.1750
D1 D2 | 0.1650 0.2450 | m m

Dtotal Dtotal* Height Volume Cycles | 0.4100 m 0.6350 m 0.3550 m 0.0394 m^3

873600.0000
Shaft 1 | 2271360000.0000 cycles

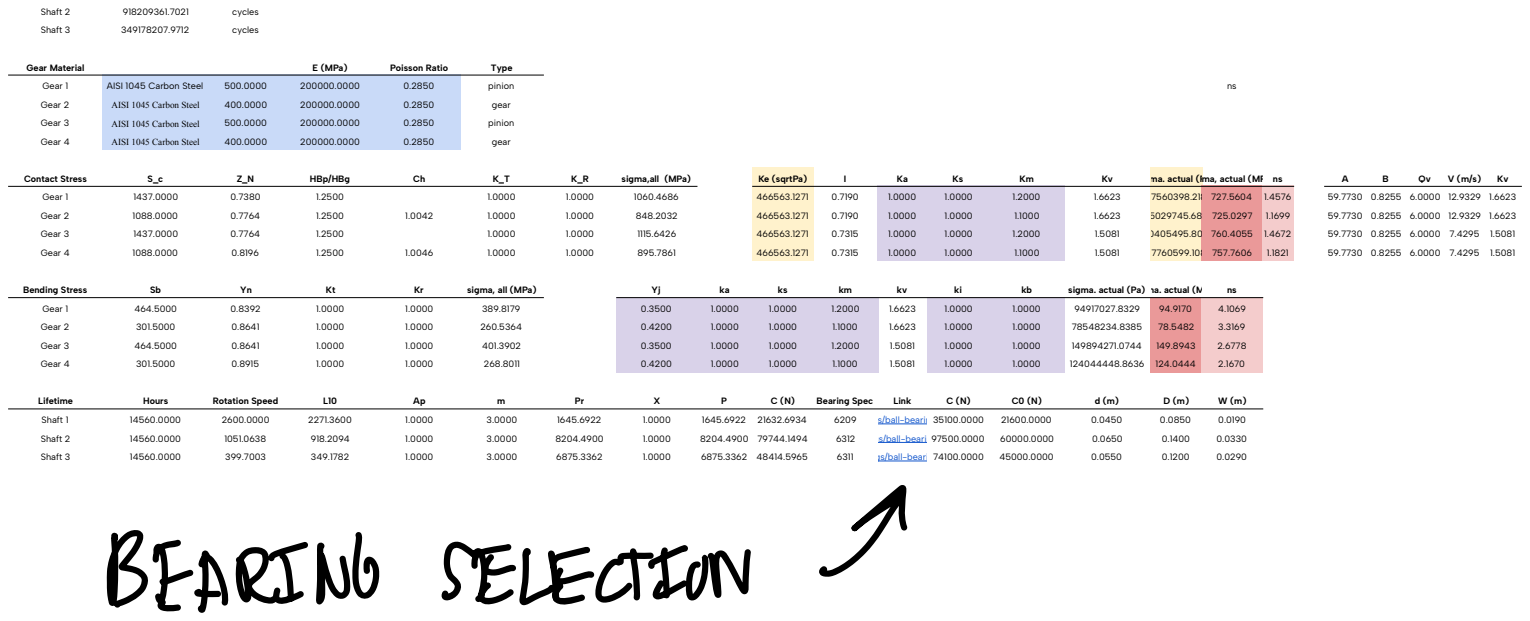
[picture p182: page 2]
Shaft 2; cycles; Shaft 3; Gear Material; E (MPa); Poisson Ratio; Type; Gear 1; AISI 1045 Carbon Steel; pinion; Gear 2; gear; Gear 3; Gear 4; Contact Stress; HBp/HBg; sigma,all (MPa); Ke (sqrtPa); sigma. actual (Pa) sigma, actual (MPa)ns; Bending Stress; sigma, all (MPa); sigma. actual (Pa) sigma. actual (MPa) ns; Lifetime; Hours; Rotation Speed; Bearing Spec; Link; Shaft 1; BEARING SELECTION A

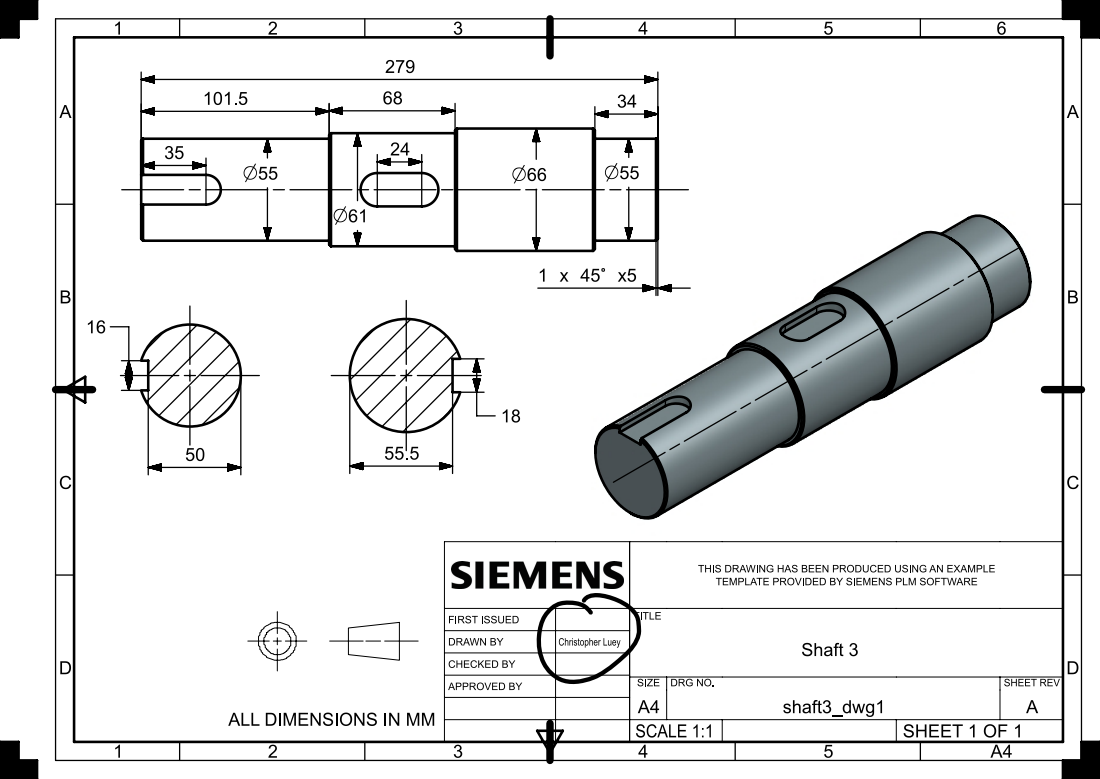
[picture p183: page 3]

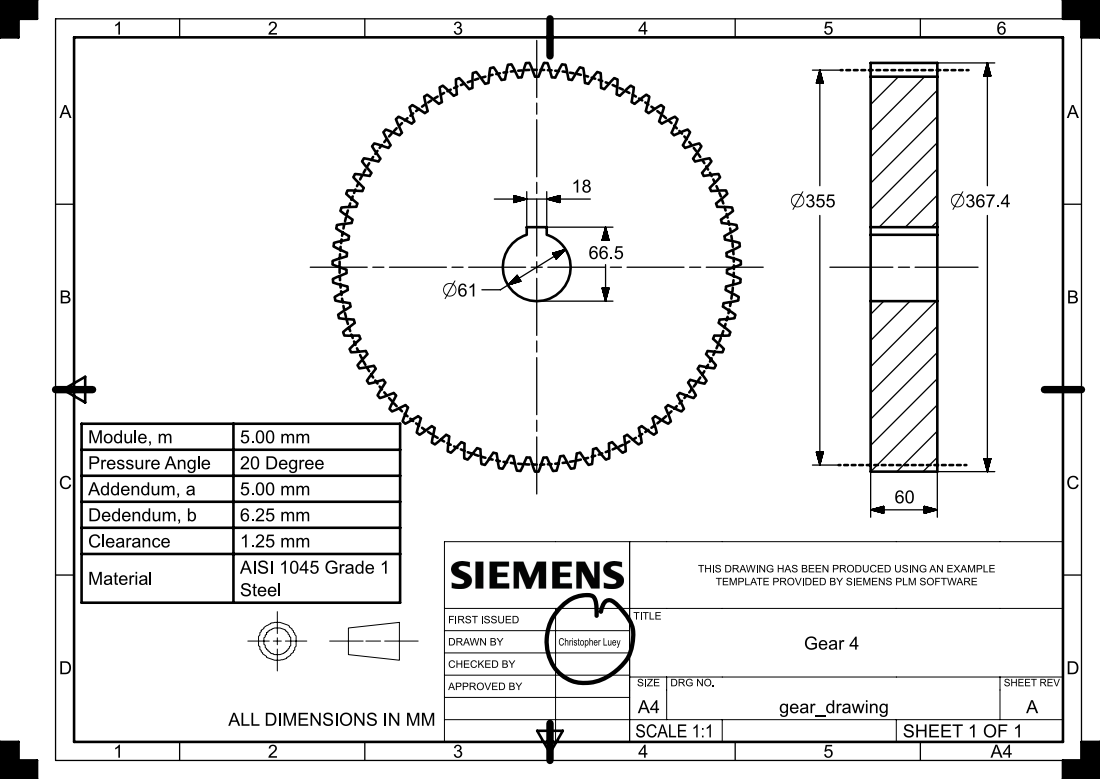
[picture p184: page 4]

# MORE WRK

# INPROGRESS

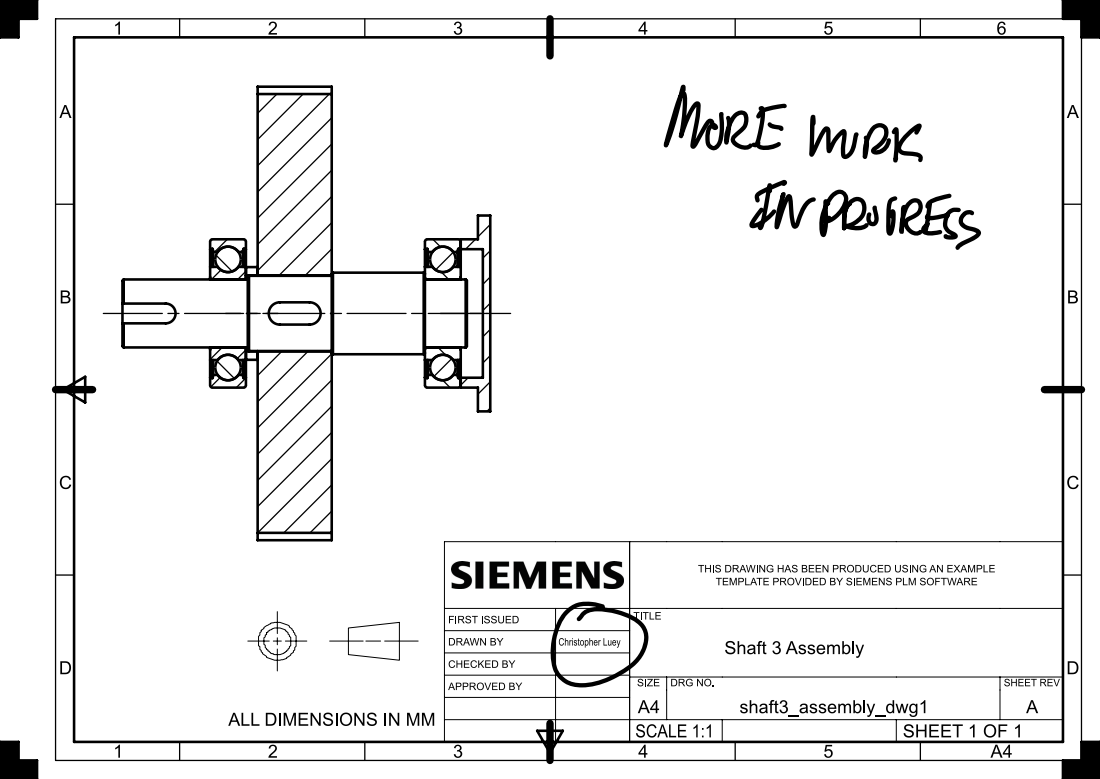
[picture p185: page 5]

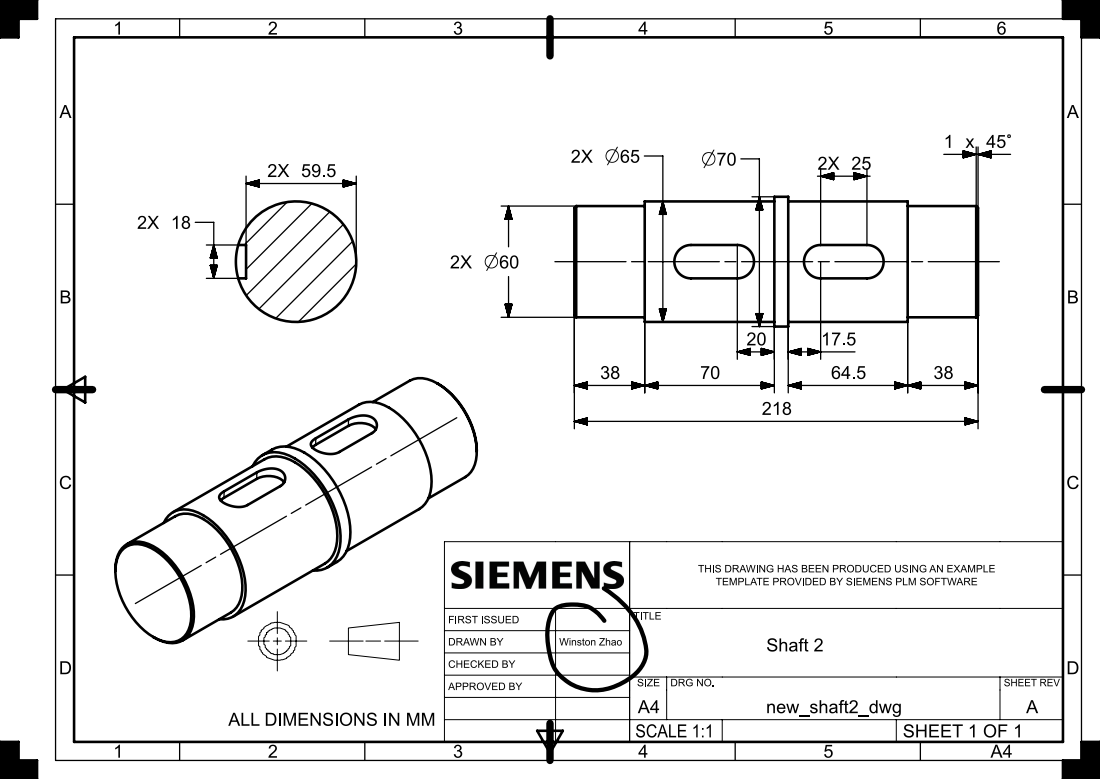
[picture p186: page 6]

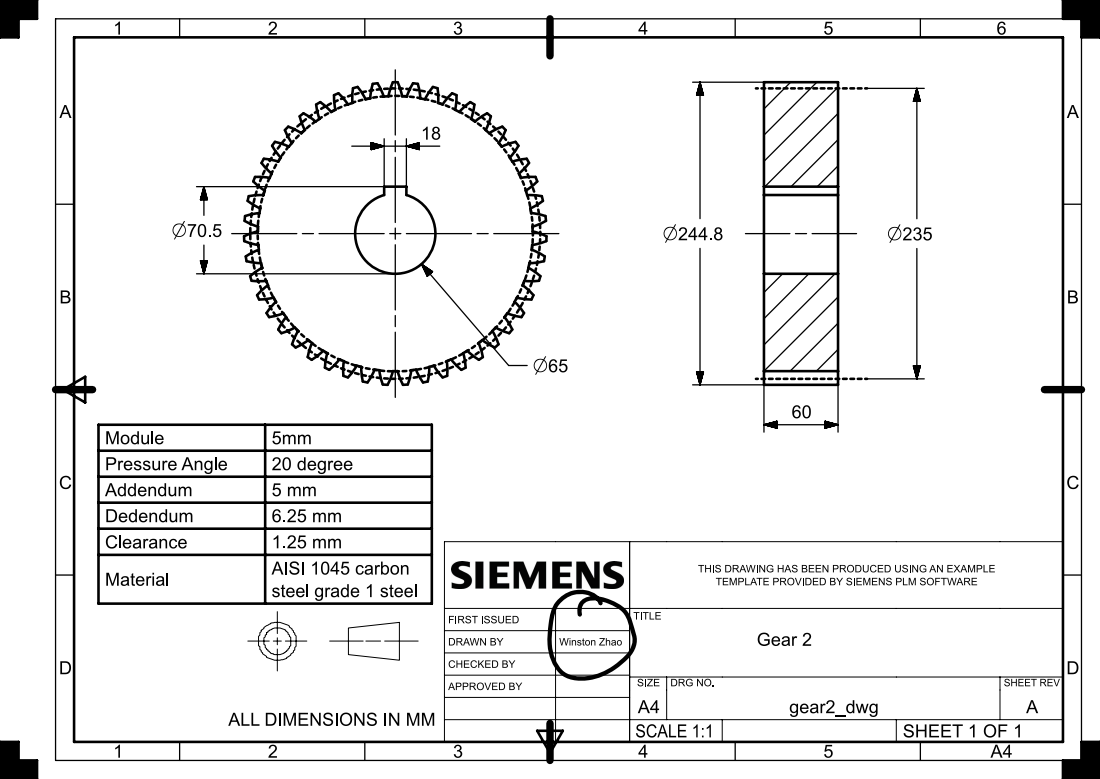
[picture p187: page 7]

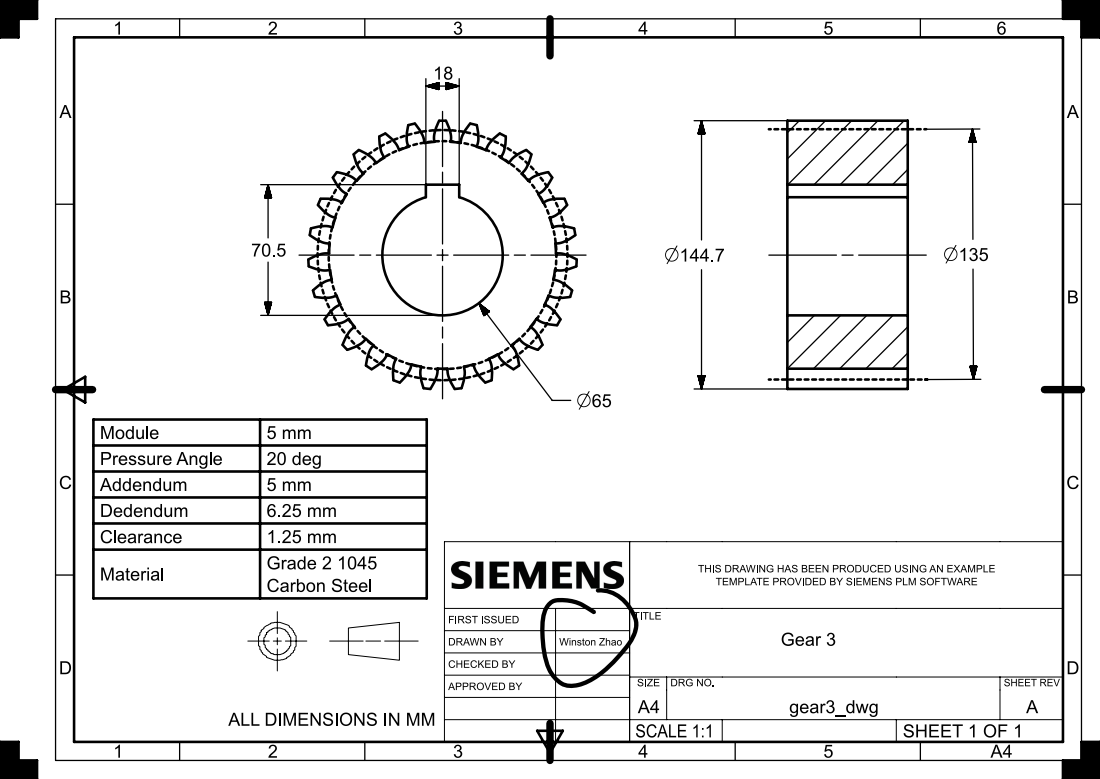
[picture p188: page 8]

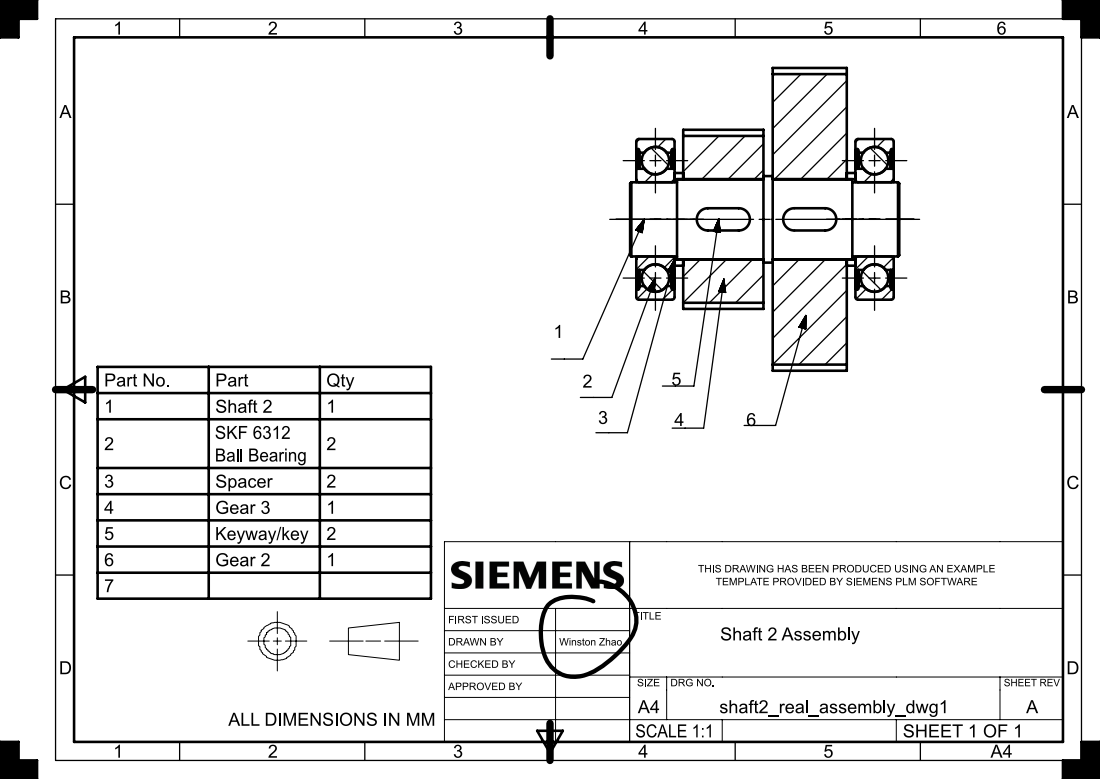
[picture p189: page 9]

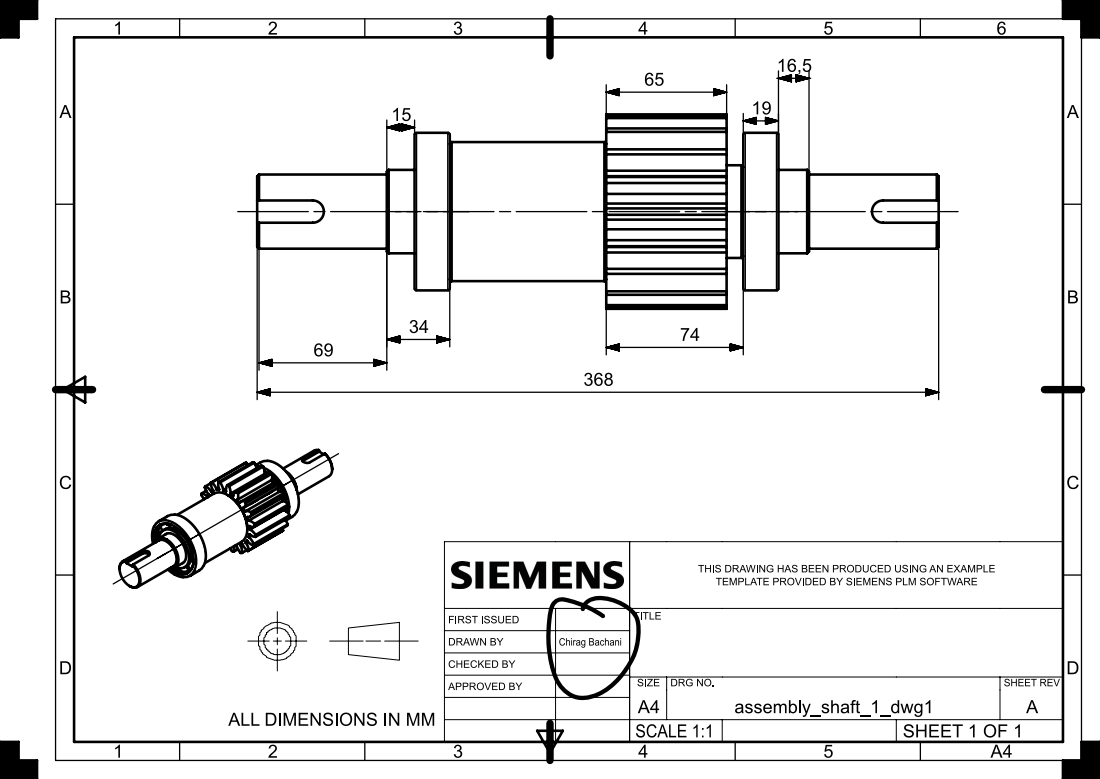
[picture p190: page 10]

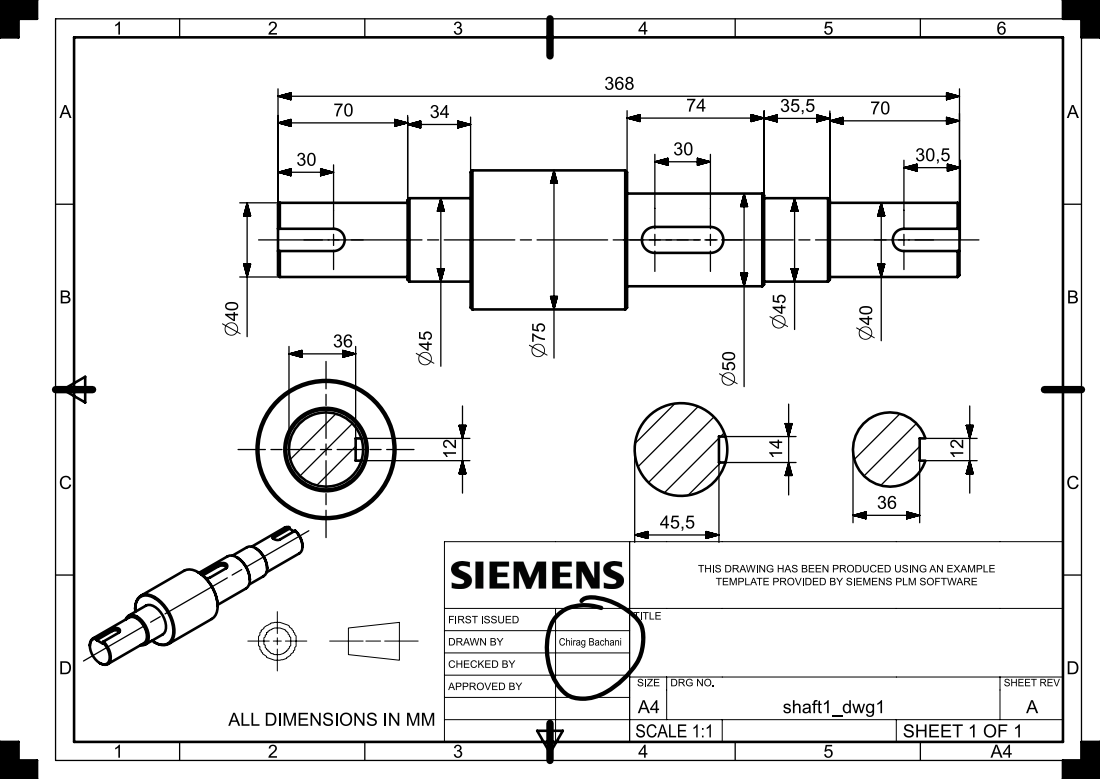
[picture p191: page 11]

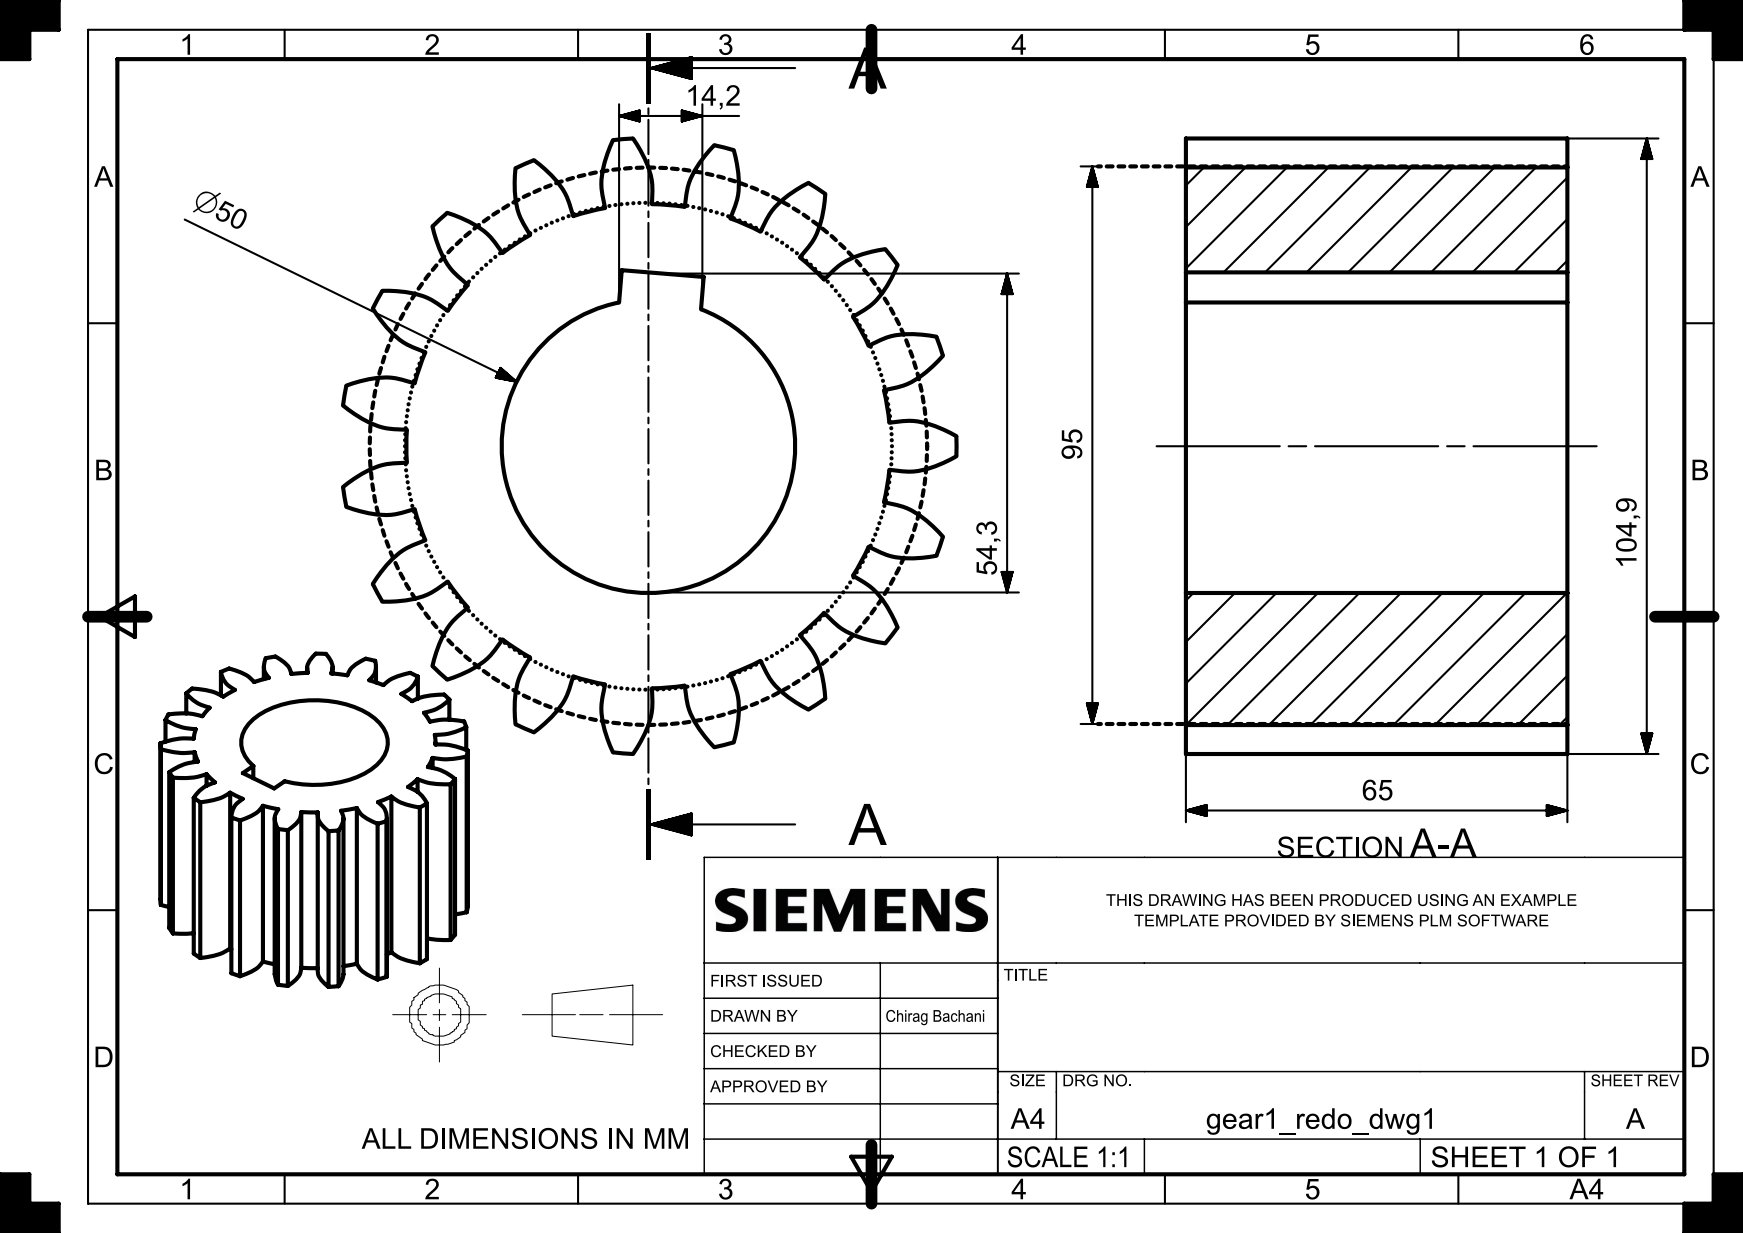
[picture p192: page 12]
