ChristopherLuey/315-MechanicalDesign/315 Project/CAD/CAD Shaft 3/cal0232_shaft3_assembly_dwg1.pdf

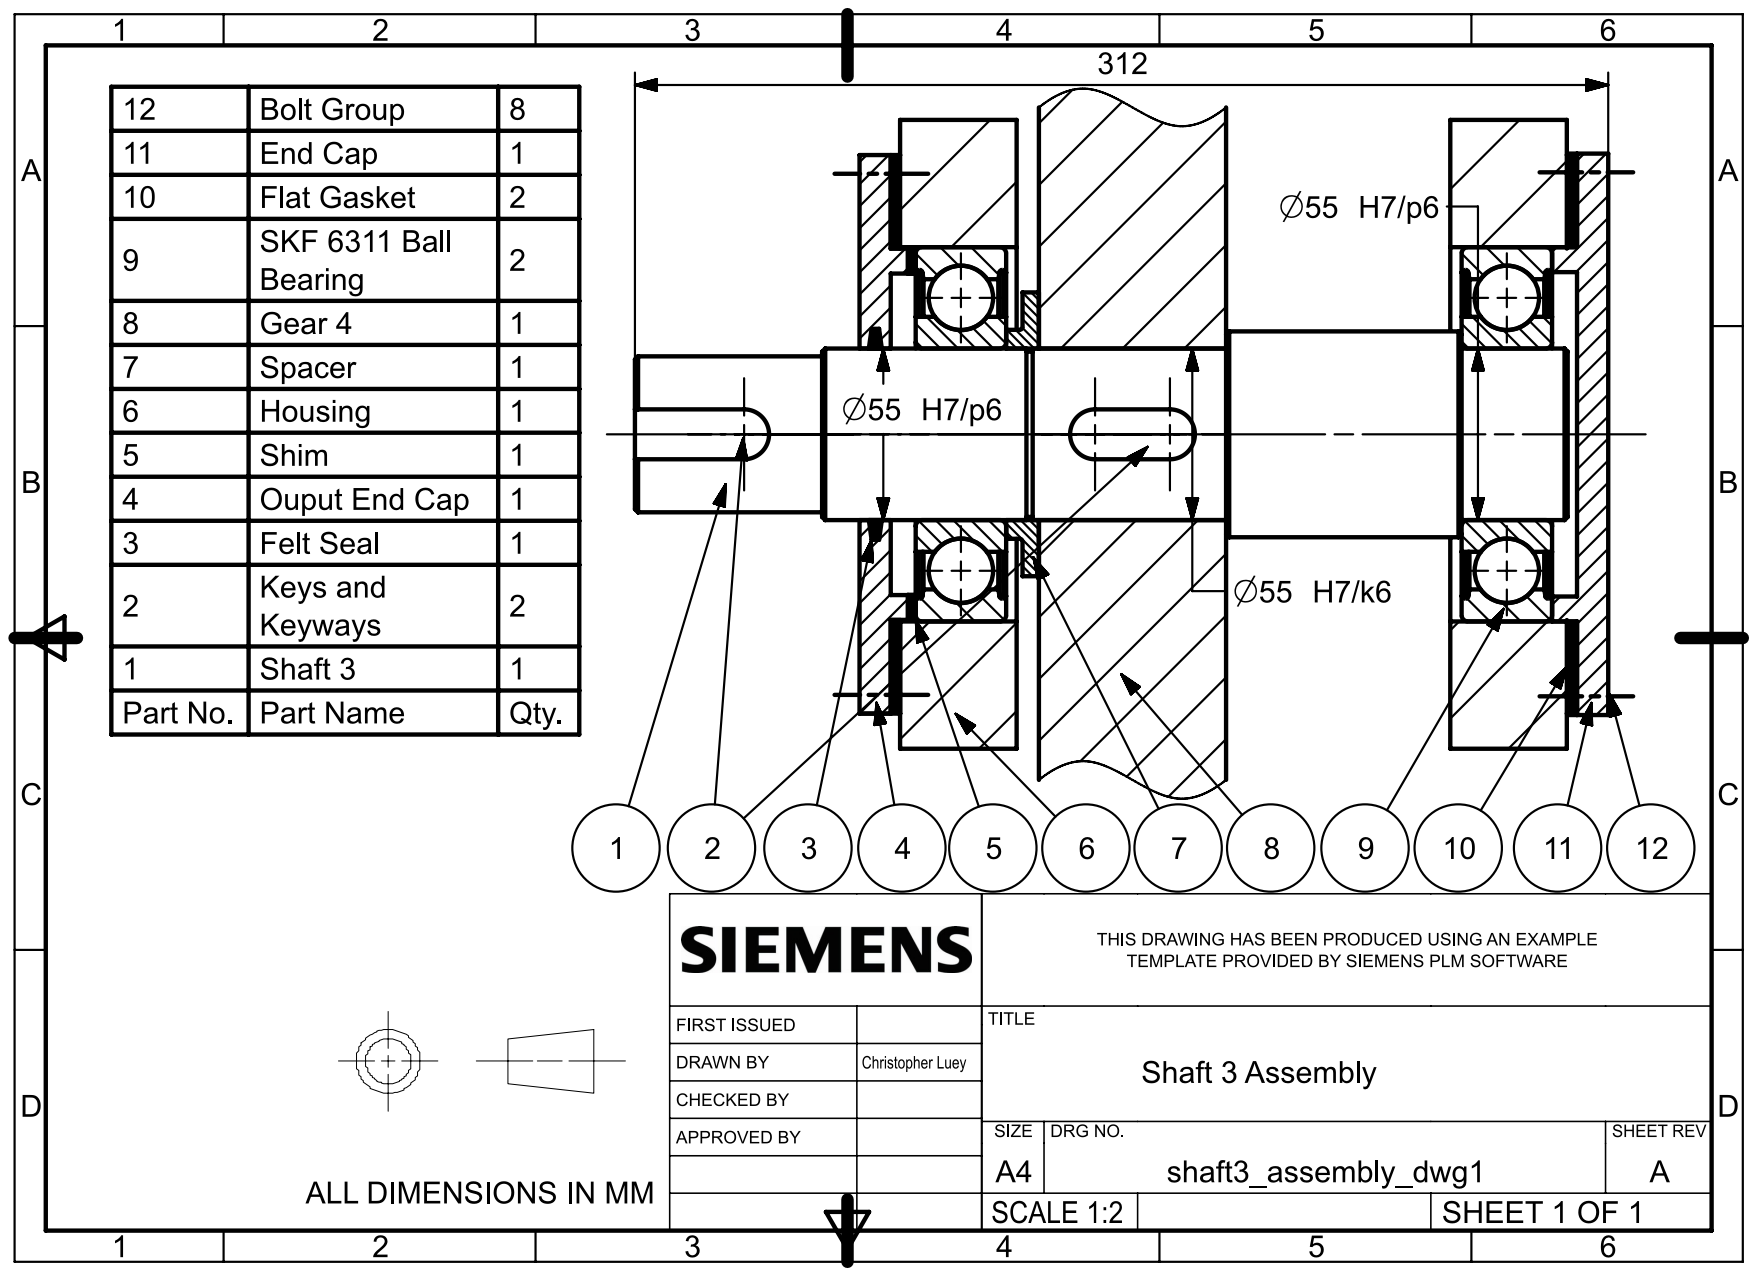
[picture p193: page 1]
