ChristopherLuey/315-MechanicalDesign/315 Project/CAD/CAD Shaft 1/ignore/Drawing PDFs/cbl2512_shaft1_assembly_v2_dwg2.pdf

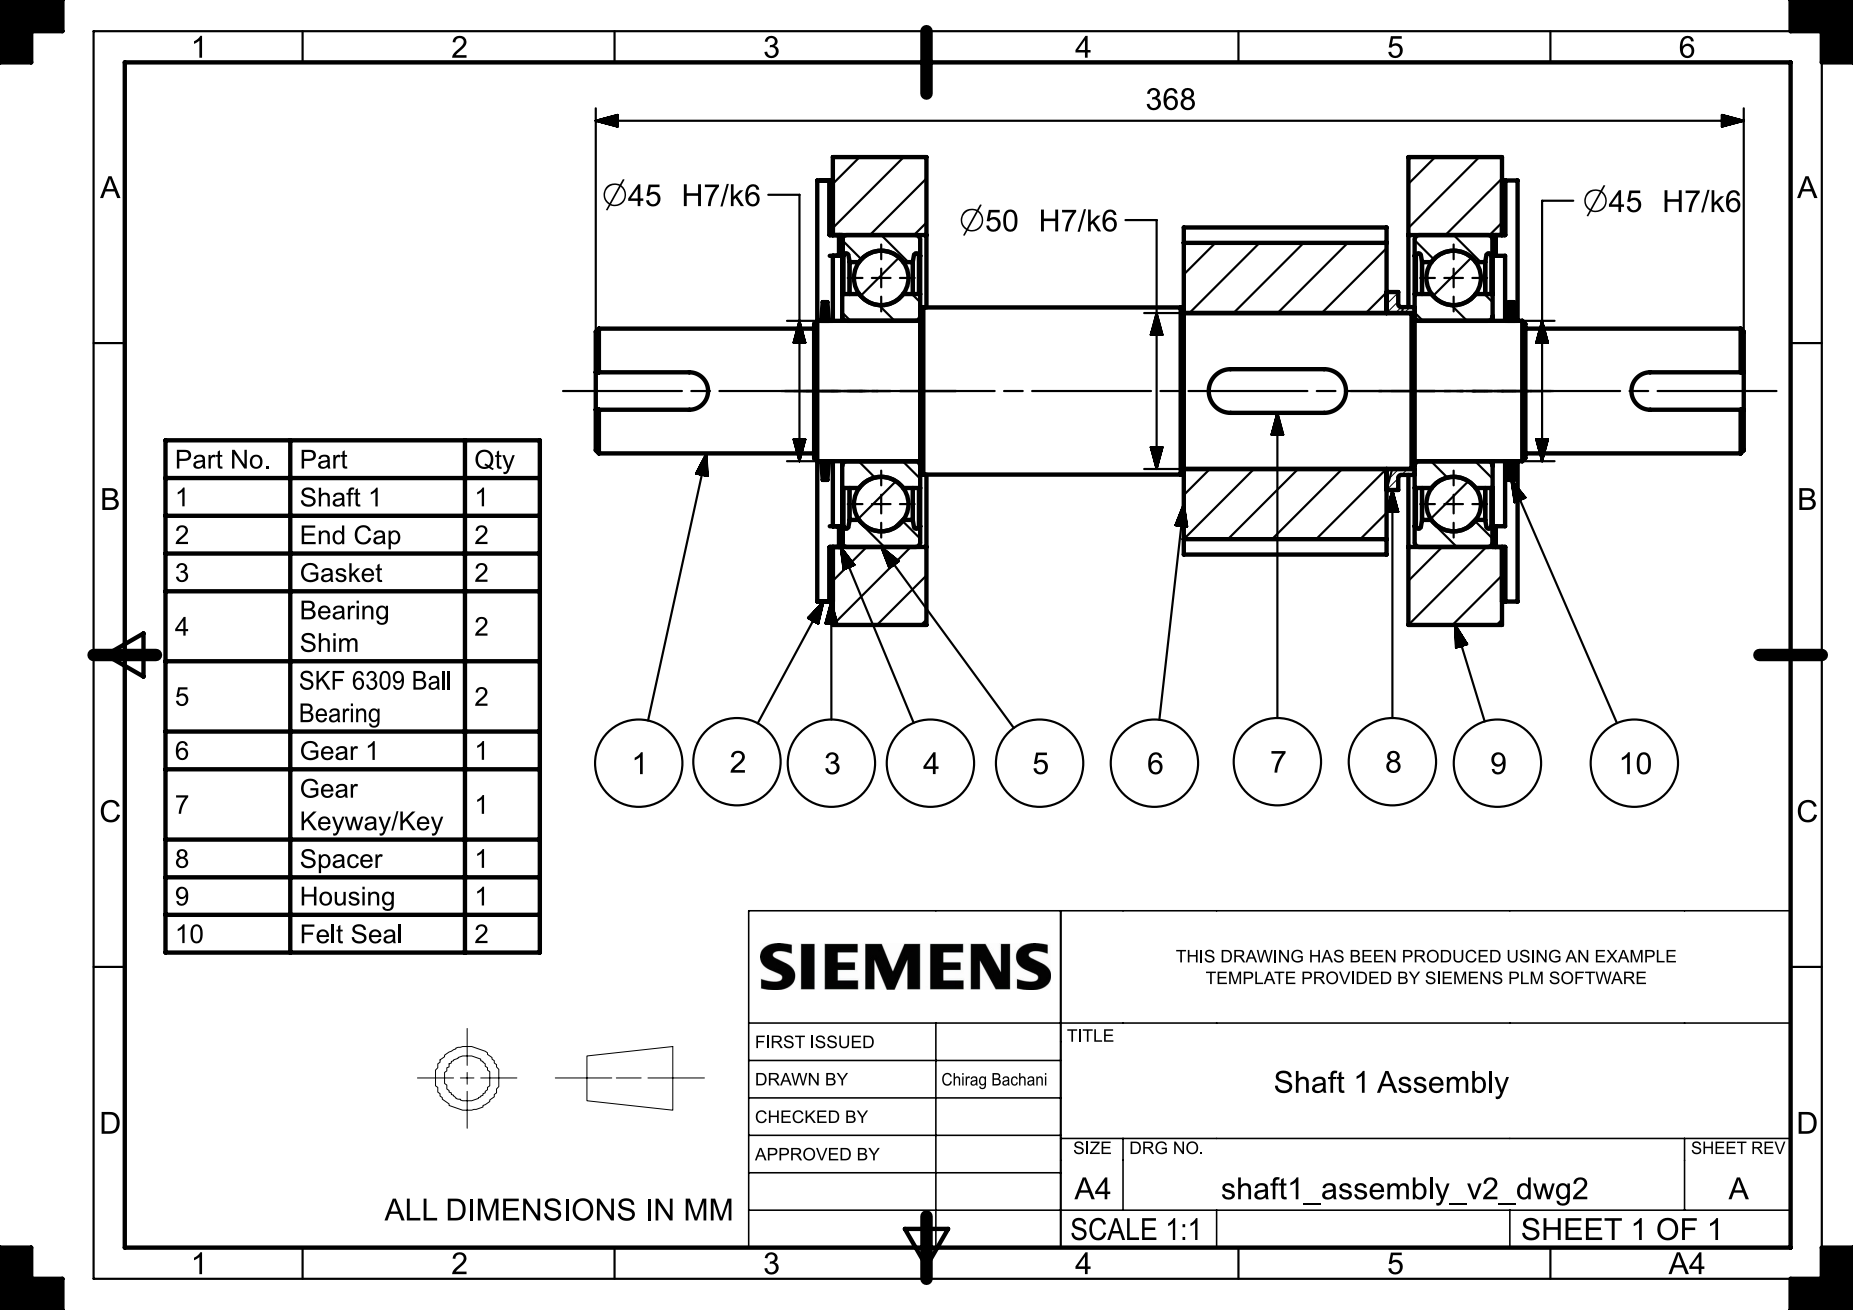
[picture p195: page 1]
