ChristopherLuey/315-MechanicalDesign/315 Project/CAD/CAD Shaft 1/ignore/Shaft 1 Final Full Assembly (all parts)/shaft1_step2.pdf

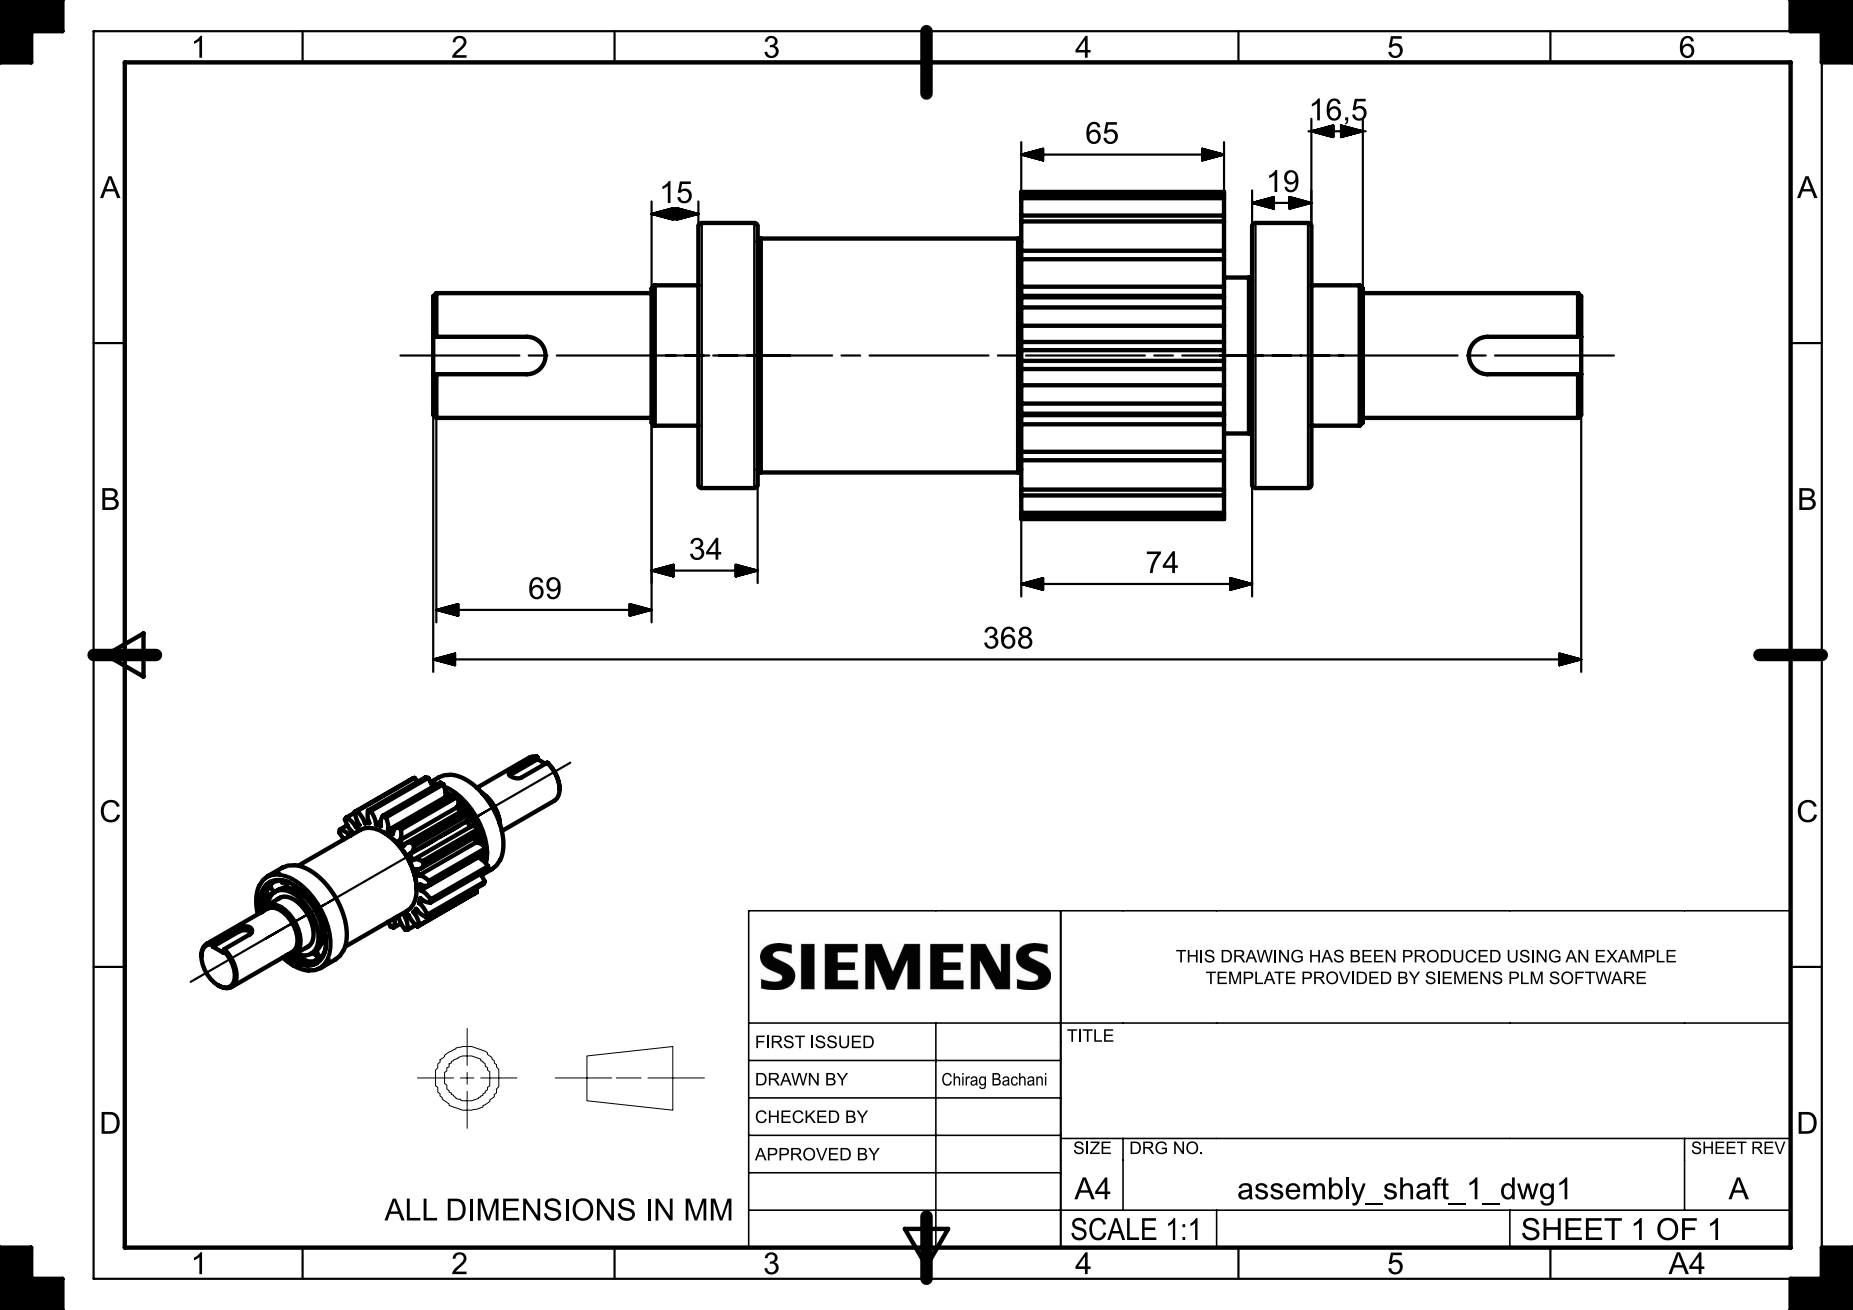
[picture p196: page 1]

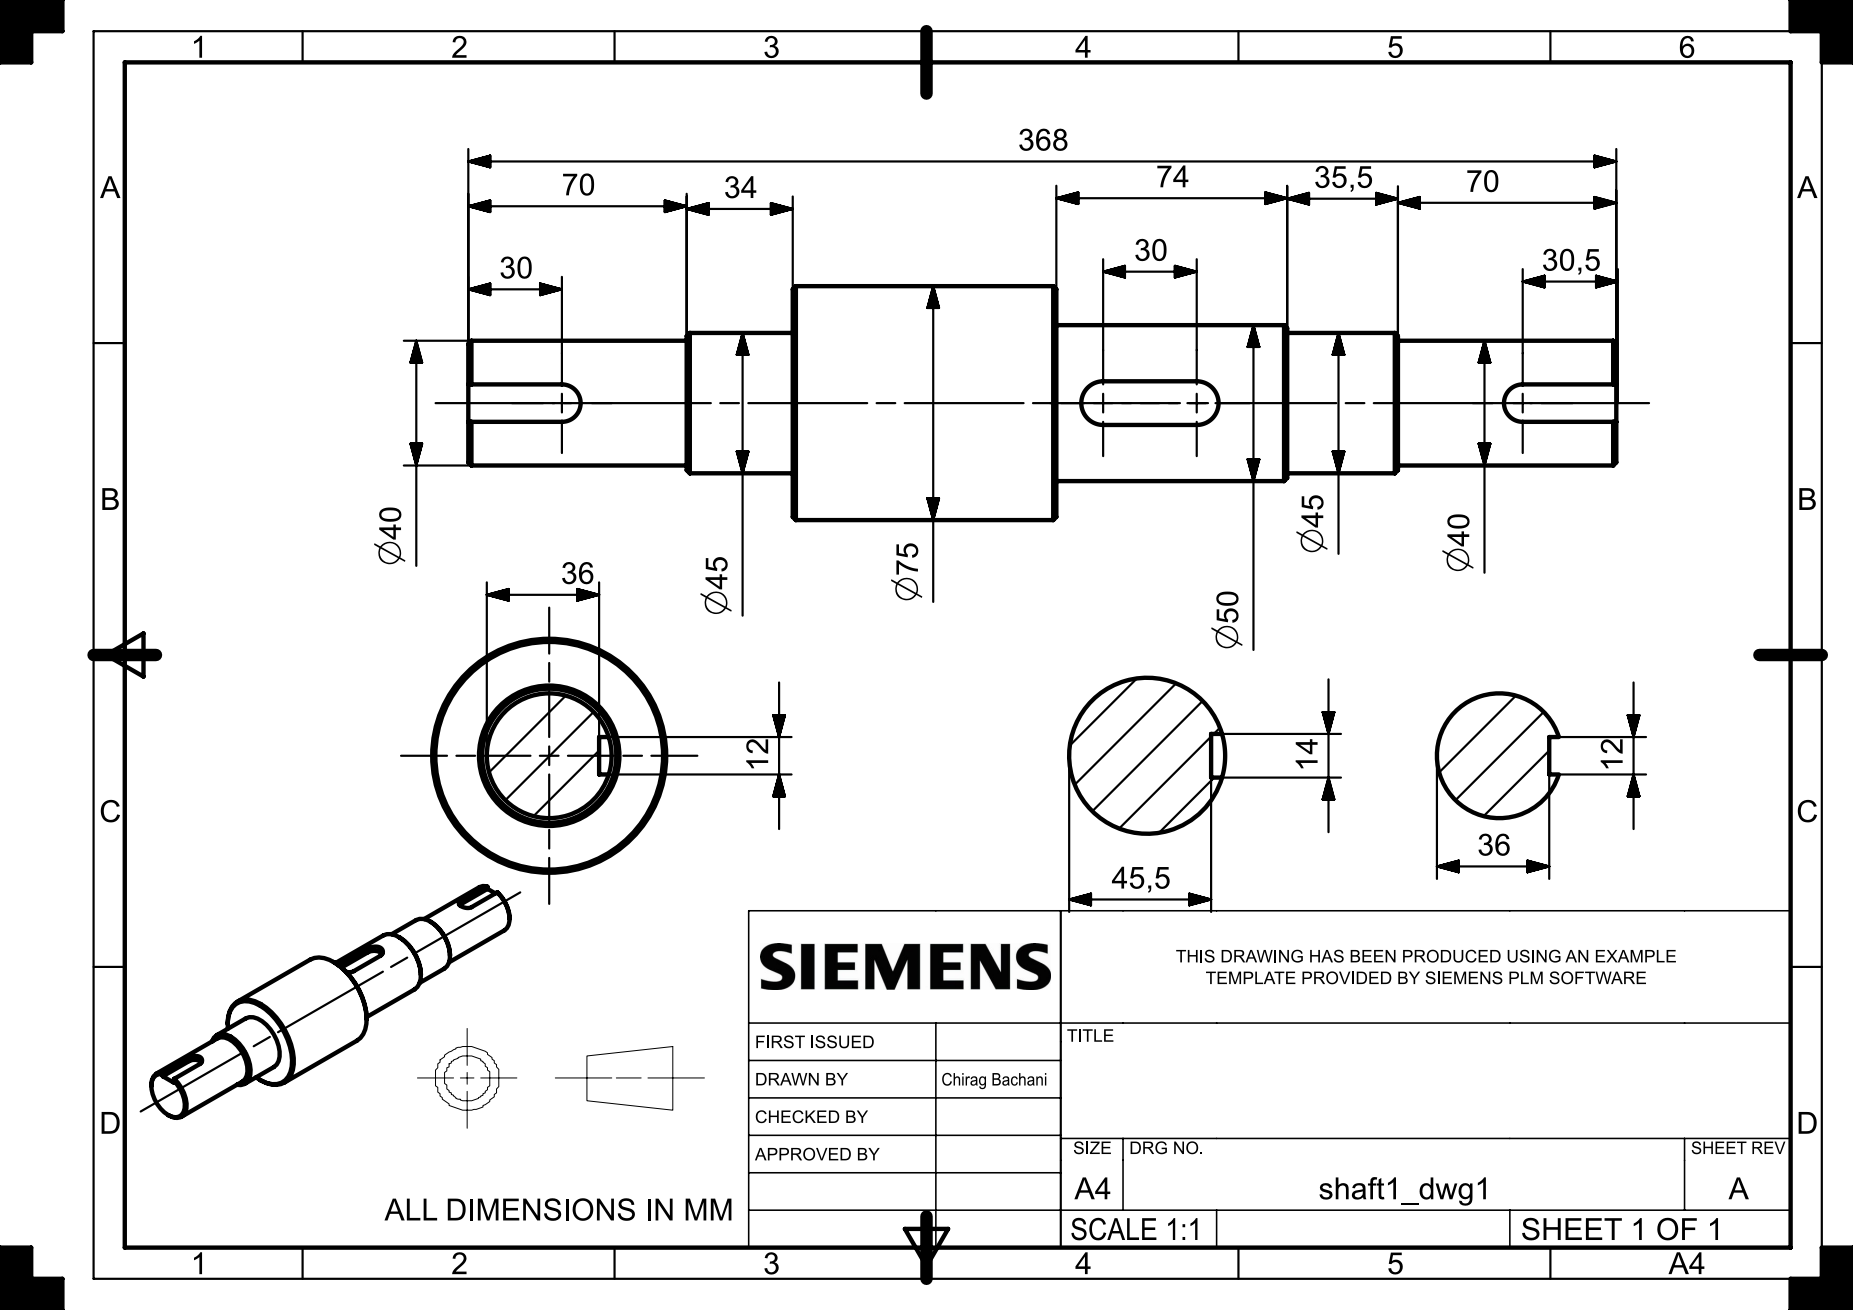
[picture p197: page 2]

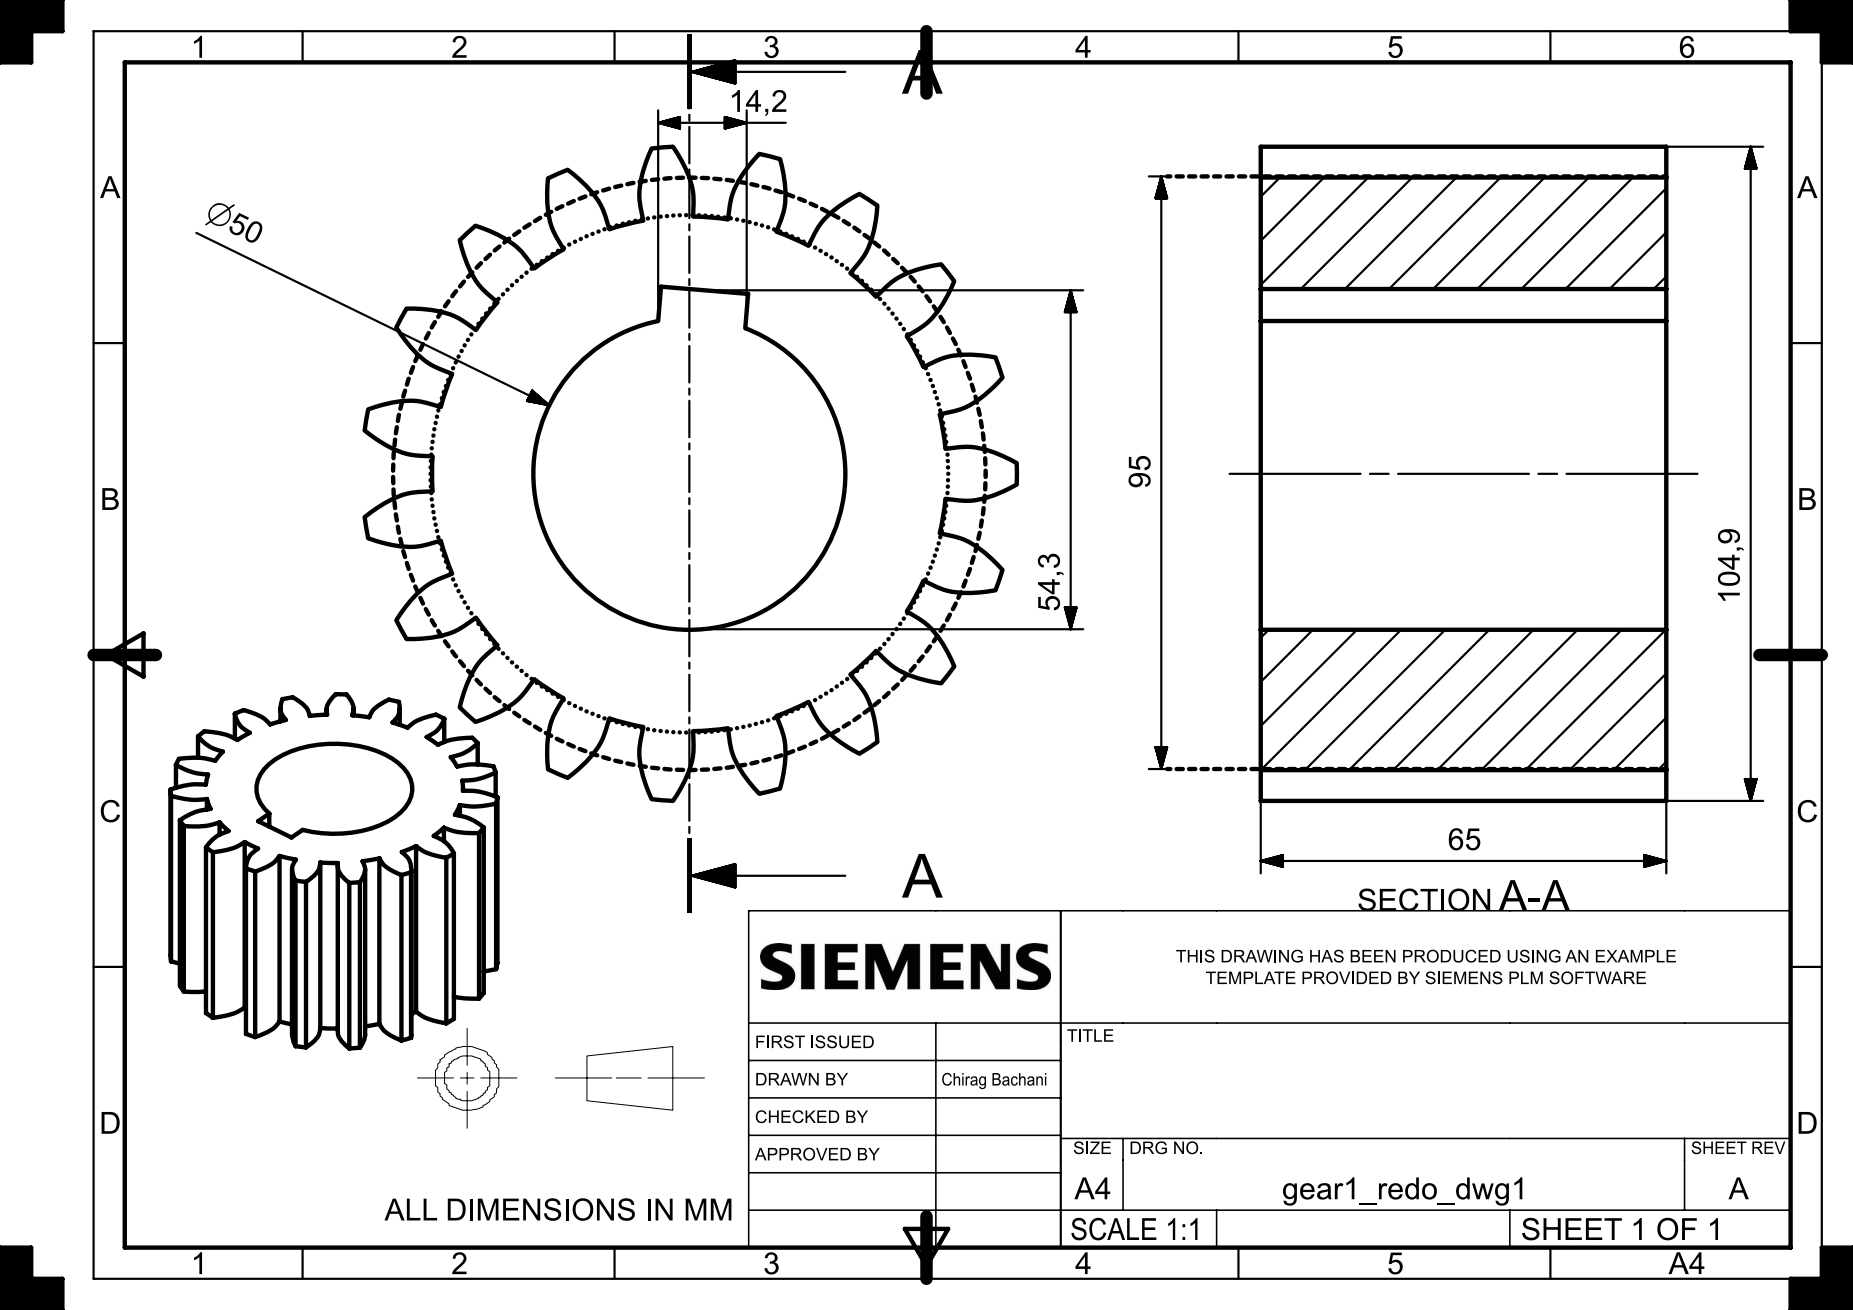
[picture p198: page 3]
