ChristopherLuey/315-MechanicalDesign/315 Project/CAD/CAD Shaft 1/ignore/Shaft 1 Final Full Assembly (all parts)/Gear (correct)/cbl2512_gear1_v3_dwg1.pdf

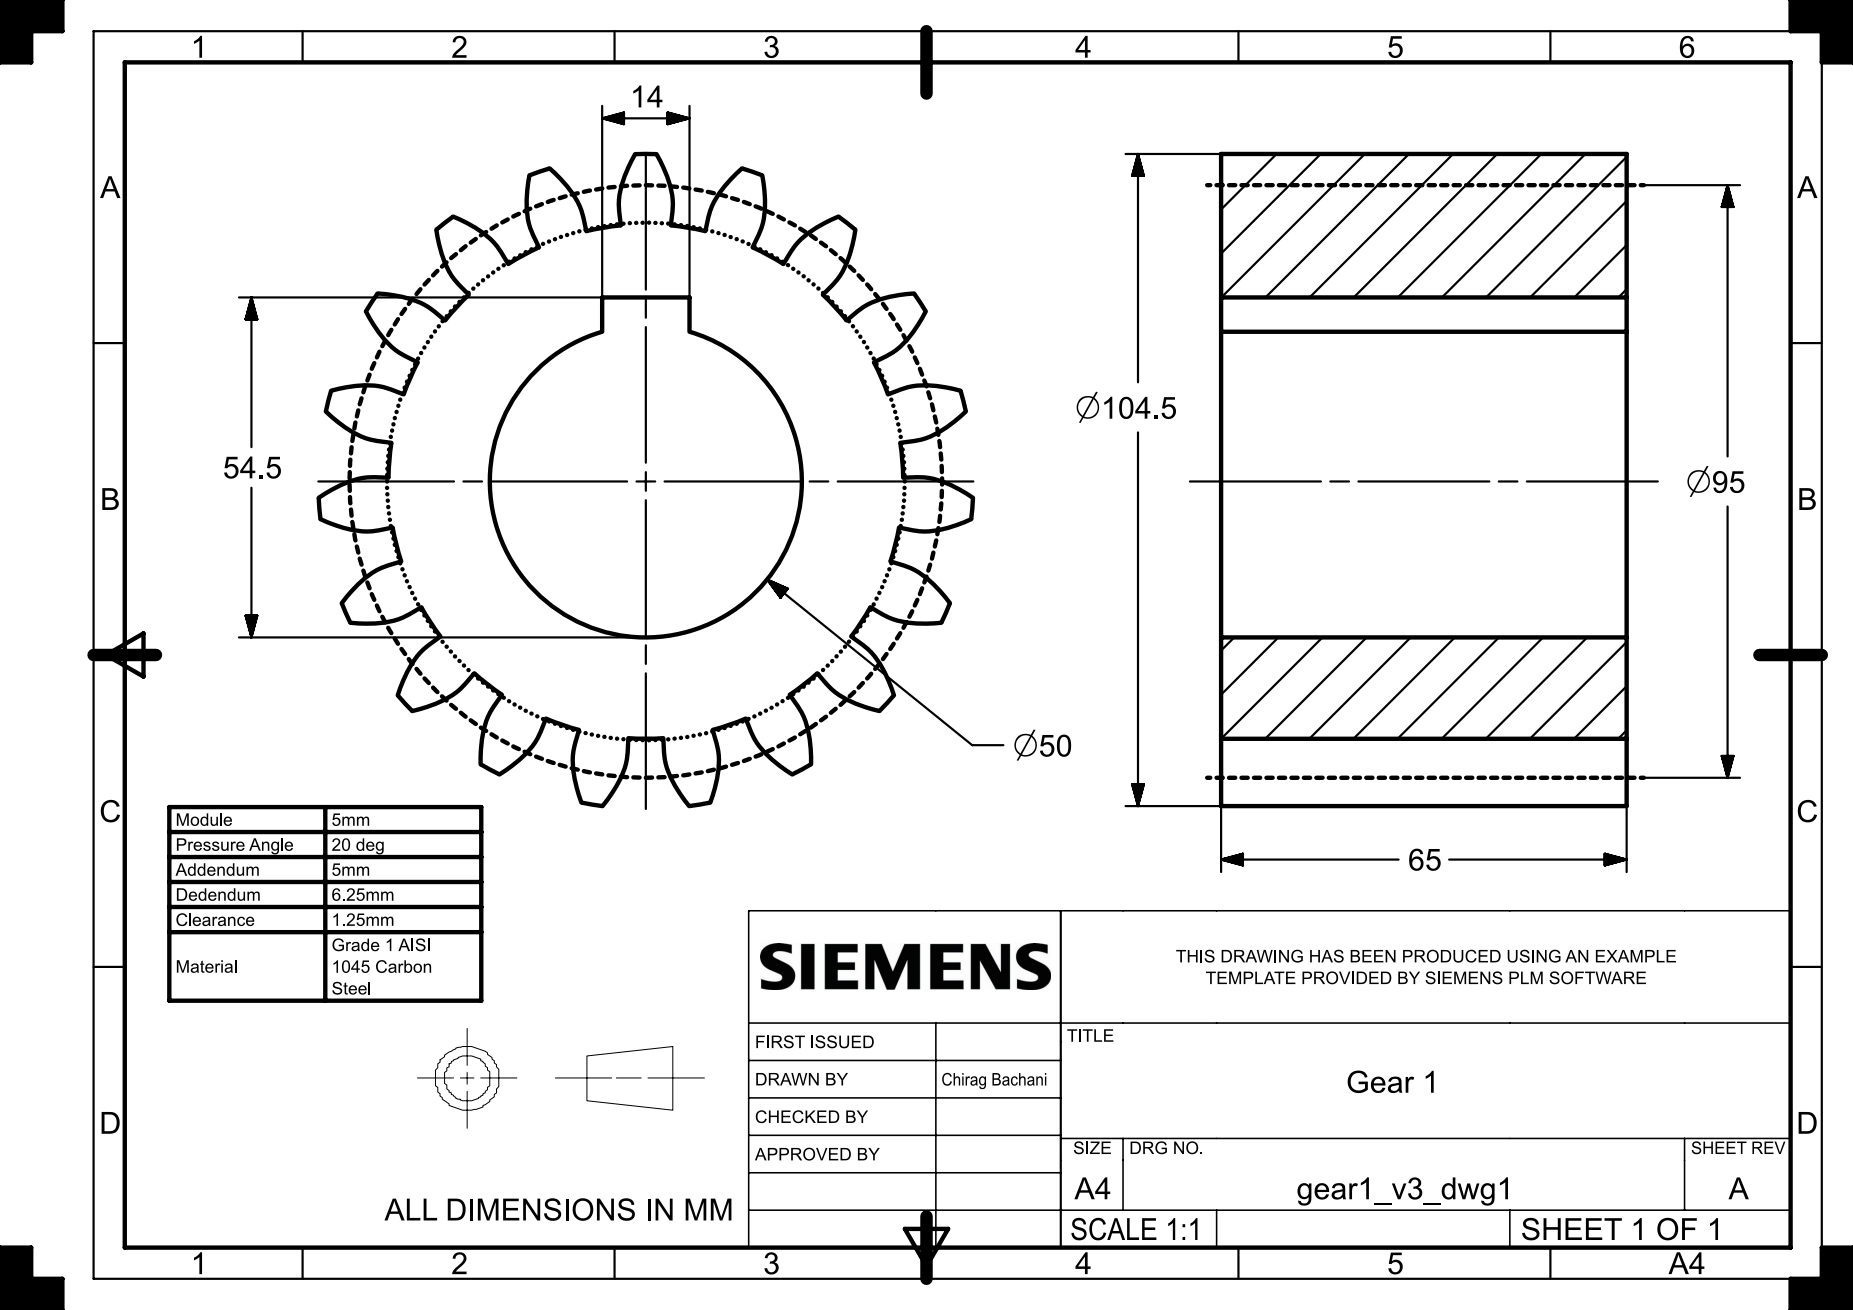
[picture p199: page 1]
