ChristopherLuey/315-MechanicalDesign/315 Corrections.pdf

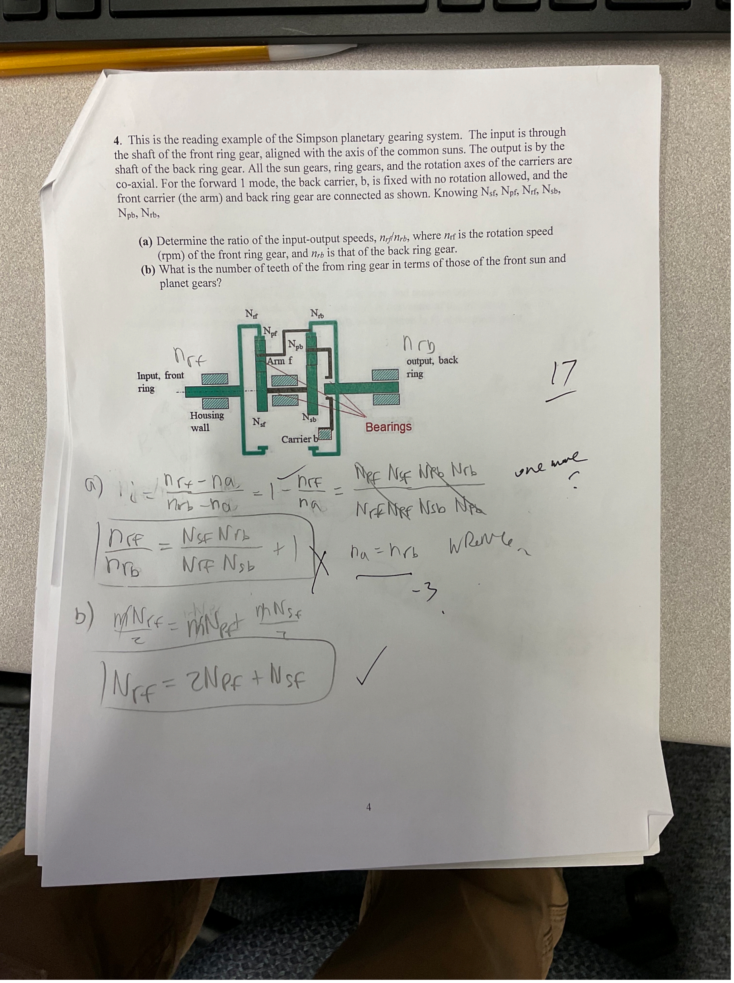
[picture p200: page 1]

## NSF ARB

## PRE Na

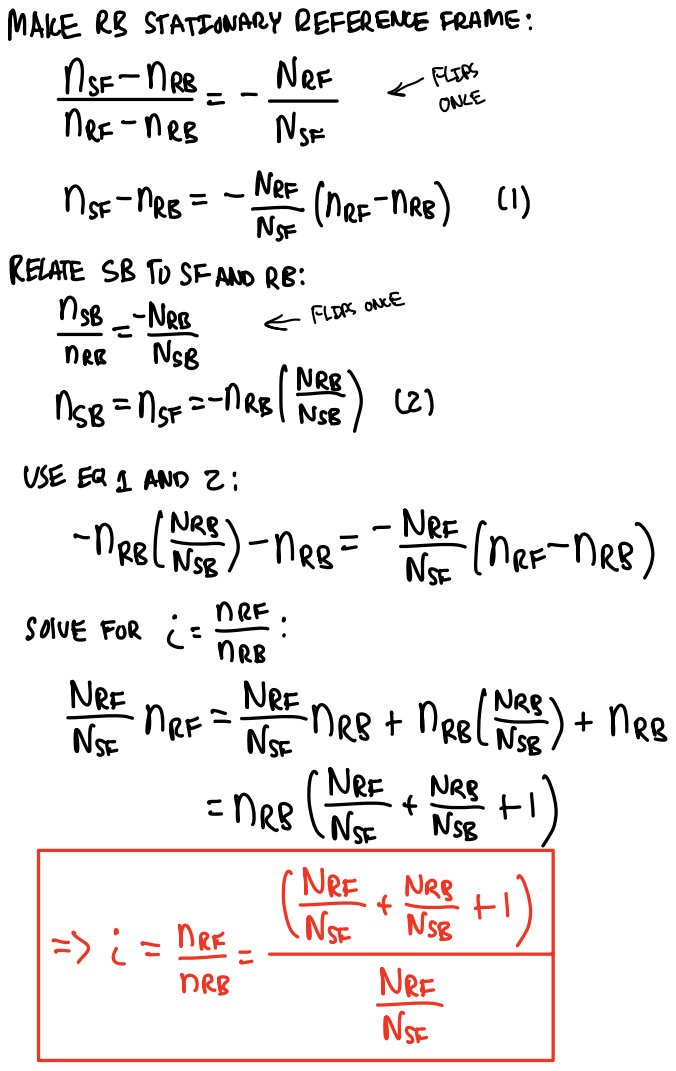
[picture p201: page 2]
NRF; FIRE; Nst; MSF PRB; MEI ARE ARB; Nff; FLIRonce; NSB NSF ARB NYT; solve For; this

MAKE RB STATIONARYREFERENCEFRAME

RELATE SBTOSFAND RB

USEEQ 1 AND Z
DRB ITF ARE WII NRF ARB

TRIPRE TIENRB ARB EI ARB
arr TETTEH
TETTEH
